eaponce1/Proyecto3_Arquitectura_de_Computadores_Grupo_1/docs/informe_proyecto3/figuras/etapa5_pinout_util50.pdf

# Terminales del macro ASIC — ROM+RAM, FP_CORE_UTIL=50

Coordenadas extraídas de 25-openroad-ioplacement/asic_top.def; origen físico abajo a la izquierda.

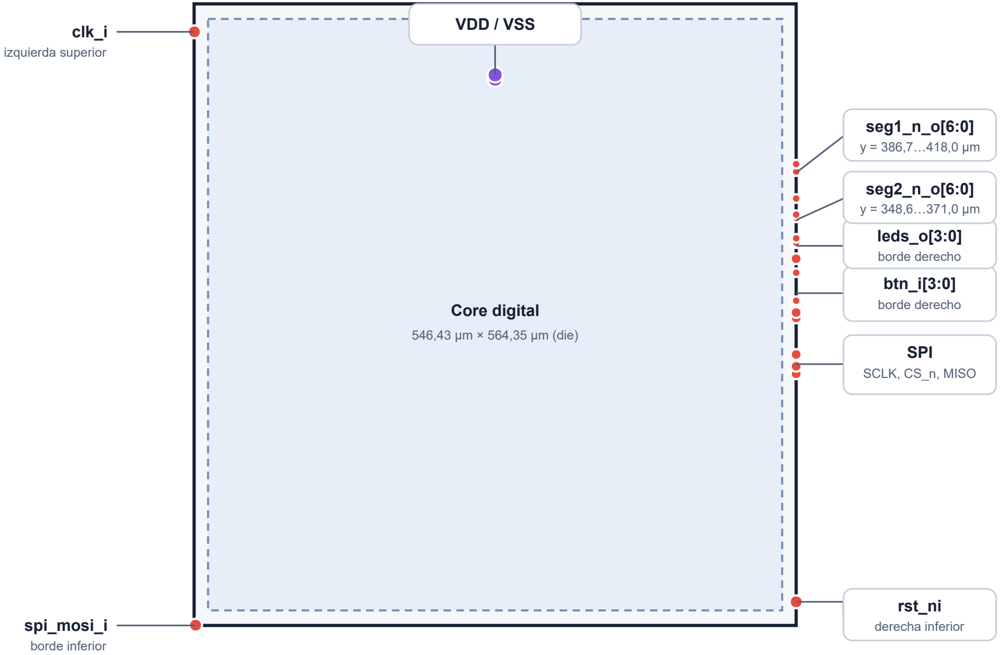
[picture p1: figure]
Core digital; 546,43 µm × 564,35 µm (die); clk_i; izquierda superior; spi_mosi_i; borde inferior; rst_ni; derecha inferior; SPI; SCLK, CS_n, MISO; btn_i[3:0]; borde derecho; leds_o[3:0]; seg2_n_o[6:0]; seg1_n_o[6:0]; VDD / VSS

Los grupos indican rangos reales del DEF; los segmentos individuales están muy próximos y se resumen para legibilidad.
