eaponce1/Proyecto3_Arquitectura_de_Computadores_Grupo_1/docs/informe_proyecto3/figuras/etapa6_layout_trazabilidad.pdf

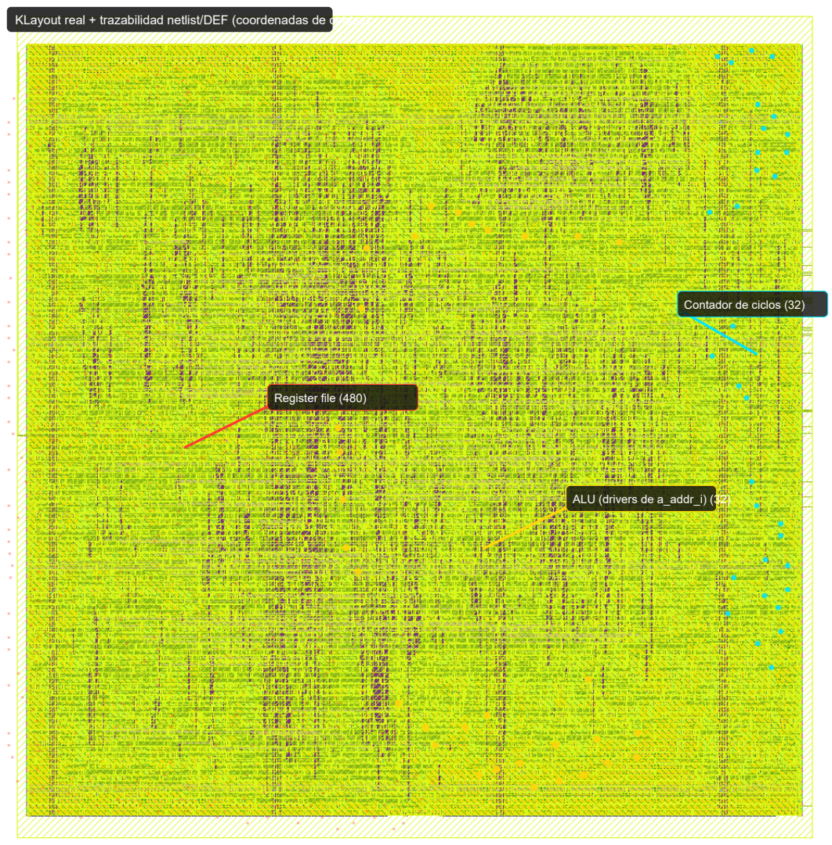
[picture p2: page 1]
Register file (480)

KLayout real + trazabilidad netlist/DEF (coordenadas de celdas)

Contador de ciclos (32)

ALU (drivers de a_addr_i) (32)
