eaponce1/Proyecto3_Arquitectura_de_Computadores_Grupo_1/reports/stage16/slew_by_net.csv

net | violations | corners | worst_slew_ns | limit_ns | worst_slack_ns | pins | cells | drivers | classification
eco_buffer_48_net | 4 | max_ss_125C_4v50,nom_ss_125C_4v50 | 3.435396 | 3.0 | -0.435396 | _7165_/ZN,eco_buffer_48/I | gf180mcu_fd_sc_mcu7t5v0__aoi221_1,gf180mcu_fd_sc_mcu7t5v0__buf_4 | _7165_/ZN (gf180mcu_fd_sc_mcu7t5v0__aoi221_1) | instruction/ROM
