eaponce1/Proyecto3_Arquitectura_de_Computadores_Grupo_1/reports/stage13/etapa13_rom_ram_cts_retry/corners.csv

corner | setup_ws_ns | setup_wns_ns | setup_tns_ns | hold_ws_ns | hold_wns_ns | hold_tns_ns | slew_report_count | slew_metric_count | slew_worst_value | slew_worst_slack | fanout_report_count | fanout_metric_count | fanout_worst_value | fanout_worst_slack | capacitance_report_count | capacitance_metric_count | capacitance_worst_value | capacitance_worst_slack
max_ff_n40C_5v50 | 74.98970190399923 | 0 | 0 | 0.010418333157733054 | 0 | 0 | 0 | 0 |  | 0 | 0 | 0 |  | 0 | 1 | 1 | 0.201071 | -0.001071
max_ss_125C_4v50 | 52.43060534134973 | 0 | 0 | 0.6534697412591861 | 0 | 0 | 468 | 468 | 5.536282 | -2.536282 | 0 | 0 |  | 0 | 1 | 1 | 0.20108 | -0.00108
max_tt_025C_5v00 | 72.35749626493208 | 0 | 0 | 0.20193269850038842 | 0 | 0 | 21 | 21 | 3.263622 | -0.263622 | 0 | 0 |  | 0 | 1 | 1 | 0.200954 | -0.000954
min_ff_n40C_5v50 | 75.16033874681796 | 0 | 0 | 0.029191538901272192 | 0 | 0 | 0 | 0 |  | 0 | 0 | 0 |  | 0 | 0 | 0 |  | 0
min_ss_125C_4v50 | 56.26053027139736 | 0 | 0 | 0.6558016537660598 | 0 | 0 | 165 | 165 | 4.514771 | -1.514771 | 0 | 0 |  | 0 | 0 | 0 |  | 0
min_tt_025C_5v00 | 72.61167872498432 | 0 | 0 | 0.21586222309510425 | 0 | 0 | 0 | 0 |  | 0 | 0 | 0 |  | 0 | 0 | 0 |  | 0
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
