eaponce1/Proyecto3_Arquitectura_de_Computadores_Grupo_1/reports/stage25/unified_ff_frequency_sweep.csv

period_ns | frequency_mhz | setup_wns_ns | setup_tns_ns | hold_wns_ns | hold_tns_ns | status | area_stdcell_um2 | die_area_um2 | utilization_pct | slew_violations | cap_violations | fanout_violations | run_tag | notes
100 | 10.000 | 23.7474047148 | 0 | 0.1717245283 | 0 | pass | 730205 |  | 51.6617 | 9734 | 949 | 350 | etapa4_unified_ff_100ns_100 | historical completed run
80 | 12.500 | 16.789962 | 0 | 0.139166 | 0 | pass | 724673 | 1468100 | 51.3187 | 10758 | 730 | 355 | etapa25_unified_ff_80ns | post-route STA nine corners
70 | 14.285714 | 6.789961 | 0 | 0.139166 | 0 | pass | 724673 | 1468100 | 51.3187 | 10758 | 730 | 355 | etapa25_unified_ff_70ns | post-route STA nine corners
65 | 15.384615 | 1.789957 | 0 | 0.139166 | 0 | pass | 724673 | 1468100 | 51.3187 | 10758 | 730 | 355 | etapa25_unified_ff_65ns | post-route STA nine corners
64 | 15.625 | 0.789960 | 0 | 0.139166 | 0 | pass | 724673 | 1468100 | 51.3187 | 10758 | 730 | 355 | etapa25_unified_ff_64ns | smallest demonstrated passing period in sweep
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
