eaponce1/Proyecto3_Arquitectura_de_Computadores_Grupo_1/reports/stage10/electrical_partitioned.csv

type | net | count | worst_value | limit | worst_slack | drivers | classification | sample_pin | roots
slew | net397 | 12 | 6.058903 | 3.0 | -3.058903 | fanout397/Z:gf180mcu_fd_sc_mcu7t5v0__dlyb_1 | instruction/ROM/fetch | _5614_/A2 | \u_pochoco_soc.genblk1.g_rom_ram_memory.u_ram.a_rdata_o[15];\u_pochoco_soc.genblk1.g_rom_ram_memory.u_ram.a_rdata_o[16];\u_pochoco_soc.genblk1.g_rom_ram_memory.u_ram.a_rdata_o[17];\u_pochoco_soc.genblk1.g_rom_ram_memory.u_ram.a_rdata_o[18]
slew | net426 | 11 | 6.298467 | 3.0 | -3.298467 | fanout426/Z:gf180mcu_fd_sc_mcu7t5v0__dlyb_1 | instruction/ROM/fetch | _5200_/B1 | \u_pochoco_soc.genblk1.g_rom_ram_memory.u_ram.a_rdata_o[20];\u_pochoco_soc.genblk1.g_rom_ram_memory.u_ram.a_rdata_o[21];\u_pochoco_soc.genblk1.g_rom_ram_memory.u_ram.a_rdata_o[22];\u_pochoco_soc.genblk1.g_rom_ram_memory.u_ram.a_rdata_o[23]
slew | net481 | 11 | 6.01881 | 3.0 | -3.01881 | fanout481/Z:gf180mcu_fd_sc_mcu7t5v0__dlyb_1 | instruction/ROM/fetch | _5546_/B1 | \u_pochoco_soc.genblk1.g_rom_ram_memory.u_ram.a_rdata_o[15];\u_pochoco_soc.genblk1.g_rom_ram_memory.u_ram.a_rdata_o[16];\u_pochoco_soc.genblk1.g_rom_ram_memory.u_ram.a_rdata_o[17];\u_pochoco_soc.genblk1.g_rom_ram_memory.u_ram.a_rdata_o[18]
slew | net401 | 11 | 5.959739 | 3.0 | -2.959739 | fanout401/Z:gf180mcu_fd_sc_mcu7t5v0__dlyb_1 | instruction/ROM/fetch | _5302_/A2 | \u_pochoco_soc.genblk1.g_rom_ram_memory.u_ram.a_rdata_o[15];\u_pochoco_soc.genblk1.g_rom_ram_memory.u_ram.a_rdata_o[16];\u_pochoco_soc.genblk1.g_rom_ram_memory.u_ram.a_rdata_o[17];\u_pochoco_soc.genblk1.g_rom_ram_memory.u_ram.a_rdata_o[18]
slew | net376 | 11 | 5.943812 | 3.0 | -2.943812 | fanout376/Z:gf180mcu_fd_sc_mcu7t5v0__dlyb_1 | instruction/ROM/fetch | _5446_/B1 | \u_pochoco_soc.genblk1.g_rom_ram_memory.u_ram.a_rdata_o[15];\u_pochoco_soc.genblk1.g_rom_ram_memory.u_ram.a_rdata_o[16];\u_pochoco_soc.genblk1.g_rom_ram_memory.u_ram.a_rdata_o[17];\u_pochoco_soc.genblk1.g_rom_ram_memory.u_ram.a_rdata_o[18]
slew | net429 | 11 | 5.890739 | 3.0 | -2.890739 | fanout429/Z:gf180mcu_fd_sc_mcu7t5v0__dlyb_1 | instruction/ROM/fetch | _5171_/C1 | \u_pochoco_soc.genblk1.g_rom_ram_memory.u_ram.a_rdata_o[20];\u_pochoco_soc.genblk1.g_rom_ram_memory.u_ram.a_rdata_o[21];\u_pochoco_soc.genblk1.g_rom_ram_memory.u_ram.a_rdata_o[22];\u_pochoco_soc.genblk1.g_rom_ram_memory.u_ram.a_rdata_o[23]
slew | net408 | 11 | 5.781785 | 3.0 | -2.781785 | fanout408/Z:gf180mcu_fd_sc_mcu7t5v0__dlyb_1 | instruction/ROM/fetch | _5168_/A2 | \u_pochoco_soc.genblk1.g_rom_ram_memory.u_ram.a_rdata_o[20];\u_pochoco_soc.genblk1.g_rom_ram_memory.u_ram.a_rdata_o[21];\u_pochoco_soc.genblk1.g_rom_ram_memory.u_ram.a_rdata_o[22];\u_pochoco_soc.genblk1.g_rom_ram_memory.u_ram.a_rdata_o[23]
slew | net493 | 11 | 5.773583 | 3.0 | -2.773583 | fanout493/Z:gf180mcu_fd_sc_mcu7t5v0__dlyb_1 | instruction/ROM/fetch | _5172_/A2 | \u_pochoco_soc.genblk1.g_rom_ram_memory.u_ram.a_rdata_o[20];\u_pochoco_soc.genblk1.g_rom_ram_memory.u_ram.a_rdata_o[21];\u_pochoco_soc.genblk1.g_rom_ram_memory.u_ram.a_rdata_o[22];\u_pochoco_soc.genblk1.g_rom_ram_memory.u_ram.a_rdata_o[23]
slew | net498 | 11 | 5.737949 | 3.0 | -2.737949 | fanout498/Z:gf180mcu_fd_sc_mcu7t5v0__dlyb_1 | instruction/ROM/fetch | _4929_/B1 | \u_pochoco_soc.genblk1.g_rom_ram_memory.u_ram.a_rdata_o[20];\u_pochoco_soc.genblk1.g_rom_ram_memory.u_ram.a_rdata_o[21];\u_pochoco_soc.genblk1.g_rom_ram_memory.u_ram.a_rdata_o[22];\u_pochoco_soc.genblk1.g_rom_ram_memory.u_ram.a_rdata_o[23]
slew | net389 | 11 | 5.654555 | 3.0 | -2.654555 | fanout389/Z:gf180mcu_fd_sc_mcu7t5v0__dlyb_1 | instruction/ROM/fetch | _5623_/A2 | \u_pochoco_soc.genblk1.g_rom_ram_memory.u_ram.a_rdata_o[15];\u_pochoco_soc.genblk1.g_rom_ram_memory.u_ram.a_rdata_o[16];\u_pochoco_soc.genblk1.g_rom_ram_memory.u_ram.a_rdata_o[17];\u_pochoco_soc.genblk1.g_rom_ram_memory.u_ram.a_rdata_o[18]
slew | net392 | 11 | 5.641059 | 3.0 | -2.641059 | fanout392/Z:gf180mcu_fd_sc_mcu7t5v0__dlyb_1 | instruction/ROM/fetch | _5549_/A2 | \u_pochoco_soc.genblk1.g_rom_ram_memory.u_ram.a_rdata_o[15];\u_pochoco_soc.genblk1.g_rom_ram_memory.u_ram.a_rdata_o[16];\u_pochoco_soc.genblk1.g_rom_ram_memory.u_ram.a_rdata_o[17];\u_pochoco_soc.genblk1.g_rom_ram_memory.u_ram.a_rdata_o[18]
slew | net434 | 11 | 5.572034 | 3.0 | -2.572034 | fanout434/Z:gf180mcu_fd_sc_mcu7t5v0__dlyb_1 | instruction/ROM/fetch | _5244_/A2 | \u_pochoco_soc.genblk1.g_rom_ram_memory.u_ram.a_rdata_o[20];\u_pochoco_soc.genblk1.g_rom_ram_memory.u_ram.a_rdata_o[21];\u_pochoco_soc.genblk1.g_rom_ram_memory.u_ram.a_rdata_o[22];\u_pochoco_soc.genblk1.g_rom_ram_memory.u_ram.a_rdata_o[23]
slew | net486 | 11 | 5.494091 | 3.0 | -2.494091 | fanout486/Z:gf180mcu_fd_sc_mcu7t5v0__dlyb_1 | instruction/ROM/fetch | _5625_/A2 | \u_pochoco_soc.genblk1.g_rom_ram_memory.u_ram.a_rdata_o[15];\u_pochoco_soc.genblk1.g_rom_ram_memory.u_ram.a_rdata_o[16];\u_pochoco_soc.genblk1.g_rom_ram_memory.u_ram.a_rdata_o[17];\u_pochoco_soc.genblk1.g_rom_ram_memory.u_ram.a_rdata_o[18]
slew | net360 | 11 | 5.335203 | 3.0 | -2.335203 | fanout360/Z:gf180mcu_fd_sc_mcu7t5v0__dlyb_1 | instruction/ROM/fetch | _5544_/B1 | \u_pochoco_soc.genblk1.g_rom_ram_memory.u_ram.a_rdata_o[15];\u_pochoco_soc.genblk1.g_rom_ram_memory.u_ram.a_rdata_o[16];\u_pochoco_soc.genblk1.g_rom_ram_memory.u_ram.a_rdata_o[17];\u_pochoco_soc.genblk1.g_rom_ram_memory.u_ram.a_rdata_o[18]
slew | net441 | 11 | 5.310075 | 3.0 | -2.310075 | fanout441/Z:gf180mcu_fd_sc_mcu7t5v0__dlyb_1 | instruction/ROM/fetch | _5171_/A2 | \u_pochoco_soc.genblk1.g_rom_ram_memory.u_ram.a_rdata_o[20];\u_pochoco_soc.genblk1.g_rom_ram_memory.u_ram.a_rdata_o[21];\u_pochoco_soc.genblk1.g_rom_ram_memory.u_ram.a_rdata_o[22];\u_pochoco_soc.genblk1.g_rom_ram_memory.u_ram.a_rdata_o[23]
slew | net373 | 11 | 5.30581 | 3.0 | -2.305811 | fanout373/Z:gf180mcu_fd_sc_mcu7t5v0__dlyb_1 | instruction/ROM/fetch | _5303_/B1 | \u_pochoco_soc.genblk1.g_rom_ram_memory.u_ram.a_rdata_o[15];\u_pochoco_soc.genblk1.g_rom_ram_memory.u_ram.a_rdata_o[16];\u_pochoco_soc.genblk1.g_rom_ram_memory.u_ram.a_rdata_o[17];\u_pochoco_soc.genblk1.g_rom_ram_memory.u_ram.a_rdata_o[18]
slew | net384 | 11 | 5.259892 | 3.0 | -2.259892 | fanout384/Z:gf180mcu_fd_sc_mcu7t5v0__dlyb_1 | instruction/ROM/fetch | _5543_/A2 | \u_pochoco_soc.genblk1.g_rom_ram_memory.u_ram.a_rdata_o[15];\u_pochoco_soc.genblk1.g_rom_ram_memory.u_ram.a_rdata_o[16];\u_pochoco_soc.genblk1.g_rom_ram_memory.u_ram.a_rdata_o[17];\u_pochoco_soc.genblk1.g_rom_ram_memory.u_ram.a_rdata_o[18]
slew | net415 | 11 | 5.252581 | 3.0 | -2.252581 | fanout415/Z:gf180mcu_fd_sc_mcu7t5v0__dlyb_1 | instruction/ROM/fetch | _5133_/B1 | \u_pochoco_soc.genblk1.g_rom_ram_memory.u_ram.a_rdata_o[20];\u_pochoco_soc.genblk1.g_rom_ram_memory.u_ram.a_rdata_o[21];\u_pochoco_soc.genblk1.g_rom_ram_memory.u_ram.a_rdata_o[22];\u_pochoco_soc.genblk1.g_rom_ram_memory.u_ram.a_rdata_o[23]
slew | net405 | 11 | 5.194602 | 3.0 | -2.194602 | fanout405/Z:gf180mcu_fd_sc_mcu7t5v0__dlyb_1 | instruction/ROM/fetch | _5309_/A1 | \u_pochoco_soc.genblk1.g_rom_ram_memory.u_ram.a_rdata_o[16];\u_pochoco_soc.genblk1.g_rom_ram_memory.u_ram.a_rdata_o[17];\u_pochoco_soc.genblk1.g_rom_ram_memory.u_ram.a_rdata_o[18]
slew | net450 | 11 | 5.092862 | 3.0 | -2.092862 | fanout450/Z:gf180mcu_fd_sc_mcu7t5v0__dlyb_1 | instruction/ROM/fetch | _4923_/A2 | \u_pochoco_soc.genblk1.g_rom_ram_memory.u_ram.a_rdata_o[20];\u_pochoco_soc.genblk1.g_rom_ram_memory.u_ram.a_rdata_o[21];\u_pochoco_soc.genblk1.g_rom_ram_memory.u_ram.a_rdata_o[22];\u_pochoco_soc.genblk1.g_rom_ram_memory.u_ram.a_rdata_o[23]
slew | net428 | 11 | 5.081461 | 3.0 | -2.081461 | fanout428/Z:gf180mcu_fd_sc_mcu7t5v0__dlyb_1 | instruction/ROM/fetch | _5138_/B1 | \u_pochoco_soc.genblk1.g_rom_ram_memory.u_ram.a_rdata_o[20];\u_pochoco_soc.genblk1.g_rom_ram_memory.u_ram.a_rdata_o[21];\u_pochoco_soc.genblk1.g_rom_ram_memory.u_ram.a_rdata_o[22];\u_pochoco_soc.genblk1.g_rom_ram_memory.u_ram.a_rdata_o[23]
slew | net332 | 11 | 5.07205 | 3.0 | -2.07205 | fanout332/Z:gf180mcu_fd_sc_mcu7t5v0__dlyb_1 | instruction/ROM/fetch | _7645_/A1 | \u_pochoco_soc.genblk1.g_rom_ram_memory.u_ram.a_rdata_o[0];\u_pochoco_soc.genblk1.g_rom_ram_memory.u_ram.a_rdata_o[2];\u_pochoco_soc.genblk1.g_rom_ram_memory.u_ram.a_rdata_o[3];\u_pochoco_soc.genblk1.g_rom_ram_memory.u_ram.a_rdata_o[4];\u_pochoco_soc.genblk1.g_rom_ram_memory.u_ram.a_rdata_o[5];\u_pochoco_soc.genblk1.g_rom_ram_memory.u_ram.a_rdata_o[6]
slew | net388 | 11 | 5.053224 | 3.0 | -2.053224 | fanout388/Z:gf180mcu_fd_sc_mcu7t5v0__dlyb_1 | instruction/ROM/fetch | _5555_/A2 | \u_pochoco_soc.genblk1.g_rom_ram_memory.u_ram.a_rdata_o[15];\u_pochoco_soc.genblk1.g_rom_ram_memory.u_ram.a_rdata_o[16];\u_pochoco_soc.genblk1.g_rom_ram_memory.u_ram.a_rdata_o[17];\u_pochoco_soc.genblk1.g_rom_ram_memory.u_ram.a_rdata_o[18]
slew | net445 | 11 | 5.037819 | 3.0 | -2.037819 | fanout445/Z:gf180mcu_fd_sc_mcu7t5v0__dlyb_1 | instruction/ROM/fetch | _5247_/A2 | \u_pochoco_soc.genblk1.g_rom_ram_memory.u_ram.a_rdata_o[20];\u_pochoco_soc.genblk1.g_rom_ram_memory.u_ram.a_rdata_o[21];\u_pochoco_soc.genblk1.g_rom_ram_memory.u_ram.a_rdata_o[22];\u_pochoco_soc.genblk1.g_rom_ram_memory.u_ram.a_rdata_o[23]
slew | net557 | 11 | 5.034837 | 3.0 | -2.034837 | fanout557/Z:gf180mcu_fd_sc_mcu7t5v0__dlyb_1 | instruction/ROM/fetch | fanout555/I | \u_pochoco_soc.genblk1.g_rom_ram_memory.u_ram.a_rdata_o[31]
slew | net436 | 11 | 5.018599 | 3.0 | -2.018599 | fanout436/Z:gf180mcu_fd_sc_mcu7t5v0__dlyb_1 | instruction/ROM/fetch | _5023_/B1 | \u_pochoco_soc.genblk1.g_rom_ram_memory.u_ram.a_rdata_o[20];\u_pochoco_soc.genblk1.g_rom_ram_memory.u_ram.a_rdata_o[21];\u_pochoco_soc.genblk1.g_rom_ram_memory.u_ram.a_rdata_o[22];\u_pochoco_soc.genblk1.g_rom_ram_memory.u_ram.a_rdata_o[23]
slew | net560 | 11 | 5.008434 | 3.0 | -2.008434 | fanout560/Z:gf180mcu_fd_sc_mcu7t5v0__dlyb_1 | instruction/ROM/fetch | _5198_/A1 | \u_pochoco_soc.genblk1.g_rom_ram_memory.u_ram.a_rdata_o[20]
slew | net251 | 11 | 4.999881 | 3.0 | -1.999881 | _6963_/S:gf180mcu_fd_sc_mcu7t5v0__mux2_2;_6970_/S:gf180mcu_fd_sc_mcu7t5v0__mux2_2;_6973_/S:gf180mcu_fd_sc_mcu7t5v0__mux2_2;_7202_/S:gf180mcu_fd_sc_mcu7t5v0__mux2_2;fanout251/Z:gf180mcu_fd_sc_mcu7t5v0__dlyb_1 | instruction/ROM/fetch+data-memory+peripheral | _6963_/S | \u_pochoco_soc.data_wdata[0];\u_pochoco_soc.data_wdata[1];\u_pochoco_soc.data_wdata[2];\u_pochoco_soc.data_wdata[3];\u_pochoco_soc.data_wdata[4];\u_pochoco_soc.data_wdata[5];\u_pochoco_soc.data_wdata[6];\u_pochoco_soc.data_wdata[7];\u_pochoco_soc.genblk1.g_rom_ram_memory.u_ram.a_addr_i[1];\u_pochoco_soc.genblk1.g_rom_ram_memory.u_ram.a_rdata_o[0];\u_pochoco_soc.genblk1.g_rom_ram_memory.u_ram.a_rdata_o[10];\u_pochoco_soc.genblk1.g_rom_ram_memory.u_ram.a_rdata_o[11];\u_pochoco_soc.genblk1.g_rom_ram_memory.u_ram.a_rdata_o[12];\u_pochoco_soc.genblk1.g_rom_ram_memory.u_ram.a_rdata_o[13];\u_pochoco_soc.genblk1.g_rom_ram_memory.u_ram.a_rdata_o[14];\u_pochoco_soc.genblk1.g_rom_ram_memory.u_ram.a_rdata_o[19];\u_pochoco_soc.genblk1.g_rom_ram_memory.u_ram.a_rdata_o[20];\u_pochoco_soc.genblk1.g_rom_ram_memory.u_ram.a_rdata_o[21];\u_pochoco_soc.genblk1.g_rom_ram_memory.u_ram.a_rdata_o[22];\u_pochoco_soc.genblk1.g_rom_ram_memory.u_ram.a_rdata_o[23];\u_pochoco_soc.genblk1.g_rom_ram_memory.u_ram.a_rdata_o[24];\u_pochoco_soc.genblk1.g_rom_ram_memory.u_ram.a_rdata_o[25];\u_pochoco_soc.genblk1.g_rom_ram_memory.u_ram.a_rdata_o[26];\u_pochoco_soc.genblk1.g_rom_ram_memory.u_ram.a_rdata_o[27];\u_pochoco_soc.genblk1.g_rom_ram_memory.u_ram.a_rdata_o[28];\u_pochoco_soc.genblk1.g_rom_ram_memory.u_ram.a_rdata_o[29];\u_pochoco_soc.genblk1.g_rom_ram_memory.u_ram.a_rdata_o[2];\u_pochoco_soc.genblk1.g_rom_ram_memory.u_ram.a_rdata_o[30];\u_pochoco_soc.genblk1.g_rom_ram_memory.u_ram.a_rdata_o[31];\u_pochoco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
slew | net375 | 11 | 4.994989 | 3.0 | -1.994989 | fanout375/Z:gf180mcu_fd_sc_mcu7t5v0__dlyb_1 | instruction/ROM/fetch | _5513_/A2 | \u_pochoco_soc.genblk1.g_rom_ram_memory.u_ram.a_rdata_o[15];\u_pochoco_soc.genblk1.g_rom_ram_memory.u_ram.a_rdata_o[16];\u_pochoco_soc.genblk1.g_rom_ram_memory.u_ram.a_rdata_o[17];\u_pochoco_soc.genblk1.g_rom_ram_memory.u_ram.a_rdata_o[18]
slew | net425 | 11 | 4.98935 | 3.0 | -1.989351 | fanout425/Z:gf180mcu_fd_sc_mcu7t5v0__dlyb_1 | instruction/ROM/fetch | _4930_/B1 | \u_pochoco_soc.genblk1.g_rom_ram_memory.u_ram.a_rdata_o[20];\u_pochoco_soc.genblk1.g_rom_ram_memory.u_ram.a_rdata_o[21];\u_pochoco_soc.genblk1.g_rom_ram_memory.u_ram.a_rdata_o[22];\u_pochoco_soc.genblk1.g_rom_ram_memory.u_ram.a_rdata_o[23]
slew | net170 | 11 | 4.964843 | 3.0 | -1.964844 | _7029_/S:gf180mcu_fd_sc_mcu7t5v0__mux2_2;_7036_/S:gf180mcu_fd_sc_mcu7t5v0__mux2_2;_7039_/S:gf180mcu_fd_sc_mcu7t5v0__mux2_2;_7247_/S:gf180mcu_fd_sc_mcu7t5v0__mux2_2;fanout170/Z:gf180mcu_fd_sc_mcu7t5v0__dlyb_1 | instruction/ROM/fetch+data-memory+peripheral | _7030_/A2 | \u_pochoco_soc.data_wdata[0];\u_pochoco_soc.data_wdata[1];\u_pochoco_soc.data_wdata[2];\u_pochoco_soc.data_wdata[3];\u_pochoco_soc.data_wdata[4];\u_pochoco_soc.data_wdata[5];\u_pochoco_soc.data_wdata[6];\u_pochoco_soc.data_wdata[7];\u_pochoco_soc.genblk1.g_rom_ram_memory.u_ram.a_addr_i[1];\u_pochoco_soc.genblk1.g_rom_ram_memory.u_ram.a_rdata_o[0];\u_pochoco_soc.genblk1.g_rom_ram_memory.u_ram.a_rdata_o[10];\u_pochoco_soc.genblk1.g_rom_ram_memory.u_ram.a_rdata_o[11];\u_pochoco_soc.genblk1.g_rom_ram_memory.u_ram.a_rdata_o[12];\u_pochoco_soc.genblk1.g_rom_ram_memory.u_ram.a_rdata_o[13];\u_pochoco_soc.genblk1.g_rom_ram_memory.u_ram.a_rdata_o[14];\u_pochoco_soc.genblk1.g_rom_ram_memory.u_ram.a_rdata_o[19];\u_pochoco_soc.genblk1.g_rom_ram_memory.u_ram.a_rdata_o[20];\u_pochoco_soc.genblk1.g_rom_ram_memory.u_ram.a_rdata_o[21];\u_pochoco_soc.genblk1.g_rom_ram_memory.u_ram.a_rdata_o[22];\u_pochoco_soc.genblk1.g_rom_ram_memory.u_ram.a_rdata_o[23];\u_pochoco_soc.genblk1.g_rom_ram_memory.u_ram.a_rdata_o[24];\u_pochoco_soc.genblk1.g_rom_ram_memory.u_ram.a_rdata_o[25];\u_pochoco_soc.genblk1.g_rom_ram_memory.u_ram.a_rdata_o[26];\u_pochoco_soc.genblk1.g_rom_ram_memory.u_ram.a_rdata_o[27];\u_pochoco_soc.genblk1.g_rom_ram_memory.u_ram.a_rdata_o[28];\u_pochoco_soc.genblk1.g_rom_ram_memory.u_ram.a_rdata_o[29];\u_pochoco_soc.genblk1.g_rom_ram_memory.u_ram.a_rdata_o[2];\u_pochoco_soc.genblk1.g_rom_ram_memory.u_ram.a_rdata_o[30];\u_pochoco_soc.genblk1.g_rom_ram_memory.u_ram.a_rdata_o[31];\u_pochoco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
slew | net411 | 11 | 4.953527 | 3.0 | -1.953528 | fanout411/Z:gf180mcu_fd_sc_mcu7t5v0__dlyb_1 | instruction/ROM/fetch | _5139_/A2 | \u_pochoco_soc.genblk1.g_rom_ram_memory.u_ram.a_rdata_o[20];\u_pochoco_soc.genblk1.g_rom_ram_memory.u_ram.a_rdata_o[21];\u_pochoco_soc.genblk1.g_rom_ram_memory.u_ram.a_rdata_o[22];\u_pochoco_soc.genblk1.g_rom_ram_memory.u_ram.a_rdata_o[23]
slew | net381 | 11 | 4.952581 | 3.0 | -1.952581 | fanout381/Z:gf180mcu_fd_sc_mcu7t5v0__dlyb_1 | instruction/ROM/fetch | _5620_/A2 | \u_pochoco_soc.genblk1.g_rom_ram_memory.u_ram.a_rdata_o[15];\u_pochoco_soc.genblk1.g_rom_ram_memory.u_ram.a_rdata_o[16];\u_pochoco_soc.genblk1.g_rom_ram_memory.u_ram.a_rdata_o[17];\u_pochoco_soc.genblk1.g_rom_ram_memory.u_ram.a_rdata_o[18]
slew | net444 | 11 | 4.927774 | 3.0 | -1.927774 | fanout444/Z:gf180mcu_fd_sc_mcu7t5v0__dlyb_1 | instruction/ROM/fetch | _5140_/A2 | \u_pochoco_soc.genblk1.g_rom_ram_memory.u_ram.a_rdata_o[20];\u_pochoco_soc.genblk1.g_rom_ram_memory.u_ram.a_rdata_o[21];\u_pochoco_soc.genblk1.g_rom_ram_memory.u_ram.a_rdata_o[22];\u_pochoco_soc.genblk1.g_rom_ram_memory.u_ram.a_rdata_o[23]
slew | net399 | 11 | 4.885796 | 3.0 | -1.885796 | fanout399/Z:gf180mcu_fd_sc_mcu7t5v0__dlyb_1 | instruction/ROM/fetch | _5438_/A2 | \u_pochoco_soc.genblk1.g_rom_ram_memory.u_ram.a_rdata_o[15];\u_pochoco_soc.genblk1.g_rom_ram_memory.u_ram.a_rdata_o[16];\u_pochoco_soc.genblk1.g_rom_ram_memory.u_ram.a_rdata_o[17];\u_pochoco_soc.genblk1.g_rom_ram_memory.u_ram.a_rdata_o[18]
slew | net440 | 11 | 4.872573 | 3.0 | -1.872573 | fanout440/Z:gf180mcu_fd_sc_mcu7t5v0__dlyb_1 | instruction/ROM/fetch | _5138_/A2 | \u_pochoco_soc.genblk1.g_rom_ram_memory.u_ram.a_rdata_o[20];\u_pochoco_soc.genblk1.g_rom_ram_memory.u_ram.a_rdata_o[21];\u_pochoco_soc.genblk1.g_rom_ram_memory.u_ram.a_rdata_o[22];\u_pochoco_soc.genblk1.g_rom_ram_memory.u_ram.a_rdata_o[23]
slew | net501 | 11 | 4.868766 | 3.0 | -1.868767 | fanout501/Z:gf180mcu_fd_sc_mcu7t5v0__dlyb_1 | instruction/ROM/fetch | _5201_/A2 | \u_pochoco_soc.genblk1.g_rom_ram_memory.u_ram.a_rdata_o[20];\u_pochoco_soc.genblk1.g_rom_ram_memory.u_ram.a_rdata_o[21];\u_pochoco_soc.genblk1.g_rom_ram_memory.u_ram.a_rdata_o[22];\u_pochoco_soc.genblk1.g_rom_ram_memory.u_ram.a_rdata_o[23]
slew | net420 | 11 | 4.85049 | 3.0 | -1.85049 | fanout420/Z:gf180mcu_fd_sc_mcu7t5v0__dlyb_1 | instruction/ROM/fetch | _5059_/A2 | \u_pochoco_soc.genblk1.g_rom_ram_memory.u_ram.a_rdata_o[20];\u_pochoco_soc.genblk1.g_rom_ram_memory.u_ram.a_rdata_o[21];\u_pochoco_soc.genblk1.g_rom_ram_memory.u_ram.a_rdata_o[22];\u_pochoco_soc.genblk1.g_rom_ram_memory.u_ram.a_rdata_o[23]
slew | net363 | 11 | 4.845622 | 3.0 | -1.845621 | fanout363/Z:gf180mcu_fd_sc_mcu7t5v0__dlyb_1 | instruction/ROM/fetch | _5527_/B1 | \u_pochoco_soc.genblk1.g_rom_ram_memory.u_ram.a_rdata_o[15];\u_pochoco_soc.genblk1.g_rom_ram_memory.u_ram.a_rdata_o[16];\u_pochoco_soc.genblk1.g_rom_ram_memory.u_ram.a_rdata_o[17];\u_pochoco_soc.genblk1.g_rom_ram_memory.u_ram.a_rdata_o[18]
slew | net485 | 11 | 4.839981 | 3.0 | -1.839981 | fanout485/Z:gf180mcu_fd_sc_mcu7t5v0__dlyb_1 | instruction/ROM/fetch | _5579_/A2 | \u_pochoco_soc.genblk1.g_rom_ram_memory.u_ram.a_rdata_o[15];\u_pochoco_soc.genblk1.g_rom_ram_memory.u_ram.a_rdata_o[16];\u_pochoco_soc.genblk1.g_rom_ram_memory.u_ram.a_rdata_o[17];\u_pochoco_soc.genblk1.g_rom_ram_memory.u_ram.a_rdata_o[18]
slew | net565 | 11 | 4.839776 | 3.0 | -1.839776 | fanout565/Z:gf180mcu_fd_sc_mcu7t5v0__dlyb_1 | instruction/ROM/fetch | _5541_/A1 | \u_pochoco_soc.genblk1.g_rom_ram_memory.u_ram.a_rdata_o[15]
slew | net422 | 11 | 4.830451 | 3.0 | -1.830451 | fanout422/Z:gf180mcu_fd_sc_mcu7t5v0__dlyb_1 | instruction/ROM/fetch | _4928_/B1 | \u_pochoco_soc.genblk1.g_rom_ram_memory.u_ram.a_rdata_o[20];\u_pochoco_soc.genblk1.g_rom_ram_memory.u_ram.a_rdata_o[21];\u_pochoco_soc.genblk1.g_rom_ram_memory.u_ram.a_rdata_o[22];\u_pochoco_soc.genblk1.g_rom_ram_memory.u_ram.a_rdata_o[23]
slew | net449 | 11 | 4.823497 | 3.0 | -1.823497 | fanout449/Z:gf180mcu_fd_sc_mcu7t5v0__dlyb_1 | instruction/ROM/fetch | _5250_/A2 | \u_pochoco_soc.genblk1.g_rom_ram_memory.u_ram.a_rdata_o[20];\u_pochoco_soc.genblk1.g_rom_ram_memory.u_ram.a_rdata_o[21];\u_pochoco_soc.genblk1.g_rom_ram_memory.u_ram.a_rdata_o[22];\u_pochoco_soc.genblk1.g_rom_ram_memory.u_ram.a_rdata_o[23]
slew | net391 | 11 | 4.818822 | 3.0 | -1.818823 | fanout391/Z:gf180mcu_fd_sc_mcu7t5v0__dlyb_1 | instruction/ROM/fetch | _5516_/B1 | \u_pochoco_soc.genblk1.g_rom_ram_memory.u_ram.a_rdata_o[15];\u_pochoco_soc.genblk1.g_rom_ram_memory.u_ram.a_rdata_o[16];\u_pochoco_soc.genblk1.g_rom_ram_memory.u_ram.a_rdata_o[17];\u_pochoco_soc.genblk1.g_rom_ram_memory.u_ram.a_rdata_o[18]
slew | net400 | 11 | 4.812764 | 3.0 | -1.812764 | fanout400/Z:gf180mcu_fd_sc_mcu7t5v0__dlyb_1 | instruction/ROM/fetch | _5615_/A2 | \u_pochoco_soc.genblk1.g_rom_ram_memory.u_ram.a_rdata_o[15];\u_pochoco_soc.genblk1.g_rom_ram_memory.u_ram.a_rdata_o[16];\u_pochoco_soc.genblk1.g_rom_ram_memory.u_ram.a_rdata_o[17];\u_pochoco_soc.genblk1.g_rom_ram_memory.u_ram.a_rdata_o[18]
slew | net142 | 11 | 4.799314 | 3.0 | -1.799314 | _7281_/S:gf180mcu_fd_sc_mcu7t5v0__mux2_2;_7282_/S:gf180mcu_fd_sc_mcu7t5v0__mux2_2;_7284_/S:gf180mcu_fd_sc_mcu7t5v0__mux2_2;_7287_/S:gf180mcu_fd_sc_mcu7t5v0__mux2_2;fanout142/Z:gf180mcu_fd_sc_mcu7t5v0__dlyb_1 | instruction/ROM/fetch+data-memory+peripheral | _7559_/A1 | \u_pochoco_soc.data_wdata[0];\u_pochoco_soc.data_wdata[1];\u_pochoco_soc.data_wdata[2];\u_pochoco_soc.data_wdata[3];\u_pochoco_soc.data_wdata[4];\u_pochoco_soc.data_wdata[5];\u_pochoco_soc.data_wdata[6];\u_pochoco_soc.data_wdata[7];\u_pochoco_soc.genblk1.g_rom_ram_memory.u_ram.a_addr_i[1];\u_pochoco_soc.genblk1.g_rom_ram_memory.u_ram.a_rdata_o[0];\u_pochoco_soc.genblk1.g_rom_ram_memory.u_ram.a_rdata_o[10];\u_pochoco_soc.genblk1.g_rom_ram_memory.u_ram.a_rdata_o[11];\u_pochoco_soc.genblk1.g_rom_ram_memory.u_ram.a_rdata_o[12];\u_pochoco_soc.genblk1.g_rom_ram_memory.u_ram.a_rdata_o[13];\u_pochoco_soc.genblk1.g_rom_ram_memory.u_ram.a_rdata_o[14];\u_pochoco_soc.genblk1.g_rom_ram_memory.u_ram.a_rdata_o[19];\u_pochoco_soc.genblk1.g_rom_ram_memory.u_ram.a_rdata_o[20];\u_pochoco_soc.genblk1.g_rom_ram_memory.u_ram.a_rdata_o[21];\u_pochoco_soc.genblk1.g_rom_ram_memory.u_ram.a_rdata_o[22];\u_pochoco_soc.genblk1.g_rom_ram_memory.u_ram.a_rdata_o[23];\u_pochoco_soc.genblk1.g_rom_ram_memory.u_ram.a_rdata_o[24];\u_pochoco_soc.genblk1.g_rom_ram_memory.u_ram.a_rdata_o[25];\u_pochoco_soc.genblk1.g_rom_ram_memory.u_ram.a_rdata_o[26];\u_pochoco_soc.genblk1.g_rom_ram_memory.u_ram.a_rdata_o[27];\u_pochoco_soc.genblk1.g_rom_ram_memory.u_ram.a_rdata_o[28];\u_pochoco_soc.genblk1.g_rom_ram_memory.u_ram.a_rdata_o[29];\u_pochoco_soc.genblk1.g_rom_ram_memory.u_ram.a_rdata_o[2];\u_pochoco_soc.genblk1.g_rom_ram_memory.u_ram.a_rdata_o[30];\u_pochoco_soc.genblk1.g_rom_ram_memory.u_ram.a_rdata_o[31];\u_pochoco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
slew | net421 | 11 | 4.788231 | 3.0 | -1.788231 | fanout421/Z:gf180mcu_fd_sc_mcu7t5v0__dlyb_1 | instruction/ROM/fetch | _5244_/B1 | \u_pochoco_soc.genblk1.g_rom_ram_memory.u_ram.a_rdata_o[20];\u_pochoco_soc.genblk1.g_rom_ram_memory.u_ram.a_rdata_o[21];\u_pochoco_soc.genblk1.g_rom_ram_memory.u_ram.a_rdata_o[22];\u_pochoco_soc.genblk1.g_rom_ram_memory.u_ram.a_rdata_o[23]
slew | net368 | 11 | 4.782693 | 3.0 | -1.782694 | fanout368/Z:gf180mcu_fd_sc_mcu7t5v0__dlyb_1 | instruction/ROM/fetch | _5576_/B1 | \u_pochoco_soc.genblk1.g_rom_ram_memory.u_ram.a_rdata_o[15];\u_pochoco_soc.genblk1.g_rom_ram_memory.u_ram.a_rdata_o[16];\u_pochoco_soc.genblk1.g_rom_ram_memory.u_ram.a_rdata_o[17];\u_pochoco_soc.genblk1.g_rom_ram_memory.u_ram.a_rdata_o[18]
slew | net387 | 11 | 4.778865 | 3.0 | -1.778865 | fanout387/Z:gf180mcu_fd_sc_mcu7t5v0__dlyb_1 | instruction/ROM/fetch | _5527_/A2 | \u_pochoco_soc.genblk1.g_rom_ram_memory.u_ram.a_rdata_o[15];\u_pochoco_soc.genblk1.g_rom_ram_memory.u_ram.a_rdata_o[16];\u_pochoco_soc.genblk1.g_rom_ram_memory.u_ram.a_rdata_o[17];\u_pochoco_soc.genblk1.g_rom_ram_memory.u_ram.a_rdata_o[18]
slew | net213 | 11 | 4.777482 | 3.0 | -1.777482 | _7173_/S:gf180mcu_fd_sc_mcu7t5v0__mux2_2;_7174_/S:gf180mcu_fd_sc_mcu7t5v0__mux2_2;_7176_/S:gf180mcu_fd_sc_mcu7t5v0__mux2_2;_7179_/S:gf180mcu_fd_sc_mcu7t5v0__mux2_2;fanout213/Z:gf180mcu_fd_sc_mcu7t5v0__dlyb_1 | instruction/ROM/fetch+data-memory+peripheral | _7371_/A1 | \u_pochoco_soc.data_wdata[0];\u_pochoco_soc.data_wdata[1];\u_pochoco_soc.data_wdata[2];\u_pochoco_soc.data_wdata[3];\u_pochoco_soc.data_wdata[4];\u_pochoco_soc.data_wdata[5];\u_pochoco_soc.data_wdata[6];\u_pochoco_soc.data_wdata[7];\u_pochoco_soc.genblk1.g_rom_ram_memory.u_ram.a_addr_i[1];\u_pochoco_soc.genblk1.g_rom_ram_memory.u_ram.a_rdata_o[0];\u_pochoco_soc.genblk1.g_rom_ram_memory.u_ram.a_rdata_o[10];\u_pochoco_soc.genblk1.g_rom_ram_memory.u_ram.a_rdata_o[11];\u_pochoco_soc.genblk1.g_rom_ram_memory.u_ram.a_rdata_o[12];\u_pochoco_soc.genblk1.g_rom_ram_memory.u_ram.a_rdata_o[13];\u_pochoco_soc.genblk1.g_rom_ram_memory.u_ram.a_rdata_o[14];\u_pochoco_soc.genblk1.g_rom_ram_memory.u_ram.a_rdata_o[19];\u_pochoco_soc.genblk1.g_rom_ram_memory.u_ram.a_rdata_o[20];\u_pochoco_soc.genblk1.g_rom_ram_memory.u_ram.a_rdata_o[21];\u_pochoco_soc.genblk1.g_rom_ram_memory.u_ram.a_rdata_o[22];\u_pochoco_soc.genblk1.g_rom_ram_memory.u_ram.a_rdata_o[23];\u_pochoco_soc.genblk1.g_rom_ram_memory.u_ram.a_rdata_o[24];\u_pochoco_soc.genblk1.g_rom_ram_memory.u_ram.a_rdata_o[25];\u_pochoco_soc.genblk1.g_rom_ram_memory.u_ram.a_rdata_o[26];\u_pochoco_soc.genblk1.g_rom_ram_memory.u_ram.a_rdata_o[27];\u_pochoco_soc.genblk1.g_rom_ram_memory.u_ram.a_rdata_o[28];\u_pochoco_soc.genblk1.g_rom_ram_memory.u_ram.a_rdata_o[29];\u_pochoco_soc.genblk1.g_rom_ram_memory.u_ram.a_rdata_o[2];\u_pochoco_soc.genblk1.g_rom_ram_memory.u_ram.a_rdata_o[30];\u_pochoco_soc.genblk1.g_rom_ram_memory.u_ram.a_rdata_o[31];\u_pochoco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
slew | net448 | 11 | 4.758442 | 3.0 | -1.758442 | fanout448/Z:gf180mcu_fd_sc_mcu7t5v0__dlyb_1 | instruction/ROM/fetch | _5216_/C2 | \u_pochoco_soc.genblk1.g_rom_ram_memory.u_ram.a_rdata_o[20];\u_pochoco_soc.genblk1.g_rom_ram_memory.u_ram.a_rdata_o[21];\u_pochoco_soc.genblk1.g_rom_ram_memory.u_ram.a_rdata_o[22];\u_pochoco_soc.genblk1.g_rom_ram_memory.u_ram.a_rdata_o[23]
slew | net367 | 11 | 4.758348 | 3.0 | -1.758348 | fanout367/Z:gf180mcu_fd_sc_mcu7t5v0__dlyb_1 | instruction/ROM/fetch | _5438_/C2 | \u_pochoco_soc.genblk1.g_rom_ram_memory.u_ram.a_rdata_o[15];\u_pochoco_soc.genblk1.g_rom_ram_memory.u_ram.a_rdata_o[16];\u_pochoco_soc.genblk1.g_rom_ram_memory.u_ram.a_rdata_o[17];\u_pochoco_soc.genblk1.g_rom_ram_memory.u_ram.a_rdata_o[18]
slew | net437 | 11 | 4.738375 | 3.0 | -1.738375 | fanout437/Z:gf180mcu_fd_sc_mcu7t5v0__dlyb_1 | instruction/ROM/fetch | _5183_/B1 | \u_pochoco_soc.genblk1.g_rom_ram_memory.u_ram.a_rdata_o[20];\u_pochoco_soc.genblk1.g_rom_ram_memory.u_ram.a_rdata_o[21];\u_pochoco_soc.genblk1.g_rom_ram_memory.u_ram.a_rdata_o[22];\u_pochoco_soc.genblk1.g_rom_ram_memory.u_ram.a_rdata_o[23]
slew | net371 | 11 | 4.73465 | 3.0 | -1.73465 | fanout371/Z:gf180mcu_fd_sc_mcu7t5v0__dlyb_1 | instruction/ROM/fetch | _5587_/A2 | \u_pochoco_soc.genblk1.g_rom_ram_memory.u_ram.a_rdata_o[15];\u_pochoco_soc.genblk1.g_rom_ram_memory.u_ram.a_rdata_o[16];\u_pochoco_soc.genblk1.g_rom_ram_memory.u_ram.a_rdata_o[17];\u_pochoco_soc.genblk1.g_rom_ram_memory.u_ram.a_rdata_o[18]
slew | net379 | 11 | 4.729074 | 3.0 | -1.729075 | fanout379/Z:gf180mcu_fd_sc_mcu7t5v0__dlyb_1 | instruction/ROM/fetch | _5435_/B1 | \u_pochoco_soc.genblk1.g_rom_ram_memory.u_ram.a_rdata_o[15];\u_pochoco_soc.genblk1.g_rom_ram_memory.u_ram.a_rdata_o[16];\u_pochoco_soc.genblk1.g_rom_ram_memory.u_ram.a_rdata_o[17];\u_pochoco_soc.genblk1.g_rom_ram_memory.u_ram.a_rdata_o[18]
slew | net177 | 11 | 4.716195 | 3.0 | -1.716195 | _7016_/S:gf180mcu_fd_sc_mcu7t5v0__mux2_2;_7023_/S:gf180mcu_fd_sc_mcu7t5v0__mux2_2;_7026_/S:gf180mcu_fd_sc_mcu7t5v0__mux2_2;_7238_/S:gf180mcu_fd_sc_mcu7t5v0__mux2_2;fanout177/Z:gf180mcu_fd_sc_mcu7t5v0__dlyb_1 | instruction/ROM/fetch+data-memory+peripheral | _7016_/S | \u_pochoco_soc.data_wdata[0];\u_pochoco_soc.data_wdata[1];\u_pochoco_soc.data_wdata[2];\u_pochoco_soc.data_wdata[3];\u_pochoco_soc.data_wdata[4];\u_pochoco_soc.data_wdata[5];\u_pochoco_soc.data_wdata[6];\u_pochoco_soc.data_wdata[7];\u_pochoco_soc.genblk1.g_rom_ram_memory.u_ram.a_addr_i[1];\u_pochoco_soc.genblk1.g_rom_ram_memory.u_ram.a_rdata_o[0];\u_pochoco_soc.genblk1.g_rom_ram_memory.u_ram.a_rdata_o[10];\u_pochoco_soc.genblk1.g_rom_ram_memory.u_ram.a_rdata_o[11];\u_pochoco_soc.genblk1.g_rom_ram_memory.u_ram.a_rdata_o[12];\u_pochoco_soc.genblk1.g_rom_ram_memory.u_ram.a_rdata_o[13];\u_pochoco_soc.genblk1.g_rom_ram_memory.u_ram.a_rdata_o[14];\u_pochoco_soc.genblk1.g_rom_ram_memory.u_ram.a_rdata_o[19];\u_pochoco_soc.genblk1.g_rom_ram_memory.u_ram.a_rdata_o[20];\u_pochoco_soc.genblk1.g_rom_ram_memory.u_ram.a_rdata_o[21];\u_pochoco_soc.genblk1.g_rom_ram_memory.u_ram.a_rdata_o[22];\u_pochoco_soc.genblk1.g_rom_ram_memory.u_ram.a_rdata_o[23];\u_pochoco_soc.genblk1.g_rom_ram_memory.u_ram.a_rdata_o[24];\u_pochoco_soc.genblk1.g_rom_ram_memory.u_ram.a_rdata_o[25];\u_pochoco_soc.genblk1.g_rom_ram_memory.u_ram.a_rdata_o[26];\u_pochoco_soc.genblk1.g_rom_ram_memory.u_ram.a_rdata_o[27];\u_pochoco_soc.genblk1.g_rom_ram_memory.u_ram.a_rdata_o[28];\u_pochoco_soc.genblk1.g_rom_ram_memory.u_ram.a_rdata_o[29];\u_pochoco_soc.genblk1.g_rom_ram_memory.u_ram.a_rdata_o[2];\u_pochoco_soc.genblk1.g_rom_ram_memory.u_ram.a_rdata_o[30];\u_pochoco_soc.genblk1.g_rom_ram_memory.u_ram.a_rdata_o[31];\u_pochoco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
slew | net162 | 11 | 4.71422 | 3.0 | -1.714219 | _7042_/S:gf180mcu_fd_sc_mcu7t5v0__mux2_2;_7049_/S:gf180mcu_fd_sc_mcu7t5v0__mux2_2;_7052_/S:gf180mcu_fd_sc_mcu7t5v0__mux2_2;_7256_/S:gf180mcu_fd_sc_mcu7t5v0__mux2_2;fanout162/Z:gf180mcu_fd_sc_mcu7t5v0__dlyb_1 | instruction/ROM/fetch+data-memory+peripheral | _7507_/A1 | \u_pochoco_soc.data_wdata[0];\u_pochoco_soc.data_wdata[1];\u_pochoco_soc.data_wdata[2];\u_pochoco_soc.data_wdata[3];\u_pochoco_soc.data_wdata[4];\u_pochoco_soc.data_wdata[5];\u_pochoco_soc.data_wdata[6];\u_pochoco_soc.data_wdata[7];\u_pochoco_soc.genblk1.g_rom_ram_memory.u_ram.a_addr_i[1];\u_pochoco_soc.genblk1.g_rom_ram_memory.u_ram.a_rdata_o[0];\u_pochoco_soc.genblk1.g_rom_ram_memory.u_ram.a_rdata_o[10];\u_pochoco_soc.genblk1.g_rom_ram_memory.u_ram.a_rdata_o[11];\u_pochoco_soc.genblk1.g_rom_ram_memory.u_ram.a_rdata_o[12];\u_pochoco_soc.genblk1.g_rom_ram_memory.u_ram.a_rdata_o[13];\u_pochoco_soc.genblk1.g_rom_ram_memory.u_ram.a_rdata_o[14];\u_pochoco_soc.genblk1.g_rom_ram_memory.u_ram.a_rdata_o[19];\u_pochoco_soc.genblk1.g_rom_ram_memory.u_ram.a_rdata_o[20];\u_pochoco_soc.genblk1.g_rom_ram_memory.u_ram.a_rdata_o[21];\u_pochoco_soc.genblk1.g_rom_ram_memory.u_ram.a_rdata_o[22];\u_pochoco_soc.genblk1.g_rom_ram_memory.u_ram.a_rdata_o[23];\u_pochoco_soc.genblk1.g_rom_ram_memory.u_ram.a_rdata_o[24];\u_pochoco_soc.genblk1.g_rom_ram_memory.u_ram.a_rdata_o[25];\u_pochoco_soc.genblk1.g_rom_ram_memory.u_ram.a_rdata_o[26];\u_pochoco_soc.genblk1.g_rom_ram_memory.u_ram.a_rdata_o[27];\u_pochoco_soc.genblk1.g_rom_ram_memory.u_ram.a_rdata_o[28];\u_pochoco_soc.genblk1.g_rom_ram_memory.u_ram.a_rdata_o[29];\u_pochoco_soc.genblk1.g_rom_ram_memory.u_ram.a_rdata_o[2];\u_pochoco_soc.genblk1.g_rom_ram_memory.u_ram.a_rdata_o[30];\u_pochoco_soc.genblk1.g_rom_ram_memory.u_ram.a_rdata_o[31];\u_pochoco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
slew | net484 | 11 | 4.705326 | 3.0 | -1.705326 | fanout484/Z:gf180mcu_fd_sc_mcu7t5v0__dlyb_1 | instruction/ROM/fetch | _5434_/A2 | \u_pochoco_soc.genblk1.g_rom_ram_memory.u_ram.a_rdata_o[15];\u_pochoco_soc.genblk1.g_rom_ram_memory.u_ram.a_rdata_o[16];\u_pochoco_soc.genblk1.g_rom_ram_memory.u_ram.a_rdata_o[17];\u_pochoco_soc.genblk1.g_rom_ram_memory.u_ram.a_rdata_o[18]
slew | net432 | 11 | 4.704362 | 3.0 | -1.704363 | fanout432/Z:gf180mcu_fd_sc_mcu7t5v0__dlyb_1 | instruction/ROM/fetch | _5212_/B1 | \u_pochoco_soc.genblk1.g_rom_ram_memory.u_ram.a_rdata_o[20];\u_pochoco_soc.genblk1.g_rom_ram_memory.u_ram.a_rdata_o[21];\u_pochoco_soc.genblk1.g_rom_ram_memory.u_ram.a_rdata_o[22];\u_pochoco_soc.genblk1.g_rom_ram_memory.u_ram.a_rdata_o[23]
slew | net224 | 11 | 4.699908 | 3.0 | -1.699908 | _6820_/S:gf180mcu_fd_sc_mcu7t5v0__mux2_2;_6871_/S:gf180mcu_fd_sc_mcu7t5v0__mux2_2;_6899_/S:gf180mcu_fd_sc_mcu7t5v0__mux2_2;_7131_/S:gf180mcu_fd_sc_mcu7t5v0__mux2_2;fanout224/Z:gf180mcu_fd_sc_mcu7t5v0__dlyb_1 | instruction/ROM/fetch+data-memory+peripheral | _6831_/A1 | \u_pochoco_soc.data_wdata[0];\u_pochoco_soc.data_wdata[1];\u_pochoco_soc.data_wdata[2];\u_pochoco_soc.data_wdata[3];\u_pochoco_soc.data_wdata[4];\u_pochoco_soc.data_wdata[5];\u_pochoco_soc.data_wdata[6];\u_pochoco_soc.data_wdata[7];\u_pochoco_soc.genblk1.g_rom_ram_memory.u_ram.a_addr_i[1];\u_pochoco_soc.genblk1.g_rom_ram_memory.u_ram.a_rdata_o[0];\u_pochoco_soc.genblk1.g_rom_ram_memory.u_ram.a_rdata_o[10];\u_pochoco_soc.genblk1.g_rom_ram_memory.u_ram.a_rdata_o[11];\u_pochoco_soc.genblk1.g_rom_ram_memory.u_ram.a_rdata_o[12];\u_pochoco_soc.genblk1.g_rom_ram_memory.u_ram.a_rdata_o[13];\u_pochoco_soc.genblk1.g_rom_ram_memory.u_ram.a_rdata_o[14];\u_pochoco_soc.genblk1.g_rom_ram_memory.u_ram.a_rdata_o[19];\u_pochoco_soc.genblk1.g_rom_ram_memory.u_ram.a_rdata_o[20];\u_pochoco_soc.genblk1.g_rom_ram_memory.u_ram.a_rdata_o[21];\u_pochoco_soc.genblk1.g_rom_ram_memory.u_ram.a_rdata_o[22];\u_pochoco_soc.genblk1.g_rom_ram_memory.u_ram.a_rdata_o[23];\u_pochoco_soc.genblk1.g_rom_ram_memory.u_ram.a_rdata_o[24];\u_pochoco_soc.genblk1.g_rom_ram_memory.u_ram.a_rdata_o[25];\u_pochoco_soc.genblk1.g_rom_ram_memory.u_ram.a_rdata_o[26];\u_pochoco_soc.genblk1.g_rom_ram_memory.u_ram.a_rdata_o[27];\u_pochoco_soc.genblk1.g_rom_ram_memory.u_ram.a_rdata_o[28];\u_pochoco_soc.genblk1.g_rom_ram_memory.u_ram.a_rdata_o[29];\u_pochoco_soc.genblk1.g_rom_ram_memory.u_ram.a_rdata_o[2];\u_pochoco_soc.genblk1.g_rom_ram_memory.u_ram.a_rdata_o[30];\u_pochoco_soc.genblk1.g_rom_ram_memory.u_ram.a_rdata_o[31];\u_pochoco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
slew | net480 | 11 | 4.681682 | 3.0 | -1.681682 | fanout480/Z:gf180mcu_fd_sc_mcu7t5v0__dlyb_1 | instruction/ROM/fetch | _5498_/A2 | \u_pochoco_soc.genblk1.g_rom_ram_memory.u_ram.a_rdata_o[15];\u_pochoco_soc.genblk1.g_rom_ram_memory.u_ram.a_rdata_o[16];\u_pochoco_soc.genblk1.g_rom_ram_memory.u_ram.a_rdata_o[17];\u_pochoco_soc.genblk1.g_rom_ram_memory.u_ram.a_rdata_o[18]
slew | net359 | 11 | 4.63806 | 3.0 | -1.63806 | fanout359/Z:gf180mcu_fd_sc_mcu7t5v0__dlyb_1 | instruction/ROM/fetch | _5500_/B1 | \u_pochoco_soc.genblk1.g_rom_ram_memory.u_ram.a_rdata_o[15];\u_pochoco_soc.genblk1.g_rom_ram_memory.u_ram.a_rdata_o[16];\u_pochoco_soc.genblk1.g_rom_ram_memory.u_ram.a_rdata_o[17];\u_pochoco_soc.genblk1.g_rom_ram_memory.u_ram.a_rdata_o[18]
slew | net383 | 11 | 4.635613 | 3.0 | -1.635613 | fanout383/Z:gf180mcu_fd_sc_mcu7t5v0__dlyb_1 | instruction/ROM/fetch | _5468_/B1 | \u_pochoco_soc.genblk1.g_rom_ram_memory.u_ram.a_rdata_o[15];\u_pochoco_soc.genblk1.g_rom_ram_memory.u_ram.a_rdata_o[16];\u_pochoco_soc.genblk1.g_rom_ram_memory.u_ram.a_rdata_o[17];\u_pochoco_soc.genblk1.g_rom_ram_memory.u_ram.a_rdata_o[18]
slew | net205 | 11 | 4.611211 | 3.0 | -1.611211 | _7182_/S:gf180mcu_fd_sc_mcu7t5v0__mux2_2;_7185_/S:gf180mcu_fd_sc_mcu7t5v0__mux2_2;_7188_/S:gf180mcu_fd_sc_mcu7t5v0__mux2_2;fanout205/Z:gf180mcu_fd_sc_mcu7t5v0__dlyb_1 | instruction/ROM/fetch+data-memory+peripheral | _7384_/A2 | \u_pochoco_soc.data_wdata[0];\u_pochoco_soc.data_wdata[1];\u_pochoco_soc.data_wdata[2];\u_pochoco_soc.data_wdata[3];\u_pochoco_soc.data_wdata[4];\u_pochoco_soc.data_wdata[5];\u_pochoco_soc.data_wdata[6];\u_pochoco_soc.data_wdata[7];\u_pochoco_soc.genblk1.g_rom_ram_memory.u_ram.a_addr_i[1];\u_pochoco_soc.genblk1.g_rom_ram_memory.u_ram.a_rdata_o[0];\u_pochoco_soc.genblk1.g_rom_ram_memory.u_ram.a_rdata_o[10];\u_pochoco_soc.genblk1.g_rom_ram_memory.u_ram.a_rdata_o[11];\u_pochoco_soc.genblk1.g_rom_ram_memory.u_ram.a_rdata_o[12];\u_pochoco_soc.genblk1.g_rom_ram_memory.u_ram.a_rdata_o[13];\u_pochoco_soc.genblk1.g_rom_ram_memory.u_ram.a_rdata_o[14];\u_pochoco_soc.genblk1.g_rom_ram_memory.u_ram.a_rdata_o[19];\u_pochoco_soc.genblk1.g_rom_ram_memory.u_ram.a_rdata_o[20];\u_pochoco_soc.genblk1.g_rom_ram_memory.u_ram.a_rdata_o[21];\u_pochoco_soc.genblk1.g_rom_ram_memory.u_ram.a_rdata_o[22];\u_pochoco_soc.genblk1.g_rom_ram_memory.u_ram.a_rdata_o[23];\u_pochoco_soc.genblk1.g_rom_ram_memory.u_ram.a_rdata_o[24];\u_pochoco_soc.genblk1.g_rom_ram_memory.u_ram.a_rdata_o[25];\u_pochoco_soc.genblk1.g_rom_ram_memory.u_ram.a_rdata_o[26];\u_pochoco_soc.genblk1.g_rom_ram_memory.u_ram.a_rdata_o[27];\u_pochoco_soc.genblk1.g_rom_ram_memory.u_ram.a_rdata_o[28];\u_pochoco_soc.genblk1.g_rom_ram_memory.u_ram.a_rdata_o[29];\u_pochoco_soc.genblk1.g_rom_ram_memory.u_ram.a_rdata_o[2];\u_pochoco_soc.genblk1.g_rom_ram_memory.u_ram.a_rdata_o[30];\u_pochoco_soc.genblk1.g_rom_ram_memory.u_ram.a_rdata_o[31];\u_pochoco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
slew | net500 | 11 | 4.597595 | 3.0 | -1.597595 | fanout500/Z:gf180mcu_fd_sc_mcu7t5v0__dlyb_1 | instruction/ROM/fetch | _5058_/A2 | \u_pochoco_soc.genblk1.g_rom_ram_memory.u_ram.a_rdata_o[20];\u_pochoco_soc.genblk1.g_rom_ram_memory.u_ram.a_rdata_o[21];\u_pochoco_soc.genblk1.g_rom_ram_memory.u_ram.a_rdata_o[22];\u_pochoco_soc.genblk1.g_rom_ram_memory.u_ram.a_rdata_o[23]
slew | net357 | 11 | 4.586238 | 3.0 | -1.586238 | fanout357/Z:gf180mcu_fd_sc_mcu7t5v0__dlyb_1 | instruction/ROM/fetch | _5389_/A2 | \u_pochoco_soc.genblk1.g_rom_ram_memory.u_ram.a_rdata_o[15];\u_pochoco_soc.genblk1.g_rom_ram_memory.u_ram.a_rdata_o[16];\u_pochoco_soc.genblk1.g_rom_ram_memory.u_ram.a_rdata_o[17];\u_pochoco_soc.genblk1.g_rom_ram_memory.u_ram.a_rdata_o[18]
slew | net84 | 11 | 4.572381 | 3.0 | -1.572382 | _6094_/S:gf180mcu_fd_sc_mcu7t5v0__mux2_2;fanout84/Z:gf180mcu_fd_sc_mcu7t5v0__dlyb_1 | instruction/ROM/fetch+data-memory+peripheral | fanout83/I | \u_pochoco_soc.data_wdata[0];\u_pochoco_soc.data_wdata[1];\u_pochoco_soc.data_wdata[2];\u_pochoco_soc.data_wdata[3];\u_pochoco_soc.data_wdata[4];\u_pochoco_soc.data_wdata[5];\u_pochoco_soc.data_wdata[6];\u_pochoco_soc.data_wdata[7];\u_pochoco_soc.genblk1.g_rom_ram_memory.u_ram.a_addr_i[10];\u_pochoco_soc.genblk1.g_rom_ram_memory.u_ram.a_addr_i[12];\u_pochoco_soc.genblk1.g_rom_ram_memory.u_ram.a_addr_i[13];\u_pochoco_soc.genblk1.g_rom_ram_memory.u_ram.a_addr_i[14];\u_pochoco_soc.genblk1.g_rom_ram_memory.u_ram.a_addr_i[15];\u_pochoco_soc.genblk1.g_rom_ram_memory.u_ram.a_addr_i[16];\u_pochoco_soc.genblk1.g_rom_ram_memory.u_ram.a_addr_i[17];\u_pochoco_soc.genblk1.g_rom_ram_memory.u_ram.a_addr_i[18];\u_pochoco_soc.genblk1.g_rom_ram_memory.u_ram.a_addr_i[19];\u_pochoco_soc.genblk1.g_rom_ram_memory.u_ram.a_addr_i[1];\u_pochoco_soc.genblk1.g_rom_ram_memory.u_ram.a_addr_i[20];\u_pochoco_soc.genblk1.g_rom_ram_memory.u_ram.a_addr_i[21];\u_pochoco_soc.genblk1.g_rom_ram_memory.u_ram.a_addr_i[22];\u_pochoco_soc.genblk1.g_rom_ram_memory.u_ram.a_addr_i[23];\u_pochoco_soc.genblk1.g_rom_ram_memory.u_ram.a_addr_i[24];\u_pochoco_soc.genblk1.g_rom_ram_memory.u_ram.a_addr_i[25];\u_pochoco_soc.genblk1.g_rom_ram_memory.u_ram.a_addr_i[26];\u_pochoco_soc.genblk1.g_rom_ram_memory.u_ram.a_addr_i[27];\u_pochoco_soc.genblk1.g_rom_ram_memory.u_ram.a_addr_i[28];\u_pochoco_soc.genblk1.g_rom_ram_memory.u_ram.a_addr_i[29];\u_pochoco_soc.genblk1.g_rom_ram_memory.u_ram.a_addr_i[2];\u_pochoco_soc.genblk1.g_rom_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
slew | net510 | 11 | 4.562429 | 3.0 | -1.562429 | fanout510/Z:gf180mcu_fd_sc_mcu7t5v0__dlyb_1 | instruction/ROM/fetch | _4910_/A1 | \u_pochoco_soc.genblk1.g_rom_ram_memory.u_ram.a_rdata_o[21];\u_pochoco_soc.genblk1.g_rom_ram_memory.u_ram.a_rdata_o[22];\u_pochoco_soc.genblk1.g_rom_ram_memory.u_ram.a_rdata_o[23]
slew | net380 | 11 | 4.543764 | 3.0 | -1.543764 | fanout380/Z:gf180mcu_fd_sc_mcu7t5v0__dlyb_1 | instruction/ROM/fetch | _5535_/A2 | \u_pochoco_soc.genblk1.g_rom_ram_memory.u_ram.a_rdata_o[15];\u_pochoco_soc.genblk1.g_rom_ram_memory.u_ram.a_rdata_o[16];\u_pochoco_soc.genblk1.g_rom_ram_memory.u_ram.a_rdata_o[17];\u_pochoco_soc.genblk1.g_rom_ram_memory.u_ram.a_rdata_o[18]
slew | net558 | 11 | 4.539896 | 3.0 | -1.539896 | fanout558/Z:gf180mcu_fd_sc_mcu7t5v0__dlyb_1 | instruction/ROM/fetch | _5132_/A1 | \u_pochoco_soc.genblk1.g_rom_ram_memory.u_ram.a_rdata_o[20]
slew | net355 | 11 | 4.537294 | 3.0 | -1.537294 | fanout355/Z:gf180mcu_fd_sc_mcu7t5v0__dlyb_1 | instruction/ROM/fetch | _5593_/B1 | \u_pochoco_soc.genblk1.g_rom_ram_memory.u_ram.a_rdata_o[15];\u_pochoco_soc.genblk1.g_rom_ram_memory.u_ram.a_rdata_o[16];\u_pochoco_soc.genblk1.g_rom_ram_memory.u_ram.a_rdata_o[17];\u_pochoco_soc.genblk1.g_rom_ram_memory.u_ram.a_rdata_o[18]
slew | net489 | 11 | 4.532946 | 3.0 | -1.532946 | fanout489/Z:gf180mcu_fd_sc_mcu7t5v0__dlyb_1 | instruction/ROM/fetch | _5297_/A1 | \u_pochoco_soc.genblk1.g_rom_ram_memory.u_ram.a_rdata_o[16];\u_pochoco_soc.genblk1.g_rom_ram_memory.u_ram.a_rdata_o[17];\u_pochoco_soc.genblk1.g_rom_ram_memory.u_ram.a_rdata_o[18]
slew | net396 | 11 | 4.510775 | 3.0 | -1.510775 | fanout396/Z:gf180mcu_fd_sc_mcu7t5v0__dlyb_1 | instruction/ROM/fetch | _5576_/A2 | \u_pochoco_soc.genblk1.g_rom_ram_memory.u_ram.a_rdata_o[15];\u_pochoco_soc.genblk1.g_rom_ram_memory.u_ram.a_rdata_o[16];\u_pochoco_soc.genblk1.g_rom_ram_memory.u_ram.a_rdata_o[17];\u_pochoco_soc.genblk1.g_rom_ram_memory.u_ram.a_rdata_o[18]
slew | net424 | 11 | 4.506912 | 3.0 | -1.506912 | fanout424/Z:gf180mcu_fd_sc_mcu7t5v0__dlyb_1 | instruction/ROM/fetch | _5138_/C1 | \u_pochoco_soc.genblk1.g_rom_ram_memory.u_ram.a_rdata_o[20];\u_pochoco_soc.genblk1.g_rom_ram_memory.u_ram.a_rdata_o[21];\u_pochoco_soc.genblk1.g_rom_ram_memory.u_ram.a_rdata_o[22];\u_pochoco_soc.genblk1.g_rom_ram_memory.u_ram.a_rdata_o[23]
slew | net559 | 11 | 4.500537 | 3.0 | -1.500538 | fanout559/Z:gf180mcu_fd_sc_mcu7t5v0__dlyb_1 | instruction/ROM/fetch | _5210_/A1 | \u_pochoco_soc.genblk1.g_rom_ram_memory.u_ram.a_rdata_o[20]
slew | net364 | 11 | 4.497568 | 3.0 | -1.497568 | fanout364/Z:gf180mcu_fd_sc_mcu7t5v0__dlyb_1 | instruction/ROM/fetch | _5578_/B1 | \u_pochoco_soc.genblk1.g_rom_ram_memory.u_ram.a_rdata_o[15];\u_pochoco_soc.genblk1.g_rom_ram_memory.u_ram.a_rdata_o[16];\u_pochoco_soc.genblk1.g_rom_ram_memory.u_ram.a_rdata_o[17];\u_pochoco_soc.genblk1.g_rom_ram_memory.u_ram.a_rdata_o[18]
slew | net496 | 11 | 4.48449 | 3.0 | -1.48449 | fanout496/Z:gf180mcu_fd_sc_mcu7t5v0__dlyb_1 | instruction/ROM/fetch | _5056_/A2 | \u_pochoco_soc.genblk1.g_rom_ram_memory.u_ram.a_rdata_o[20];\u_pochoco_soc.genblk1.g_rom_ram_memory.u_ram.a_rdata_o[21];\u_pochoco_soc.genblk1.g_rom_ram_memory.u_ram.a_rdata_o[22];\u_pochoco_soc.genblk1.g_rom_ram_memory.u_ram.a_rdata_o[23]
slew | net416 | 11 | 4.476487 | 3.0 | -1.476487 | fanout416/Z:gf180mcu_fd_sc_mcu7t5v0__dlyb_1 | instruction/ROM/fetch | _4905_/B1 | \u_pochoco_soc.genblk1.g_rom_ram_memory.u_ram.a_rdata_o[20];\u_pochoco_soc.genblk1.g_rom_ram_memory.u_ram.a_rdata_o[21];\u_pochoco_soc.genblk1.g_rom_ram_memory.u_ram.a_rdata_o[22];\u_pochoco_soc.genblk1.g_rom_ram_memory.u_ram.a_rdata_o[23]
slew | net407 | 11 | 4.463557 | 3.0 | -1.463557 | fanout407/Z:gf180mcu_fd_sc_mcu7t5v0__dlyb_1 | instruction/ROM/fetch | _5057_/B1 | \u_pochoco_soc.genblk1.g_rom_ram_memory.u_ram.a_rdata_o[20];\u_pochoco_soc.genblk1.g_rom_ram_memory.u_ram.a_rdata_o[21];\u_pochoco_soc.genblk1.g_rom_ram_memory.u_ram.a_rdata_o[22];\u_pochoco_soc.genblk1.g_rom_ram_memory.u_ram.a_rdata_o[23]
slew | net372 | 11 | 4.452911 | 3.0 | -1.452912 | fanout372/Z:gf180mcu_fd_sc_mcu7t5v0__dlyb_1 | instruction/ROM/fetch | _5444_/A2 | \u_pochoco_soc.genblk1.g_rom_ram_memory.u_ram.a_rdata_o[15];\u_pochoco_soc.genblk1.g_rom_ram_memory.u_ram.a_rdata_o[16];\u_pochoco_soc.genblk1.g_rom_ram_memory.u_ram.a_rdata_o[17];\u_pochoco_soc.genblk1.g_rom_ram_memory.u_ram.a_rdata_o[18]
slew | net433 | 11 | 4.452219 | 3.0 | -1.452219 | fanout433/Z:gf180mcu_fd_sc_mcu7t5v0__dlyb_1 | instruction/ROM/fetch | _5156_/B1 | \u_pochoco_soc.genblk1.g_rom_ram_memory.u_ram.a_rdata_o[20];\u_pochoco_soc.genblk1.g_rom_ram_memory.u_ram.a_rdata_o[21];\u_pochoco_soc.genblk1.g_rom_ram_memory.u_ram.a_rdata_o[22];\u_pochoco_soc.genblk1.g_rom_ram_memory.u_ram.a_rdata_o[23]
slew | net492 | 11 | 4.449653 | 3.0 | -1.449653 | fanout492/Z:gf180mcu_fd_sc_mcu7t5v0__dlyb_1 | instruction/ROM/fetch | _5140_/B1 | \u_pochoco_soc.genblk1.g_rom_ram_memory.u_ram.a_rdata_o[20];\u_pochoco_soc.genblk1.g_rom_ram_memory.u_ram.a_rdata_o[21];\u_pochoco_soc.genblk1.g_rom_ram_memory.u_ram.a_rdata_o[22];\u_pochoco_soc.genblk1.g_rom_ram_memory.u_ram.a_rdata_o[23]
slew | net155 | 11 | 4.399748 | 3.0 | -1.399748 | _7069_/S:gf180mcu_fd_sc_mcu7t5v0__mux2_2;_7076_/S:gf180mcu_fd_sc_mcu7t5v0__mux2_2;_7079_/S:gf180mcu_fd_sc_mcu7t5v0__mux2_2;_7274_/S:gf180mcu_fd_sc_mcu7t5v0__mux2_2;fanout155/Z:gf180mcu_fd_sc_mcu7t5v0__dlyb_1 | instruction/ROM/fetch+data-memory+peripheral | _7073_/A2 | \u_pochoco_soc.data_wdata[0];\u_pochoco_soc.data_wdata[1];\u_pochoco_soc.data_wdata[2];\u_pochoco_soc.data_wdata[3];\u_pochoco_soc.data_wdata[4];\u_pochoco_soc.data_wdata[5];\u_pochoco_soc.data_wdata[6];\u_pochoco_soc.data_wdata[7];\u_pochoco_soc.genblk1.g_rom_ram_memory.u_ram.a_addr_i[1];\u_pochoco_soc.genblk1.g_rom_ram_memory.u_ram.a_rdata_o[0];\u_pochoco_soc.genblk1.g_rom_ram_memory.u_ram.a_rdata_o[10];\u_pochoco_soc.genblk1.g_rom_ram_memory.u_ram.a_rdata_o[11];\u_pochoco_soc.genblk1.g_rom_ram_memory.u_ram.a_rdata_o[12];\u_pochoco_soc.genblk1.g_rom_ram_memory.u_ram.a_rdata_o[13];\u_pochoco_soc.genblk1.g_rom_ram_memory.u_ram.a_rdata_o[14];\u_pochoco_soc.genblk1.g_rom_ram_memory.u_ram.a_rdata_o[19];\u_pochoco_soc.genblk1.g_rom_ram_memory.u_ram.a_rdata_o[20];\u_pochoco_soc.genblk1.g_rom_ram_memory.u_ram.a_rdata_o[21];\u_pochoco_soc.genblk1.g_rom_ram_memory.u_ram.a_rdata_o[22];\u_pochoco_soc.genblk1.g_rom_ram_memory.u_ram.a_rdata_o[23];\u_pochoco_soc.genblk1.g_rom_ram_memory.u_ram.a_rdata_o[24];\u_pochoco_soc.genblk1.g_rom_ram_memory.u_ram.a_rdata_o[25];\u_pochoco_soc.genblk1.g_rom_ram_memory.u_ram.a_rdata_o[26];\u_pochoco_soc.genblk1.g_rom_ram_memory.u_ram.a_rdata_o[27];\u_pochoco_soc.genblk1.g_rom_ram_memory.u_ram.a_rdata_o[28];\u_pochoco_soc.genblk1.g_rom_ram_memory.u_ram.a_rdata_o[29];\u_pochoco_soc.genblk1.g_rom_ram_memory.u_ram.a_rdata_o[2];\u_pochoco_soc.genblk1.g_rom_ram_memory.u_ram.a_rdata_o[30];\u_pochoco_soc.genblk1.g_rom_ram_memory.u_ram.a_rdata_o[31];\u_pochoco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
slew | net563 | 11 | 4.366057 | 3.0 | -1.366057 | fanout563/Z:gf180mcu_fd_sc_mcu7t5v0__dlyb_1 | instruction/ROM/fetch | _5508_/A1 | \u_pochoco_soc.genblk1.g_rom_ram_memory.u_ram.a_rdata_o[15]
slew | net497 | 11 | 4.347816 | 3.0 | -1.347817 | fanout497/Z:gf180mcu_fd_sc_mcu7t5v0__dlyb_1 | instruction/ROM/fetch | _5239_/B1 | \u_pochoco_soc.genblk1.g_rom_ram_memory.u_ram.a_rdata_o[20];\u_pochoco_soc.genblk1.g_rom_ram_memory.u_ram.a_rdata_o[21];\u_pochoco_soc.genblk1.g_rom_ram_memory.u_ram.a_rdata_o[22];\u_pochoco_soc.genblk1.g_rom_ram_memory.u_ram.a_rdata_o[23]
slew | net395 | 11 | 4.335298 | 3.0 | -1.335298 | fanout395/Z:gf180mcu_fd_sc_mcu7t5v0__dlyb_1 | instruction/ROM/fetch | _5439_/A2 | \u_pochoco_soc.genblk1.g_rom_ram_memory.u_ram.a_rdata_o[15];\u_pochoco_soc.genblk1.g_rom_ram_memory.u_ram.a_rdata_o[16];\u_pochoco_soc.genblk1.g_rom_ram_memory.u_ram.a_rdata_o[17];\u_pochoco_soc.genblk1.g_rom_ram_memory.u_ram.a_rdata_o[18]
slew | net404 | 11 | 4.324516 | 3.0 | -1.324517 | fanout404/Z:gf180mcu_fd_sc_mcu7t5v0__dlyb_1 | instruction/ROM/fetch | _5617_/A1 | \u_pochoco_soc.genblk1.g_rom_ram_memory.u_ram.a_rdata_o[16];\u_pochoco_soc.genblk1.g_rom_ram_memory.u_ram.a_rdata_o[17];\u_pochoco_soc.genblk1.g_rom_ram_memory.u_ram.a_rdata_o[18]
slew | net403 | 11 | 4.30425 | 3.0 | -1.30425 | fanout403/Z:gf180mcu_fd_sc_mcu7t5v0__dlyb_1 | instruction/ROM/fetch | _5529_/A1 | \u_pochoco_soc.genblk1.g_rom_ram_memory.u_ram.a_rdata_o[16];\u_pochoco_soc.genblk1.g_rom_ram_memory.u_ram.a_rdata_o[17];\u_pochoco_soc.genblk1.g_rom_ram_memory.u_ram.a_rdata_o[18]
slew | net564 | 11 | 4.296919 | 3.0 | -1.296919 | fanout564/Z:gf180mcu_fd_sc_mcu7t5v0__dlyb_1 | instruction/ROM/fetch | _5585_/A1 | \u_pochoco_soc.genblk1.g_rom_ram_memory.u_ram.a_rdata_o[15]
slew | net488 | 11 | 4.243894 | 3.0 | -1.243894 | fanout488/Z:gf180mcu_fd_sc_mcu7t5v0__dlyb_1 | instruction/ROM/fetch | _5495_/A1 | \u_pochoco_soc.genblk1.g_rom_ram_memory.u_ram.a_rdata_o[16];\u_pochoco_soc.genblk1.g_rom_ram_memory.u_ram.a_rdata_o[17];\u_pochoco_soc.genblk1.g_rom_ram_memory.u_ram.a_rdata_o[18]
slew | net412 | 11 | 4.209085 | 3.0 | -1.209084 | fanout412/Z:gf180mcu_fd_sc_mcu7t5v0__dlyb_1 | instruction/ROM/fetch | _5251_/B1 | \u_pochoco_soc.genblk1.g_rom_ram_memory.u_ram.a_rdata_o[20];\u_pochoco_soc.genblk1.g_rom_ram_memory.u_ram.a_rdata_o[21];\u_pochoco_soc.genblk1.g_rom_ram_memory.u_ram.a_rdata_o[22];\u_pochoco_soc.genblk1.g_rom_ram_memory.u_ram.a_rdata_o[23]
slew | net458 | 11 | 4.157673 | 3.0 | -1.157673 | fanout458/Z:gf180mcu_fd_sc_mcu7t5v0__dlyb_1 | instruction/ROM/fetch | _7325_/B | \u_pochoco_soc.genblk1.g_rom_ram_memory.u_ram.a_rdata_o[0];\u_pochoco_soc.genblk1.g_rom_ram_memory.u_ram.a_rdata_o[2];\u_pochoco_soc.genblk1.g_rom_ram_memory.u_ram.a_rdata_o[4];\u_pochoco_soc.genblk1.g_rom_ram_memory.u_ram.a_rdata_o[5];\u_pochoco_soc.genblk1.g_rom_ram_memory.u_ram.a_rdata_o[6]
slew | net356 | 11 | 4.138068 | 3.0 | -1.138068 | fanout356/Z:gf180mcu_fd_sc_mcu7t5v0__dlyb_1 | instruction/ROM/fetch | _5620_/B1 | \u_pochoco_soc.genblk1.g_rom_ram_memory.u_ram.a_rdata_o[15];\u_pochoco_soc.genblk1.g_rom_ram_memory.u_ram.a_rdata_o[16];\u_pochoco_soc.genblk1.g_rom_ram_memory.u_ram.a_rdata_o[17];\u_pochoco_soc.genblk1.g_rom_ram_memory.u_ram.a_rdata_o[18]
slew | net188 | 11 | 4.118996 | 3.0 | -1.118996 | _7209_/S:gf180mcu_fd_sc_mcu7t5v0__mux2_2;_7210_/S:gf180mcu_fd_sc_mcu7t5v0__mux2_2;_7212_/S:gf180mcu_fd_sc_mcu7t5v0__mux2_2;fanout188/Z:gf180mcu_fd_sc_mcu7t5v0__dlyb_1 | instruction/ROM/fetch+data-memory+peripheral | _7432_/A2 | \u_pochoco_soc.data_wdata[0];\u_pochoco_soc.data_wdata[1];\u_pochoco_soc.data_wdata[2];\u_pochoco_soc.data_wdata[3];\u_pochoco_soc.data_wdata[4];\u_pochoco_soc.data_wdata[5];\u_pochoco_soc.data_wdata[6];\u_pochoco_soc.data_wdata[7];\u_pochoco_soc.genblk1.g_rom_ram_memory.u_ram.a_addr_i[1];\u_pochoco_soc.genblk1.g_rom_ram_memory.u_ram.a_rdata_o[0];\u_pochoco_soc.genblk1.g_rom_ram_memory.u_ram.a_rdata_o[10];\u_pochoco_soc.genblk1.g_rom_ram_memory.u_ram.a_rdata_o[11];\u_pochoco_soc.genblk1.g_rom_ram_memory.u_ram.a_rdata_o[12];\u_pochoco_soc.genblk1.g_rom_ram_memory.u_ram.a_rdata_o[13];\u_pochoco_soc.genblk1.g_rom_ram_memory.u_ram.a_rdata_o[14];\u_pochoco_soc.genblk1.g_rom_ram_memory.u_ram.a_rdata_o[19];\u_pochoco_soc.genblk1.g_rom_ram_memory.u_ram.a_rdata_o[20];\u_pochoco_soc.genblk1.g_rom_ram_memory.u_ram.a_rdata_o[21];\u_pochoco_soc.genblk1.g_rom_ram_memory.u_ram.a_rdata_o[22];\u_pochoco_soc.genblk1.g_rom_ram_memory.u_ram.a_rdata_o[23];\u_pochoco_soc.genblk1.g_rom_ram_memory.u_ram.a_rdata_o[24];\u_pochoco_soc.genblk1.g_rom_ram_memory.u_ram.a_rdata_o[25];\u_pochoco_soc.genblk1.g_rom_ram_memory.u_ram.a_rdata_o[26];\u_pochoco_soc.genblk1.g_rom_ram_memory.u_ram.a_rdata_o[27];\u_pochoco_soc.genblk1.g_rom_ram_memory.u_ram.a_rdata_o[28];\u_pochoco_soc.genblk1.g_rom_ram_memory.u_ram.a_rdata_o[29];\u_pochoco_soc.genblk1.g_rom_ram_memory.u_ram.a_rdata_o[2];\u_pochoco_soc.genblk1.g_rom_ram_memory.u_ram.a_rdata_o[30];\u_pochoco_soc.genblk1.g_rom_ram_memory.u_ram.a_rdata_o[31];\u_pochoco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
slew | net185 | 11 | 4.116459 | 3.0 | -1.116459 | _6989_/S:gf180mcu_fd_sc_mcu7t5v0__mux2_2;_6996_/S:gf180mcu_fd_sc_mcu7t5v0__mux2_2;_6999_/S:gf180mcu_fd_sc_mcu7t5v0__mux2_2;_7220_/S:gf180mcu_fd_sc_mcu7t5v0__mux2_2;fanout185/Z:gf180mcu_fd_sc_mcu7t5v0__dlyb_1 | instruction/ROM/fetch+data-memory+peripheral | _6992_/A2 | \u_pochoco_soc.data_wdata[0];\u_pochoco_soc.data_wdata[1];\u_pochoco_soc.data_wdata[2];\u_pochoco_soc.data_wdata[3];\u_pochoco_soc.data_wdata[4];\u_pochoco_soc.data_wdata[5];\u_pochoco_soc.data_wdata[6];\u_pochoco_soc.data_wdata[7];\u_pochoco_soc.genblk1.g_rom_ram_memory.u_ram.a_addr_i[1];\u_pochoco_soc.genblk1.g_rom_ram_memory.u_ram.a_rdata_o[0];\u_pochoco_soc.genblk1.g_rom_ram_memory.u_ram.a_rdata_o[10];\u_pochoco_soc.genblk1.g_rom_ram_memory.u_ram.a_rdata_o[11];\u_pochoco_soc.genblk1.g_rom_ram_memory.u_ram.a_rdata_o[12];\u_pochoco_soc.genblk1.g_rom_ram_memory.u_ram.a_rdata_o[13];\u_pochoco_soc.genblk1.g_rom_ram_memory.u_ram.a_rdata_o[14];\u_pochoco_soc.genblk1.g_rom_ram_memory.u_ram.a_rdata_o[19];\u_pochoco_soc.genblk1.g_rom_ram_memory.u_ram.a_rdata_o[20];\u_pochoco_soc.genblk1.g_rom_ram_memory.u_ram.a_rdata_o[21];\u_pochoco_soc.genblk1.g_rom_ram_memory.u_ram.a_rdata_o[22];\u_pochoco_soc.genblk1.g_rom_ram_memory.u_ram.a_rdata_o[23];\u_pochoco_soc.genblk1.g_rom_ram_memory.u_ram.a_rdata_o[24];\u_pochoco_soc.genblk1.g_rom_ram_memory.u_ram.a_rdata_o[25];\u_pochoco_soc.genblk1.g_rom_ram_memory.u_ram.a_rdata_o[26];\u_pochoco_soc.genblk1.g_rom_ram_memory.u_ram.a_rdata_o[27];\u_pochoco_soc.genblk1.g_rom_ram_memory.u_ram.a_rdata_o[28];\u_pochoco_soc.genblk1.g_rom_ram_memory.u_ram.a_rdata_o[29];\u_pochoco_soc.genblk1.g_rom_ram_memory.u_ram.a_rdata_o[2];\u_pochoco_soc.genblk1.g_rom_ram_memory.u_ram.a_rdata_o[30];\u_pochoco_soc.genblk1.g_rom_ram_memory.u_ram.a_rdata_o[31];\u_pochoco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
slew | net208 | 11 | 4.049016 | 3.0 | -1.049016 | fanout208/Z:gf180mcu_fd_sc_mcu7t5v0__dlyb_1 | instruction/ROM/fetch+data-memory+peripheral | _7668_/A2 | \u_pochoco_soc.data_wdata[0];\u_pochoco_soc.data_wdata[1];\u_pochoco_soc.data_wdata[3];\u_pochoco_soc.data_wdata[4];\u_pochoco_soc.data_wdata[5];\u_pochoco_soc.data_wdata[6];\u_pochoco_soc.data_wdata[7];\u_pochoco_soc.genblk1.g_rom_ram_memory.u_ram.a_addr_i[1];\u_pochoco_soc.genblk1.g_rom_ram_memory.u_ram.a_rdata_o[0];\u_pochoco_soc.genblk1.g_rom_ram_memory.u_ram.a_rdata_o[10];\u_pochoco_soc.genblk1.g_rom_ram_memory.u_ram.a_rdata_o[11];\u_pochoco_soc.genblk1.g_rom_ram_memory.u_ram.a_rdata_o[12];\u_pochoco_soc.genblk1.g_rom_ram_memory.u_ram.a_rdata_o[13];\u_pochoco_soc.genblk1.g_rom_ram_memory.u_ram.a_rdata_o[14];\u_pochoco_soc.genblk1.g_rom_ram_memory.u_ram.a_rdata_o[19];\u_pochoco_soc.genblk1.g_rom_ram_memory.u_ram.a_rdata_o[21];\u_pochoco_soc.genblk1.g_rom_ram_memory.u_ram.a_rdata_o[23];\u_pochoco_soc.genblk1.g_rom_ram_memory.u_ram.a_rdata_o[24];\u_pochoco_soc.genblk1.g_rom_ram_memory.u_ram.a_rdata_o[25];\u_pochoco_soc.genblk1.g_rom_ram_memory.u_ram.a_rdata_o[26];\u_pochoco_soc.genblk1.g_rom_ram_memory.u_ram.a_rdata_o[27];\u_pochoco_soc.genblk1.g_rom_ram_memory.u_ram.a_rdata_o[28];\u_pochoco_soc.genblk1.g_rom_ram_memory.u_ram.a_rdata_o[29];\u_pochoco_soc.genblk1.g_rom_ram_memory.u_ram.a_rdata_o[2];\u_pochoco_soc.genblk1.g_rom_ram_memory.u_ram.a_rdata_o[30];\u_pochoco_soc.genblk1.g_rom_ram_memory.u_ram.a_rdata_o[31];\u_pochoco_soc.genblk1.g_rom_ram_memory.u_ram.a_rdata_o[3];\u_pochoco_soc.genblk1.g_rom_ram_memory.u_ram.a_rdata_o[4];\u_pochoco_soc.genblk1.g_rom_ram_memory.u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
slew | net106 | 11 | 4.041013 | 3.0 | -1.041013 | _5793_/S:gf180mcu_fd_sc_mcu7t5v0__mux2_2;_5839_/S:gf180mcu_fd_sc_mcu7t5v0__mux2_2;fanout106/Z:gf180mcu_fd_sc_mcu7t5v0__dlyb_1 | instruction/ROM/fetch+data-memory+peripheral | _5839_/S | \u_pochoco_soc.data_wdata[0];\u_pochoco_soc.data_wdata[1];\u_pochoco_soc.data_wdata[2];\u_pochoco_soc.data_wdata[3];\u_pochoco_soc.data_wdata[4];\u_pochoco_soc.data_wdata[5];\u_pochoco_soc.data_wdata[6];\u_pochoco_soc.data_wdata[7];\u_pochoco_soc.genblk1.g_rom_ram_memory.u_ram.a_addr_i[10];\u_pochoco_soc.genblk1.g_rom_ram_memory.u_ram.a_addr_i[1];\u_pochoco_soc.genblk1.g_rom_ram_memory.u_ram.a_addr_i[2];\u_pochoco_soc.genblk1.g_rom_ram_memory.u_ram.a_addr_i[3];\u_pochoco_soc.genblk1.g_rom_ram_memory.u_ram.a_addr_i[4];\u_pochoco_soc.genblk1.g_rom_ram_memory.u_ram.a_addr_i[5];\u_pochoco_soc.genblk1.g_rom_ram_memory.u_ram.a_addr_i[6];\u_pochoco_soc.genblk1.g_rom_ram_memory.u_ram.a_addr_i[7];\u_pochoco_soc.genblk1.g_rom_ram_memory.u_ram.a_addr_i[8];\u_pochoco_soc.genblk1.g_rom_ram_memory.u_ram.a_addr_i[9];\u_pochoco_soc.genblk1.g_rom_ram_memory.u_ram.a_rdata_o[0];\u_pochoco_soc.genblk1.g_rom_ram_memory.u_ram.a_rdata_o[10];\u_pochoco_soc.genblk1.g_rom_ram_memory.u_ram.a_rdata_o[11];\u_pochoco_soc.genblk1.g_rom_ram_memory.u_ram.a_rdata_o[12];\u_pochoco_soc.genblk1.g_rom_ram_memory.u_ram.a_rdata_o[13];\u_pochoco_soc.genblk1.g_rom_ram_memory.u_ram.a_rdata_o[14];\u_pochoco_soc.genblk1.g_rom_ram_memory.u_ram.a_rdata_o[18];\u_pochoco_soc.genblk1.g_rom_ram_memory.u_ram.a_rdata_o[19];\u_pochoco_soc.genblk1.g_rom_ram_memory.u_ram.a_rdata_o[20];\u_pochoco_soc.genblk1.g_rom_ram_memory.u_ram.a_rdata_o[21];\u_pochoco_soc.genblk1.g_rom_ram_memory.u_ram.a_rdata_o[22];\u_pochoco_soc.genblk1.g_r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
slew | net197 | 11 | 4.030669 | 3.0 | -1.030669 | _7191_/S:gf180mcu_fd_sc_mcu7t5v0__mux2_2;_7192_/S:gf180mcu_fd_sc_mcu7t5v0__mux2_2;_7194_/S:gf180mcu_fd_sc_mcu7t5v0__mux2_2;_7197_/S:gf180mcu_fd_sc_mcu7t5v0__mux2_2;fanout197/Z:gf180mcu_fd_sc_mcu7t5v0__dlyb_1 | instruction/ROM/fetch+data-memory+peripheral | _7197_/S | \u_pochoco_soc.data_wdata[0];\u_pochoco_soc.data_wdata[1];\u_pochoco_soc.data_wdata[2];\u_pochoco_soc.data_wdata[3];\u_pochoco_soc.data_wdata[4];\u_pochoco_soc.data_wdata[5];\u_pochoco_soc.data_wdata[6];\u_pochoco_soc.data_wdata[7];\u_pochoco_soc.genblk1.g_rom_ram_memory.u_ram.a_addr_i[1];\u_pochoco_soc.genblk1.g_rom_ram_memory.u_ram.a_rdata_o[0];\u_pochoco_soc.genblk1.g_rom_ram_memory.u_ram.a_rdata_o[10];\u_pochoco_soc.genblk1.g_rom_ram_memory.u_ram.a_rdata_o[11];\u_pochoco_soc.genblk1.g_rom_ram_memory.u_ram.a_rdata_o[12];\u_pochoco_soc.genblk1.g_rom_ram_memory.u_ram.a_rdata_o[13];\u_pochoco_soc.genblk1.g_rom_ram_memory.u_ram.a_rdata_o[14];\u_pochoco_soc.genblk1.g_rom_ram_memory.u_ram.a_rdata_o[19];\u_pochoco_soc.genblk1.g_rom_ram_memory.u_ram.a_rdata_o[20];\u_pochoco_soc.genblk1.g_rom_ram_memory.u_ram.a_rdata_o[21];\u_pochoco_soc.genblk1.g_rom_ram_memory.u_ram.a_rdata_o[22];\u_pochoco_soc.genblk1.g_rom_ram_memory.u_ram.a_rdata_o[23];\u_pochoco_soc.genblk1.g_rom_ram_memory.u_ram.a_rdata_o[24];\u_pochoco_soc.genblk1.g_rom_ram_memory.u_ram.a_rdata_o[25];\u_pochoco_soc.genblk1.g_rom_ram_memory.u_ram.a_rdata_o[26];\u_pochoco_soc.genblk1.g_rom_ram_memory.u_ram.a_rdata_o[27];\u_pochoco_soc.genblk1.g_rom_ram_memory.u_ram.a_rdata_o[28];\u_pochoco_soc.genblk1.g_rom_ram_memory.u_ram.a_rdata_o[29];\u_pochoco_soc.genblk1.g_rom_ram_memory.u_ram.a_rdata_o[2];\u_pochoco_soc.genblk1.g_rom_ram_memory.u_ram.a_rdata_o[30];\u_pochoco_soc.genblk1.g_rom_ram_memory.u_ram.a_rdata_o[31];\u_pochoco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
slew | net505 | 11 | 3.995802 | 3.0 | -0.995802 | fanout505/Z:gf180mcu_fd_sc_mcu7t5v0__dlyb_1 | instruction/ROM/fetch | _5102_/B | \u_pochoco_soc.genblk1.g_rom_ram_memory.u_ram.a_rdata_o[21];\u_pochoco_soc.genblk1.g_rom_ram_memory.u_ram.a_rdata_o[22];\u_pochoco_soc.genblk1.g_rom_ram_memory.u_ram.a_rdata_o[23]
slew | net83 | 11 | 3.957057 | 3.0 | -0.957057 | _5872_/S:gf180mcu_fd_sc_mcu7t5v0__mux2_2;_5973_/S:gf180mcu_fd_sc_mcu7t5v0__mux2_2;_5999_/S:gf180mcu_fd_sc_mcu7t5v0__mux2_2;_6030_/S:gf180mcu_fd_sc_mcu7t5v0__mux2_2;fanout83/Z:gf180mcu_fd_sc_mcu7t5v0__dlyb_1 | instruction/ROM/fetch+data-memory+peripheral | _5872_/S | \u_pochoco_soc.data_wdata[0];\u_pochoco_soc.data_wdata[1];\u_pochoco_soc.data_wdata[2];\u_pochoco_soc.data_wdata[3];\u_pochoco_soc.data_wdata[4];\u_pochoco_soc.data_wdata[5];\u_pochoco_soc.data_wdata[6];\u_pochoco_soc.data_wdata[7];\u_pochoco_soc.genblk1.g_rom_ram_memory.u_ram.a_addr_i[10];\u_pochoco_soc.genblk1.g_rom_ram_memory.u_ram.a_addr_i[11];\u_pochoco_soc.genblk1.g_rom_ram_memory.u_ram.a_addr_i[12];\u_pochoco_soc.genblk1.g_rom_ram_memory.u_ram.a_addr_i[13];\u_pochoco_soc.genblk1.g_rom_ram_memory.u_ram.a_addr_i[14];\u_pochoco_soc.genblk1.g_rom_ram_memory.u_ram.a_addr_i[15];\u_pochoco_soc.genblk1.g_rom_ram_memory.u_ram.a_addr_i[16];\u_pochoco_soc.genblk1.g_rom_ram_memory.u_ram.a_addr_i[17];\u_pochoco_soc.genblk1.g_rom_ram_memory.u_ram.a_addr_i[18];\u_pochoco_soc.genblk1.g_rom_ram_memory.u_ram.a_addr_i[19];\u_pochoco_soc.genblk1.g_rom_ram_memory.u_ram.a_addr_i[1];\u_pochoco_soc.genblk1.g_rom_ram_memory.u_ram.a_addr_i[20];\u_pochoco_soc.genblk1.g_rom_ram_memory.u_ram.a_addr_i[21];\u_pochoco_soc.genblk1.g_rom_ram_memory.u_ram.a_addr_i[22];\u_pochoco_soc.genblk1.g_rom_ram_memory.u_ram.a_addr_i[23];\u_pochoco_soc.genblk1.g_rom_ram_memory.u_ram.a_addr_i[24];\u_pochoco_soc.genblk1.g_rom_ram_memory.u_ram.a_addr_i[25];\u_pochoco_soc.genblk1.g_rom_ram_memory.u_ram.a_addr_i[26];\u_pochoco_soc.genblk1.g_rom_ram_memory.u_ram.a_addr_i[27];\u_pochoco_soc.genblk1.g_rom_ram_memory.u_ram.a_addr_i[28];\u_pochoco_soc.genblk1.g_rom_ram_memory.u_ram.a_addr_i[29];\u_pochoco_soc.genblk1.g_rom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
slew | net172 | 11 | 3.942961 | 3.0 | -0.942961 | _7236_/S:gf180mcu_fd_sc_mcu7t5v0__mux2_2;_7239_/S:gf180mcu_fd_sc_mcu7t5v0__mux2_2;_7242_/S:gf180mcu_fd_sc_mcu7t5v0__mux2_2;fanout172/Z:gf180mcu_fd_sc_mcu7t5v0__dlyb_1 | instruction/ROM/fetch+data-memory+peripheral | _7477_/A1 | \u_pochoco_soc.data_wdata[0];\u_pochoco_soc.data_wdata[1];\u_pochoco_soc.data_wdata[2];\u_pochoco_soc.data_wdata[3];\u_pochoco_soc.data_wdata[4];\u_pochoco_soc.data_wdata[5];\u_pochoco_soc.data_wdata[6];\u_pochoco_soc.data_wdata[7];\u_pochoco_soc.genblk1.g_rom_ram_memory.u_ram.a_addr_i[1];\u_pochoco_soc.genblk1.g_rom_ram_memory.u_ram.a_rdata_o[0];\u_pochoco_soc.genblk1.g_rom_ram_memory.u_ram.a_rdata_o[10];\u_pochoco_soc.genblk1.g_rom_ram_memory.u_ram.a_rdata_o[11];\u_pochoco_soc.genblk1.g_rom_ram_memory.u_ram.a_rdata_o[12];\u_pochoco_soc.genblk1.g_rom_ram_memory.u_ram.a_rdata_o[13];\u_pochoco_soc.genblk1.g_rom_ram_memory.u_ram.a_rdata_o[14];\u_pochoco_soc.genblk1.g_rom_ram_memory.u_ram.a_rdata_o[19];\u_pochoco_soc.genblk1.g_rom_ram_memory.u_ram.a_rdata_o[20];\u_pochoco_soc.genblk1.g_rom_ram_memory.u_ram.a_rdata_o[21];\u_pochoco_soc.genblk1.g_rom_ram_memory.u_ram.a_rdata_o[22];\u_pochoco_soc.genblk1.g_rom_ram_memory.u_ram.a_rdata_o[23];\u_pochoco_soc.genblk1.g_rom_ram_memory.u_ram.a_rdata_o[24];\u_pochoco_soc.genblk1.g_rom_ram_memory.u_ram.a_rdata_o[25];\u_pochoco_soc.genblk1.g_rom_ram_memory.u_ram.a_rdata_o[26];\u_pochoco_soc.genblk1.g_rom_ram_memory.u_ram.a_rdata_o[27];\u_pochoco_soc.genblk1.g_rom_ram_memory.u_ram.a_rdata_o[28];\u_pochoco_soc.genblk1.g_rom_ram_memory.u_ram.a_rdata_o[29];\u_pochoco_soc.genblk1.g_rom_ram_memory.u_ram.a_rdata_o[2];\u_pochoco_soc.genblk1.g_rom_ram_memory.u_ram.a_rdata_o[30];\u_pochoco_soc.genblk1.g_rom_ram_memory.u_ram.a_rdata_o[31];\u_pochoco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
slew | net200 | 11 | 3.906127 | 3.0 | -0.906127 | fanout200/Z:gf180mcu_fd_sc_mcu7t5v0__dlyb_1 | instruction/ROM/fetch+data-memory+peripheral | _7686_/A2 | \u_pochoco_soc.data_wdata[0];\u_pochoco_soc.data_wdata[1];\u_pochoco_soc.data_wdata[2];\u_pochoco_soc.data_wdata[3];\u_pochoco_soc.data_wdata[4];\u_pochoco_soc.data_wdata[5];\u_pochoco_soc.data_wdata[6];\u_pochoco_soc.data_wdata[7];\u_pochoco_soc.genblk1.g_rom_ram_memory.u_ram.a_addr_i[1];\u_pochoco_soc.genblk1.g_rom_ram_memory.u_ram.a_rdata_o[0];\u_pochoco_soc.genblk1.g_rom_ram_memory.u_ram.a_rdata_o[10];\u_pochoco_soc.genblk1.g_rom_ram_memory.u_ram.a_rdata_o[11];\u_pochoco_soc.genblk1.g_rom_ram_memory.u_ram.a_rdata_o[12];\u_pochoco_soc.genblk1.g_rom_ram_memory.u_ram.a_rdata_o[13];\u_pochoco_soc.genblk1.g_rom_ram_memory.u_ram.a_rdata_o[14];\u_pochoco_soc.genblk1.g_rom_ram_memory.u_ram.a_rdata_o[19];\u_pochoco_soc.genblk1.g_rom_ram_memory.u_ram.a_rdata_o[21];\u_pochoco_soc.genblk1.g_rom_ram_memory.u_ram.a_rdata_o[22];\u_pochoco_soc.genblk1.g_rom_ram_memory.u_ram.a_rdata_o[23];\u_pochoco_soc.genblk1.g_rom_ram_memory.u_ram.a_rdata_o[24];\u_pochoco_soc.genblk1.g_rom_ram_memory.u_ram.a_rdata_o[25];\u_pochoco_soc.genblk1.g_rom_ram_memory.u_ram.a_rdata_o[26];\u_pochoco_soc.genblk1.g_rom_ram_memory.u_ram.a_rdata_o[27];\u_pochoco_soc.genblk1.g_rom_ram_memory.u_ram.a_rdata_o[28];\u_pochoco_soc.genblk1.g_rom_ram_memory.u_ram.a_rdata_o[29];\u_pochoco_soc.genblk1.g_rom_ram_memory.u_ram.a_rdata_o[2];\u_pochoco_soc.genblk1.g_rom_ram_memory.u_ram.a_rdata_o[30];\u_pochoco_soc.genblk1.g_rom_ram_memory.u_ram.a_rdata_o[31];\u_pochoco_soc.genblk1.g_rom_ram_memory.u_ram.a_rdata_o[3];\u_pochoco_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
slew | net613 | 11 | 3.887934 | 3.0 | -0.887934 | fanout613/Z:gf180mcu_fd_sc_mcu7t5v0__dlyb_1 | other-combinational | _6417_/A1 | \u_pochoco_soc.genblk1.g_rom_ram_memory.u_ram.a_addr_i[2]
slew | net325 | 11 | 3.850399 | 3.0 | -0.850399 | fanout325/Z:gf180mcu_fd_sc_mcu7t5v0__dlyb_1 | instruction/ROM/fetch | _4366_/A1 | \u_pochoco_soc.genblk1.g_rom_ram_memory.u_ram.a_rdata_o[0];\u_pochoco_soc.genblk1.g_rom_ram_memory.u_ram.a_rdata_o[12];\u_pochoco_soc.genblk1.g_rom_ram_memory.u_ram.a_rdata_o[13];\u_pochoco_soc.genblk1.g_rom_ram_memory.u_ram.a_rdata_o[14];\u_pochoco_soc.genblk1.g_rom_ram_memory.u_ram.a_rdata_o[2];\u_pochoco_soc.genblk1.g_rom_ram_memory.u_ram.a_rdata_o[30];\u_pochoco_soc.genblk1.g_rom_ram_memory.u_ram.a_rdata_o[3];\u_pochoco_soc.genblk1.g_rom_ram_memory.u_ram.a_rdata_o[4];\u_pochoco_soc.genblk1.g_rom_ram_memory.u_ram.a_rdata_o[5];\u_pochoco_soc.genblk1.g_rom_ram_memory.u_ram.a_rdata_o[6]
slew | net454 | 11 | 3.817549 | 3.0 | -0.817549 | fanout454/Z:gf180mcu_fd_sc_mcu7t5v0__dlyb_1 | instruction/ROM/fetch | _4808_/B1 | \u_pochoco_soc.genblk1.g_rom_ram_memory.u_ram.a_rdata_o[0];\u_pochoco_soc.genblk1.g_rom_ram_memory.u_ram.a_rdata_o[2];\u_pochoco_soc.genblk1.g_rom_ram_memory.u_ram.a_rdata_o[3];\u_pochoco_soc.genblk1.g_rom_ram_memory.u_ram.a_rdata_o[4];\u_pochoco_soc.genblk1.g_rom_ram_memory.u_ram.a_rdata_o[5];\u_pochoco_soc.genblk1.g_rom_ram_memory.u_ram.a_rdata_o[6]
slew | net154 | 11 | 3.800243 | 3.0 | -0.800243 | fanout154/Z:gf180mcu_fd_sc_mcu7t5v0__dlyb_1 | instruction/ROM/fetch+data-memory+peripheral | _7828_/A2 | \u_pochoco_soc.data_wdata[0];\u_pochoco_soc.data_wdata[1];\u_pochoco_soc.data_wdata[3];\u_pochoco_soc.data_wdata[4];\u_pochoco_soc.data_wdata[5];\u_pochoco_soc.data_wdata[6];\u_pochoco_soc.data_wdata[7];\u_pochoco_soc.genblk1.g_rom_ram_memory.u_ram.a_addr_i[1];\u_pochoco_soc.genblk1.g_rom_ram_memory.u_ram.a_rdata_o[0];\u_pochoco_soc.genblk1.g_rom_ram_memory.u_ram.a_rdata_o[10];\u_pochoco_soc.genblk1.g_rom_ram_memory.u_ram.a_rdata_o[11];\u_pochoco_soc.genblk1.g_rom_ram_memory.u_ram.a_rdata_o[12];\u_pochoco_soc.genblk1.g_rom_ram_memory.u_ram.a_rdata_o[13];\u_pochoco_soc.genblk1.g_rom_ram_memory.u_ram.a_rdata_o[14];\u_pochoco_soc.genblk1.g_rom_ram_memory.u_ram.a_rdata_o[19];\u_pochoco_soc.genblk1.g_rom_ram_memory.u_ram.a_rdata_o[21];\u_pochoco_soc.genblk1.g_rom_ram_memory.u_ram.a_rdata_o[23];\u_pochoco_soc.genblk1.g_rom_ram_memory.u_ram.a_rdata_o[24];\u_pochoco_soc.genblk1.g_rom_ram_memory.u_ram.a_rdata_o[25];\u_pochoco_soc.genblk1.g_rom_ram_memory.u_ram.a_rdata_o[26];\u_pochoco_soc.genblk1.g_rom_ram_memory.u_ram.a_rdata_o[27];\u_pochoco_soc.genblk1.g_rom_ram_memory.u_ram.a_rdata_o[28];\u_pochoco_soc.genblk1.g_rom_ram_memory.u_ram.a_rdata_o[29];\u_pochoco_soc.genblk1.g_rom_ram_memory.u_ram.a_rdata_o[2];\u_pochoco_soc.genblk1.g_rom_ram_memory.u_ram.a_rdata_o[30];\u_pochoco_soc.genblk1.g_rom_ram_memory.u_ram.a_rdata_o[31];\u_pochoco_soc.genblk1.g_rom_ram_memory.u_ram.a_rdata_o[3];\u_pochoco_soc.genblk1.g_rom_ram_memory.u_ram.a_rdata_o[4];\u_pochoco_soc.genblk1.g_rom_ram_memory.u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
slew | net235 | 11 | 3.792891 | 3.0 | -0.792891 | fanout235/Z:gf180mcu_fd_sc_mcu7t5v0__dlyb_1 | instruction/ROM/fetch+data-memory+peripheral | _7813_/A1 | \u_pochoco_soc.data_wdata[0];\u_pochoco_soc.data_wdata[1];\u_pochoco_soc.data_wdata[2];\u_pochoco_soc.data_wdata[3];\u_pochoco_soc.data_wdata[4];\u_pochoco_soc.data_wdata[5];\u_pochoco_soc.data_wdata[6];\u_pochoco_soc.data_wdata[7];\u_pochoco_soc.genblk1.g_rom_ram_memory.u_ram.a_addr_i[1];\u_pochoco_soc.genblk1.g_rom_ram_memory.u_ram.a_rdata_o[0];\u_pochoco_soc.genblk1.g_rom_ram_memory.u_ram.a_rdata_o[10];\u_pochoco_soc.genblk1.g_rom_ram_memory.u_ram.a_rdata_o[11];\u_pochoco_soc.genblk1.g_rom_ram_memory.u_ram.a_rdata_o[12];\u_pochoco_soc.genblk1.g_rom_ram_memory.u_ram.a_rdata_o[13];\u_pochoco_soc.genblk1.g_rom_ram_memory.u_ram.a_rdata_o[14];\u_pochoco_soc.genblk1.g_rom_ram_memory.u_ram.a_rdata_o[19];\u_pochoco_soc.genblk1.g_rom_ram_memory.u_ram.a_rdata_o[21];\u_pochoco_soc.genblk1.g_rom_ram_memory.u_ram.a_rdata_o[22];\u_pochoco_soc.genblk1.g_rom_ram_memory.u_ram.a_rdata_o[23];\u_pochoco_soc.genblk1.g_rom_ram_memory.u_ram.a_rdata_o[24];\u_pochoco_soc.genblk1.g_rom_ram_memory.u_ram.a_rdata_o[25];\u_pochoco_soc.genblk1.g_rom_ram_memory.u_ram.a_rdata_o[26];\u_pochoco_soc.genblk1.g_rom_ram_memory.u_ram.a_rdata_o[27];\u_pochoco_soc.genblk1.g_rom_ram_memory.u_ram.a_rdata_o[28];\u_pochoco_soc.genblk1.g_rom_ram_memory.u_ram.a_rdata_o[29];\u_pochoco_soc.genblk1.g_rom_ram_memory.u_ram.a_rdata_o[2];\u_pochoco_soc.genblk1.g_rom_ram_memory.u_ram.a_rdata_o[30];\u_pochoco_soc.genblk1.g_rom_ram_memory.u_ram.a_rdata_o[31];\u_pochoco_soc.genblk1.g_rom_ram_memory.u_ram.a_rdata_o[3];\u_pochoco_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
slew | net533 | 11 | 3.772917 | 3.0 | -0.772917 | fanout533/Z:gf180mcu_fd_sc_mcu7t5v0__dlyb_1 | other-combinational | _6203_/A2 | \u_pochoco_soc.genblk1.g_rom_ram_memory.u_ram.a_addr_i[3];\u_pochoco_soc.genblk1.g_rom_ram_memory.u_ram.a_addr_i[4]
slew | net545 | 11 | 3.708892 | 3.0 | -0.708892 | fanout545/Z:gf180mcu_fd_sc_mcu7t5v0__dlyb_1 | other-combinational | _6629_/A1 | \u_pochoco_soc.genblk1.g_rom_ram_memory.u_ram.a_addr_i[4]
slew | net327 | 11 | 3.708783 | 3.0 | -0.708783 | fanout327/Z:gf180mcu_fd_sc_mcu7t5v0__dlyb_1 | instruction/ROM/fetch | _4479_/A1 | \u_pochoco_soc.genblk1.g_rom_ram_memory.u_ram.a_rdata_o[0];\u_pochoco_soc.genblk1.g_rom_ram_memory.u_ram.a_rdata_o[12];\u_pochoco_soc.genblk1.g_rom_ram_memory.u_ram.a_rdata_o[13];\u_pochoco_soc.genblk1.g_rom_ram_memory.u_ram.a_rdata_o[14];\u_pochoco_soc.genblk1.g_rom_ram_memory.u_ram.a_rdata_o[2];\u_pochoco_soc.genblk1.g_rom_ram_memory.u_ram.a_rdata_o[30];\u_pochoco_soc.genblk1.g_rom_ram_memory.u_ram.a_rdata_o[3];\u_pochoco_soc.genblk1.g_rom_ram_memory.u_ram.a_rdata_o[4];\u_pochoco_soc.genblk1.g_rom_ram_memory.u_ram.a_rdata_o[5];\u_pochoco_soc.genblk1.g_rom_ram_memory.u_ram.a_rdata_o[6]
slew | net508 | 11 | 3.684378 | 3.0 | -0.684378 | fanout508/Z:gf180mcu_fd_sc_mcu7t5v0__dlyb_1 | instruction/ROM/fetch | _5190_/B | \u_pochoco_soc.genblk1.g_rom_ram_memory.u_ram.a_rdata_o[21];\u_pochoco_soc.genblk1.g_rom_ram_memory.u_ram.a_rdata_o[22];\u_pochoco_soc.genblk1.g_rom_ram_memory.u_ram.a_rdata_o[23]
slew | net110 | 11 | 3.679445 | 3.0 | -0.679445 | _8057_/S:gf180mcu_fd_sc_mcu7t5v0__mux2_2;_8058_/S:gf180mcu_fd_sc_mcu7t5v0__mux2_2;_8072_/S:gf180mcu_fd_sc_mcu7t5v0__mux2_2;_8073_/S:gf180mcu_fd_sc_mcu7t5v0__mux2_2;_8074_/S:gf180mcu_fd_sc_mcu7t5v0__mux2_2;_8077_/S:gf180mcu_fd_sc_mcu7t5v0__mux2_2;_8078_/S:gf180mcu_fd_sc_mcu7t5v0__mux2_2;_8079_/S:gf180mcu_fd_sc_mcu7t5v0__mux2_2;fanout110/Z:gf180mcu_fd_sc_mcu7t5v0__dlyb_1 | reset+instruction/ROM/fetch+data-memory+peripheral | _8078_/S | \u_pochoco_soc.data_wdata[0];\u_pochoco_soc.data_wdata[1];\u_pochoco_soc.data_wdata[2];\u_pochoco_soc.data_wdata[3];\u_pochoco_soc.data_wdata[4];\u_pochoco_soc.data_wdata[5];\u_pochoco_soc.data_wdata[6];\u_pochoco_soc.data_wdata[7];\u_pochoco_soc.genblk1.g_rom_ram_memory.u_ram.a_rdata_o[0];\u_pochoco_soc.genblk1.g_rom_ram_memory.u_ram.a_rdata_o[10];\u_pochoco_soc.genblk1.g_rom_ram_memory.u_ram.a_rdata_o[11];\u_pochoco_soc.genblk1.g_rom_ram_memory.u_ram.a_rdata_o[12];\u_pochoco_soc.genblk1.g_rom_ram_memory.u_ram.a_rdata_o[13];\u_pochoco_soc.genblk1.g_rom_ram_memory.u_ram.a_rdata_o[14];\u_pochoco_soc.genblk1.g_rom_ram_memory.u_ram.a_rdata_o[16];\u_pochoco_soc.genblk1.g_rom_ram_memory.u_ram.a_rdata_o[19];\u_pochoco_soc.genblk1.g_rom_ram_memory.u_ram.a_rdata_o[21];\u_pochoco_soc.genblk1.g_rom_ram_memory.u_ram.a_rdata_o[22];\u_pochoco_soc.genblk1.g_rom_ram_memory.u_ram.a_rdata_o[23];\u_pochoco_soc.genblk1.g_rom_ram_memory.u_ram.a_rdata_o[24];\u_pochoco_soc.genblk1.g_rom_ram_memory.u_ram.a_rdata_o[25];\u_pochoco_soc.genblk1.g_rom_ram_memory.u_ram.a_rdata_o[26];\u_pochoco_soc.genblk1.g_rom_ram_memory.u_ram.a_rdata_o[27];\u_pochoco_soc.genblk1.g_rom_ram_memory.u_ram.a_rdata_o[28];\u_pochoco_soc.genblk1.g_rom_ram_memory.u_ram.a_rdata_o[2];\u_pochoco_soc.genblk1.g_rom_ram_memory.u_ram.a_rdata_o[30];\u_pochoco_soc.genblk1.g_rom_ram_memory.u_ram.a_rdata_o[31];\u_pochoco_soc.genblk1.g_rom_ram_memory.u_ram.a_rdata_o[3];\u_pochoco_soc.genblk1.g_rom_ram_memory.u_ram.a_rdata_o[4];\u_pochoco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
slew | net247 | 11 | 3.650686 | 3.0 | -0.650686 | _7200_/S:gf180mcu_fd_sc_mcu7t5v0__mux2_2;_7203_/S:gf180mcu_fd_sc_mcu7t5v0__mux2_2;fanout247/Z:gf180mcu_fd_sc_mcu7t5v0__dlyb_1 | instruction/ROM/fetch+data-memory+peripheral | _7203_/S | \u_pochoco_soc.data_wdata[0];\u_pochoco_soc.data_wdata[1];\u_pochoco_soc.data_wdata[2];\u_pochoco_soc.data_wdata[3];\u_pochoco_soc.data_wdata[4];\u_pochoco_soc.data_wdata[5];\u_pochoco_soc.data_wdata[6];\u_pochoco_soc.data_wdata[7];\u_pochoco_soc.genblk1.g_rom_ram_memory.u_ram.a_addr_i[1];\u_pochoco_soc.genblk1.g_rom_ram_memory.u_ram.a_rdata_o[0];\u_pochoco_soc.genblk1.g_rom_ram_memory.u_ram.a_rdata_o[10];\u_pochoco_soc.genblk1.g_rom_ram_memory.u_ram.a_rdata_o[11];\u_pochoco_soc.genblk1.g_rom_ram_memory.u_ram.a_rdata_o[12];\u_pochoco_soc.genblk1.g_rom_ram_memory.u_ram.a_rdata_o[13];\u_pochoco_soc.genblk1.g_rom_ram_memory.u_ram.a_rdata_o[14];\u_pochoco_soc.genblk1.g_rom_ram_memory.u_ram.a_rdata_o[19];\u_pochoco_soc.genblk1.g_rom_ram_memory.u_ram.a_rdata_o[20];\u_pochoco_soc.genblk1.g_rom_ram_memory.u_ram.a_rdata_o[21];\u_pochoco_soc.genblk1.g_rom_ram_memory.u_ram.a_rdata_o[22];\u_pochoco_soc.genblk1.g_rom_ram_memory.u_ram.a_rdata_o[23];\u_pochoco_soc.genblk1.g_rom_ram_memory.u_ram.a_rdata_o[24];\u_pochoco_soc.genblk1.g_rom_ram_memory.u_ram.a_rdata_o[25];\u_pochoco_soc.genblk1.g_rom_ram_memory.u_ram.a_rdata_o[26];\u_pochoco_soc.genblk1.g_rom_ram_memory.u_ram.a_rdata_o[27];\u_pochoco_soc.genblk1.g_rom_ram_memory.u_ram.a_rdata_o[28];\u_pochoco_soc.genblk1.g_rom_ram_memory.u_ram.a_rdata_o[29];\u_pochoco_soc.genblk1.g_rom_ram_memory.u_ram.a_rdata_o[2];\u_pochoco_soc.genblk1.g_rom_ram_memory.u_ram.a_rdata_o[30];\u_pochoco_soc.genblk1.g_rom_ram_memory.u_ram.a_rdata_o[31];\u_pochoco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
slew | net104 | 11 | 3.59513 | 3.0 | -0.59513 | _5888_/S:gf180mcu_fd_sc_mcu7t5v0__mux2_2;_5959_/S:gf180mcu_fd_sc_mcu7t5v0__mux2_2;_6009_/S:gf180mcu_fd_sc_mcu7t5v0__mux2_2;fanout104/Z:gf180mcu_fd_sc_mcu7t5v0__dlyb_1 | instruction/ROM/fetch+data-memory+peripheral | _6014_/B | \u_pochoco_soc.data_wdata[0];\u_pochoco_soc.data_wdata[1];\u_pochoco_soc.data_wdata[2];\u_pochoco_soc.data_wdata[3];\u_pochoco_soc.data_wdata[4];\u_pochoco_soc.data_wdata[5];\u_pochoco_soc.data_wdata[6];\u_pochoco_soc.data_wdata[7];\u_pochoco_soc.genblk1.g_rom_ram_memory.u_ram.a_addr_i[10];\u_pochoco_soc.genblk1.g_rom_ram_memory.u_ram.a_addr_i[11];\u_pochoco_soc.genblk1.g_rom_ram_memory.u_ram.a_addr_i[12];\u_pochoco_soc.genblk1.g_rom_ram_memory.u_ram.a_addr_i[13];\u_pochoco_soc.genblk1.g_rom_ram_memory.u_ram.a_addr_i[14];\u_pochoco_soc.genblk1.g_rom_ram_memory.u_ram.a_addr_i[15];\u_pochoco_soc.genblk1.g_rom_ram_memory.u_ram.a_addr_i[16];\u_pochoco_soc.genblk1.g_rom_ram_memory.u_ram.a_addr_i[17];\u_pochoco_soc.genblk1.g_rom_ram_memory.u_ram.a_addr_i[18];\u_pochoco_soc.genblk1.g_rom_ram_memory.u_ram.a_addr_i[19];\u_pochoco_soc.genblk1.g_rom_ram_memory.u_ram.a_addr_i[1];\u_pochoco_soc.genblk1.g_rom_ram_memory.u_ram.a_addr_i[20];\u_pochoco_soc.genblk1.g_rom_ram_memory.u_ram.a_addr_i[21];\u_pochoco_soc.genblk1.g_rom_ram_memory.u_ram.a_addr_i[22];\u_pochoco_soc.genblk1.g_rom_ram_memory.u_ram.a_addr_i[2];\u_pochoco_soc.genblk1.g_rom_ram_memory.u_ram.a_addr_i[3];\u_pochoco_soc.genblk1.g_rom_ram_memory.u_ram.a_addr_i[4];\u_pochoco_soc.genblk1.g_rom_ram_memory.u_ram.a_addr_i[5];\u_pochoco_soc.genblk1.g_rom_ram_memory.u_ram.a_addr_i[6];\u_pochoco_soc.genblk1.g_rom_ram_memory.u_ram.a_addr_i[7];\u_pochoco_soc.genblk1.g_rom_ram_memory.u_ram.a_addr_i[8];\u_pochoco_soc.genblk1.g_rom_ram_me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
slew | net165 | 11 | 3.591777 | 3.0 | -0.591777 | _7248_/S:gf180mcu_fd_sc_mcu7t5v0__mux2_2;fanout165/Z:gf180mcu_fd_sc_mcu7t5v0__dlyb_1 | instruction/ROM/fetch+data-memory+peripheral | _7498_/A2 | \u_pochoco_soc.data_wdata[0];\u_pochoco_soc.data_wdata[1];\u_pochoco_soc.data_wdata[2];\u_pochoco_soc.data_wdata[3];\u_pochoco_soc.data_wdata[4];\u_pochoco_soc.data_wdata[5];\u_pochoco_soc.data_wdata[6];\u_pochoco_soc.data_wdata[7];\u_pochoco_soc.genblk1.g_rom_ram_memory.u_ram.a_addr_i[1];\u_pochoco_soc.genblk1.g_rom_ram_memory.u_ram.a_rdata_o[0];\u_pochoco_soc.genblk1.g_rom_ram_memory.u_ram.a_rdata_o[10];\u_pochoco_soc.genblk1.g_rom_ram_memory.u_ram.a_rdata_o[11];\u_pochoco_soc.genblk1.g_rom_ram_memory.u_ram.a_rdata_o[12];\u_pochoco_soc.genblk1.g_rom_ram_memory.u_ram.a_rdata_o[13];\u_pochoco_soc.genblk1.g_rom_ram_memory.u_ram.a_rdata_o[14];\u_pochoco_soc.genblk1.g_rom_ram_memory.u_ram.a_rdata_o[19];\u_pochoco_soc.genblk1.g_rom_ram_memory.u_ram.a_rdata_o[20];\u_pochoco_soc.genblk1.g_rom_ram_memory.u_ram.a_rdata_o[21];\u_pochoco_soc.genblk1.g_rom_ram_memory.u_ram.a_rdata_o[22];\u_pochoco_soc.genblk1.g_rom_ram_memory.u_ram.a_rdata_o[23];\u_pochoco_soc.genblk1.g_rom_ram_memory.u_ram.a_rdata_o[24];\u_pochoco_soc.genblk1.g_rom_ram_memory.u_ram.a_rdata_o[25];\u_pochoco_soc.genblk1.g_rom_ram_memory.u_ram.a_rdata_o[26];\u_pochoco_soc.genblk1.g_rom_ram_memory.u_ram.a_rdata_o[27];\u_pochoco_soc.genblk1.g_rom_ram_memory.u_ram.a_rdata_o[28];\u_pochoco_soc.genblk1.g_rom_ram_memory.u_ram.a_rdata_o[29];\u_pochoco_soc.genblk1.g_rom_ram_memory.u_ram.a_rdata_o[2];\u_pochoco_soc.genblk1.g_rom_ram_memory.u_ram.a_rdata_o[30];\u_pochoco_soc.genblk1.g_rom_ram_memory.u_ram.a_rdata_o[31];\u_pochoco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
slew | net684 | 11 | 3.562671 | 3.0 | -0.562671 | fanout684/Z:gf180mcu_fd_sc_mcu7t5v0__dlyb_1 | reset | _8270_/RN | rst_ni
slew | net249 | 11 | 3.537837 | 3.0 | -0.537837 | fanout249/Z:gf180mcu_fd_sc_mcu7t5v0__dlyb_1 | instruction/ROM/fetch+data-memory+peripheral | _7708_/A2 | \u_pochoco_soc.data_wdata[0];\u_pochoco_soc.data_wdata[1];\u_pochoco_soc.data_wdata[3];\u_pochoco_soc.data_wdata[4];\u_pochoco_soc.data_wdata[5];\u_pochoco_soc.data_wdata[6];\u_pochoco_soc.data_wdata[7];\u_pochoco_soc.genblk1.g_rom_ram_memory.u_ram.a_addr_i[1];\u_pochoco_soc.genblk1.g_rom_ram_memory.u_ram.a_rdata_o[0];\u_pochoco_soc.genblk1.g_rom_ram_memory.u_ram.a_rdata_o[10];\u_pochoco_soc.genblk1.g_rom_ram_memory.u_ram.a_rdata_o[11];\u_pochoco_soc.genblk1.g_rom_ram_memory.u_ram.a_rdata_o[12];\u_pochoco_soc.genblk1.g_rom_ram_memory.u_ram.a_rdata_o[13];\u_pochoco_soc.genblk1.g_rom_ram_memory.u_ram.a_rdata_o[14];\u_pochoco_soc.genblk1.g_rom_ram_memory.u_ram.a_rdata_o[19];\u_pochoco_soc.genblk1.g_rom_ram_memory.u_ram.a_rdata_o[21];\u_pochoco_soc.genblk1.g_rom_ram_memory.u_ram.a_rdata_o[23];\u_pochoco_soc.genblk1.g_rom_ram_memory.u_ram.a_rdata_o[24];\u_pochoco_soc.genblk1.g_rom_ram_memory.u_ram.a_rdata_o[25];\u_pochoco_soc.genblk1.g_rom_ram_memory.u_ram.a_rdata_o[26];\u_pochoco_soc.genblk1.g_rom_ram_memory.u_ram.a_rdata_o[27];\u_pochoco_soc.genblk1.g_rom_ram_memory.u_ram.a_rdata_o[28];\u_pochoco_soc.genblk1.g_rom_ram_memory.u_ram.a_rdata_o[29];\u_pochoco_soc.genblk1.g_rom_ram_memory.u_ram.a_rdata_o[2];\u_pochoco_soc.genblk1.g_rom_ram_memory.u_ram.a_rdata_o[30];\u_pochoco_soc.genblk1.g_rom_ram_memory.u_ram.a_rdata_o[31];\u_pochoco_soc.genblk1.g_rom_ram_memory.u_ram.a_rdata_o[3];\u_pochoco_soc.genblk1.g_rom_ram_memory.u_ram.a_rdata_o[4];\u_pochoco_soc.genblk1.g_rom_ram_memory.u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
slew | net176 | 11 | 3.519797 | 3.0 | -0.519797 | fanout176/Z:gf180mcu_fd_sc_mcu7t5v0__dlyb_1 | instruction/ROM/fetch+data-memory+peripheral | _7484_/A2 | \u_pochoco_soc.data_wdata[0];\u_pochoco_soc.data_wdata[1];\u_pochoco_soc.data_wdata[3];\u_pochoco_soc.data_wdata[4];\u_pochoco_soc.data_wdata[5];\u_pochoco_soc.data_wdata[6];\u_pochoco_soc.data_wdata[7];\u_pochoco_soc.genblk1.g_rom_ram_memory.u_ram.a_addr_i[1];\u_pochoco_soc.genblk1.g_rom_ram_memory.u_ram.a_rdata_o[0];\u_pochoco_soc.genblk1.g_rom_ram_memory.u_ram.a_rdata_o[10];\u_pochoco_soc.genblk1.g_rom_ram_memory.u_ram.a_rdata_o[11];\u_pochoco_soc.genblk1.g_rom_ram_memory.u_ram.a_rdata_o[12];\u_pochoco_soc.genblk1.g_rom_ram_memory.u_ram.a_rdata_o[13];\u_pochoco_soc.genblk1.g_rom_ram_memory.u_ram.a_rdata_o[14];\u_pochoco_soc.genblk1.g_rom_ram_memory.u_ram.a_rdata_o[19];\u_pochoco_soc.genblk1.g_rom_ram_memory.u_ram.a_rdata_o[21];\u_pochoco_soc.genblk1.g_rom_ram_memory.u_ram.a_rdata_o[23];\u_pochoco_soc.genblk1.g_rom_ram_memory.u_ram.a_rdata_o[24];\u_pochoco_soc.genblk1.g_rom_ram_memory.u_ram.a_rdata_o[25];\u_pochoco_soc.genblk1.g_rom_ram_memory.u_ram.a_rdata_o[26];\u_pochoco_soc.genblk1.g_rom_ram_memory.u_ram.a_rdata_o[27];\u_pochoco_soc.genblk1.g_rom_ram_memory.u_ram.a_rdata_o[28];\u_pochoco_soc.genblk1.g_rom_ram_memory.u_ram.a_rdata_o[29];\u_pochoco_soc.genblk1.g_rom_ram_memory.u_ram.a_rdata_o[2];\u_pochoco_soc.genblk1.g_rom_ram_memory.u_ram.a_rdata_o[30];\u_pochoco_soc.genblk1.g_rom_ram_memory.u_ram.a_rdata_o[31];\u_pochoco_soc.genblk1.g_rom_ram_memory.u_ram.a_rdata_o[3];\u_pochoco_soc.genblk1.g_rom_ram_memory.u_ram.a_rdata_o[4];\u_pochoco_soc.genblk1.g_rom_ram_memory.u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
slew | net157 | 11 | 3.51345 | 3.0 | -0.51345 | _7254_/S:gf180mcu_fd_sc_mcu7t5v0__mux2_2;_7257_/S:gf180mcu_fd_sc_mcu7t5v0__mux2_2;fanout157/Z:gf180mcu_fd_sc_mcu7t5v0__dlyb_1 | instruction/ROM/fetch+data-memory+peripheral | _7511_/A1 | \u_pochoco_soc.data_wdata[0];\u_pochoco_soc.data_wdata[1];\u_pochoco_soc.data_wdata[2];\u_pochoco_soc.data_wdata[3];\u_pochoco_soc.data_wdata[4];\u_pochoco_soc.data_wdata[5];\u_pochoco_soc.data_wdata[6];\u_pochoco_soc.data_wdata[7];\u_pochoco_soc.genblk1.g_rom_ram_memory.u_ram.a_addr_i[1];\u_pochoco_soc.genblk1.g_rom_ram_memory.u_ram.a_rdata_o[0];\u_pochoco_soc.genblk1.g_rom_ram_memory.u_ram.a_rdata_o[10];\u_pochoco_soc.genblk1.g_rom_ram_memory.u_ram.a_rdata_o[11];\u_pochoco_soc.genblk1.g_rom_ram_memory.u_ram.a_rdata_o[12];\u_pochoco_soc.genblk1.g_rom_ram_memory.u_ram.a_rdata_o[13];\u_pochoco_soc.genblk1.g_rom_ram_memory.u_ram.a_rdata_o[14];\u_pochoco_soc.genblk1.g_rom_ram_memory.u_ram.a_rdata_o[19];\u_pochoco_soc.genblk1.g_rom_ram_memory.u_ram.a_rdata_o[20];\u_pochoco_soc.genblk1.g_rom_ram_memory.u_ram.a_rdata_o[21];\u_pochoco_soc.genblk1.g_rom_ram_memory.u_ram.a_rdata_o[22];\u_pochoco_soc.genblk1.g_rom_ram_memory.u_ram.a_rdata_o[23];\u_pochoco_soc.genblk1.g_rom_ram_memory.u_ram.a_rdata_o[24];\u_pochoco_soc.genblk1.g_rom_ram_memory.u_ram.a_rdata_o[25];\u_pochoco_soc.genblk1.g_rom_ram_memory.u_ram.a_rdata_o[26];\u_pochoco_soc.genblk1.g_rom_ram_memory.u_ram.a_rdata_o[27];\u_pochoco_soc.genblk1.g_rom_ram_memory.u_ram.a_rdata_o[28];\u_pochoco_soc.genblk1.g_rom_ram_memory.u_ram.a_rdata_o[29];\u_pochoco_soc.genblk1.g_rom_ram_memory.u_ram.a_rdata_o[2];\u_pochoco_soc.genblk1.g_rom_ram_memory.u_ram.a_rdata_o[30];\u_pochoco_soc.genblk1.g_rom_ram_memory.u_ram.a_rdata_o[31];\u_pochoco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
slew | net471 | 11 | 3.507043 | 3.0 | -0.507043 | fanout471/Z:gf180mcu_fd_sc_mcu7t5v0__dlyb_1 | other-combinational | _6475_/A1 | \u_pochoco_soc.genblk1.g_rom_ram_memory.u_ram.a_addr_i[3];\u_pochoco_soc.genblk1.g_rom_ram_memory.u_ram.a_addr_i[5]
slew | net521 | 11 | 3.464813 | 3.0 | -0.464814 | fanout521/Z:gf180mcu_fd_sc_mcu7t5v0__dlyb_1 | instruction/ROM/fetch | _7144_/A1 | \u_pochoco_soc.genblk1.g_rom_ram_memory.u_ram.a_rdata_o[0];\u_pochoco_soc.genblk1.g_rom_ram_memory.u_ram.a_rdata_o[2];\u_pochoco_soc.genblk1.g_rom_ram_memory.u_ram.a_rdata_o[4];\u_pochoco_soc.genblk1.g_rom_ram_memory.u_ram.a_rdata_o[5];\u_pochoco_soc.genblk1.g_rom_ram_memory.u_ram.a_rdata_o[6]
slew | net317 | 11 | 3.441213 | 3.0 | -0.441213 | fanout317/Z:gf180mcu_fd_sc_mcu7t5v0__dlyb_1 | instruction/ROM/fetch | _4770_/A1 | \u_pochoco_soc.genblk1.g_rom_ram_memory.u_ram.a_rdata_o[0];\u_pochoco_soc.genblk1.g_rom_ram_memory.u_ram.a_rdata_o[12];\u_pochoco_soc.genblk1.g_rom_ram_memory.u_ram.a_rdata_o[13];\u_pochoco_soc.genblk1.g_rom_ram_memory.u_ram.a_rdata_o[14];\u_pochoco_soc.genblk1.g_rom_ram_memory.u_ram.a_rdata_o[2];\u_pochoco_soc.genblk1.g_rom_ram_memory.u_ram.a_rdata_o[30];\u_pochoco_soc.genblk1.g_rom_ram_memory.u_ram.a_rdata_o[3];\u_pochoco_soc.genblk1.g_rom_ram_memory.u_ram.a_rdata_o[4];\u_pochoco_soc.genblk1.g_rom_ram_memory.u_ram.a_rdata_o[5];\u_pochoco_soc.genblk1.g_rom_ram_memory.u_ram.a_rdata_o[6]
slew | net236 | 11 | 3.436377 | 3.0 | -0.436377 | _7056_/S:gf180mcu_fd_sc_mcu7t5v0__mux2_2;fanout236/Z:gf180mcu_fd_sc_mcu7t5v0__dlyb_1 | instruction/ROM/fetch+data-memory+peripheral | _7536_/A2 | \u_pochoco_soc.data_wdata[0];\u_pochoco_soc.data_wdata[1];\u_pochoco_soc.data_wdata[2];\u_pochoco_soc.data_wdata[3];\u_pochoco_soc.data_wdata[4];\u_pochoco_soc.data_wdata[5];\u_pochoco_soc.data_wdata[6];\u_pochoco_soc.data_wdata[7];\u_pochoco_soc.genblk1.g_rom_ram_memory.u_ram.a_addr_i[1];\u_pochoco_soc.genblk1.g_rom_ram_memory.u_ram.a_rdata_o[0];\u_pochoco_soc.genblk1.g_rom_ram_memory.u_ram.a_rdata_o[10];\u_pochoco_soc.genblk1.g_rom_ram_memory.u_ram.a_rdata_o[11];\u_pochoco_soc.genblk1.g_rom_ram_memory.u_ram.a_rdata_o[12];\u_pochoco_soc.genblk1.g_rom_ram_memory.u_ram.a_rdata_o[13];\u_pochoco_soc.genblk1.g_rom_ram_memory.u_ram.a_rdata_o[14];\u_pochoco_soc.genblk1.g_rom_ram_memory.u_ram.a_rdata_o[19];\u_pochoco_soc.genblk1.g_rom_ram_memory.u_ram.a_rdata_o[20];\u_pochoco_soc.genblk1.g_rom_ram_memory.u_ram.a_rdata_o[21];\u_pochoco_soc.genblk1.g_rom_ram_memory.u_ram.a_rdata_o[22];\u_pochoco_soc.genblk1.g_rom_ram_memory.u_ram.a_rdata_o[23];\u_pochoco_soc.genblk1.g_rom_ram_memory.u_ram.a_rdata_o[24];\u_pochoco_soc.genblk1.g_rom_ram_memory.u_ram.a_rdata_o[25];\u_pochoco_soc.genblk1.g_rom_ram_memory.u_ram.a_rdata_o[26];\u_pochoco_soc.genblk1.g_rom_ram_memory.u_ram.a_rdata_o[27];\u_pochoco_soc.genblk1.g_rom_ram_memory.u_ram.a_rdata_o[28];\u_pochoco_soc.genblk1.g_rom_ram_memory.u_ram.a_rdata_o[29];\u_pochoco_soc.genblk1.g_rom_ram_memory.u_ram.a_rdata_o[2];\u_pochoco_soc.genblk1.g_rom_ram_memory.u_ram.a_rdata_o[30];\u_pochoco_soc.genblk1.g_rom_ram_memory.u_ram.a_rdata_o[31];\u_pochoco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
slew | net477 | 11 | 3.421614 | 3.0 | -0.421614 | fanout477/Z:gf180mcu_fd_sc_mcu7t5v0__dlyb_1 | other-combinational | _6208_/A1 | \u_pochoco_soc.genblk1.g_rom_ram_memory.u_ram.a_addr_i[2];\u_pochoco_soc.genblk1.g_rom_ram_memory.u_ram.a_addr_i[4]
slew | net687 | 11 | 3.421017 | 3.0 | -0.421017 | fanout687/Z:gf180mcu_fd_sc_mcu7t5v0__dlyb_1 | reset | _8281_/RN | rst_ni
slew | net232 | 11 | 3.40624 | 3.0 | -0.406241 | _7263_/S:gf180mcu_fd_sc_mcu7t5v0__mux2_2;_7264_/S:gf180mcu_fd_sc_mcu7t5v0__mux2_2;fanout232/Z:gf180mcu_fd_sc_mcu7t5v0__dlyb_1 | instruction/ROM/fetch+data-memory+peripheral | _7529_/A1 | \u_pochoco_soc.data_wdata[0];\u_pochoco_soc.data_wdata[1];\u_pochoco_soc.data_wdata[2];\u_pochoco_soc.data_wdata[3];\u_pochoco_soc.data_wdata[4];\u_pochoco_soc.data_wdata[5];\u_pochoco_soc.data_wdata[6];\u_pochoco_soc.data_wdata[7];\u_pochoco_soc.genblk1.g_rom_ram_memory.u_ram.a_addr_i[1];\u_pochoco_soc.genblk1.g_rom_ram_memory.u_ram.a_rdata_o[0];\u_pochoco_soc.genblk1.g_rom_ram_memory.u_ram.a_rdata_o[10];\u_pochoco_soc.genblk1.g_rom_ram_memory.u_ram.a_rdata_o[11];\u_pochoco_soc.genblk1.g_rom_ram_memory.u_ram.a_rdata_o[12];\u_pochoco_soc.genblk1.g_rom_ram_memory.u_ram.a_rdata_o[13];\u_pochoco_soc.genblk1.g_rom_ram_memory.u_ram.a_rdata_o[14];\u_pochoco_soc.genblk1.g_rom_ram_memory.u_ram.a_rdata_o[19];\u_pochoco_soc.genblk1.g_rom_ram_memory.u_ram.a_rdata_o[20];\u_pochoco_soc.genblk1.g_rom_ram_memory.u_ram.a_rdata_o[21];\u_pochoco_soc.genblk1.g_rom_ram_memory.u_ram.a_rdata_o[22];\u_pochoco_soc.genblk1.g_rom_ram_memory.u_ram.a_rdata_o[23];\u_pochoco_soc.genblk1.g_rom_ram_memory.u_ram.a_rdata_o[24];\u_pochoco_soc.genblk1.g_rom_ram_memory.u_ram.a_rdata_o[25];\u_pochoco_soc.genblk1.g_rom_ram_memory.u_ram.a_rdata_o[26];\u_pochoco_soc.genblk1.g_rom_ram_memory.u_ram.a_rdata_o[27];\u_pochoco_soc.genblk1.g_rom_ram_memory.u_ram.a_rdata_o[28];\u_pochoco_soc.genblk1.g_rom_ram_memory.u_ram.a_rdata_o[29];\u_pochoco_soc.genblk1.g_rom_ram_memory.u_ram.a_rdata_o[2];\u_pochoco_soc.genblk1.g_rom_ram_memory.u_ram.a_rdata_o[30];\u_pochoco_soc.genblk1.g_rom_ram_memory.u_ram.a_rdata_o[31];\u_pochoco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
slew | net537 | 11 | 3.394607 | 3.0 | -0.394607 | fanout537/Z:gf180mcu_fd_sc_mcu7t5v0__dlyb_1 | other-combinational | _6295_/A1 | \u_pochoco_soc.genblk1.g_rom_ram_memory.u_ram.a_addr_i[7]
slew | net312 | 11 | 3.390479 | 3.0 | -0.390479 | fanout312/Z:gf180mcu_fd_sc_mcu7t5v0__dlyb_1 | instruction/ROM/fetch | _4625_/A1 | \u_pochoco_soc.genblk1.g_rom_ram_memory.u_ram.a_rdata_o[0];\u_pochoco_soc.genblk1.g_rom_ram_memory.u_ram.a_rdata_o[12];\u_pochoco_soc.genblk1.g_rom_ram_memory.u_ram.a_rdata_o[13];\u_pochoco_soc.genblk1.g_rom_ram_memory.u_ram.a_rdata_o[14];\u_pochoco_soc.genblk1.g_rom_ram_memory.u_ram.a_rdata_o[2];\u_pochoco_soc.genblk1.g_rom_ram_memory.u_ram.a_rdata_o[30];\u_pochoco_soc.genblk1.g_rom_ram_memory.u_ram.a_rdata_o[3];\u_pochoco_soc.genblk1.g_rom_ram_memory.u_ram.a_rdata_o[4];\u_pochoco_soc.genblk1.g_rom_ram_memory.u_ram.a_rdata_o[5];\u_pochoco_soc.genblk1.g_rom_ram_memory.u_ram.a_rdata_o[6]
slew | net694 | 11 | 3.381884 | 3.0 | -0.381884 | fanout694/Z:gf180mcu_fd_sc_mcu7t5v0__dlyb_1 | reset | _8323_/RN | rst_ni
slew | net579 | 11 | 3.379714 | 3.0 | -0.379714 | fanout579/Z:gf180mcu_fd_sc_mcu7t5v0__dlyb_1 | other-combinational | _6666_/A1 | \u_pochoco_soc.genblk1.g_rom_ram_memory.u_ram.a_addr_i[8]
slew | net168 | 11 | 3.363193 | 3.0 | -0.363193 | fanout168/Z:gf180mcu_fd_sc_mcu7t5v0__dlyb_1 | instruction/ROM/fetch | _7777_/A1 | \u_pochoco_soc.genblk1.g_rom_ram_memory.u_ram.a_addr_i[1];\u_pochoco_soc.genblk1.g_rom_ram_memory.u_ram.a_rdata_o[0];\u_pochoco_soc.genblk1.g_rom_ram_memory.u_ram.a_rdata_o[10];\u_pochoco_soc.genblk1.g_rom_ram_memory.u_ram.a_rdata_o[11];\u_pochoco_soc.genblk1.g_rom_ram_memory.u_ram.a_rdata_o[12];\u_pochoco_soc.genblk1.g_rom_ram_memory.u_ram.a_rdata_o[13];\u_pochoco_soc.genblk1.g_rom_ram_memory.u_ram.a_rdata_o[14];\u_pochoco_soc.genblk1.g_rom_ram_memory.u_ram.a_rdata_o[19];\u_pochoco_soc.genblk1.g_rom_ram_memory.u_ram.a_rdata_o[24];\u_pochoco_soc.genblk1.g_rom_ram_memory.u_ram.a_rdata_o[25];\u_pochoco_soc.genblk1.g_rom_ram_memory.u_ram.a_rdata_o[26];\u_pochoco_soc.genblk1.g_rom_ram_memory.u_ram.a_rdata_o[27];\u_pochoco_soc.genblk1.g_rom_ram_memory.u_ram.a_rdata_o[28];\u_pochoco_soc.genblk1.g_rom_ram_memory.u_ram.a_rdata_o[29];\u_pochoco_soc.genblk1.g_rom_ram_memory.u_ram.a_rdata_o[2];\u_pochoco_soc.genblk1.g_rom_ram_memory.u_ram.a_rdata_o[30];\u_pochoco_soc.genblk1.g_rom_ram_memory.u_ram.a_rdata_o[31];\u_pochoco_soc.genblk1.g_rom_ram_memory.u_ram.a_rdata_o[3];\u_pochoco_soc.genblk1.g_rom_ram_memory.u_ram.a_rdata_o[4];\u_pochoco_soc.genblk1.g_rom_ram_memory.u_ram.a_rdata_o[5];\u_pochoco_soc.genblk1.g_rom_ram_memory.u_ram.a_rdata_o[6];\u_pochoco_soc.genblk1.g_rom_ram_memory.u_ram.a_rdata_o[7];\u_pochoco_soc.genblk1.g_rom_ram_memory.u_ram.a_rdata_o[8];\u_pochoco_soc.genblk1.g_rom_ram_memory.u_ram.a_rdata_o[9];\u_pochoco_soc.u_core.instr_valid_id;\u_pochoco_soc.u_core.lsu_busy;\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
slew | net302 | 11 | 3.360396 | 3.0 | -0.360396 | fanout302/Z:gf180mcu_fd_sc_mcu7t5v0__dlyb_1 | instruction/ROM/fetch | _4765_/B | \u_pochoco_soc.genblk1.g_rom_ram_memory.u_ram.a_rdata_o[0];\u_pochoco_soc.genblk1.g_rom_ram_memory.u_ram.a_rdata_o[12];\u_pochoco_soc.genblk1.g_rom_ram_memory.u_ram.a_rdata_o[13];\u_pochoco_soc.genblk1.g_rom_ram_memory.u_ram.a_rdata_o[14];\u_pochoco_soc.genblk1.g_rom_ram_memory.u_ram.a_rdata_o[2];\u_pochoco_soc.genblk1.g_rom_ram_memory.u_ram.a_rdata_o[30];\u_pochoco_soc.genblk1.g_rom_ram_memory.u_ram.a_rdata_o[3];\u_pochoco_soc.genblk1.g_rom_ram_memory.u_ram.a_rdata_o[4];\u_pochoco_soc.genblk1.g_rom_ram_memory.u_ram.a_rdata_o[5];\u_pochoco_soc.genblk1.g_rom_ram_memory.u_ram.a_rdata_o[6]
slew | net160 | 11 | 3.357066 | 3.0 | -0.357067 | fanout160/Z:gf180mcu_fd_sc_mcu7t5v0__dlyb_1 | instruction/ROM/fetch | _7798_/A2 | \u_pochoco_soc.genblk1.g_rom_ram_memory.u_ram.a_addr_i[1];\u_pochoco_soc.genblk1.g_rom_ram_memory.u_ram.a_rdata_o[0];\u_pochoco_soc.genblk1.g_rom_ram_memory.u_ram.a_rdata_o[10];\u_pochoco_soc.genblk1.g_rom_ram_memory.u_ram.a_rdata_o[11];\u_pochoco_soc.genblk1.g_rom_ram_memory.u_ram.a_rdata_o[12];\u_pochoco_soc.genblk1.g_rom_ram_memory.u_ram.a_rdata_o[13];\u_pochoco_soc.genblk1.g_rom_ram_memory.u_ram.a_rdata_o[14];\u_pochoco_soc.genblk1.g_rom_ram_memory.u_ram.a_rdata_o[19];\u_pochoco_soc.genblk1.g_rom_ram_memory.u_ram.a_rdata_o[24];\u_pochoco_soc.genblk1.g_rom_ram_memory.u_ram.a_rdata_o[25];\u_pochoco_soc.genblk1.g_rom_ram_memory.u_ram.a_rdata_o[26];\u_pochoco_soc.genblk1.g_rom_ram_memory.u_ram.a_rdata_o[27];\u_pochoco_soc.genblk1.g_rom_ram_memory.u_ram.a_rdata_o[28];\u_pochoco_soc.genblk1.g_rom_ram_memory.u_ram.a_rdata_o[29];\u_pochoco_soc.genblk1.g_rom_ram_memory.u_ram.a_rdata_o[2];\u_pochoco_soc.genblk1.g_rom_ram_memory.u_ram.a_rdata_o[30];\u_pochoco_soc.genblk1.g_rom_ram_memory.u_ram.a_rdata_o[31];\u_pochoco_soc.genblk1.g_rom_ram_memory.u_ram.a_rdata_o[3];\u_pochoco_soc.genblk1.g_rom_ram_memory.u_ram.a_rdata_o[4];\u_pochoco_soc.genblk1.g_rom_ram_memory.u_ram.a_rdata_o[5];\u_pochoco_soc.genblk1.g_rom_ram_memory.u_ram.a_rdata_o[6];\u_pochoco_soc.genblk1.g_rom_ram_memory.u_ram.a_rdata_o[7];\u_pochoco_soc.genblk1.g_rom_ram_memory.u_ram.a_rdata_o[8];\u_pochoco_soc.genblk1.g_rom_ram_memory.u_ram.a_rdata_o[9];\u_pochoco_soc.u_core.instr_valid_id;\u_pochoco_soc.u_core.lsu_busy;\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
slew | net580 | 11 | 3.348417 | 3.0 | -0.348417 | fanout580/Z:gf180mcu_fd_sc_mcu7t5v0__dlyb_1 | other-combinational | _6255_/C | \u_pochoco_soc.genblk1.g_rom_ram_memory.u_ram.a_addr_i[8]
slew | net111 | 11 | 3.315706 | 3.0 | -0.315706 | _8052_/S:gf180mcu_fd_sc_mcu7t5v0__mux2_2;_8056_/S:gf180mcu_fd_sc_mcu7t5v0__mux2_2;_8060_/S:gf180mcu_fd_sc_mcu7t5v0__mux2_2;_8070_/S:gf180mcu_fd_sc_mcu7t5v0__mux2_2;_8071_/S:gf180mcu_fd_sc_mcu7t5v0__mux2_2;fanout111/Z:gf180mcu_fd_sc_mcu7t5v0__dlyb_1 | reset+instruction/ROM/fetch+data-memory+peripheral | _8071_/S | \u_pochoco_soc.data_wdata[0];\u_pochoco_soc.data_wdata[1];\u_pochoco_soc.data_wdata[2];\u_pochoco_soc.data_wdata[3];\u_pochoco_soc.data_wdata[4];\u_pochoco_soc.data_wdata[5];\u_pochoco_soc.data_wdata[6];\u_pochoco_soc.data_wdata[7];\u_pochoco_soc.genblk1.g_rom_ram_memory.u_ram.a_rdata_o[0];\u_pochoco_soc.genblk1.g_rom_ram_memory.u_ram.a_rdata_o[10];\u_pochoco_soc.genblk1.g_rom_ram_memory.u_ram.a_rdata_o[11];\u_pochoco_soc.genblk1.g_rom_ram_memory.u_ram.a_rdata_o[12];\u_pochoco_soc.genblk1.g_rom_ram_memory.u_ram.a_rdata_o[13];\u_pochoco_soc.genblk1.g_rom_ram_memory.u_ram.a_rdata_o[14];\u_pochoco_soc.genblk1.g_rom_ram_memory.u_ram.a_rdata_o[16];\u_pochoco_soc.genblk1.g_rom_ram_memory.u_ram.a_rdata_o[19];\u_pochoco_soc.genblk1.g_rom_ram_memory.u_ram.a_rdata_o[21];\u_pochoco_soc.genblk1.g_rom_ram_memory.u_ram.a_rdata_o[22];\u_pochoco_soc.genblk1.g_rom_ram_memory.u_ram.a_rdata_o[23];\u_pochoco_soc.genblk1.g_rom_ram_memory.u_ram.a_rdata_o[24];\u_pochoco_soc.genblk1.g_rom_ram_memory.u_ram.a_rdata_o[25];\u_pochoco_soc.genblk1.g_rom_ram_memory.u_ram.a_rdata_o[26];\u_pochoco_soc.genblk1.g_rom_ram_memory.u_ram.a_rdata_o[27];\u_pochoco_soc.genblk1.g_rom_ram_memory.u_ram.a_rdata_o[28];\u_pochoco_soc.genblk1.g_rom_ram_memory.u_ram.a_rdata_o[29];\u_pochoco_soc.genblk1.g_rom_ram_memory.u_ram.a_rdata_o[2];\u_pochoco_soc.genblk1.g_rom_ram_memory.u_ram.a_rdata_o[30];\u_pochoco_soc.genblk1.g_rom_ram_memory.u_ram.a_rdata_o[31];\u_pochoco_soc.genblk1.g_rom_ram_memory.u_ram.a_rdata_o[3];\u_pochoc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
slew | net292 | 11 | 3.30394 | 3.0 | -0.30394 | fanout292/Z:gf180mcu_fd_sc_mcu7t5v0__dlyb_1 | instruction/ROM/fetch | _6090_/A1 | \u_pochoco_soc.genblk1.g_rom_ram_memory.u_ram.a_rdata_o[0];\u_pochoco_soc.genblk1.g_rom_ram_memory.u_ram.a_rdata_o[11];\u_pochoco_soc.genblk1.g_rom_ram_memory.u_ram.a_rdata_o[12];\u_pochoco_soc.genblk1.g_rom_ram_memory.u_ram.a_rdata_o[13];\u_pochoco_soc.genblk1.g_rom_ram_memory.u_ram.a_rdata_o[14];\u_pochoco_soc.genblk1.g_rom_ram_memory.u_ram.a_rdata_o[19];\u_pochoco_soc.genblk1.g_rom_ram_memory.u_ram.a_rdata_o[24];\u_pochoco_soc.genblk1.g_rom_ram_memory.u_ram.a_rdata_o[25];\u_pochoco_soc.genblk1.g_rom_ram_memory.u_ram.a_rdata_o[26];\u_pochoco_soc.genblk1.g_rom_ram_memory.u_ram.a_rdata_o[27];\u_pochoco_soc.genblk1.g_rom_ram_memory.u_ram.a_rdata_o[28];\u_pochoco_soc.genblk1.g_rom_ram_memory.u_ram.a_rdata_o[29];\u_pochoco_soc.genblk1.g_rom_ram_memory.u_ram.a_rdata_o[2];\u_pochoco_soc.genblk1.g_rom_ram_memory.u_ram.a_rdata_o[30];\u_pochoco_soc.genblk1.g_rom_ram_memory.u_ram.a_rdata_o[31];\u_pochoco_soc.genblk1.g_rom_ram_memory.u_ram.a_rdata_o[3];\u_pochoco_soc.genblk1.g_rom_ram_memory.u_ram.a_rdata_o[4];\u_pochoco_soc.genblk1.g_rom_ram_memory.u_ram.a_rdata_o[5];\u_pochoco_soc.genblk1.g_rom_ram_memory.u_ram.a_rdata_o[6]
slew | net656 | 11 | 3.297934 | 3.0 | -0.297934 | fanout656/Z:gf180mcu_fd_sc_mcu7t5v0__dlyb_1 | reset | _8682_/RN | rst_ni
slew | net635 | 11 | 3.294647 | 3.0 | -0.294648 | fanout635/Z:gf180mcu_fd_sc_mcu7t5v0__dlyb_1 | reset | _9067_/RN | rst_ni
slew | net234 | 11 | 3.286878 | 3.0 | -0.286878 | fanout234/Z:gf180mcu_fd_sc_mcu7t5v0__dlyb_1 | instruction/ROM/fetch+data-memory+peripheral | _7810_/A2 | \u_pochoco_soc.data_wdata[0];\u_pochoco_soc.data_wdata[1];\u_pochoco_soc.data_wdata[2];\u_pochoco_soc.data_wdata[3];\u_pochoco_soc.data_wdata[4];\u_pochoco_soc.data_wdata[5];\u_pochoco_soc.data_wdata[6];\u_pochoco_soc.data_wdata[7];\u_pochoco_soc.genblk1.g_rom_ram_memory.u_ram.a_addr_i[1];\u_pochoco_soc.genblk1.g_rom_ram_memory.u_ram.a_rdata_o[0];\u_pochoco_soc.genblk1.g_rom_ram_memory.u_ram.a_rdata_o[10];\u_pochoco_soc.genblk1.g_rom_ram_memory.u_ram.a_rdata_o[11];\u_pochoco_soc.genblk1.g_rom_ram_memory.u_ram.a_rdata_o[12];\u_pochoco_soc.genblk1.g_rom_ram_memory.u_ram.a_rdata_o[13];\u_pochoco_soc.genblk1.g_rom_ram_memory.u_ram.a_rdata_o[14];\u_pochoco_soc.genblk1.g_rom_ram_memory.u_ram.a_rdata_o[19];\u_pochoco_soc.genblk1.g_rom_ram_memory.u_ram.a_rdata_o[21];\u_pochoco_soc.genblk1.g_rom_ram_memory.u_ram.a_rdata_o[22];\u_pochoco_soc.genblk1.g_rom_ram_memory.u_ram.a_rdata_o[23];\u_pochoco_soc.genblk1.g_rom_ram_memory.u_ram.a_rdata_o[24];\u_pochoco_soc.genblk1.g_rom_ram_memory.u_ram.a_rdata_o[25];\u_pochoco_soc.genblk1.g_rom_ram_memory.u_ram.a_rdata_o[26];\u_pochoco_soc.genblk1.g_rom_ram_memory.u_ram.a_rdata_o[27];\u_pochoco_soc.genblk1.g_rom_ram_memory.u_ram.a_rdata_o[28];\u_pochoco_soc.genblk1.g_rom_ram_memory.u_ram.a_rdata_o[29];\u_pochoco_soc.genblk1.g_rom_ram_memory.u_ram.a_rdata_o[2];\u_pochoco_soc.genblk1.g_rom_ram_memory.u_ram.a_rdata_o[30];\u_pochoco_soc.genblk1.g_rom_ram_memory.u_ram.a_rdata_o[31];\u_pochoco_soc.genblk1.g_rom_ram_memory.u_ram.a_rdata_o[3];\u_pochoco_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
slew | net663 | 11 | 3.257186 | 3.0 | -0.257186 | fanout663/Z:gf180mcu_fd_sc_mcu7t5v0__dlyb_1 | reset | _8607_/RN | rst_ni
slew | net239 | 11 | 3.25111 | 3.0 | -0.25111 | _7233_/S:gf180mcu_fd_sc_mcu7t5v0__mux2_2;fanout239/Z:gf180mcu_fd_sc_mcu7t5v0__dlyb_1 | instruction/ROM/fetch+data-memory+peripheral | _7468_/A2 | \u_pochoco_soc.data_wdata[0];\u_pochoco_soc.data_wdata[1];\u_pochoco_soc.data_wdata[2];\u_pochoco_soc.data_wdata[3];\u_pochoco_soc.data_wdata[4];\u_pochoco_soc.data_wdata[5];\u_pochoco_soc.data_wdata[6];\u_pochoco_soc.data_wdata[7];\u_pochoco_soc.genblk1.g_rom_ram_memory.u_ram.a_addr_i[1];\u_pochoco_soc.genblk1.g_rom_ram_memory.u_ram.a_rdata_o[0];\u_pochoco_soc.genblk1.g_rom_ram_memory.u_ram.a_rdata_o[10];\u_pochoco_soc.genblk1.g_rom_ram_memory.u_ram.a_rdata_o[11];\u_pochoco_soc.genblk1.g_rom_ram_memory.u_ram.a_rdata_o[12];\u_pochoco_soc.genblk1.g_rom_ram_memory.u_ram.a_rdata_o[13];\u_pochoco_soc.genblk1.g_rom_ram_memory.u_ram.a_rdata_o[14];\u_pochoco_soc.genblk1.g_rom_ram_memory.u_ram.a_rdata_o[19];\u_pochoco_soc.genblk1.g_rom_ram_memory.u_ram.a_rdata_o[21];\u_pochoco_soc.genblk1.g_rom_ram_memory.u_ram.a_rdata_o[22];\u_pochoco_soc.genblk1.g_rom_ram_memory.u_ram.a_rdata_o[23];\u_pochoco_soc.genblk1.g_rom_ram_memory.u_ram.a_rdata_o[24];\u_pochoco_soc.genblk1.g_rom_ram_memory.u_ram.a_rdata_o[25];\u_pochoco_soc.genblk1.g_rom_ram_memory.u_ram.a_rdata_o[26];\u_pochoco_soc.genblk1.g_rom_ram_memory.u_ram.a_rdata_o[27];\u_pochoco_soc.genblk1.g_rom_ram_memory.u_ram.a_rdata_o[28];\u_pochoco_soc.genblk1.g_rom_ram_memory.u_ram.a_rdata_o[29];\u_pochoco_soc.genblk1.g_rom_ram_memory.u_ram.a_rdata_o[2];\u_pochoco_soc.genblk1.g_rom_ram_memory.u_ram.a_rdata_o[30];\u_pochoco_soc.genblk1.g_rom_ram_memory.u_ram.a_rdata_o[31];\u_pochoco_soc.genblk1.g_rom_ram_memory.u_ram.a_rdata_o[3];\u_pochoco_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
slew | net220 | 11 | 3.247629 | 3.0 | -0.247629 | _7115_/S:gf180mcu_fd_sc_mcu7t5v0__mux2_2;_7123_/S:gf180mcu_fd_sc_mcu7t5v0__mux2_2;fanout220/Z:gf180mcu_fd_sc_mcu7t5v0__dlyb_1 | instruction/ROM/fetch+data-memory+peripheral | _7336_/A2 | \u_pochoco_soc.data_wdata[0];\u_pochoco_soc.data_wdata[1];\u_pochoco_soc.data_wdata[2];\u_pochoco_soc.data_wdata[3];\u_pochoco_soc.data_wdata[4];\u_pochoco_soc.data_wdata[5];\u_pochoco_soc.data_wdata[6];\u_pochoco_soc.data_wdata[7];\u_pochoco_soc.genblk1.g_rom_ram_memory.u_ram.a_addr_i[1];\u_pochoco_soc.genblk1.g_rom_ram_memory.u_ram.a_rdata_o[0];\u_pochoco_soc.genblk1.g_rom_ram_memory.u_ram.a_rdata_o[10];\u_pochoco_soc.genblk1.g_rom_ram_memory.u_ram.a_rdata_o[11];\u_pochoco_soc.genblk1.g_rom_ram_memory.u_ram.a_rdata_o[12];\u_pochoco_soc.genblk1.g_rom_ram_memory.u_ram.a_rdata_o[13];\u_pochoco_soc.genblk1.g_rom_ram_memory.u_ram.a_rdata_o[14];\u_pochoco_soc.genblk1.g_rom_ram_memory.u_ram.a_rdata_o[19];\u_pochoco_soc.genblk1.g_rom_ram_memory.u_ram.a_rdata_o[20];\u_pochoco_soc.genblk1.g_rom_ram_memory.u_ram.a_rdata_o[21];\u_pochoco_soc.genblk1.g_rom_ram_memory.u_ram.a_rdata_o[22];\u_pochoco_soc.genblk1.g_rom_ram_memory.u_ram.a_rdata_o[23];\u_pochoco_soc.genblk1.g_rom_ram_memory.u_ram.a_rdata_o[24];\u_pochoco_soc.genblk1.g_rom_ram_memory.u_ram.a_rdata_o[25];\u_pochoco_soc.genblk1.g_rom_ram_memory.u_ram.a_rdata_o[26];\u_pochoco_soc.genblk1.g_rom_ram_memory.u_ram.a_rdata_o[27];\u_pochoco_soc.genblk1.g_rom_ram_memory.u_ram.a_rdata_o[28];\u_pochoco_soc.genblk1.g_rom_ram_memory.u_ram.a_rdata_o[29];\u_pochoco_soc.genblk1.g_rom_ram_memory.u_ram.a_rdata_o[2];\u_pochoco_soc.genblk1.g_rom_ram_memory.u_ram.a_rdata_o[30];\u_pochoco_soc.genblk1.g_rom_ram_memory.u_ram.a_rdata_o[31];\u_pochoco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
slew | net276 | 11 | 3.244786 | 3.0 | -0.244786 | _7892_/S:gf180mcu_fd_sc_mcu7t5v0__mux2_2;_7893_/S:gf180mcu_fd_sc_mcu7t5v0__mux2_2;_7894_/S:gf180mcu_fd_sc_mcu7t5v0__mux2_2;_7895_/S:gf180mcu_fd_sc_mcu7t5v0__mux2_2;fanout276/Z:gf180mcu_fd_sc_mcu7t5v0__dlyb_1 | instruction/ROM/fetch | _7892_/S | \u_pochoco_soc.genblk1.g_rom_ram_memory.u_ram.a_addr_i[12];\u_pochoco_soc.genblk1.g_rom_ram_memory.u_ram.a_addr_i[13];\u_pochoco_soc.genblk1.g_rom_ram_memory.u_ram.a_addr_i[14];\u_pochoco_soc.genblk1.g_rom_ram_memory.u_ram.a_addr_i[15];\u_pochoco_soc.genblk1.g_rom_ram_memory.u_ram.a_addr_i[17];\u_pochoco_soc.genblk1.g_rom_ram_memory.u_ram.a_addr_i[20];\u_pochoco_soc.u_core.instr_valid_id;\u_pochoco_soc.u_core.lsu_busy;\u_pochoco_soc.u_core.pc_id[12];\u_pochoco_soc.u_core.pc_id[13];\u_pochoco_soc.u_core.pc_id[14];\u_pochoco_soc.u_core.pc_id[15];\u_pochoco_soc.u_core.pc_id[17];\u_pochoco_soc.u_core.pc_id[20];\u_pochoco_soc.u_core.rf_ready
slew | net222 | 11 | 3.206784 | 3.0 | -0.206784 | fanout222/Z:gf180mcu_fd_sc_mcu7t5v0__dlyb_1 | instruction/ROM/fetch+data-memory+peripheral | _7593_/A1 | \u_pochoco_soc.data_wdata[0];\u_pochoco_soc.data_wdata[1];\u_pochoco_soc.data_wdata[2];\u_pochoco_soc.data_wdata[3];\u_pochoco_soc.data_wdata[4];\u_pochoco_soc.data_wdata[5];\u_pochoco_soc.data_wdata[6];\u_pochoco_soc.data_wdata[7];\u_pochoco_soc.genblk1.g_rom_ram_memory.u_ram.a_addr_i[1];\u_pochoco_soc.genblk1.g_rom_ram_memory.u_ram.a_rdata_o[0];\u_pochoco_soc.genblk1.g_rom_ram_memory.u_ram.a_rdata_o[10];\u_pochoco_soc.genblk1.g_rom_ram_memory.u_ram.a_rdata_o[11];\u_pochoco_soc.genblk1.g_rom_ram_memory.u_ram.a_rdata_o[12];\u_pochoco_soc.genblk1.g_rom_ram_memory.u_ram.a_rdata_o[13];\u_pochoco_soc.genblk1.g_rom_ram_memory.u_ram.a_rdata_o[14];\u_pochoco_soc.genblk1.g_rom_ram_memory.u_ram.a_rdata_o[19];\u_pochoco_soc.genblk1.g_rom_ram_memory.u_ram.a_rdata_o[21];\u_pochoco_soc.genblk1.g_rom_ram_memory.u_ram.a_rdata_o[22];\u_pochoco_soc.genblk1.g_rom_ram_memory.u_ram.a_rdata_o[23];\u_pochoco_soc.genblk1.g_rom_ram_memory.u_ram.a_rdata_o[24];\u_pochoco_soc.genblk1.g_rom_ram_memory.u_ram.a_rdata_o[25];\u_pochoco_soc.genblk1.g_rom_ram_memory.u_ram.a_rdata_o[26];\u_pochoco_soc.genblk1.g_rom_ram_memory.u_ram.a_rdata_o[27];\u_pochoco_soc.genblk1.g_rom_ram_memory.u_ram.a_rdata_o[28];\u_pochoco_soc.genblk1.g_rom_ram_memory.u_ram.a_rdata_o[29];\u_pochoco_soc.genblk1.g_rom_ram_memory.u_ram.a_rdata_o[2];\u_pochoco_soc.genblk1.g_rom_ram_memory.u_ram.a_rdata_o[30];\u_pochoco_soc.genblk1.g_rom_ram_memory.u_ram.a_rdata_o[31];\u_pochoco_soc.genblk1.g_rom_ram_memory.u_ram.a_rdata_o[3];\u_pochoco_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
slew | net702 | 11 | 3.203633 | 3.0 | -0.203633 | fanout702/Z:gf180mcu_fd_sc_mcu7t5v0__dlyb_1 | reset | _8407_/RN | rst_ni
slew | net611 | 11 | 3.192972 | 3.0 | -0.192973 | fanout611/Z:gf180mcu_fd_sc_mcu7t5v0__dlyb_1 | other-combinational | _6222_/A1 | \u_pochoco_soc.genblk1.g_rom_ram_memory.u_ram.a_addr_i[3]
slew | net329 | 11 | 3.180869 | 3.0 | -0.18087 | fanout329/Z:gf180mcu_fd_sc_mcu7t5v0__dlyb_1 | instruction/ROM/fetch+data-memory+peripheral | _7302_/A1 | \u_pochoco_soc.data_wdata[0];\u_pochoco_soc.data_wdata[1];\u_pochoco_soc.data_wdata[2];\u_pochoco_soc.data_wdata[3];\u_pochoco_soc.data_wdata[4];\u_pochoco_soc.data_wdata[5];\u_pochoco_soc.data_wdata[6];\u_pochoco_soc.data_wdata[7];\u_pochoco_soc.genblk1.g_rom_ram_memory.u_ram.a_rdata_o[0];\u_pochoco_soc.genblk1.g_rom_ram_memory.u_ram.a_rdata_o[10];\u_pochoco_soc.genblk1.g_rom_ram_memory.u_ram.a_rdata_o[11];\u_pochoco_soc.genblk1.g_rom_ram_memory.u_ram.a_rdata_o[12];\u_pochoco_soc.genblk1.g_rom_ram_memory.u_ram.a_rdata_o[13];\u_pochoco_soc.genblk1.g_rom_ram_memory.u_ram.a_rdata_o[14];\u_pochoco_soc.genblk1.g_rom_ram_memory.u_ram.a_rdata_o[20];\u_pochoco_soc.genblk1.g_rom_ram_memory.u_ram.a_rdata_o[21];\u_pochoco_soc.genblk1.g_rom_ram_memory.u_ram.a_rdata_o[22];\u_pochoco_soc.genblk1.g_rom_ram_memory.u_ram.a_rdata_o[23];\u_pochoco_soc.genblk1.g_rom_ram_memory.u_ram.a_rdata_o[24];\u_pochoco_soc.genblk1.g_rom_ram_memory.u_ram.a_rdata_o[2];\u_pochoco_soc.genblk1.g_rom_ram_memory.u_ram.a_rdata_o[30];\u_pochoco_soc.genblk1.g_rom_ram_memory.u_ram.a_rdata_o[31];\u_pochoco_soc.genblk1.g_rom_ram_memory.u_ram.a_rdata_o[3];\u_pochoco_soc.genblk1.g_rom_ram_memory.u_ram.a_rdata_o[4];\u_pochoco_soc.genblk1.g_rom_ram_memory.u_ram.a_rdata_o[5];\u_pochoco_soc.genblk1.g_rom_ram_memory.u_ram.a_rdata_o[6];\u_pochoco_soc.genblk1.g_rom_ram_memory.u_ram.a_rdata_o[7];\u_pochoco_soc.genblk1.g_rom_ram_memory.u_ram.a_rdata_o[8];\u_pochoco_soc.genblk1.g_rom_ram_memory.u_ram.a_rdata_o[9];\u_pochoco_soc.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
slew | net310 | 11 | 3.174386 | 3.0 | -0.174386 | fanout310/Z:gf180mcu_fd_sc_mcu7t5v0__dlyb_1 | instruction/ROM/fetch | _4665_/A2 | \u_pochoco_soc.genblk1.g_rom_ram_memory.u_ram.a_rdata_o[0];\u_pochoco_soc.genblk1.g_rom_ram_memory.u_ram.a_rdata_o[12];\u_pochoco_soc.genblk1.g_rom_ram_memory.u_ram.a_rdata_o[13];\u_pochoco_soc.genblk1.g_rom_ram_memory.u_ram.a_rdata_o[14];\u_pochoco_soc.genblk1.g_rom_ram_memory.u_ram.a_rdata_o[2];\u_pochoco_soc.genblk1.g_rom_ram_memory.u_ram.a_rdata_o[30];\u_pochoco_soc.genblk1.g_rom_ram_memory.u_ram.a_rdata_o[3];\u_pochoco_soc.genblk1.g_rom_ram_memory.u_ram.a_rdata_o[4];\u_pochoco_soc.genblk1.g_rom_ram_memory.u_ram.a_rdata_o[5];\u_pochoco_soc.genblk1.g_rom_ram_memory.u_ram.a_rdata_o[6]
slew | net518 | 11 | 3.171813 | 3.0 | -0.171813 | fanout518/Z:gf180mcu_fd_sc_mcu7t5v0__dlyb_1 | instruction/ROM/fetch | _4492_/A2 | \u_pochoco_soc.genblk1.g_rom_ram_memory.u_ram.a_rdata_o[0];\u_pochoco_soc.genblk1.g_rom_ram_memory.u_ram.a_rdata_o[2];\u_pochoco_soc.genblk1.g_rom_ram_memory.u_ram.a_rdata_o[3];\u_pochoco_soc.genblk1.g_rom_ram_memory.u_ram.a_rdata_o[4];\u_pochoco_soc.genblk1.g_rom_ram_memory.u_ram.a_rdata_o[6]
slew | net543 | 11 | 3.164358 | 3.0 | -0.164358 | fanout543/Z:gf180mcu_fd_sc_mcu7t5v0__dlyb_1 | other-combinational | _5753_/A1 | \u_pochoco_soc.genblk1.g_rom_ram_memory.u_ram.a_addr_i[3]
slew | net638 | 11 | 3.163461 | 3.0 | -0.163461 | fanout638/Z:gf180mcu_fd_sc_mcu7t5v0__dlyb_1 | reset | _8459_/RN | rst_ni
slew | net536 | 11 | 3.151775 | 3.0 | -0.151775 | fanout536/Z:gf180mcu_fd_sc_mcu7t5v0__dlyb_1 | other-combinational | _6380_/A1 | \u_pochoco_soc.genblk1.g_rom_ram_memory.u_ram.a_addr_i[2];\u_pochoco_soc.genblk1.g_rom_ram_memory.u_ram.a_addr_i[4]
slew | net680 | 11 | 3.150456 | 3.0 | -0.150456 | fanout680/Z:gf180mcu_fd_sc_mcu7t5v0__dlyb_1 | reset | _8798_/RN | rst_ni
slew | net306 | 11 | 3.145905 | 3.0 | -0.145905 | fanout306/Z:gf180mcu_fd_sc_mcu7t5v0__dlyb_1 | instruction/ROM/fetch | _4769_/A1 | \u_pochoco_soc.genblk1.g_rom_ram_memory.u_ram.a_rdata_o[0];\u_pochoco_soc.genblk1.g_rom_ram_memory.u_ram.a_rdata_o[12];\u_pochoco_soc.genblk1.g_rom_ram_memory.u_ram.a_rdata_o[13];\u_pochoco_soc.genblk1.g_rom_ram_memory.u_ram.a_rdata_o[14];\u_pochoco_soc.genblk1.g_rom_ram_memory.u_ram.a_rdata_o[2];\u_pochoco_soc.genblk1.g_rom_ram_memory.u_ram.a_rdata_o[30];\u_pochoco_soc.genblk1.g_rom_ram_memory.u_ram.a_rdata_o[3];\u_pochoco_soc.genblk1.g_rom_ram_memory.u_ram.a_rdata_o[4];\u_pochoco_soc.genblk1.g_rom_ram_memory.u_ram.a_rdata_o[5];\u_pochoco_soc.genblk1.g_rom_ram_memory.u_ram.a_rdata_o[6]
slew | net683 | 11 | 3.14465 | 3.0 | -0.144651 | fanout683/Z:gf180mcu_fd_sc_mcu7t5v0__dlyb_1 | reset | _8262_/RN | rst_ni
slew | net190 | 11 | 3.136289 | 3.0 | -0.136289 | _7215_/S:gf180mcu_fd_sc_mcu7t5v0__mux2_2;fanout190/Z:gf180mcu_fd_sc_mcu7t5v0__dlyb_1 | instruction/ROM/fetch+data-memory+peripheral | _7717_/A1 | \u_pochoco_soc.data_wdata[0];\u_pochoco_soc.data_wdata[1];\u_pochoco_soc.data_wdata[3];\u_pochoco_soc.data_wdata[4];\u_pochoco_soc.data_wdata[5];\u_pochoco_soc.data_wdata[6];\u_pochoco_soc.data_wdata[7];\u_pochoco_soc.genblk1.g_rom_ram_memory.u_ram.a_addr_i[1];\u_pochoco_soc.genblk1.g_rom_ram_memory.u_ram.a_rdata_o[0];\u_pochoco_soc.genblk1.g_rom_ram_memory.u_ram.a_rdata_o[10];\u_pochoco_soc.genblk1.g_rom_ram_memory.u_ram.a_rdata_o[11];\u_pochoco_soc.genblk1.g_rom_ram_memory.u_ram.a_rdata_o[12];\u_pochoco_soc.genblk1.g_rom_ram_memory.u_ram.a_rdata_o[13];\u_pochoco_soc.genblk1.g_rom_ram_memory.u_ram.a_rdata_o[14];\u_pochoco_soc.genblk1.g_rom_ram_memory.u_ram.a_rdata_o[19];\u_pochoco_soc.genblk1.g_rom_ram_memory.u_ram.a_rdata_o[21];\u_pochoco_soc.genblk1.g_rom_ram_memory.u_ram.a_rdata_o[23];\u_pochoco_soc.genblk1.g_rom_ram_memory.u_ram.a_rdata_o[24];\u_pochoco_soc.genblk1.g_rom_ram_memory.u_ram.a_rdata_o[25];\u_pochoco_soc.genblk1.g_rom_ram_memory.u_ram.a_rdata_o[26];\u_pochoco_soc.genblk1.g_rom_ram_memory.u_ram.a_rdata_o[27];\u_pochoco_soc.genblk1.g_rom_ram_memory.u_ram.a_rdata_o[28];\u_pochoco_soc.genblk1.g_rom_ram_memory.u_ram.a_rdata_o[29];\u_pochoco_soc.genblk1.g_rom_ram_memory.u_ram.a_rdata_o[2];\u_pochoco_soc.genblk1.g_rom_ram_memory.u_ram.a_rdata_o[30];\u_pochoco_soc.genblk1.g_rom_ram_memory.u_ram.a_rdata_o[31];\u_pochoco_soc.genblk1.g_rom_ram_memory.u_ram.a_rdata_o[3];\u_pochoco_soc.genblk1.g_rom_ram_memory.u_ram.a_rdata_o[4];\u_pochoco_soc.genblk1.g_rom_ram_memory.u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
slew | _0918_ | 11 | 3.134008 | 3.0 | -0.134008 | _4156_/ZN:gf180mcu_fd_sc_mcu7t5v0__clkinv_1 | other-combinational | _7887_/A1 | \u_pochoco_soc.genblk1.g_rom_ram_memory.u_ram.a_addr_i[8]
slew | net290 | 11 | 3.128762 | 3.0 | -0.128762 | _5761_/S:gf180mcu_fd_sc_mcu7t5v0__mux2_2;_5817_/S:gf180mcu_fd_sc_mcu7t5v0__mux2_2;_5827_/S:gf180mcu_fd_sc_mcu7t5v0__mux2_2;fanout290/Z:gf180mcu_fd_sc_mcu7t5v0__dlyb_1 | instruction/ROM/fetch+data-memory+peripheral | _5827_/S | \u_pochoco_soc.data_wdata[0];\u_pochoco_soc.data_wdata[1];\u_pochoco_soc.data_wdata[2];\u_pochoco_soc.data_wdata[3];\u_pochoco_soc.data_wdata[4];\u_pochoco_soc.data_wdata[5];\u_pochoco_soc.data_wdata[6];\u_pochoco_soc.data_wdata[7];\u_pochoco_soc.genblk1.g_rom_ram_memory.u_ram.a_rdata_o[0];\u_pochoco_soc.genblk1.g_rom_ram_memory.u_ram.a_rdata_o[10];\u_pochoco_soc.genblk1.g_rom_ram_memory.u_ram.a_rdata_o[11];\u_pochoco_soc.genblk1.g_rom_ram_memory.u_ram.a_rdata_o[12];\u_pochoco_soc.genblk1.g_rom_ram_memory.u_ram.a_rdata_o[13];\u_pochoco_soc.genblk1.g_rom_ram_memory.u_ram.a_rdata_o[14];\u_pochoco_soc.genblk1.g_rom_ram_memory.u_ram.a_rdata_o[19];\u_pochoco_soc.genblk1.g_rom_ram_memory.u_ram.a_rdata_o[20];\u_pochoco_soc.genblk1.g_rom_ram_memory.u_ram.a_rdata_o[21];\u_pochoco_soc.genblk1.g_rom_ram_memory.u_ram.a_rdata_o[22];\u_pochoco_soc.genblk1.g_rom_ram_memory.u_ram.a_rdata_o[23];\u_pochoco_soc.genblk1.g_rom_ram_memory.u_ram.a_rdata_o[24];\u_pochoco_soc.genblk1.g_rom_ram_memory.u_ram.a_rdata_o[25];\u_pochoco_soc.genblk1.g_rom_ram_memory.u_ram.a_rdata_o[26];\u_pochoco_soc.genblk1.g_rom_ram_memory.u_ram.a_rdata_o[27];\u_pochoco_soc.genblk1.g_rom_ram_memory.u_ram.a_rdata_o[28];\u_pochoco_soc.genblk1.g_rom_ram_memory.u_ram.a_rdata_o[29];\u_pochoco_soc.genblk1.g_rom_ram_memory.u_ram.a_rdata_o[2];\u_pochoco_soc.genblk1.g_rom_ram_memory.u_ram.a_rdata_o[30];\u_pochoco_soc.genblk1.g_rom_ram_memory.u_ram.a_rdata_o[31];\u_pochoco_soc.genblk1.g_rom_ram_memory.u_ram.a_rdata_o[3];\u_pochoc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
slew | net314 | 11 | 3.122426 | 3.0 | -0.122426 | fanout314/Z:gf180mcu_fd_sc_mcu7t5v0__dlyb_1 | instruction/ROM/fetch | _4669_/A1 | \u_pochoco_soc.genblk1.g_rom_ram_memory.u_ram.a_rdata_o[0];\u_pochoco_soc.genblk1.g_rom_ram_memory.u_ram.a_rdata_o[12];\u_pochoco_soc.genblk1.g_rom_ram_memory.u_ram.a_rdata_o[13];\u_pochoco_soc.genblk1.g_rom_ram_memory.u_ram.a_rdata_o[14];\u_pochoco_soc.genblk1.g_rom_ram_memory.u_ram.a_rdata_o[2];\u_pochoco_soc.genblk1.g_rom_ram_memory.u_ram.a_rdata_o[30];\u_pochoco_soc.genblk1.g_rom_ram_memory.u_ram.a_rdata_o[3];\u_pochoco_soc.genblk1.g_rom_ram_memory.u_ram.a_rdata_o[4];\u_pochoco_soc.genblk1.g_rom_ram_memory.u_ram.a_rdata_o[5];\u_pochoco_soc.genblk1.g_rom_ram_memory.u_ram.a_rdata_o[6]
slew | net472 | 11 | 3.10444 | 3.0 | -0.10444 | fanout472/Z:gf180mcu_fd_sc_mcu7t5v0__dlyb_1 | other-combinational | _6522_/B | \u_pochoco_soc.genblk1.g_rom_ram_memory.u_ram.a_addr_i[7];\u_pochoco_soc.genblk1.g_rom_ram_memory.u_ram.a_addr_i[8]
slew | net304 | 11 | 3.102372 | 3.0 | -0.102372 | fanout304/Z:gf180mcu_fd_sc_mcu7t5v0__dlyb_1 | instruction/ROM/fetch | _4626_/A1 | \u_pochoco_soc.genblk1.g_rom_ram_memory.u_ram.a_rdata_o[0];\u_pochoco_soc.genblk1.g_rom_ram_memory.u_ram.a_rdata_o[12];\u_pochoco_soc.genblk1.g_rom_ram_memory.u_ram.a_rdata_o[13];\u_pochoco_soc.genblk1.g_rom_ram_memory.u_ram.a_rdata_o[14];\u_pochoco_soc.genblk1.g_rom_ram_memory.u_ram.a_rdata_o[2];\u_pochoco_soc.genblk1.g_rom_ram_memory.u_ram.a_rdata_o[30];\u_pochoco_soc.genblk1.g_rom_ram_memory.u_ram.a_rdata_o[3];\u_pochoco_soc.genblk1.g_rom_ram_memory.u_ram.a_rdata_o[4];\u_pochoco_soc.genblk1.g_rom_ram_memory.u_ram.a_rdata_o[5];\u_pochoco_soc.genblk1.g_rom_ram_memory.u_ram.a_rdata_o[6]
slew | \u_pochoco_soc.genblk1.g_rom_ram_memory.u_ram.a_rdata_o[14] | 11 | 3.1013 | 3.0 | -0.1013 | _8253_/Q:gf180mcu_fd_sc_mcu7t5v0__dffrnq_1 | instruction/ROM/fetch | _4306_/A1 | \u_pochoco_soc.genblk1.g_rom_ram_memory.u_ram.a_rdata_o[14]
slew | net632 | 11 | 3.099844 | 3.0 | -0.099844 | fanout632/Z:gf180mcu_fd_sc_mcu7t5v0__dlyb_1 | reset | _8496_/RN | rst_ni
slew | net657 | 11 | 3.081907 | 3.0 | -0.081907 | fanout657/Z:gf180mcu_fd_sc_mcu7t5v0__dlyb_1 | reset | _8749_/RN | rst_ni
slew | net217 | 11 | 3.080224 | 3.0 | -0.080224 | _6922_/S:gf180mcu_fd_sc_mcu7t5v0__mux2_2;fanout217/Z:gf180mcu_fd_sc_mcu7t5v0__dlyb_1 | instruction/ROM/fetch+data-memory+peripheral | _6923_/A2 | \u_pochoco_soc.data_wdata[0];\u_pochoco_soc.data_wdata[1];\u_pochoco_soc.data_wdata[2];\u_pochoco_soc.data_wdata[3];\u_pochoco_soc.data_wdata[4];\u_pochoco_soc.data_wdata[5];\u_pochoco_soc.data_wdata[6];\u_pochoco_soc.data_wdata[7];\u_pochoco_soc.genblk1.g_rom_ram_memory.u_ram.a_addr_i[1];\u_pochoco_soc.genblk1.g_rom_ram_memory.u_ram.a_rdata_o[0];\u_pochoco_soc.genblk1.g_rom_ram_memory.u_ram.a_rdata_o[10];\u_pochoco_soc.genblk1.g_rom_ram_memory.u_ram.a_rdata_o[11];\u_pochoco_soc.genblk1.g_rom_ram_memory.u_ram.a_rdata_o[12];\u_pochoco_soc.genblk1.g_rom_ram_memory.u_ram.a_rdata_o[13];\u_pochoco_soc.genblk1.g_rom_ram_memory.u_ram.a_rdata_o[14];\u_pochoco_soc.genblk1.g_rom_ram_memory.u_ram.a_rdata_o[19];\u_pochoco_soc.genblk1.g_rom_ram_memory.u_ram.a_rdata_o[20];\u_pochoco_soc.genblk1.g_rom_ram_memory.u_ram.a_rdata_o[21];\u_pochoco_soc.genblk1.g_rom_ram_memory.u_ram.a_rdata_o[22];\u_pochoco_soc.genblk1.g_rom_ram_memory.u_ram.a_rdata_o[23];\u_pochoco_soc.genblk1.g_rom_ram_memory.u_ram.a_rdata_o[24];\u_pochoco_soc.genblk1.g_rom_ram_memory.u_ram.a_rdata_o[25];\u_pochoco_soc.genblk1.g_rom_ram_memory.u_ram.a_rdata_o[26];\u_pochoco_soc.genblk1.g_rom_ram_memory.u_ram.a_rdata_o[27];\u_pochoco_soc.genblk1.g_rom_ram_memory.u_ram.a_rdata_o[28];\u_pochoco_soc.genblk1.g_rom_ram_memory.u_ram.a_rdata_o[29];\u_pochoco_soc.genblk1.g_rom_ram_memory.u_ram.a_rdata_o[2];\u_pochoco_soc.genblk1.g_rom_ram_memory.u_ram.a_rdata_o[30];\u_pochoco_soc.genblk1.g_rom_ram_memory.u_ram.a_rdata_o[31];\u_pochoco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
slew | net608 | 11 | 3.078995 | 3.0 | -0.078995 | fanout608/Z:gf180mcu_fd_sc_mcu7t5v0__dlyb_1 | other-combinational | _6540_/A1 | \u_pochoco_soc.genblk1.g_rom_ram_memory.u_ram.a_addr_i[4]
slew | net331 | 11 | 3.07869 | 3.0 | -0.07869 | fanout331/Z:gf180mcu_fd_sc_mcu7t5v0__dlyb_1 | instruction/ROM/fetch | _7638_/A1 | \u_pochoco_soc.genblk1.g_rom_ram_memory.u_ram.a_rdata_o[0];\u_pochoco_soc.genblk1.g_rom_ram_memory.u_ram.a_rdata_o[2];\u_pochoco_soc.genblk1.g_rom_ram_memory.u_ram.a_rdata_o[3];\u_pochoco_soc.genblk1.g_rom_ram_memory.u_ram.a_rdata_o[4];\u_pochoco_soc.genblk1.g_rom_ram_memory.u_ram.a_rdata_o[5];\u_pochoco_soc.genblk1.g_rom_ram_memory.u_ram.a_rdata_o[6]
slew | net229 | 11 | 3.066185 | 3.0 | -0.066185 | fanout229/Z:gf180mcu_fd_sc_mcu7t5v0__dlyb_1 | instruction/ROM/fetch+data-memory | _7927_/A2 | \u_pochoco_soc.data_wdata[0];\u_pochoco_soc.data_wdata[1];\u_pochoco_soc.data_wdata[2];\u_pochoco_soc.data_wdata[3];\u_pochoco_soc.data_wdata[4];\u_pochoco_soc.data_wdata[5];\u_pochoco_soc.data_wdata[6];\u_pochoco_soc.data_wdata[7];\u_pochoco_soc.genblk1.g_rom_ram_memory.u_ram.a_rdata_o[0];\u_pochoco_soc.genblk1.g_rom_ram_memory.u_ram.a_rdata_o[10];\u_pochoco_soc.genblk1.g_rom_ram_memory.u_ram.a_rdata_o[11];\u_pochoco_soc.genblk1.g_rom_ram_memory.u_ram.a_rdata_o[12];\u_pochoco_soc.genblk1.g_rom_ram_memory.u_ram.a_rdata_o[13];\u_pochoco_soc.genblk1.g_rom_ram_memory.u_ram.a_rdata_o[14];\u_pochoco_soc.genblk1.g_rom_ram_memory.u_ram.a_rdata_o[21];\u_pochoco_soc.genblk1.g_rom_ram_memory.u_ram.a_rdata_o[22];\u_pochoco_soc.genblk1.g_rom_ram_memory.u_ram.a_rdata_o[23];\u_pochoco_soc.genblk1.g_rom_ram_memory.u_ram.a_rdata_o[24];\u_pochoco_soc.genblk1.g_rom_ram_memory.u_ram.a_rdata_o[25];\u_pochoco_soc.genblk1.g_rom_ram_memory.u_ram.a_rdata_o[26];\u_pochoco_soc.genblk1.g_rom_ram_memory.u_ram.a_rdata_o[27];\u_pochoco_soc.genblk1.g_rom_ram_memory.u_ram.a_rdata_o[2];\u_pochoco_soc.genblk1.g_rom_ram_memory.u_ram.a_rdata_o[30];\u_pochoco_soc.genblk1.g_rom_ram_memory.u_ram.a_rdata_o[3];\u_pochoco_soc.genblk1.g_rom_ram_memory.u_ram.a_rdata_o[4];\u_pochoco_soc.genblk1.g_rom_ram_memory.u_ram.a_rdata_o[5];\u_pochoco_soc.genblk1.g_rom_ram_memory.u_ram.a_rdata_o[6];\u_pochoco_soc.genblk1.g_rom_ram_memory.u_ram.a_rdata_o[7];\u_pochoco_soc.genblk1.g_rom_ram_memory.u_ram.a_rdata_o[8];\u_pochoco_soc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
slew | net652 | 11 | 3.061667 | 3.0 | -0.061668 | fanout652/Z:gf180mcu_fd_sc_mcu7t5v0__dlyb_1 | reset | _8777_/RN | rst_ni
slew | net538 | 11 | 3.058389 | 3.0 | -0.058389 | fanout538/Z:gf180mcu_fd_sc_mcu7t5v0__dlyb_1 | other-combinational | _6579_/B | \u_pochoco_soc.genblk1.g_rom_ram_memory.u_ram.a_addr_i[6]
slew | net696 | 11 | 3.044839 | 3.0 | -0.044839 | fanout696/Z:gf180mcu_fd_sc_mcu7t5v0__dlyb_1 | reset | _8397_/RN | rst_ni
slew | net666 | 11 | 3.042806 | 3.0 | -0.042806 | fanout666/Z:gf180mcu_fd_sc_mcu7t5v0__dlyb_1 | reset | _8529_/RN | rst_ni
slew | net460 | 11 | 3.038586 | 3.0 | -0.038586 | fanout460/Z:gf180mcu_fd_sc_mcu7t5v0__dlyb_1 | instruction/ROM/fetch | _4381_/A2 | \u_pochoco_soc.genblk1.g_rom_ram_memory.u_ram.a_rdata_o[0];\u_pochoco_soc.genblk1.g_rom_ram_memory.u_ram.a_rdata_o[2];\u_pochoco_soc.genblk1.g_rom_ram_memory.u_ram.a_rdata_o[3];\u_pochoco_soc.genblk1.g_rom_ram_memory.u_ram.a_rdata_o[4];\u_pochoco_soc.genblk1.g_rom_ram_memory.u_ram.a_rdata_o[5];\u_pochoco_soc.genblk1.g_rom_ram_memory.u_ram.a_rdata_o[6]
slew | net183 | 11 | 3.030096 | 3.0 | -0.030096 | fanout183/Z:gf180mcu_fd_sc_mcu7t5v0__dlyb_1 | instruction/ROM/fetch+data-memory+peripheral | _7733_/A1 | \u_pochoco_soc.data_wdata[0];\u_pochoco_soc.data_wdata[1];\u_pochoco_soc.data_wdata[2];\u_pochoco_soc.data_wdata[3];\u_pochoco_soc.data_wdata[4];\u_pochoco_soc.data_wdata[5];\u_pochoco_soc.data_wdata[6];\u_pochoco_soc.data_wdata[7];\u_pochoco_soc.genblk1.g_rom_ram_memory.u_ram.a_addr_i[1];\u_pochoco_soc.genblk1.g_rom_ram_memory.u_ram.a_rdata_o[0];\u_pochoco_soc.genblk1.g_rom_ram_memory.u_ram.a_rdata_o[10];\u_pochoco_soc.genblk1.g_rom_ram_memory.u_ram.a_rdata_o[11];\u_pochoco_soc.genblk1.g_rom_ram_memory.u_ram.a_rdata_o[12];\u_pochoco_soc.genblk1.g_rom_ram_memory.u_ram.a_rdata_o[13];\u_pochoco_soc.genblk1.g_rom_ram_memory.u_ram.a_rdata_o[14];\u_pochoco_soc.genblk1.g_rom_ram_memory.u_ram.a_rdata_o[19];\u_pochoco_soc.genblk1.g_rom_ram_memory.u_ram.a_rdata_o[21];\u_pochoco_soc.genblk1.g_rom_ram_memory.u_ram.a_rdata_o[22];\u_pochoco_soc.genblk1.g_rom_ram_memory.u_ram.a_rdata_o[23];\u_pochoco_soc.genblk1.g_rom_ram_memory.u_ram.a_rdata_o[24];\u_pochoco_soc.genblk1.g_rom_ram_memory.u_ram.a_rdata_o[25];\u_pochoco_soc.genblk1.g_rom_ram_memory.u_ram.a_rdata_o[26];\u_pochoco_soc.genblk1.g_rom_ram_memory.u_ram.a_rdata_o[27];\u_pochoco_soc.genblk1.g_rom_ram_memory.u_ram.a_rdata_o[28];\u_pochoco_soc.genblk1.g_rom_ram_memory.u_ram.a_rdata_o[29];\u_pochoco_soc.genblk1.g_rom_ram_memory.u_ram.a_rdata_o[2];\u_pochoco_soc.genblk1.g_rom_ram_memory.u_ram.a_rdata_o[30];\u_pochoco_soc.genblk1.g_rom_ram_memory.u_ram.a_rdata_o[31];\u_pochoco_soc.genblk1.g_rom_ram_memory.u_ram.a_rdata_o[3];\u_pochoco_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
slew | net664 | 11 | 3.027542 | 3.0 | -0.027542 | fanout664/Z:gf180mcu_fd_sc_mcu7t5v0__dlyb_1 | reset | _8574_/RN | rst_ni
slew | net672 | 11 | 3.02449 | 3.0 | -0.02449 | fanout672/Z:gf180mcu_fd_sc_mcu7t5v0__dlyb_1 | reset | _8718_/RN | rst_ni
slew | net659 | 11 | 3.016614 | 3.0 | -0.016614 | fanout659/Z:gf180mcu_fd_sc_mcu7t5v0__dlyb_1 | reset | _8717_/RN | rst_ni
slew | net636 | 11 | 3.011981 | 3.0 | -0.011982 | fanout636/Z:gf180mcu_fd_sc_mcu7t5v0__dlyb_1 | reset | _8531_/RN | rst_ni
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
