eaponce1/Proyecto3_Arquitectura_de_Computadores_Grupo_1/reports/stage12/timing_nine_corners.csv

tag | corner | setup_ws_ns | setup_wns_ns | setup_tns_ns | hold_ws_ns | hold_wns_ns | hold_tns_ns | slew_report_count | slew_metric_count | slew_worst_value | slew_worst_slack | fanout_report_count | fanout_metric_count | fanout_worst_value | fanout_worst_slack | capacitance_report_count | capacitance_metric_count | capacitance_worst_value | capacitance_worst_slack
etapa9_rom_ram_util40_debounce | max_ff_n40C_5v50 | 72.70610275180996 | 0 | 0 | 0.136608062062357 | 0 | 0 | 0 | 0 |  | 0 | 58 | 58 | 18.0 | -8.0 | 9 | 9 | 0.335557 | -0.135557
etapa9_rom_ram_util40_debounce | max_ss_125C_4v50 | 37.17198742916638 | 0 | 0 | 0.9419192359356111 | 0 | 0 | 2695 | 2695 | 6.518591 | -3.518591 | 58 | 58 | 18.0 | -8.0 | 10 | 10 | 0.337637 | -0.137637
etapa9_rom_ram_util40_debounce | max_tt_025C_5v00 | 65.70496865895824 | 0 | 0 | 0.37795767585461365 | 0 | 0 | 308 | 308 | 3.690319 | -0.690319 | 58 | 58 | 18.0 | -8.0 | 9 | 9 | 0.335477 | -0.135477
etapa9_rom_ram_util40_debounce | min_ff_n40C_5v50 | 73.18858970474616 | 0 | 0 | 0.12603829447978224 | 0 | 0 | 0 | 0 |  | 0 | 58 | 58 | 18.0 | -8.0 | 2 | 2 | 0.306796 | -0.106796
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
