eaponce1/Proyecto3_Arquitectura_de_Computadores_Grupo_1/reports/stage13/timing_nine_corners.csv

experiment | tag | corner | setup_ws_ns | setup_wns_ns | setup_tns_ns | hold_ws_ns | hold_wns_ns | hold_tns_ns | slew_report_count | slew_metric_count | slew_worst_value | slew_worst_slack | fanout_report_count | fanout_metric_count | fanout_worst_value | fanout_worst_slack | capacitance_report_count | capacitance_metric_count | capacitance_worst_value | capacitance_worst_slack
reference | etapa12_rom_ram_no_delay_ss | max_ff_n40C_5v50 | 75.65095430888115 | 0 | 0 | 0.05586531395609223 | 0 | 0 | 0 | 0 |  | 0 | 57 | 57 | 19.0 | -9.0 | 2 | 2 | 0.334622 | -0.134622
reference | etapa12_rom_ram_no_delay_ss | max_ss_125C_4v50 | 53.64685203468914 | 0 | 0 | 0.7263840845528116 | 0 | 0 | 440 | 440 | 5.405243 | -2.405243 | 57 | 57 | 19.0 | -9.0 | 2 | 2 | 0.336702 | -0.136702
reference | etapa12_rom_ram_no_delay_ss | max_tt_025C_5v00 | 73.36142212468049 | 0 | 0 | 0.2564367679674891 | 0 | 0 | 21 | 21 | 3.187369 | -0.187369 | 57 | 57 | 19.0 | -9.0 | 2 | 2 | 0.334542 | -0.134542
reference | etapa12_rom_ram_no_delay_ss | min_ff_n40C_5v50 | 75.81384623566105 | 0 | 0 | 0.054793393595500665 | 0 | 0 | 0 | 0 |  | 0 | 57 | 57 | 19.0 | -9.0 | 2 | 2 | 0.306549 | -0.106549
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
