eaponce1/Proyecto3_Arquitectura_de_Computadores_Grupo_1/reports/stage17/group3_slew_by_net.csv

net | violations | corners | worst_slew_ns | limit_ns | worst_slack_ns | pins | cells | drivers | classification
net286 | 14 | max_ss_125C_4v50,nom_ss_125C_4v50 | 3.598844 | 3.0 | -0.598844 | ANTENNA_1/I,fanout277/I,fanout279/I,fanout281/I,fanout283/I,fanout285/I,fanout286/Z | gf180mcu_fd_sc_mcu7t5v0__antenna,gf180mcu_fd_sc_mcu7t5v0__buf_1 | fanout286/Z (gf180mcu_fd_sc_mcu7t5v0__buf_1) | data/register-file;instruction/ROM
\u_pochoco_soc.data_wdata[6] | 14 | max_ss_125C_4v50,nom_ss_125C_4v50 | 3.566474 | 3.0 | -0.566474 | _4499_/A1,_6795_/A1,_6796_/A1,_6858_/I1,_8273_/I0,_8388_/I0,_9251_/Q | gf180mcu_fd_sc_mcu7t5v0__and2_1,gf180mcu_fd_sc_mcu7t5v0__aoi22_1,gf180mcu_fd_sc_mcu7t5v0__dffrnq_1,gf180mcu_fd_sc_mcu7t5v0__mux2_2,gf180mcu_fd_sc_mcu7t5v0__nand2_1 | _9251_/Q (gf180mcu_fd_sc_mcu7t5v0__dffrnq_1) | data/register-file;instruction/ROM
\u_pochoco_soc.data_wdata[5] | 14 | max_ss_125C_4v50,nom_ss_125C_4v50 | 3.374862 | 3.0 | -0.374862 | _4479_/A1,_6790_/A1,_6791_/A1,_6857_/I1,_8272_/I0,_8387_/I0,_9250_/Q | gf180mcu_fd_sc_mcu7t5v0__and2_1,gf180mcu_fd_sc_mcu7t5v0__aoi22_1,gf180mcu_fd_sc_mcu7t5v0__dffrnq_1,gf180mcu_fd_sc_mcu7t5v0__mux2_2,gf180mcu_fd_sc_mcu7t5v0__nand2_1 | _9250_/Q (gf180mcu_fd_sc_mcu7t5v0__dffrnq_1) | data/register-file;instruction/ROM
_2750_ | 14 | max_ss_125C_4v50,nom_ss_125C_4v50 | 3.253336 | 3.0 | -0.253336 | _6283_/ZN,_6488_/A1,_6496_/B,_6557_/B,_6575_/A2,_6587_/C,_6720_/A1 | gf180mcu_fd_sc_mcu7t5v0__nand3_1,gf180mcu_fd_sc_mcu7t5v0__nor2_1,gf180mcu_fd_sc_mcu7t5v0__oai211_1,gf180mcu_fd_sc_mcu7t5v0__oai21_1 | _6283_/ZN (gf180mcu_fd_sc_mcu7t5v0__nor2_1) | instruction/ROM
_1427_ | 12 | max_ss_125C_4v50,min_ss_125C_4v50,nom_ss_125C_4v50 | 4.161633 | 3.0 | -1.161633 | _4812_/ZN,_4895_/A2,_6039_/A1,_7093_/A2 | gf180mcu_fd_sc_mcu7t5v0__aoi21_1,gf180mcu_fd_sc_mcu7t5v0__nand2_1,gf180mcu_fd_sc_mcu7t5v0__nand3_1,gf180mcu_fd_sc_mcu7t5v0__oai22_1 | _4812_/ZN (gf180mcu_fd_sc_mcu7t5v0__aoi21_1) | instruction/ROM
_1502_ | 12 | max_ss_125C_4v50,min_ss_125C_4v50,nom_ss_125C_4v50 | 3.723507 | 3.0 | -0.723507 | _4887_/ZN,_4894_/A3,_6052_/A1,_7102_/A2 | gf180mcu_fd_sc_mcu7t5v0__aoi211_2,gf180mcu_fd_sc_mcu7t5v0__nor2_1,gf180mcu_fd_sc_mcu7t5v0__nor4_1,gf180mcu_fd_sc_mcu7t5v0__oai211_1 | _4887_/ZN (gf180mcu_fd_sc_mcu7t5v0__oai211_1) | instruction/ROM
net360 | 12 | max_ss_125C_4v50,nom_ss_125C_4v50 | 3.684752 | 3.0 | -0.684752 | fanout345/I,fanout348/I,fanout349/I,fanout351/I,fanout358/I,fanout360/Z | gf180mcu_fd_sc_mcu7t5v0__buf_1 | fanout360/Z (gf180mcu_fd_sc_mcu7t5v0__buf_1) | instruction/ROM
_2796_ | 12 | max_ss_125C_4v50,nom_ss_125C_4v50 | 3.427487 | 3.0 | -0.427487 | _6330_/ZN,_6332_/A2,_6421_/A2,_6510_/A2,_6629_/A2,_6696_/A3 | gf180mcu_fd_sc_mcu7t5v0__aoi211_1,gf180mcu_fd_sc_mcu7t5v0__nand2_1,gf180mcu_fd_sc_mcu7t5v0__nand4_1,gf180mcu_fd_sc_mcu7t5v0__nor2_1,gf180mcu_fd_sc_mcu7t5v0__oai21_1 | _6330_/ZN (gf180mcu_fd_sc_mcu7t5v0__nor2_1) | instruction/ROM
_2878_ | 12 | max_ss_125C_4v50,nom_ss_125C_4v50 | 3.425689 | 3.0 | -0.425689 | _6415_/ZN,_6416_/A2,_6553_/A2,_6610_/A3,_6611_/A2,_6647_/B1 | gf180mcu_fd_sc_mcu7t5v0__aoi21_1,gf180mcu_fd_sc_mcu7t5v0__aoi221_1,gf180mcu_fd_sc_mcu7t5v0__nand3_1,gf180mcu_fd_sc_mcu7t5v0__nor2_1,gf180mcu_fd_sc_mcu7t5v0__xor2_1 | _6415_/ZN (gf180mcu_fd_sc_mcu7t5v0__nor2_1) | instruction/ROM
net936 | 11 | max_ss_125C_4v50 | 3.125754 | 3.0 | -0.125755 | _5885_/A2,_5890_/A1,_6205_/A2,_6212_/A2,_6283_/A2,_6320_/B,_6322_/B2,_6323_/B,_6509_/A1,_8115_/A1,fanout936/Z | gf180mcu_fd_sc_mcu7t5v0__and2_1,gf180mcu_fd_sc_mcu7t5v0__aoi21_1,gf180mcu_fd_sc_mcu7t5v0__aoi22_1,gf180mcu_fd_sc_mcu7t5v0__buf_1,gf180mcu_fd_sc_mcu7t5v0__nand2_1,gf180mcu_fd_sc_mcu7t5v0__nor2_1,gf180mcu_fd_sc_mcu7t5v0__nor2_2,gf180mcu_fd_sc_mcu7t5v0__oai21_1 | fanout936/Z (gf180mcu_fd_sc_mcu7t5v0__buf_1) | instruction/ROM
net983 | 11 | max_ss_125C_4v50 | 3.093858 | 3.0 | -0.093858 | _4602_/A1,_5343_/A1,_5344_/A1,_5346_/A1,_5349_/A1,_5351_/A1,_5360_/A1,_5364_/A1,_5365_/A1,_5996_/A1,fanout983/Z | gf180mcu_fd_sc_mcu7t5v0__buf_1,gf180mcu_fd_sc_mcu7t5v0__nand2_1,gf180mcu_fd_sc_mcu7t5v0__nor2_1,gf180mcu_fd_sc_mcu7t5v0__nor3_2,gf180mcu_fd_sc_mcu7t5v0__nor3_4,gf180mcu_fd_sc_mcu7t5v0__or2_1 | fanout983/Z (gf180mcu_fd_sc_mcu7t5v0__buf_1) | instruction/ROM
net798 | 11 | max_ss_125C_4v50 | 3.043846 | 3.0 | -0.043846 | _4363_/A2,_4371_/A2,_6903_/A1,_7041_/A1,_7049_/C,_7058_/C,_7114_/A1,_7121_/B,_7165_/C,_7180_/B,fanout798/Z | gf180mcu_fd_sc_mcu7t5v0__aoi21_1,gf180mcu_fd_sc_mcu7t5v0__aoi221_1,gf180mcu_fd_sc_mcu7t5v0__aoi221_2,gf180mcu_fd_sc_mcu7t5v0__buf_1,gf180mcu_fd_sc_mcu7t5v0__nand2_1,gf180mcu_fd_sc_mcu7t5v0__nor2_1,gf180mcu_fd_sc_mcu7t5v0__nor3_1,gf180mcu_fd_sc_mcu7t5v0__oai21_1 | fanout798/Z (gf180mcu_fd_sc_mcu7t5v0__buf_1) | instruction/ROM
net824 | 11 | max_ss_125C_4v50 | 3.006139 | 3.0 | -0.006139 | _6206_/A2,_6399_/A1,_6422_/A1,_6465_/A1,_6480_/C,_6515_/C,_6530_/A1,_6563_/B,_6579_/A1,_6589_/C,fanout824/Z | gf180mcu_fd_sc_mcu7t5v0__aoi211_1,gf180mcu_fd_sc_mcu7t5v0__aoi21_1,gf180mcu_fd_sc_mcu7t5v0__aoi221_1,gf180mcu_fd_sc_mcu7t5v0__buf_1,gf180mcu_fd_sc_mcu7t5v0__nor2_1,gf180mcu_fd_sc_mcu7t5v0__nor2_2,gf180mcu_fd_sc_mcu7t5v0__nor3_1,gf180mcu_fd_sc_mcu7t5v0__oai221_1,gf180mcu_fd_sc_mcu7t5v0__oai31_1 | fanout824/Z (gf180mcu_fd_sc_mcu7t5v0__buf_1) | data/register-file;instruction/ROM
\u_pochoco_soc.genblk1.g_rom_ram_memory.u_ram.a_rdata_o[9] | 10 | max_ss_125C_4v50 | 3.077087 | 3.0 | -0.077087 | _4448_/A1,_5804_/I1,_6444_/A1,_6860_/A2,_6864_/A2,_7317_/A2,_7382_/A2,_7513_/A2,_7775_/A2,_8476_/Q | gf180mcu_fd_sc_mcu7t5v0__aoi22_1,gf180mcu_fd_sc_mcu7t5v0__dffrnq_1,gf180mcu_fd_sc_mcu7t5v0__mux2_2,gf180mcu_fd_sc_mcu7t5v0__nand2_1,gf180mcu_fd_sc_mcu7t5v0__nor2_1,gf180mcu_fd_sc_mcu7t5v0__nor3_1,gf180mcu_fd_sc_mcu7t5v0__nor3_2,gf180mcu_fd_sc_mcu7t5v0__oai221_1,gf180mcu_fd_sc_mcu7t5v0__or2_1 | _8476_/Q (gf180mcu_fd_sc_mcu7t5v0__dffrnq_1) | data/register-file;instruction/ROM
_3559_ | 9 | max_ss_125C_4v50,min_ss_125C_4v50,nom_ss_125C_4v50 | 3.740661 | 3.0 | -0.740661 | _7183_/ZN,fanout27/I,fanout29/I | gf180mcu_fd_sc_mcu7t5v0__aoi21_1,gf180mcu_fd_sc_mcu7t5v0__buf_1 | _7183_/ZN (gf180mcu_fd_sc_mcu7t5v0__aoi21_1) | instruction/ROM
_3439_ | 9 | max_ss_125C_4v50,min_ss_125C_4v50,nom_ss_125C_4v50 | 3.657641 | 3.0 | -0.657642 | _7045_/ZN,fanout90/I,fanout92/I | gf180mcu_fd_sc_mcu7t5v0__aoi211_2,gf180mcu_fd_sc_mcu7t5v0__buf_1 | _7045_/ZN (gf180mcu_fd_sc_mcu7t5v0__aoi211_2) | instruction/ROM
_3503_ | 9 | max_ss_125C_4v50,min_ss_125C_4v50,nom_ss_125C_4v50 | 3.533599 | 3.0 | -0.533599 | _7118_/ZN,fanout57/I,fanout59/I | gf180mcu_fd_sc_mcu7t5v0__aoi221_2,gf180mcu_fd_sc_mcu7t5v0__buf_1 | _7118_/ZN (gf180mcu_fd_sc_mcu7t5v0__aoi221_2) | instruction/ROM
\u_pochoco_soc.genblk1.g_rom_ram_memory.u_ram.a_rdata_o[22] | 9 | max_ss_125C_4v50 | 3.241772 | 3.0 | -0.241772 | _4448_/B2,_4620_/A1,_4964_/A2,_4970_/A2,_4975_/A2,_4980_/A2,_5804_/I0,_6662_/A1,_8489_/Q | gf180mcu_fd_sc_mcu7t5v0__aoi22_1,gf180mcu_fd_sc_mcu7t5v0__dffrnq_1,gf180mcu_fd_sc_mcu7t5v0__mux2_2,gf180mcu_fd_sc_mcu7t5v0__nand2_1,gf180mcu_fd_sc_mcu7t5v0__oai22_1,gf180mcu_fd_sc_mcu7t5v0__or2_1 | _8489_/Q (gf180mcu_fd_sc_mcu7t5v0__dffrnq_1) | data/register-file;instruction/ROM
\u_pochoco_soc.u_core.pc_id[17] | 9 | max_ss_125C_4v50 | 3.068303 | 3.0 | -0.068303 | _4608_/A1,_6009_/C,_6010_/A1,_7076_/A1,_7077_/A1,_7083_/A2,_7084_/A1,_8131_/I0,_9028_/Q | gf180mcu_fd_sc_mcu7t5v0__and3_1,gf180mcu_fd_sc_mcu7t5v0__aoi21_1,gf180mcu_fd_sc_mcu7t5v0__dffrnq_1,gf180mcu_fd_sc_mcu7t5v0__mux2_2,gf180mcu_fd_sc_mcu7t5v0__nand2_1,gf180mcu_fd_sc_mcu7t5v0__oai211_1,gf180mcu_fd_sc_mcu7t5v0__oai21_1,gf180mcu_fd_sc_mcu7t5v0__xnor2_1 | _9028_/Q (gf180mcu_fd_sc_mcu7t5v0__dffrnq_1) | instruction/ROM
_1397_ | 8 | max_ss_125C_4v50,nom_ss_125C_4v50 | 3.384149 | 3.0 | -0.384149 | _4782_/ZN,_4789_/A1,_6015_/I0,_7078_/A2 | gf180mcu_fd_sc_mcu7t5v0__aoi211_1,gf180mcu_fd_sc_mcu7t5v0__mux2_2,gf180mcu_fd_sc_mcu7t5v0__nor2_1,gf180mcu_fd_sc_mcu7t5v0__oai21_1 | _4782_/ZN (gf180mcu_fd_sc_mcu7t5v0__oai21_1) | instruction/ROM
_2349_ | 8 | max_ss_125C_4v50 | 3.228266 | 3.0 | -0.228267 | _5849_/ZN,_6251_/A1,_6290_/A2,_6321_/B2,_6407_/A1,_6416_/A1,_6440_/A2,_6640_/A2 | gf180mcu_fd_sc_mcu7t5v0__aoi21_1,gf180mcu_fd_sc_mcu7t5v0__aoi22_1,gf180mcu_fd_sc_mcu7t5v0__nand2_1,gf180mcu_fd_sc_mcu7t5v0__nand3_1,gf180mcu_fd_sc_mcu7t5v0__oai211_1,gf180mcu_fd_sc_mcu7t5v0__oai21_1 | _5849_/ZN (gf180mcu_fd_sc_mcu7t5v0__nand2_1) | instruction/ROM
\u_pochoco_soc.data_wdata[2] | 8 | max_ss_125C_4v50 | 3.200084 | 3.0 | -0.200084 | _4449_/A1,_6776_/A1,_6777_/A1,_6854_/I1,_8263_/I0,_8269_/I0,_8384_/I0,_9247_/Q | gf180mcu_fd_sc_mcu7t5v0__and2_1,gf180mcu_fd_sc_mcu7t5v0__dffrnq_1,gf180mcu_fd_sc_mcu7t5v0__mux2_2,gf180mcu_fd_sc_mcu7t5v0__nand2_1 | _9247_/Q (gf180mcu_fd_sc_mcu7t5v0__dffrnq_1) | data/register-file;instruction/ROM
\u_pochoco_soc.data_wdata[3] | 8 | max_ss_125C_4v50 | 3.169293 | 3.0 | -0.169293 | _4440_/A1,_6781_/A1,_6782_/A1,_6855_/I1,_8264_/I0,_8270_/I0,_8385_/I0,_9248_/Q | gf180mcu_fd_sc_mcu7t5v0__and2_1,gf180mcu_fd_sc_mcu7t5v0__dffrnq_1,gf180mcu_fd_sc_mcu7t5v0__mux2_2,gf180mcu_fd_sc_mcu7t5v0__nand2_1 | _9248_/Q (gf180mcu_fd_sc_mcu7t5v0__dffrnq_1) | data/register-file;instruction/ROM
_2768_ | 8 | max_ss_125C_4v50 | 3.07442 | 3.0 | -0.07442 | _6301_/ZN,_6302_/A3,_6325_/A2,_6387_/A4,_6426_/A3,_6621_/A1,_6637_/A1,_6699_/A1 | gf180mcu_fd_sc_mcu7t5v0__and2_1,gf180mcu_fd_sc_mcu7t5v0__and4_1,gf180mcu_fd_sc_mcu7t5v0__aoi21_1,gf180mcu_fd_sc_mcu7t5v0__nand2_1,gf180mcu_fd_sc_mcu7t5v0__nand3_1,gf180mcu_fd_sc_mcu7t5v0__nor2_1,gf180mcu_fd_sc_mcu7t5v0__nor3_1,gf180mcu_fd_sc_mcu7t5v0__or3_1 | _6301_/ZN (gf180mcu_fd_sc_mcu7t5v0__nand2_1) | instruction/ROM
_3543_ | 6 | max_ss_125C_4v50,min_ss_125C_4v50,nom_ss_125C_4v50 | 4.173693 | 3.0 | -1.173693 | _7165_/ZN,_7169_/B1 | gf180mcu_fd_sc_mcu7t5v0__aoi221_1,gf180mcu_fd_sc_mcu7t5v0__oai22_1 | _7165_/ZN (gf180mcu_fd_sc_mcu7t5v0__aoi221_1) | instruction/ROM
_3110_ | 6 | max_ss_125C_4v50,min_ss_125C_4v50,nom_ss_125C_4v50 | 3.754658 | 3.0 | -0.754658 | _6661_/ZN,_6662_/B2 | gf180mcu_fd_sc_mcu7t5v0__aoi221_1,gf180mcu_fd_sc_mcu7t5v0__oai22_1 | _6661_/ZN (gf180mcu_fd_sc_mcu7t5v0__aoi221_1) | data/register-file;instruction/ROM
_3554_ | 6 | max_ss_125C_4v50,nom_ss_125C_4v50 | 3.608687 | 3.0 | -0.608687 | _7177_/ZN,fanout30/I,fanout32/I | gf180mcu_fd_sc_mcu7t5v0__aoi211_2,gf180mcu_fd_sc_mcu7t5v0__buf_1 | _7177_/ZN (gf180mcu_fd_sc_mcu7t5v0__aoi211_2) | instruction/ROM
_3322_ | 6 | max_ss_125C_4v50,nom_ss_125C_4v50 | 3.472008 | 3.0 | -0.472009 | _6918_/ZN,fanout133/I,fanout135/I | gf180mcu_fd_sc_mcu7t5v0__aoi211_2,gf180mcu_fd_sc_mcu7t5v0__buf_1 | _6918_/ZN (gf180mcu_fd_sc_mcu7t5v0__aoi211_2) | instruction/ROM
_3541_ | 6 | max_ss_125C_4v50,nom_ss_125C_4v50 | 3.409966 | 3.0 | -0.409966 | _7162_/ZN,fanout36/I,fanout38/I | gf180mcu_fd_sc_mcu7t5v0__aoi221_2,gf180mcu_fd_sc_mcu7t5v0__buf_1 | _7162_/ZN (gf180mcu_fd_sc_mcu7t5v0__aoi221_2) | instruction/ROM
_2686_ | 6 | max_ss_125C_4v50 | 3.088899 | 3.0 | -0.088899 | _6217_/ZN,_6219_/B,_6319_/A2,_6380_/A1,_6411_/A1,_6586_/A2 | gf180mcu_fd_sc_mcu7t5v0__aoi21_1,gf180mcu_fd_sc_mcu7t5v0__aoi22_1,gf180mcu_fd_sc_mcu7t5v0__nand2_1,gf180mcu_fd_sc_mcu7t5v0__nor2_1 | _6217_/ZN (gf180mcu_fd_sc_mcu7t5v0__nor2_1) | instruction/ROM
_2330_ | 6 | max_ss_125C_4v50 | 3.056154 | 3.0 | -0.056154 | _5829_/ZN,_6281_/A1,_6329_/A2,_6330_/A1,_6508_/A1,_6676_/A1 | gf180mcu_fd_sc_mcu7t5v0__nand2_1,gf180mcu_fd_sc_mcu7t5v0__nor2_1,gf180mcu_fd_sc_mcu7t5v0__oai21_1 | _5829_/ZN (gf180mcu_fd_sc_mcu7t5v0__nor2_1) | instruction/ROM
_1561_ | 5 | max_ss_125C_4v50 | 3.201579 | 3.0 | -0.201579 | _4979_/ZN,fanout750/I,fanout753/I,fanout755/I,fanout758/I | gf180mcu_fd_sc_mcu7t5v0__buf_1,gf180mcu_fd_sc_mcu7t5v0__nor2_2 | _4979_/ZN (gf180mcu_fd_sc_mcu7t5v0__nor2_2) | instruction/ROM
_1904_ | 5 | max_ss_125C_4v50 | 3.068299 | 3.0 | -0.068299 | _5354_/ZN,fanout642/I,fanout645/I,fanout647/I,fanout650/I | gf180mcu_fd_sc_mcu7t5v0__buf_1,gf180mcu_fd_sc_mcu7t5v0__nor2_2 | _5354_/ZN (gf180mcu_fd_sc_mcu7t5v0__nor2_2) | instruction/ROM
_2886_ | 4 | max_ss_125C_4v50,nom_ss_125C_4v50 | 3.555575 | 3.0 | -0.555575 | _6423_/ZN,_6424_/B1 | gf180mcu_fd_sc_mcu7t5v0__aoi211_1,gf180mcu_fd_sc_mcu7t5v0__oai32_1 | _6423_/ZN (gf180mcu_fd_sc_mcu7t5v0__aoi211_1) | instruction/ROM
_1378_ | 4 | max_ss_125C_4v50 | 3.155403 | 3.0 | -0.155403 | _4763_/ZN,_4764_/A4,_5991_/A1,_7062_/A2 | gf180mcu_fd_sc_mcu7t5v0__aoi211_1,gf180mcu_fd_sc_mcu7t5v0__nor4_1,gf180mcu_fd_sc_mcu7t5v0__oai21_1,gf180mcu_fd_sc_mcu7t5v0__oai221_1 | _4763_/ZN (gf180mcu_fd_sc_mcu7t5v0__oai221_1) | instruction/ROM
_1354_ | 4 | max_ss_125C_4v50 | 3.150199 | 3.0 | -0.1502 | _4739_/ZN,_4764_/A1,_6130_/A1,_7155_/A2 | gf180mcu_fd_sc_mcu7t5v0__aoi211_2,gf180mcu_fd_sc_mcu7t5v0__nor4_1,gf180mcu_fd_sc_mcu7t5v0__oai211_1,gf180mcu_fd_sc_mcu7t5v0__oai21_1 | _4739_/ZN (gf180mcu_fd_sc_mcu7t5v0__oai21_1) | instruction/ROM
_1464_ | 4 | max_ss_125C_4v50 | 3.035 | 3.0 | -0.035 | _4849_/ZN,_4861_/A2,_5891_/A1,_7000_/B2 | gf180mcu_fd_sc_mcu7t5v0__aoi211_1,gf180mcu_fd_sc_mcu7t5v0__nor2_1,gf180mcu_fd_sc_mcu7t5v0__nor4_1,gf180mcu_fd_sc_mcu7t5v0__oai32_1 | _4849_/ZN (gf180mcu_fd_sc_mcu7t5v0__aoi211_1) | instruction/ROM
_3407_ | 3 | max_ss_125C_4v50 | 3.282549 | 3.0 | -0.282549 | _7009_/ZN,fanout104/I,fanout106/I | gf180mcu_fd_sc_mcu7t5v0__buf_1,gf180mcu_fd_sc_mcu7t5v0__nor2_1 | _7009_/ZN (gf180mcu_fd_sc_mcu7t5v0__nor2_1) | instruction/ROM
_3462_ | 3 | max_ss_125C_4v50 | 3.163914 | 3.0 | -0.163914 | _7071_/ZN,fanout79/I,fanout81/I | gf180mcu_fd_sc_mcu7t5v0__aoi221_2,gf180mcu_fd_sc_mcu7t5v0__buf_1 | _7071_/ZN (gf180mcu_fd_sc_mcu7t5v0__aoi221_2) | instruction/ROM
_3400_ | 3 | max_ss_125C_4v50 | 3.143076 | 3.0 | -0.143076 | _7001_/ZN,fanout107/I,fanout109/I | gf180mcu_fd_sc_mcu7t5v0__aoi21_1,gf180mcu_fd_sc_mcu7t5v0__buf_1 | _7001_/ZN (gf180mcu_fd_sc_mcu7t5v0__aoi21_1) | instruction/ROM
_3482_ | 3 | max_ss_125C_4v50 | 3.124404 | 3.0 | -0.124404 | _7094_/ZN,fanout68/I,fanout70/I | gf180mcu_fd_sc_mcu7t5v0__buf_1,gf180mcu_fd_sc_mcu7t5v0__nor2_1 | _7094_/ZN (gf180mcu_fd_sc_mcu7t5v0__nor2_1) | instruction/ROM
_3336_ | 3 | max_ss_125C_4v50 | 3.077713 | 3.0 | -0.077713 | _6933_/ZN,fanout130/I,fanout132/I | gf180mcu_fd_sc_mcu7t5v0__buf_1,gf180mcu_fd_sc_mcu7t5v0__oai22_2 | _6933_/ZN (gf180mcu_fd_sc_mcu7t5v0__oai22_2) | instruction/ROM
_3298_ | 3 | max_ss_125C_4v50 | 3.022191 | 3.0 | -0.022191 | _6892_/ZN,fanout113/I,fanout115/I | gf180mcu_fd_sc_mcu7t5v0__aoi221_2,gf180mcu_fd_sc_mcu7t5v0__buf_1 | _6892_/ZN (gf180mcu_fd_sc_mcu7t5v0__aoi221_2) | instruction/ROM
_0072_ | 2 | max_ss_125C_4v50 | 3.221984 | 3.0 | -0.221984 | _5187_/ZN,_9262_/D | gf180mcu_fd_sc_mcu7t5v0__aoi22_1,gf180mcu_fd_sc_mcu7t5v0__dffrnq_1 | _5187_/ZN (gf180mcu_fd_sc_mcu7t5v0__aoi22_1) | data/register-file;instruction/ROM
_3521_ | 2 | max_ss_125C_4v50 | 3.168553 | 3.0 | -0.168553 | _7139_/ZN,wire49/I | gf180mcu_fd_sc_mcu7t5v0__aoi211_1,gf180mcu_fd_sc_mcu7t5v0__clkbuf_1 | _7139_/ZN (gf180mcu_fd_sc_mcu7t5v0__aoi211_1) | instruction/ROM
_3399_ | 2 | max_ss_125C_4v50 | 3.144306 | 3.0 | -0.144306 | _7000_/ZN,_7001_/B | gf180mcu_fd_sc_mcu7t5v0__aoi21_1,gf180mcu_fd_sc_mcu7t5v0__oai32_1 | _7000_/ZN (gf180mcu_fd_sc_mcu7t5v0__oai32_1) | instruction/ROM
_1071_ | 2 | max_ss_125C_4v50 | 3.140316 | 3.0 | -0.140316 | _4456_/ZN,_4457_/B | gf180mcu_fd_sc_mcu7t5v0__aoi21_1,gf180mcu_fd_sc_mcu7t5v0__aoi221_1 | _4456_/ZN (gf180mcu_fd_sc_mcu7t5v0__aoi221_1) | data/register-file;instruction/ROM
_0069_ | 2 | max_ss_125C_4v50 | 3.12604 | 3.0 | -0.12604 | _5153_/ZN,_9259_/D | gf180mcu_fd_sc_mcu7t5v0__aoi22_1,gf180mcu_fd_sc_mcu7t5v0__dffrnq_1 | _5153_/ZN (gf180mcu_fd_sc_mcu7t5v0__aoi22_1) | data/register-file;instruction/ROM
