eaponce1/Proyecto3_Arquitectura_de_Computadores_Grupo_1/reports/stage17/group3_slew_violations.csv

corner | line | pin | limit_ns | slew_ns | slack_ns | net | instance | cell | classification
max_ss_125C_4v50 | 288 | _7165_/ZN | 3.0 | 4.173693 | -1.173693 | _3543_ | _7165_ | gf180mcu_fd_sc_mcu7t5v0__aoi221_1 | instruction/ROM
max_ss_125C_4v50 | 289 | _7169_/B1 | 3.0 | 4.173693 | -1.173693 | _3543_ | _7169_ | gf180mcu_fd_sc_mcu7t5v0__oai22_1 | instruction/ROM
max_ss_125C_4v50 | 290 | _6039_/A1 | 3.0 | 4.161633 | -1.161633 | _1427_ | _6039_ | gf180mcu_fd_sc_mcu7t5v0__nand2_1 | instruction/ROM
max_ss_125C_4v50 | 291 | _4812_/ZN | 3.0 | 4.161616 | -1.161616 | _1427_ | _4812_ | gf180mcu_fd_sc_mcu7t5v0__aoi21_1 | instruction/ROM
max_ss_125C_4v50 | 292 | _4895_/A2 | 3.0 | 4.161616 | -1.161616 | _1427_ | _4895_ | gf180mcu_fd_sc_mcu7t5v0__nand3_1 | instruction/ROM
max_ss_125C_4v50 | 293 | _7093_/A2 | 3.0 | 4.161616 | -1.161616 | _1427_ | _7093_ | gf180mcu_fd_sc_mcu7t5v0__oai22_1 | instruction/ROM
max_ss_125C_4v50 | 294 | _6661_/ZN | 3.0 | 3.754658 | -0.754658 | _3110_ | _6661_ | gf180mcu_fd_sc_mcu7t5v0__aoi221_1 | data/register-file;instruction/ROM
max_ss_125C_4v50 | 295 | _6662_/B2 | 3.0 | 3.754658 | -0.754658 | _3110_ | _6662_ | gf180mcu_fd_sc_mcu7t5v0__oai22_1 | data/register-file;instruction/ROM
max_ss_125C_4v50 | 296 | fanout27/I | 3.0 | 3.740661 | -0.740661 | _3559_ | fanout27 | gf180mcu_fd_sc_mcu7t5v0__buf_1 | instruction/ROM
max_ss_125C_4v50 | 297 | fanout29/I | 3.0 | 3.740659 | -0.74066 | _3559_ | fanout29 | gf180mcu_fd_sc_mcu7t5v0__buf_1 | instruction/ROM
max_ss_125C_4v50 | 298 | _7183_/ZN | 3.0 | 3.740636 | -0.740636 | _3559_ | _7183_ | gf180mcu_fd_sc_mcu7t5v0__aoi21_1 | instruction/ROM
max_ss_125C_4v50 | 299 | _6052_/A1 | 3.0 | 3.723507 | -0.723507 | _1502_ | _6052_ | gf180mcu_fd_sc_mcu7t5v0__nor2_1 | instruction/ROM
max_ss_125C_4v50 | 300 | _7102_/A2 | 3.0 | 3.723499 | -0.723499 | _1502_ | _7102_ | gf180mcu_fd_sc_mcu7t5v0__aoi211_2 | instruction/ROM
max_ss_125C_4v50 | 301 | _4894_/A3 | 3.0 | 3.723487 | -0.723487 | _1502_ | _4894_ | gf180mcu_fd_sc_mcu7t5v0__nor4_1 | instruction/ROM
max_ss_125C_4v50 | 302 | _4887_/ZN | 3.0 | 3.723472 | -0.723472 | _1502_ | _4887_ | gf180mcu_fd_sc_mcu7t5v0__oai211_1 | instruction/ROM
max_ss_125C_4v50 | 303 | fanout348/I | 3.0 | 3.684752 | -0.684752 | net360 | fanout348 | gf180mcu_fd_sc_mcu7t5v0__buf_1 | instruction/ROM
max_ss_125C_4v50 | 304 | fanout345/I | 3.0 | 3.684739 | -0.684739 | net360 | fanout345 | gf180mcu_fd_sc_mcu7t5v0__buf_1 | instruction/ROM
max_ss_125C_4v50 | 305 | fanout349/I | 3.0 | 3.684724 | -0.684724 | net360 | fanout349 | gf180mcu_fd_sc_mcu7t5v0__buf_1 | instruction/ROM
max_ss_125C_4v50 | 306 | fanout351/I | 3.0 | 3.6847 | -0.6847 | net360 | fanout351 | gf180mcu_fd_sc_mcu7t5v0__buf_1 | instruction/ROM
max_ss_125C_4v50 | 307 | fanout358/I | 3.0 | 3.684583 | -0.684583 | net360 | fanout358 | gf180mcu_fd_sc_mcu7t5v0__buf_1 | instruction/ROM
max_ss_125C_4v50 | 308 | fanout360/Z | 3.0 | 3.684583 | -0.684583 | net360 | fanout360 | gf180mcu_fd_sc_mcu7t5v0__buf_1 | instruction/ROM
max_ss_125C_4v50 | 309 | fanout90/I | 3.0 | 3.657641 | -0.657642 | _3439_ | fanout90 | gf180mcu_fd_sc_mcu7t5v0__buf_1 | instruction/ROM
max_ss_125C_4v50 | 310 | fanout92/I | 3.0 | 3.657641 | -0.657641 | _3439_ | fanout92 | gf180mcu_fd_sc_mcu7t5v0__buf_1 | instruction/ROM
max_ss_125C_4v50 | 311 | _7045_/ZN | 3.0 | 3.65764 | -0.65764 | _3439_ | _7045_ | gf180mcu_fd_sc_mcu7t5v0__aoi211_2 | instruction/ROM
max_ss_125C_4v50 | 312 | fanout30/I | 3.0 | 3.608687 | -0.608687 | _3554_ | fanout30 | gf180mcu_fd_sc_mcu7t5v0__buf_1 | instruction/ROM
max_ss_125C_4v50 | 313 | fanout32/I | 3.0 | 3.608687 | -0.608688 | _3554_ | fanout32 | gf180mcu_fd_sc_mcu7t5v0__buf_1 | instruction/ROM
max_ss_125C_4v50 | 314 | _7177_/ZN | 3.0 | 3.608684 | -0.608684 | _3554_ | _7177_ | gf180mcu_fd_sc_mcu7t5v0__aoi211_2 | instruction/ROM
max_ss_125C_4v50 | 315 | ANTENNA_1/I | 3.0 | 3.598844 | -0.598844 | net286 | ANTENNA_1 | gf180mcu_fd_sc_mcu7t5v0__antenna | data/register-file;instruction/ROM
max_ss_125C_4v50 | 316 | fanout277/I | 3.0 | 3.598843 | -0.598843 | net286 | fanout277 | gf180mcu_fd_sc_mcu7t5v0__buf_1 | data/register-file;instruction/ROM
max_ss_125C_4v50 | 317 | fanout279/I | 3.0 | 3.598836 | -0.598836 | net286 | fanout279 | gf180mcu_fd_sc_mcu7t5v0__buf_1 | data/register-file;instruction/ROM
max_ss_125C_4v50 | 318 | fanout281/I | 3.0 | 3.598818 | -0.598818 | net286 | fanout281 | gf180mcu_fd_sc_mcu7t5v0__buf_1 | data/register-file;instruction/ROM
max_ss_125C_4v50 | 319 | fanout285/I | 3.0 | 3.598791 | -0.598791 | net286 | fanout285 | gf180mcu_fd_sc_mcu7t5v0__buf_1 | data/register-file;instruction/ROM
max_ss_125C_4v50 | 320 | fanout283/I | 3.0 | 3.598761 | -0.598761 | net286 | fanout283 | gf180mcu_fd_sc_mcu7t5v0__buf_1 | data/register-file;instruction/ROM
max_ss_125C_4v50 | 321 | fanout286/Z | 3.0 | 3.598761 | -0.598761 | net286 | fanout286 | gf180mcu_fd_sc_mcu7t5v0__buf_1 | data/register-file;instruction/ROM
max_ss_125C_4v50 | 322 | _4499_/A1 | 3.0 | 3.566474 | -0.566474 | \u_pochoco_soc.data_wdata[6] | _4499_ | gf180mcu_fd_sc_mcu7t5v0__aoi22_1 | data/register-file;instruction/ROM
max_ss_125C_4v50 | 323 | _8388_/I0 | 3.0 | 3.566453 | -0.566454 | \u_pochoco_soc.data_wdata[6] | _8388_ | gf180mcu_fd_sc_mcu7t5v0__mux2_2 | data/register-file;instruction/ROM
max_ss_125C_4v50 | 324 | _8273_/I0 | 3.0 | 3.566436 | -0.566436 | \u_pochoco_soc.data_wdata[6] | _8273_ | gf180mcu_fd_sc_mcu7t5v0__mux2_2 | data/register-file;instruction/ROM
max_ss_125C_4v50 | 325 | _6858_/I1 | 3.0 | 3.566365 | -0.566365 | \u_pochoco_soc.data_wdata[6] | _6858_ | gf180mcu_fd_sc_mcu7t5v0__mux2_2 | data/register-file;instruction/ROM
max_ss_125C_4v50 | 326 | _6796_/A1 | 3.0 | 3.566304 | -0.566305 | \u_pochoco_soc.data_wdata[6] | _6796_ | gf180mcu_fd_sc_mcu7t5v0__nand2_1 | data/register-file;instruction/ROM
max_ss_125C_4v50 | 327 | _6795_/A1 | 3.0 | 3.566255 | -0.566255 | \u_pochoco_soc.data_wdata[6] | _6795_ | gf180mcu_fd_sc_mcu7t5v0__and2_1 | data/register-file;instruction/ROM
max_ss_125C_4v50 | 328 | _9251_/Q | 3.0 | 3.566176 | -0.566176 | \u_pochoco_soc.data_wdata[6] | _9251_ | gf180mcu_fd_sc_mcu7t5v0__dffrnq_1 | data/register-file;instruction/ROM
max_ss_125C_4v50 | 329 | _6423_/ZN | 3.0 | 3.555575 | -0.555575 | _2886_ | _6423_ | gf180mcu_fd_sc_mcu7t5v0__aoi211_1 | instruction/ROM
max_ss_125C_4v50 | 330 | _6424_/B1 | 3.0 | 3.555575 | -0.555575 | _2886_ | _6424_ | gf180mcu_fd_sc_mcu7t5v0__oai32_1 | instruction/ROM
max_ss_125C_4v50 | 331 | fanout57/I | 3.0 | 3.533598 | -0.533598 | _3503_ | fanout57 | gf180mcu_fd_sc_mcu7t5v0__buf_1 | instruction/ROM
max_ss_125C_4v50 | 332 | fanout59/I | 3.0 | 3.533599 | -0.533599 | _3503_ | fanout59 | gf180mcu_fd_sc_mcu7t5v0__buf_1 | instruction/ROM
max_ss_125C_4v50 | 333 | _7118_/ZN | 3.0 | 3.533596 | -0.533596 | _3503_ | _7118_ | gf180mcu_fd_sc_mcu7t5v0__aoi221_2 | instruction/ROM
max_ss_125C_4v50 | 334 | fanout133/I | 3.0 | 3.472008 | -0.472009 | _3322_ | fanout133 | gf180mcu_fd_sc_mcu7t5v0__buf_1 | instruction/ROM
max_ss_125C_4v50 | 335 | fanout135/I | 3.0 | 3.472008 | -0.472009 | _3322_ | fanout135 | gf180mcu_fd_sc_mcu7t5v0__buf_1 | instruction/ROM
max_ss_125C_4v50 | 336 | _6918_/ZN | 3.0 | 3.472005 | -0.472005 | _3322_ | _6918_ | gf180mcu_fd_sc_mcu7t5v0__aoi211_2 | instruction/ROM
max_ss_125C_4v50 | 337 | _6629_/A2 | 3.0 | 3.427487 | -0.427487 | _2796_ | _6629_ | gf180mcu_fd_sc_mcu7t5v0__oai21_1 | instruction/ROM
max_ss_125C_4v50 | 338 | _6332_/A2 | 3.0 | 3.427485 | -0.427485 | _2796_ | _6332_ | gf180mcu_fd_sc_mcu7t5v0__nand2_1 | instruction/ROM
max_ss_125C_4v50 | 339 | _6421_/A2 | 3.0 | 3.427482 | -0.427483 | _2796_ | _6421_ | gf180mcu_fd_sc_mcu7t5v0__aoi211_1 | instruction/ROM
max_ss_125C_4v50 | 340 | _6330_/ZN | 3.0 | 3.427467 | -0.427467 | _2796_ | _6330_ | gf180mcu_fd_sc_mcu7t5v0__nor2_1 | instruction/ROM
max_ss_125C_4v50 | 341 | _6510_/A2 | 3.0 | 3.427467 | -0.427467 | _2796_ | _6510_ | gf180mcu_fd_sc_mcu7t5v0__nor2_1 | instruction/ROM
max_ss_125C_4v50 | 342 | _6696_/A3 | 3.0 | 3.427467 | -0.427467 | _2796_ | _6696_ | gf180mcu_fd_sc_mcu7t5v0__nand4_1 | instruction/ROM
max_ss_125C_4v50 | 343 | _6415_/ZN | 3.0 | 3.425689 | -0.425689 | _2878_ | _6415_ | gf180mcu_fd_sc_mcu7t5v0__nor2_1 | instruction/ROM
max_ss_125C_4v50 | 344 | _6416_/A2 | 3.0 | 3.425689 | -0.425689 | _2878_ | _6416_ | gf180mcu_fd_sc_mcu7t5v0__aoi21_1 | instruction/ROM
max_ss_125C_4v50 | 345 | _6553_/A2 | 3.0 | 3.425689 | -0.425689 | _2878_ | _6553_ | gf180mcu_fd_sc_mcu7t5v0__aoi21_1 | instruction/ROM
max_ss_125C_4v50 | 346 | _6610_/A3 | 3.0 | 3.425689 | -0.425689 | _2878_ | _6610_ | gf180mcu_fd_sc_mcu7t5v0__nand3_1 | instruction/ROM
max_ss_125C_4v50 | 347 | _6611_/A2 | 3.0 | 3.425689 | -0.425689 | _2878_ | _6611_ | gf180mcu_fd_sc_mcu7t5v0__xor2_1 | instruction/ROM
max_ss_125C_4v50 | 348 | _6647_/B1 | 3.0 | 3.425689 | -0.425689 | _2878_ | _6647_ | gf180mcu_fd_sc_mcu7t5v0__aoi221_1 | instruction/ROM
max_ss_125C_4v50 | 349 | fanout38/I | 3.0 | 3.409966 | -0.409966 | _3541_ | fanout38 | gf180mcu_fd_sc_mcu7t5v0__buf_1 | instruction/ROM
max_ss_125C_4v50 | 350 | fanout36/I | 3.0 | 3.409965 | -0.409965 | _3541_ | fanout36 | gf180mcu_fd_sc_mcu7t5v0__buf_1 | instruction/ROM
max_ss_125C_4v50 | 351 | _7162_/ZN | 3.0 | 3.409964 | -0.409964 | _3541_ | _7162_ | gf180mcu_fd_sc_mcu7t5v0__aoi221_2 | instruction/ROM
max_ss_125C_4v50 | 352 | _6015_/I0 | 3.0 | 3.384149 | -0.384149 | _1397_ | _6015_ | gf180mcu_fd_sc_mcu7t5v0__mux2_2 | instruction/ROM
max_ss_125C_4v50 | 353 | _4782_/ZN | 3.0 | 3.384135 | -0.384135 | _1397_ | _4782_ | gf180mcu_fd_sc_mcu7t5v0__oai21_1 | instruction/ROM
max_ss_125C_4v50 | 354 | _4789_/A1 | 3.0 | 3.384135 | -0.384135 | _1397_ | _4789_ | gf180mcu_fd_sc_mcu7t5v0__nor2_1 | instruction/ROM
max_ss_125C_4v50 | 355 | _7078_/A2 | 3.0 | 3.384135 | -0.384135 | _1397_ | _7078_ | gf180mcu_fd_sc_mcu7t5v0__aoi211_1 | instruction/ROM
max_ss_125C_4v50 | 356 | _4479_/A1 | 3.0 | 3.374862 | -0.374862 | \u_pochoco_soc.data_wdata[5] | _4479_ | gf180mcu_fd_sc_mcu7t5v0__aoi22_1 | data/register-file;instruction/ROM
max_ss_125C_4v50 | 357 | _8387_/I0 | 3.0 | 3.374846 | -0.374846 | \u_pochoco_soc.data_wdata[5] | _8387_ | gf180mcu_fd_sc_mcu7t5v0__mux2_2 | data/register-file;instruction/ROM
max_ss_125C_4v50 | 358 | _8272_/I0 | 3.0 | 3.374823 | -0.374823 | \u_pochoco_soc.data_wdata[5] | _8272_ | gf180mcu_fd_sc_mcu7t5v0__mux2_2 | data/register-file;instruction/ROM
max_ss_125C_4v50 | 359 | _6857_/I1 | 3.0 | 3.37477 | -0.37477 | \u_pochoco_soc.data_wdata[5] | _6857_ | gf180mcu_fd_sc_mcu7t5v0__mux2_2 | data/register-file;instruction/ROM
max_ss_125C_4v50 | 360 | _6791_/A1 | 3.0 | 3.374676 | -0.374676 | \u_pochoco_soc.data_wdata[5] | _6791_ | gf180mcu_fd_sc_mcu7t5v0__nand2_1 | data/register-file;instruction/ROM
max_ss_125C_4v50 | 361 | _6790_/A1 | 3.0 | 3.374612 | -0.374612 | \u_pochoco_soc.data_wdata[5] | _6790_ | gf180mcu_fd_sc_mcu7t5v0__and2_1 | data/register-file;instruction/ROM
max_ss_125C_4v50 | 362 | _9250_/Q | 3.0 | 3.374566 | -0.374566 | \u_pochoco_soc.data_wdata[5] | _9250_ | gf180mcu_fd_sc_mcu7t5v0__dffrnq_1 | data/register-file;instruction/ROM
max_ss_125C_4v50 | 363 | fanout106/I | 3.0 | 3.282549 | -0.282549 | _3407_ | fanout106 | gf180mcu_fd_sc_mcu7t5v0__buf_1 | instruction/ROM
max_ss_125C_4v50 | 364 | fanout104/I | 3.0 | 3.282547 | -0.282547 | _3407_ | fanout104 | gf180mcu_fd_sc_mcu7t5v0__buf_1 | instruction/ROM
max_ss_125C_4v50 | 365 | _7009_/ZN | 3.0 | 3.282525 | -0.282525 | _3407_ | _7009_ | gf180mcu_fd_sc_mcu7t5v0__nor2_1 | instruction/ROM
max_ss_125C_4v50 | 366 | _6575_/A2 | 3.0 | 3.253336 | -0.253336 | _2750_ | _6575_ | gf180mcu_fd_sc_mcu7t5v0__nand3_1 | instruction/ROM
max_ss_125C_4v50 | 367 | _6557_/B | 3.0 | 3.253334 | -0.253334 | _2750_ | _6557_ | gf180mcu_fd_sc_mcu7t5v0__oai211_1 | instruction/ROM
max_ss_125C_4v50 | 368 | _6283_/ZN | 3.0 | 3.253322 | -0.253322 | _2750_ | _6283_ | gf180mcu_fd_sc_mcu7t5v0__nor2_1 | instruction/ROM
max_ss_125C_4v50 | 369 | _6488_/A1 | 3.0 | 3.253322 | -0.253322 | _2750_ | _6488_ | gf180mcu_fd_sc_mcu7t5v0__nand3_1 | instruction/ROM
max_ss_125C_4v50 | 370 | _6496_/B | 3.0 | 3.253322 | -0.253322 | _2750_ | _6496_ | gf180mcu_fd_sc_mcu7t5v0__oai21_1 | instruction/ROM
max_ss_125C_4v50 | 371 | _6587_/C | 3.0 | 3.253322 | -0.253322 | _2750_ | _6587_ | gf180mcu_fd_sc_mcu7t5v0__oai211_1 | instruction/ROM
max_ss_125C_4v50 | 372 | _6720_/A1 | 3.0 | 3.253322 | -0.253322 | _2750_ | _6720_ | gf180mcu_fd_sc_mcu7t5v0__nand3_1 | instruction/ROM
max_ss_125C_4v50 | 373 | _4970_/A2 | 3.0 | 3.241772 | -0.241772 | \u_pochoco_soc.genblk1.g_rom_ram_memory.u_ram.a_rdata_o[22] | _4970_ | gf180mcu_fd_sc_mcu7t5v0__nand2_1 | data/register-file;instruction/ROM
max_ss_125C_4v50 | 374 | _4964_/A2 | 3.0 | 3.241772 | -0.241772 | \u_pochoco_soc.genblk1.g_rom_ram_memory.u_ram.a_rdata_o[22] | _4964_ | gf180mcu_fd_sc_mcu7t5v0__or2_1 | data/register-file;instruction/ROM
max_ss_125C_4v50 | 375 | _4975_/A2 | 3.0 | 3.241771 | -0.241771 | \u_pochoco_soc.genblk1.g_rom_ram_memory.u_ram.a_rdata_o[22] | _4975_ | gf180mcu_fd_sc_mcu7t5v0__nand2_1 | data/register-file;instruction/ROM
max_ss_125C_4v50 | 376 | _4980_/A2 | 3.0 | 3.24177 | -0.24177 | \u_pochoco_soc.genblk1.g_rom_ram_memory.u_ram.a_rdata_o[22] | _4980_ | gf180mcu_fd_sc_mcu7t5v0__or2_1 | data/register-file;instruction/ROM
max_ss_125C_4v50 | 377 | _4620_/A1 | 3.0 | 3.241746 | -0.241747 | \u_pochoco_soc.genblk1.g_rom_ram_memory.u_ram.a_rdata_o[22] | _4620_ | gf180mcu_fd_sc_mcu7t5v0__nand2_1 | data/register-file;instruction/ROM
max_ss_125C_4v50 | 378 | _5804_/I0 | 3.0 | 3.241655 | -0.241655 | \u_pochoco_soc.genblk1.g_rom_ram_memory.u_ram.a_rdata_o[22] | _5804_ | gf180mcu_fd_sc_mcu7t5v0__mux2_2 | data/register-file;instruction/ROM
max_ss_125C_4v50 | 379 | _4448_/B2 | 3.0 | 3.241649 | -0.241649 | \u_pochoco_soc.genblk1.g_rom_ram_memory.u_ram.a_rdata_o[22] | _4448_ | gf180mcu_fd_sc_mcu7t5v0__aoi22_1 | data/register-file;instruction/ROM
max_ss_125C_4v50 | 380 | _6662_/A1 | 3.0 | 3.241628 | -0.241628 | \u_pochoco_soc.genblk1.g_rom_ram_memory.u_ram.a_rdata_o[22] | _6662_ | gf180mcu_fd_sc_mcu7t5v0__oai22_1 | data/register-file;instruction/ROM
max_ss_125C_4v50 | 381 | _8489_/Q | 3.0 | 3.241628 | -0.241628 | \u_pochoco_soc.genblk1.g_rom_ram_memory.u_ram.a_rdata_o[22] | _8489_ | gf180mcu_fd_sc_mcu7t5v0__dffrnq_1 | data/register-file;instruction/ROM
max_ss_125C_4v50 | 382 | _6640_/A2 | 3.0 | 3.228266 | -0.228267 | _2349_ | _6640_ | gf180mcu_fd_sc_mcu7t5v0__oai211_1 | instruction/ROM
max_ss_125C_4v50 | 383 | _6251_/A1 | 3.0 | 3.228265 | -0.228265 | _2349_ | _6251_ | gf180mcu_fd_sc_mcu7t5v0__nand2_1 | instruction/ROM
max_ss_125C_4v50 | 384 | _6416_/A1 | 3.0 | 3.228263 | -0.228263 | _2349_ | _6416_ | gf180mcu_fd_sc_mcu7t5v0__aoi21_1 | instruction/ROM
max_ss_125C_4v50 | 385 | _6440_/A2 | 3.0 | 3.228262 | -0.228262 | _2349_ | _6440_ | gf180mcu_fd_sc_mcu7t5v0__oai21_1 | instruction/ROM
max_ss_125C_4v50 | 386 | _6290_/A2 | 3.0 | 3.228256 | -0.228257 | _2349_ | _6290_ | gf180mcu_fd_sc_mcu7t5v0__nand3_1 | instruction/ROM
max_ss_125C_4v50 | 387 | _6321_/B2 | 3.0 | 3.228249 | -0.228249 | _2349_ | _6321_ | gf180mcu_fd_sc_mcu7t5v0__aoi22_1 | instruction/ROM
max_ss_125C_4v50 | 388 | _6407_/A1 | 3.0 | 3.228249 | -0.228249 | _2349_ | _6407_ | gf180mcu_fd_sc_mcu7t5v0__nand2_1 | instruction/ROM
max_ss_125C_4v50 | 389 | _5849_/ZN | 3.0 | 3.228236 | -0.228237 | _2349_ | _5849_ | gf180mcu_fd_sc_mcu7t5v0__nand2_1 | instruction/ROM
max_ss_125C_4v50 | 390 | _9262_/D | 3.0 | 3.221984 | -0.221984 | _0072_ | _9262_ | gf180mcu_fd_sc_mcu7t5v0__dffrnq_1 | data/register-file;instruction/ROM
max_ss_125C_4v50 | 391 | _5187_/ZN | 3.0 | 3.221982 | -0.221982 | _0072_ | _5187_ | gf180mcu_fd_sc_mcu7t5v0__aoi22_1 | data/register-file;instruction/ROM
max_ss_125C_4v50 | 392 | fanout750/I | 3.0 | 3.201579 | -0.201579 | _1561_ | fanout750 | gf180mcu_fd_sc_mcu7t5v0__buf_1 | instruction/ROM
max_ss_125C_4v50 | 393 | fanout753/I | 3.0 | 3.201548 | -0.201548 | _1561_ | fanout753 | gf180mcu_fd_sc_mcu7t5v0__buf_1 | instruction/ROM
max_ss_125C_4v50 | 394 | fanout755/I | 3.0 | 3.201537 | -0.201537 | _1561_ | fanout755 | gf180mcu_fd_sc_mcu7t5v0__buf_1 | instruction/ROM
max_ss_125C_4v50 | 395 | fanout758/I | 3.0 | 3.201524 | -0.201524 | _1561_ | fanout758 | gf180mcu_fd_sc_mcu7t5v0__buf_1 | instruction/ROM
max_ss_125C_4v50 | 396 | _4979_/ZN | 3.0 | 3.201502 | -0.201502 | _1561_ | _4979_ | gf180mcu_fd_sc_mcu7t5v0__nor2_2 | instruction/ROM
max_ss_125C_4v50 | 397 | _8384_/I0 | 3.0 | 3.200084 | -0.200084 | \u_pochoco_soc.data_wdata[2] | _8384_ | gf180mcu_fd_sc_mcu7t5v0__mux2_2 | data/register-file;instruction/ROM
max_ss_125C_4v50 | 398 | _4449_/A1 | 3.0 | 3.200078 | -0.200078 | \u_pochoco_soc.data_wdata[2] | _4449_ | gf180mcu_fd_sc_mcu7t5v0__nand2_1 | data/register-file;instruction/ROM
max_ss_125C_4v50 | 399 | _8269_/I0 | 3.0 | 3.200069 | -0.200069 | \u_pochoco_soc.data_wdata[2] | _8269_ | gf180mcu_fd_sc_mcu7t5v0__mux2_2 | data/register-file;instruction/ROM
max_ss_125C_4v50 | 400 | _8263_/I0 | 3.0 | 3.200068 | -0.200069 | \u_pochoco_soc.data_wdata[2] | _8263_ | gf180mcu_fd_sc_mcu7t5v0__mux2_2 | data/register-file;instruction/ROM
max_ss_125C_4v50 | 401 | _6854_/I1 | 3.0 | 3.200039 | -0.20004 | \u_pochoco_soc.data_wdata[2] | _6854_ | gf180mcu_fd_sc_mcu7t5v0__mux2_2 | data/register-file;instruction/ROM
max_ss_125C_4v50 | 402 | _6776_/A1 | 3.0 | 3.19997 | -0.19997 | \u_pochoco_soc.data_wdata[2] | _6776_ | gf180mcu_fd_sc_mcu7t5v0__and2_1 | data/register-file;instruction/ROM
max_ss_125C_4v50 | 403 | _6777_/A1 | 3.0 | 3.19997 | -0.19997 | \u_pochoco_soc.data_wdata[2] | _6777_ | gf180mcu_fd_sc_mcu7t5v0__nand2_1 | data/register-file;instruction/ROM
max_ss_125C_4v50 | 404 | _9247_/Q | 3.0 | 3.19997 | -0.19997 | \u_pochoco_soc.data_wdata[2] | _9247_ | gf180mcu_fd_sc_mcu7t5v0__dffrnq_1 | data/register-file;instruction/ROM
max_ss_125C_4v50 | 405 | _4440_/A1 | 3.0 | 3.169293 | -0.169293 | \u_pochoco_soc.data_wdata[3] | _4440_ | gf180mcu_fd_sc_mcu7t5v0__nand2_1 | data/register-file;instruction/ROM
max_ss_125C_4v50 | 406 | _8385_/I0 | 3.0 | 3.169281 | -0.169281 | \u_pochoco_soc.data_wdata[3] | _8385_ | gf180mcu_fd_sc_mcu7t5v0__mux2_2 | data/register-file;instruction/ROM
max_ss_125C_4v50 | 407 | _8264_/I0 | 3.0 | 3.169258 | -0.169258 | \u_pochoco_soc.data_wdata[3] | _8264_ | gf180mcu_fd_sc_mcu7t5v0__mux2_2 | data/register-file;instruction/ROM
max_ss_125C_4v50 | 408 | _8270_/I0 | 3.0 | 3.169252 | -0.169252 | \u_pochoco_soc.data_wdata[3] | _8270_ | gf180mcu_fd_sc_mcu7t5v0__mux2_2 | data/register-file;instruction/ROM
max_ss_125C_4v50 | 409 | _6855_/I1 | 3.0 | 3.169203 | -0.169203 | \u_pochoco_soc.data_wdata[3] | _6855_ | gf180mcu_fd_sc_mcu7t5v0__mux2_2 | data/register-file;instruction/ROM
max_ss_125C_4v50 | 410 | _6782_/A1 | 3.0 | 3.169145 | -0.169145 | \u_pochoco_soc.data_wdata[3] | _6782_ | gf180mcu_fd_sc_mcu7t5v0__nand2_1 | data/register-file;instruction/ROM
max_ss_125C_4v50 | 411 | _6781_/A1 | 3.0 | 3.16913 | -0.16913 | \u_pochoco_soc.data_wdata[3] | _6781_ | gf180mcu_fd_sc_mcu7t5v0__and2_1 | data/register-file;instruction/ROM
max_ss_125C_4v50 | 412 | _9248_/Q | 3.0 | 3.16913 | -0.16913 | \u_pochoco_soc.data_wdata[3] | _9248_ | gf180mcu_fd_sc_mcu7t5v0__dffrnq_1 | data/register-file;instruction/ROM
max_ss_125C_4v50 | 413 | _7139_/ZN | 3.0 | 3.168553 | -0.168553 | _3521_ | _7139_ | gf180mcu_fd_sc_mcu7t5v0__aoi211_1 | instruction/ROM
max_ss_125C_4v50 | 414 | wire49/I | 3.0 | 3.168553 | -0.168553 | _3521_ | wire49 | gf180mcu_fd_sc_mcu7t5v0__clkbuf_1 | instruction/ROM
max_ss_125C_4v50 | 415 | fanout79/I | 3.0 | 3.163914 | -0.163914 | _3462_ | fanout79 | gf180mcu_fd_sc_mcu7t5v0__buf_1 | instruction/ROM
max_ss_125C_4v50 | 416 | fanout81/I | 3.0 | 3.163914 | -0.163914 | _3462_ | fanout81 | gf180mcu_fd_sc_mcu7t5v0__buf_1 | instruction/ROM
max_ss_125C_4v50 | 417 | _7071_/ZN | 3.0 | 3.163913 | -0.163913 | _3462_ | _7071_ | gf180mcu_fd_sc_mcu7t5v0__aoi221_2 | instruction/ROM
max_ss_125C_4v50 | 418 | _4763_/ZN | 3.0 | 3.155403 | -0.155403 | _1378_ | _4763_ | gf180mcu_fd_sc_mcu7t5v0__oai221_1 | instruction/ROM
max_ss_125C_4v50 | 419 | _4764_/A4 | 3.0 | 3.155403 | -0.155403 | _1378_ | _4764_ | gf180mcu_fd_sc_mcu7t5v0__nor4_1 | instruction/ROM
max_ss_125C_4v50 | 420 | _5991_/A1 | 3.0 | 3.155403 | -0.155403 | _1378_ | _5991_ | gf180mcu_fd_sc_mcu7t5v0__oai21_1 | instruction/ROM
max_ss_125C_4v50 | 421 | _7062_/A2 | 3.0 | 3.155403 | -0.155403 | _1378_ | _7062_ | gf180mcu_fd_sc_mcu7t5v0__aoi211_1 | instruction/ROM
max_ss_125C_4v50 | 422 | _4739_/ZN | 3.0 | 3.150199 | -0.1502 | _1354_ | _4739_ | gf180mcu_fd_sc_mcu7t5v0__oai21_1 | instruction/ROM
max_ss_125C_4v50 | 423 | _4764_/A1 | 3.0 | 3.150199 | -0.1502 | _1354_ | _4764_ | gf180mcu_fd_sc_mcu7t5v0__nor4_1 | instruction/ROM
max_ss_125C_4v50 | 424 | _6130_/A1 | 3.0 | 3.150199 | -0.1502 | _1354_ | _6130_ | gf180mcu_fd_sc_mcu7t5v0__oai211_1 | instruction/ROM
max_ss_125C_4v50 | 425 | _7155_/A2 | 3.0 | 3.150199 | -0.1502 | _1354_ | _7155_ | gf180mcu_fd_sc_mcu7t5v0__aoi211_2 | instruction/ROM
max_ss_125C_4v50 | 426 | _7000_/ZN | 3.0 | 3.144306 | -0.144306 | _3399_ | _7000_ | gf180mcu_fd_sc_mcu7t5v0__oai32_1 | instruction/ROM
max_ss_125C_4v50 | 427 | _7001_/B | 3.0 | 3.144306 | -0.144306 | _3399_ | _7001_ | gf180mcu_fd_sc_mcu7t5v0__aoi21_1 | instruction/ROM
max_ss_125C_4v50 | 428 | _7001_/ZN | 3.0 | 3.143076 | -0.143076 | _3400_ | _7001_ | gf180mcu_fd_sc_mcu7t5v0__aoi21_1 | instruction/ROM
max_ss_125C_4v50 | 429 | fanout107/I | 3.0 | 3.143076 | -0.143076 | _3400_ | fanout107 | gf180mcu_fd_sc_mcu7t5v0__buf_1 | instruction/ROM
max_ss_125C_4v50 | 430 | fanout109/I | 3.0 | 3.143076 | -0.143076 | _3400_ | fanout109 | gf180mcu_fd_sc_mcu7t5v0__buf_1 | instruction/ROM
max_ss_125C_4v50 | 431 | _4456_/ZN | 3.0 | 3.140316 | -0.140316 | _1071_ | _4456_ | gf180mcu_fd_sc_mcu7t5v0__aoi221_1 | data/register-file;instruction/ROM
max_ss_125C_4v50 | 432 | _4457_/B | 3.0 | 3.140316 | -0.140316 | _1071_ | _4457_ | gf180mcu_fd_sc_mcu7t5v0__aoi21_1 | data/register-file;instruction/ROM
max_ss_125C_4v50 | 433 | _9259_/D | 3.0 | 3.12604 | -0.12604 | _0069_ | _9259_ | gf180mcu_fd_sc_mcu7t5v0__dffrnq_1 | data/register-file;instruction/ROM
max_ss_125C_4v50 | 434 | _5153_/ZN | 3.0 | 3.126038 | -0.126038 | _0069_ | _5153_ | gf180mcu_fd_sc_mcu7t5v0__aoi22_1 | data/register-file;instruction/ROM
max_ss_125C_4v50 | 435 | _6320_/B | 3.0 | 3.125754 | -0.125755 | net936 | _6320_ | gf180mcu_fd_sc_mcu7t5v0__aoi21_1 | instruction/ROM
max_ss_125C_4v50 | 436 | _6322_/B2 | 3.0 | 3.125754 | -0.125754 | net936 | _6322_ | gf180mcu_fd_sc_mcu7t5v0__aoi22_1 | instruction/ROM
max_ss_125C_4v50 | 437 | _6323_/B | 3.0 | 3.125751 | -0.125751 | net936 | _6323_ | gf180mcu_fd_sc_mcu7t5v0__aoi21_1 | instruction/ROM
max_ss_125C_4v50 | 438 | _6212_/A2 | 3.0 | 3.125745 | -0.125745 | net936 | _6212_ | gf180mcu_fd_sc_mcu7t5v0__nor2_2 | instruction/ROM
max_ss_125C_4v50 | 439 | _5885_/A2 | 3.0 | 3.125734 | -0.125734 | net936 | _5885_ | gf180mcu_fd_sc_mcu7t5v0__nor2_2 | instruction/ROM
max_ss_125C_4v50 | 440 | _5890_/A1 | 3.0 | 3.125734 | -0.125734 | net936 | _5890_ | gf180mcu_fd_sc_mcu7t5v0__aoi22_1 | instruction/ROM
max_ss_125C_4v50 | 441 | _6205_/A2 | 3.0 | 3.125734 | -0.125734 | net936 | _6205_ | gf180mcu_fd_sc_mcu7t5v0__nand2_1 | instruction/ROM
max_ss_125C_4v50 | 442 | _6283_/A2 | 3.0 | 3.125734 | -0.125734 | net936 | _6283_ | gf180mcu_fd_sc_mcu7t5v0__nor2_1 | instruction/ROM
max_ss_125C_4v50 | 443 | _6509_/A1 | 3.0 | 3.125734 | -0.125734 | net936 | _6509_ | gf180mcu_fd_sc_mcu7t5v0__and2_1 | instruction/ROM
max_ss_125C_4v50 | 444 | _8115_/A1 | 3.0 | 3.125734 | -0.125734 | net936 | _8115_ | gf180mcu_fd_sc_mcu7t5v0__oai21_1 | instruction/ROM
max_ss_125C_4v50 | 445 | fanout936/Z | 3.0 | 3.125734 | -0.125734 | net936 | fanout936 | gf180mcu_fd_sc_mcu7t5v0__buf_1 | instruction/ROM
max_ss_125C_4v50 | 446 | fanout70/I | 3.0 | 3.124404 | -0.124404 | _3482_ | fanout70 | gf180mcu_fd_sc_mcu7t5v0__buf_1 | instruction/ROM
max_ss_125C_4v50 | 447 | fanout68/I | 3.0 | 3.124403 | -0.124403 | _3482_ | fanout68 | gf180mcu_fd_sc_mcu7t5v0__buf_1 | instruction/ROM
max_ss_125C_4v50 | 448 | _7094_/ZN | 3.0 | 3.12438 | -0.124381 | _3482_ | _7094_ | gf180mcu_fd_sc_mcu7t5v0__nor2_1 | instruction/ROM
max_ss_125C_4v50 | 449 | _5360_/A1 | 3.0 | 3.093858 | -0.093858 | net983 | _5360_ | gf180mcu_fd_sc_mcu7t5v0__nor3_4 | instruction/ROM
max_ss_125C_4v50 | 450 | _5349_/A1 | 3.0 | 3.093857 | -0.093857 | net983 | _5349_ | gf180mcu_fd_sc_mcu7t5v0__nor3_2 | instruction/ROM
max_ss_125C_4v50 | 451 | _5346_/A1 | 3.0 | 3.093856 | -0.093856 | net983 | _5346_ | gf180mcu_fd_sc_mcu7t5v0__or2_1 | instruction/ROM
max_ss_125C_4v50 | 452 | _5364_/A1 | 3.0 | 3.093853 | -0.093854 | net983 | _5364_ | gf180mcu_fd_sc_mcu7t5v0__nor3_2 | instruction/ROM
max_ss_125C_4v50 | 453 | _5351_/A1 | 3.0 | 3.093848 | -0.093848 | net983 | _5351_ | gf180mcu_fd_sc_mcu7t5v0__nand2_1 | instruction/ROM
max_ss_125C_4v50 | 454 | _5365_/A1 | 3.0 | 3.093842 | -0.093842 | net983 | _5365_ | gf180mcu_fd_sc_mcu7t5v0__nand2_1 | instruction/ROM
max_ss_125C_4v50 | 455 | _5343_/A1 | 3.0 | 3.093837 | -0.093837 | net983 | _5343_ | gf180mcu_fd_sc_mcu7t5v0__nor2_1 | instruction/ROM
max_ss_125C_4v50 | 456 | _5344_/A1 | 3.0 | 3.093831 | -0.093831 | net983 | _5344_ | gf180mcu_fd_sc_mcu7t5v0__or2_1 | instruction/ROM
max_ss_125C_4v50 | 457 | _4602_/A1 | 3.0 | 3.093816 | -0.093816 | net983 | _4602_ | gf180mcu_fd_sc_mcu7t5v0__nand2_1 | instruction/ROM
max_ss_125C_4v50 | 458 | _5996_/A1 | 3.0 | 3.093803 | -0.093803 | net983 | _5996_ | gf180mcu_fd_sc_mcu7t5v0__nor2_1 | instruction/ROM
max_ss_125C_4v50 | 459 | fanout983/Z | 3.0 | 3.093803 | -0.093803 | net983 | fanout983 | gf180mcu_fd_sc_mcu7t5v0__buf_1 | instruction/ROM
max_ss_125C_4v50 | 460 | _6217_/ZN | 3.0 | 3.088899 | -0.088899 | _2686_ | _6217_ | gf180mcu_fd_sc_mcu7t5v0__nor2_1 | instruction/ROM
max_ss_125C_4v50 | 461 | _6219_/B | 3.0 | 3.088899 | -0.088899 | _2686_ | _6219_ | gf180mcu_fd_sc_mcu7t5v0__aoi21_1 | instruction/ROM
max_ss_125C_4v50 | 462 | _6319_/A2 | 3.0 | 3.088899 | -0.088899 | _2686_ | _6319_ | gf180mcu_fd_sc_mcu7t5v0__nand2_1 | instruction/ROM
max_ss_125C_4v50 | 463 | _6380_/A1 | 3.0 | 3.088899 | -0.088899 | _2686_ | _6380_ | gf180mcu_fd_sc_mcu7t5v0__aoi21_1 | instruction/ROM
max_ss_125C_4v50 | 464 | _6411_/A1 | 3.0 | 3.088899 | -0.088899 | _2686_ | _6411_ | gf180mcu_fd_sc_mcu7t5v0__aoi22_1 | instruction/ROM
max_ss_125C_4v50 | 465 | _6586_/A2 | 3.0 | 3.088899 | -0.088899 | _2686_ | _6586_ | gf180mcu_fd_sc_mcu7t5v0__nand2_1 | instruction/ROM
max_ss_125C_4v50 | 466 | fanout132/I | 3.0 | 3.077713 | -0.077713 | _3336_ | fanout132 | gf180mcu_fd_sc_mcu7t5v0__buf_1 | instruction/ROM
max_ss_125C_4v50 | 467 | fanout130/I | 3.0 | 3.077713 | -0.077713 | _3336_ | fanout130 | gf180mcu_fd_sc_mcu7t5v0__buf_1 | instruction/ROM
max_ss_125C_4v50 | 468 | _6933_/ZN | 3.0 | 3.077705 | -0.077705 | _3336_ | _6933_ | gf180mcu_fd_sc_mcu7t5v0__oai22_2 | instruction/ROM
max_ss_125C_4v50 | 469 | _7513_/A2 | 3.0 | 3.077087 | -0.077087 | \u_pochoco_soc.genblk1.g_rom_ram_memory.u_ram.a_rdata_o[9] | _7513_ | gf180mcu_fd_sc_mcu7t5v0__nand2_1 | data/register-file;instruction/ROM
max_ss_125C_4v50 | 470 | _7382_/A2 | 3.0 | 3.077087 | -0.077087 | \u_pochoco_soc.genblk1.g_rom_ram_memory.u_ram.a_rdata_o[9] | _7382_ | gf180mcu_fd_sc_mcu7t5v0__nor3_1 | data/register-file;instruction/ROM
max_ss_125C_4v50 | 471 | _6864_/A2 | 3.0 | 3.077086 | -0.077086 | \u_pochoco_soc.genblk1.g_rom_ram_memory.u_ram.a_rdata_o[9] | _6864_ | gf180mcu_fd_sc_mcu7t5v0__nand2_1 | data/register-file;instruction/ROM
max_ss_125C_4v50 | 472 | _7775_/A2 | 3.0 | 3.077085 | -0.077085 | \u_pochoco_soc.genblk1.g_rom_ram_memory.u_ram.a_rdata_o[9] | _7775_ | gf180mcu_fd_sc_mcu7t5v0__or2_1 | data/register-file;instruction/ROM
max_ss_125C_4v50 | 473 | _7317_/A2 | 3.0 | 3.077081 | -0.077081 | \u_pochoco_soc.genblk1.g_rom_ram_memory.u_ram.a_rdata_o[9] | _7317_ | gf180mcu_fd_sc_mcu7t5v0__nor3_2 | data/register-file;instruction/ROM
max_ss_125C_4v50 | 474 | _5804_/I1 | 3.0 | 3.077071 | -0.077071 | \u_pochoco_soc.genblk1.g_rom_ram_memory.u_ram.a_rdata_o[9] | _5804_ | gf180mcu_fd_sc_mcu7t5v0__mux2_2 | data/register-file;instruction/ROM
max_ss_125C_4v50 | 475 | _4448_/A1 | 3.0 | 3.07707 | -0.077071 | \u_pochoco_soc.genblk1.g_rom_ram_memory.u_ram.a_rdata_o[9] | _4448_ | gf180mcu_fd_sc_mcu7t5v0__aoi22_1 | data/register-file;instruction/ROM
max_ss_125C_4v50 | 476 | _6444_/A1 | 3.0 | 3.07706 | -0.07706 | \u_pochoco_soc.genblk1.g_rom_ram_memory.u_ram.a_rdata_o[9] | _6444_ | gf180mcu_fd_sc_mcu7t5v0__oai221_1 | data/register-file;instruction/ROM
max_ss_125C_4v50 | 477 | _6860_/A2 | 3.0 | 3.07706 | -0.07706 | \u_pochoco_soc.genblk1.g_rom_ram_memory.u_ram.a_rdata_o[9] | _6860_ | gf180mcu_fd_sc_mcu7t5v0__nor2_1 | data/register-file;instruction/ROM
max_ss_125C_4v50 | 478 | _8476_/Q | 3.0 | 3.07706 | -0.07706 | \u_pochoco_soc.genblk1.g_rom_ram_memory.u_ram.a_rdata_o[9] | _8476_ | gf180mcu_fd_sc_mcu7t5v0__dffrnq_1 | data/register-file;instruction/ROM
max_ss_125C_4v50 | 479 | _6426_/A3 | 3.0 | 3.07442 | -0.07442 | _2768_ | _6426_ | gf180mcu_fd_sc_mcu7t5v0__nor3_1 | instruction/ROM
max_ss_125C_4v50 | 480 | _6699_/A1 | 3.0 | 3.074417 | -0.074417 | _2768_ | _6699_ | gf180mcu_fd_sc_mcu7t5v0__aoi21_1 | instruction/ROM
max_ss_125C_4v50 | 481 | _6621_/A1 | 3.0 | 3.074414 | -0.074414 | _2768_ | _6621_ | gf180mcu_fd_sc_mcu7t5v0__nand3_1 | instruction/ROM
max_ss_125C_4v50 | 482 | _6301_/ZN | 3.0 | 3.074403 | -0.074403 | _2768_ | _6301_ | gf180mcu_fd_sc_mcu7t5v0__nand2_1 | instruction/ROM
max_ss_125C_4v50 | 483 | _6302_/A3 | 3.0 | 3.074403 | -0.074403 | _2768_ | _6302_ | gf180mcu_fd_sc_mcu7t5v0__or3_1 | instruction/ROM
max_ss_125C_4v50 | 484 | _6325_/A2 | 3.0 | 3.074403 | -0.074403 | _2768_ | _6325_ | gf180mcu_fd_sc_mcu7t5v0__nor2_1 | instruction/ROM
max_ss_125C_4v50 | 485 | _6387_/A4 | 3.0 | 3.074403 | -0.074403 | _2768_ | _6387_ | gf180mcu_fd_sc_mcu7t5v0__and4_1 | instruction/ROM
max_ss_125C_4v50 | 486 | _6637_/A1 | 3.0 | 3.074403 | -0.074403 | _2768_ | _6637_ | gf180mcu_fd_sc_mcu7t5v0__and2_1 | instruction/ROM
max_ss_125C_4v50 | 487 | _4608_/A1 | 3.0 | 3.068303 | -0.068303 | \u_pochoco_soc.u_core.pc_id[17] | _4608_ | gf180mcu_fd_sc_mcu7t5v0__nand2_1 | instruction/ROM
max_ss_125C_4v50 | 488 | fanout642/I | 3.0 | 3.068299 | -0.068299 | _1904_ | fanout642 | gf180mcu_fd_sc_mcu7t5v0__buf_1 | instruction/ROM
max_ss_125C_4v50 | 489 | _7083_/A2 | 3.0 | 3.068296 | -0.068296 | \u_pochoco_soc.u_core.pc_id[17] | _7083_ | gf180mcu_fd_sc_mcu7t5v0__and3_1 | instruction/ROM
max_ss_125C_4v50 | 490 | _7084_/A1 | 3.0 | 3.068294 | -0.068294 | \u_pochoco_soc.u_core.pc_id[17] | _7084_ | gf180mcu_fd_sc_mcu7t5v0__aoi21_1 | instruction/ROM
max_ss_125C_4v50 | 491 | _7076_/A1 | 3.0 | 3.068287 | -0.068287 | \u_pochoco_soc.u_core.pc_id[17] | _7076_ | gf180mcu_fd_sc_mcu7t5v0__oai21_1 | instruction/ROM
max_ss_125C_4v50 | 492 | _7077_/A1 | 3.0 | 3.068285 | -0.068285 | \u_pochoco_soc.u_core.pc_id[17] | _7077_ | gf180mcu_fd_sc_mcu7t5v0__aoi21_1 | instruction/ROM
max_ss_125C_4v50 | 493 | fanout645/I | 3.0 | 3.068271 | -0.068271 | _1904_ | fanout645 | gf180mcu_fd_sc_mcu7t5v0__buf_1 | instruction/ROM
max_ss_125C_4v50 | 494 | fanout650/I | 3.0 | 3.068193 | -0.068193 | _1904_ | fanout650 | gf180mcu_fd_sc_mcu7t5v0__buf_1 | instruction/ROM
max_ss_125C_4v50 | 495 | _5354_/ZN | 3.0 | 3.068165 | -0.068165 | _1904_ | _5354_ | gf180mcu_fd_sc_mcu7t5v0__nor2_2 | instruction/ROM
max_ss_125C_4v50 | 496 | fanout647/I | 3.0 | 3.068165 | -0.068165 | _1904_ | fanout647 | gf180mcu_fd_sc_mcu7t5v0__buf_1 | instruction/ROM
max_ss_125C_4v50 | 497 | _6009_/C | 3.0 | 3.068119 | -0.06812 | \u_pochoco_soc.u_core.pc_id[17] | _6009_ | gf180mcu_fd_sc_mcu7t5v0__oai211_1 | instruction/ROM
max_ss_125C_4v50 | 498 | _6010_/A1 | 3.0 | 3.068116 | -0.068116 | \u_pochoco_soc.u_core.pc_id[17] | _6010_ | gf180mcu_fd_sc_mcu7t5v0__xnor2_1 | instruction/ROM
max_ss_125C_4v50 | 499 | _8131_/I0 | 3.0 | 3.068104 | -0.068104 | \u_pochoco_soc.u_core.pc_id[17] | _8131_ | gf180mcu_fd_sc_mcu7t5v0__mux2_2 | instruction/ROM
max_ss_125C_4v50 | 500 | _9028_/Q | 3.0 | 3.068104 | -0.068104 | \u_pochoco_soc.u_core.pc_id[17] | _9028_ | gf180mcu_fd_sc_mcu7t5v0__dffrnq_1 | instruction/ROM
max_ss_125C_4v50 | 501 | _6676_/A1 | 3.0 | 3.056154 | -0.056154 | _2330_ | _6676_ | gf180mcu_fd_sc_mcu7t5v0__nand2_1 | instruction/ROM
max_ss_125C_4v50 | 502 | _6281_/A1 | 3.0 | 3.056153 | -0.056153 | _2330_ | _6281_ | gf180mcu_fd_sc_mcu7t5v0__nor2_1 | instruction/ROM
max_ss_125C_4v50 | 503 | _5829_/ZN | 3.0 | 3.056144 | -0.056144 | _2330_ | _5829_ | gf180mcu_fd_sc_mcu7t5v0__nor2_1 | instruction/ROM
max_ss_125C_4v50 | 504 | _6329_/A2 | 3.0 | 3.056144 | -0.056144 | _2330_ | _6329_ | gf180mcu_fd_sc_mcu7t5v0__nor2_1 | instruction/ROM
max_ss_125C_4v50 | 505 | _6330_/A1 | 3.0 | 3.056144 | -0.056144 | _2330_ | _6330_ | gf180mcu_fd_sc_mcu7t5v0__nor2_1 | instruction/ROM
max_ss_125C_4v50 | 506 | _6508_/A1 | 3.0 | 3.056144 | -0.056144 | _2330_ | _6508_ | gf180mcu_fd_sc_mcu7t5v0__oai21_1 | instruction/ROM
max_ss_125C_4v50 | 507 | _6903_/A1 | 3.0 | 3.043846 | -0.043846 | net798 | _6903_ | gf180mcu_fd_sc_mcu7t5v0__nor3_1 | instruction/ROM
max_ss_125C_4v50 | 508 | _7049_/C | 3.0 | 3.04384 | -0.04384 | net798 | _7049_ | gf180mcu_fd_sc_mcu7t5v0__aoi221_2 | instruction/ROM
max_ss_125C_4v50 | 509 | _7114_/A1 | 3.0 | 3.043834 | -0.043834 | net798 | _7114_ | gf180mcu_fd_sc_mcu7t5v0__nor2_1 | instruction/ROM
max_ss_125C_4v50 | 510 | _7165_/C | 3.0 | 3.043832 | -0.043832 | net798 | _7165_ | gf180mcu_fd_sc_mcu7t5v0__aoi221_1 | instruction/ROM
max_ss_125C_4v50 | 511 | _4363_/A2 | 3.0 | 3.043831 | -0.043831 | net798 | _4363_ | gf180mcu_fd_sc_mcu7t5v0__nand2_1 | instruction/ROM
max_ss_125C_4v50 | 512 | _7180_/B | 3.0 | 3.043831 | -0.043831 | net798 | _7180_ | gf180mcu_fd_sc_mcu7t5v0__aoi21_1 | instruction/ROM
max_ss_125C_4v50 | 513 | _7041_/A1 | 3.0 | 3.043829 | -0.043829 | net798 | _7041_ | gf180mcu_fd_sc_mcu7t5v0__nor2_1 | instruction/ROM
max_ss_125C_4v50 | 514 | _7121_/B | 3.0 | 3.043829 | -0.043829 | net798 | _7121_ | gf180mcu_fd_sc_mcu7t5v0__aoi21_1 | instruction/ROM
max_ss_125C_4v50 | 515 | _7058_/C | 3.0 | 3.043821 | -0.043821 | net798 | _7058_ | gf180mcu_fd_sc_mcu7t5v0__aoi221_1 | instruction/ROM
max_ss_125C_4v50 | 516 | _4371_/A2 | 3.0 | 3.043795 | -0.043795 | net798 | _4371_ | gf180mcu_fd_sc_mcu7t5v0__oai21_1 | instruction/ROM
max_ss_125C_4v50 | 517 | fanout798/Z | 3.0 | 3.043795 | -0.043795 | net798 | fanout798 | gf180mcu_fd_sc_mcu7t5v0__buf_1 | instruction/ROM
max_ss_125C_4v50 | 518 | _4849_/ZN | 3.0 | 3.035 | -0.035 | _1464_ | _4849_ | gf180mcu_fd_sc_mcu7t5v0__aoi211_1 | instruction/ROM
max_ss_125C_4v50 | 519 | _4861_/A2 | 3.0 | 3.035 | -0.035 | _1464_ | _4861_ | gf180mcu_fd_sc_mcu7t5v0__nor4_1 | instruction/ROM
max_ss_125C_4v50 | 520 | _5891_/A1 | 3.0 | 3.035 | -0.035 | _1464_ | _5891_ | gf180mcu_fd_sc_mcu7t5v0__nor2_1 | instruction/ROM
max_ss_125C_4v50 | 521 | _7000_/B2 | 3.0 | 3.035 | -0.035 | _1464_ | _7000_ | gf180mcu_fd_sc_mcu7t5v0__oai32_1 | instruction/ROM
max_ss_125C_4v50 | 522 | fanout113/I | 3.0 | 3.022191 | -0.022191 | _3298_ | fanout113 | gf180mcu_fd_sc_mcu7t5v0__buf_1 | instruction/ROM
max_ss_125C_4v50 | 523 | fanout115/I | 3.0 | 3.022191 | -0.022191 | _3298_ | fanout115 | gf180mcu_fd_sc_mcu7t5v0__buf_1 | instruction/ROM
max_ss_125C_4v50 | 524 | _6892_/ZN | 3.0 | 3.02219 | -0.02219 | _3298_ | _6892_ | gf180mcu_fd_sc_mcu7t5v0__aoi221_2 | instruction/ROM
max_ss_125C_4v50 | 525 | _6422_/A1 | 3.0 | 3.006139 | -0.006139 | net824 | _6422_ | gf180mcu_fd_sc_mcu7t5v0__nor3_1 | data/register-file;instruction/ROM
max_ss_125C_4v50 | 526 | _6465_/A1 | 3.0 | 3.006122 | -0.006122 | net824 | _6465_ | gf180mcu_fd_sc_mcu7t5v0__nor2_1 | data/register-file;instruction/ROM
max_ss_125C_4v50 | 527 | _6563_/B | 3.0 | 3.006121 | -0.006121 | net824 | _6563_ | gf180mcu_fd_sc_mcu7t5v0__aoi21_1 | data/register-file;instruction/ROM
max_ss_125C_4v50 | 528 | _6579_/A1 | 3.0 | 3.006119 | -0.006119 | net824 | _6579_ | gf180mcu_fd_sc_mcu7t5v0__oai31_1 | data/register-file;instruction/ROM
max_ss_125C_4v50 | 529 | _6399_/A1 | 3.0 | 3.006109 | -0.006109 | net824 | _6399_ | gf180mcu_fd_sc_mcu7t5v0__oai221_1 | data/register-file;instruction/ROM
max_ss_125C_4v50 | 530 | _6515_/C | 3.0 | 3.006092 | -0.006092 | net824 | _6515_ | gf180mcu_fd_sc_mcu7t5v0__aoi221_1 | data/register-file;instruction/ROM
max_ss_125C_4v50 | 531 | _6480_/C | 3.0 | 3.006064 | -0.006064 | net824 | _6480_ | gf180mcu_fd_sc_mcu7t5v0__aoi211_1 | data/register-file;instruction/ROM
max_ss_125C_4v50 | 532 | _6589_/C | 3.0 | 3.006047 | -0.006047 | net824 | _6589_ | gf180mcu_fd_sc_mcu7t5v0__aoi221_1 | data/register-file;instruction/ROM
max_ss_125C_4v50 | 533 | _6206_/A2 | 3.0 | 3.006036 | -0.006037 | net824 | _6206_ | gf180mcu_fd_sc_mcu7t5v0__nor2_2 | data/register-file;instruction/ROM
max_ss_125C_4v50 | 534 | _6530_/A1 | 3.0 | 3.006036 | -0.006037 | net824 | _6530_ | gf180mcu_fd_sc_mcu7t5v0__nor2_1 | data/register-file;instruction/ROM
max_ss_125C_4v50 | 535 | fanout824/Z | 3.0 | 3.006036 | -0.006037 | net824 | fanout824 | gf180mcu_fd_sc_mcu7t5v0__buf_1 | data/register-file;instruction/ROM
min_ss_125C_4v50 | 291 | _7165_/ZN | 3.0 | 3.505506 | -0.505506 | _3543_ | _7165_ | gf180mcu_fd_sc_mcu7t5v0__aoi221_1 | instruction/ROM
min_ss_125C_4v50 | 292 | _7169_/B1 | 3.0 | 3.505506 | -0.505506 | _3543_ | _7169_ | gf180mcu_fd_sc_mcu7t5v0__oai22_1 | instruction/ROM
min_ss_125C_4v50 | 293 | _4812_/ZN | 3.0 | 3.45091 | -0.45091 | _1427_ | _4812_ | gf180mcu_fd_sc_mcu7t5v0__aoi21_1 | instruction/ROM
min_ss_125C_4v50 | 294 | _4895_/A2 | 3.0 | 3.45091 | -0.45091 | _1427_ | _4895_ | gf180mcu_fd_sc_mcu7t5v0__nand3_1 | instruction/ROM
min_ss_125C_4v50 | 295 | _6039_/A1 | 3.0 | 3.45091 | -0.45091 | _1427_ | _6039_ | gf180mcu_fd_sc_mcu7t5v0__nand2_1 | instruction/ROM
min_ss_125C_4v50 | 296 | _7093_/A2 | 3.0 | 3.45091 | -0.45091 | _1427_ | _7093_ | gf180mcu_fd_sc_mcu7t5v0__oai22_1 | instruction/ROM
min_ss_125C_4v50 | 297 | _4887_/ZN | 3.0 | 3.17803 | -0.17803 | _1502_ | _4887_ | gf180mcu_fd_sc_mcu7t5v0__oai211_1 | instruction/ROM
min_ss_125C_4v50 | 298 | _4894_/A3 | 3.0 | 3.17803 | -0.17803 | _1502_ | _4894_ | gf180mcu_fd_sc_mcu7t5v0__nor4_1 | instruction/ROM
min_ss_125C_4v50 | 299 | _6052_/A1 | 3.0 | 3.17803 | -0.17803 | _1502_ | _6052_ | gf180mcu_fd_sc_mcu7t5v0__nor2_1 | instruction/ROM
min_ss_125C_4v50 | 300 | _7102_/A2 | 3.0 | 3.17803 | -0.17803 | _1502_ | _7102_ | gf180mcu_fd_sc_mcu7t5v0__aoi211_2 | instruction/ROM
min_ss_125C_4v50 | 301 | fanout90/I | 3.0 | 3.174673 | -0.174673 | _3439_ | fanout90 | gf180mcu_fd_sc_mcu7t5v0__buf_1 | instruction/ROM
min_ss_125C_4v50 | 302 | _7045_/ZN | 3.0 | 3.174671 | -0.174672 | _3439_ | _7045_ | gf180mcu_fd_sc_mcu7t5v0__aoi211_2 | instruction/ROM
min_ss_125C_4v50 | 303 | fanout92/I | 3.0 | 3.174671 | -0.174672 | _3439_ | fanout92 | gf180mcu_fd_sc_mcu7t5v0__buf_1 | instruction/ROM
min_ss_125C_4v50 | 304 | _6661_/ZN | 3.0 | 3.15852 | -0.158521 | _3110_ | _6661_ | gf180mcu_fd_sc_mcu7t5v0__aoi221_1 | data/register-file;instruction/ROM
min_ss_125C_4v50 | 305 | _6662_/B2 | 3.0 | 3.15852 | -0.158521 | _3110_ | _6662_ | gf180mcu_fd_sc_mcu7t5v0__oai22_1 | data/register-file;instruction/ROM
min_ss_125C_4v50 | 306 | fanout57/I | 3.0 | 3.036955 | -0.036955 | _3503_ | fanout57 | gf180mcu_fd_sc_mcu7t5v0__buf_1 | instruction/ROM
min_ss_125C_4v50 | 307 | fanout59/I | 3.0 | 3.036955 | -0.036955 | _3503_ | fanout59 | gf180mcu_fd_sc_mcu7t5v0__buf_1 | instruction/ROM
min_ss_125C_4v50 | 308 | _7118_/ZN | 3.0 | 3.036953 | -0.036954 | _3503_ | _7118_ | gf180mcu_fd_sc_mcu7t5v0__aoi221_2 | instruction/ROM
min_ss_125C_4v50 | 309 | fanout27/I | 3.0 | 3.033821 | -0.033821 | _3559_ | fanout27 | gf180mcu_fd_sc_mcu7t5v0__buf_1 | instruction/ROM
min_ss_125C_4v50 | 310 | fanout29/I | 3.0 | 3.03382 | -0.033821 | _3559_ | fanout29 | gf180mcu_fd_sc_mcu7t5v0__buf_1 | instruction/ROM
min_ss_125C_4v50 | 311 | _7183_/ZN | 3.0 | 3.033819 | -0.033819 | _3559_ | _7183_ | gf180mcu_fd_sc_mcu7t5v0__aoi21_1 | instruction/ROM
nom_ss_125C_4v50 | 291 | _7165_/ZN | 3.0 | 3.806681 | -0.806681 | _3543_ | _7165_ | gf180mcu_fd_sc_mcu7t5v0__aoi221_1 | instruction/ROM
nom_ss_125C_4v50 | 292 | _7169_/B1 | 3.0 | 3.806681 | -0.806681 | _3543_ | _7169_ | gf180mcu_fd_sc_mcu7t5v0__oai22_1 | instruction/ROM
nom_ss_125C_4v50 | 293 | _6039_/A1 | 3.0 | 3.77436 | -0.774361 | _1427_ | _6039_ | gf180mcu_fd_sc_mcu7t5v0__nand2_1 | instruction/ROM
nom_ss_125C_4v50 | 294 | _4812_/ZN | 3.0 | 3.774347 | -0.774347 | _1427_ | _4812_ | gf180mcu_fd_sc_mcu7t5v0__aoi21_1 | instruction/ROM
nom_ss_125C_4v50 | 295 | _4895_/A2 | 3.0 | 3.774347 | -0.774347 | _1427_ | _4895_ | gf180mcu_fd_sc_mcu7t5v0__nand3_1 | instruction/ROM
nom_ss_125C_4v50 | 296 | _7093_/A2 | 3.0 | 3.774347 | -0.774347 | _1427_ | _7093_ | gf180mcu_fd_sc_mcu7t5v0__oai22_1 | instruction/ROM
nom_ss_125C_4v50 | 297 | _6661_/ZN | 3.0 | 3.428677 | -0.428677 | _3110_ | _6661_ | gf180mcu_fd_sc_mcu7t5v0__aoi221_1 | data/register-file;instruction/ROM
nom_ss_125C_4v50 | 298 | _6662_/B2 | 3.0 | 3.428677 | -0.428677 | _3110_ | _6662_ | gf180mcu_fd_sc_mcu7t5v0__oai22_1 | data/register-file;instruction/ROM
nom_ss_125C_4v50 | 299 | _6052_/A1 | 3.0 | 3.425375 | -0.425375 | _1502_ | _6052_ | gf180mcu_fd_sc_mcu7t5v0__nor2_1 | instruction/ROM
nom_ss_125C_4v50 | 300 | _7102_/A2 | 3.0 | 3.42537 | -0.42537 | _1502_ | _7102_ | gf180mcu_fd_sc_mcu7t5v0__aoi211_2 | instruction/ROM
nom_ss_125C_4v50 | 301 | _4894_/A3 | 3.0 | 3.42536 | -0.425361 | _1502_ | _4894_ | gf180mcu_fd_sc_mcu7t5v0__nor4_1 | instruction/ROM
nom_ss_125C_4v50 | 302 | _4887_/ZN | 3.0 | 3.425347 | -0.425348 | _1502_ | _4887_ | gf180mcu_fd_sc_mcu7t5v0__oai211_1 | instruction/ROM
nom_ss_125C_4v50 | 303 | fanout90/I | 3.0 | 3.396216 | -0.396216 | _3439_ | fanout90 | gf180mcu_fd_sc_mcu7t5v0__buf_1 | instruction/ROM
nom_ss_125C_4v50 | 304 | fanout92/I | 3.0 | 3.396216 | -0.396216 | _3439_ | fanout92 | gf180mcu_fd_sc_mcu7t5v0__buf_1 | instruction/ROM
nom_ss_125C_4v50 | 305 | _7045_/ZN | 3.0 | 3.396214 | -0.396215 | _3439_ | _7045_ | gf180mcu_fd_sc_mcu7t5v0__aoi211_2 | instruction/ROM
nom_ss_125C_4v50 | 306 | fanout27/I | 3.0 | 3.356192 | -0.356192 | _3559_ | fanout27 | gf180mcu_fd_sc_mcu7t5v0__buf_1 | instruction/ROM
nom_ss_125C_4v50 | 307 | fanout29/I | 3.0 | 3.356191 | -0.356192 | _3559_ | fanout29 | gf180mcu_fd_sc_mcu7t5v0__buf_1 | instruction/ROM
nom_ss_125C_4v50 | 308 | _7183_/ZN | 3.0 | 3.35619 | -0.35619 | _3559_ | _7183_ | gf180mcu_fd_sc_mcu7t5v0__aoi21_1 | instruction/ROM
nom_ss_125C_4v50 | 309 | fanout348/I | 3.0 | 3.292011 | -0.292011 | net360 | fanout348 | gf180mcu_fd_sc_mcu7t5v0__buf_1 | instruction/ROM
nom_ss_125C_4v50 | 310 | fanout345/I | 3.0 | 3.292001 | -0.292002 | net360 | fanout345 | gf180mcu_fd_sc_mcu7t5v0__buf_1 | instruction/ROM
nom_ss_125C_4v50 | 311 | fanout349/I | 3.0 | 3.291993 | -0.291993 | net360 | fanout349 | gf180mcu_fd_sc_mcu7t5v0__buf_1 | instruction/ROM
nom_ss_125C_4v50 | 312 | fanout351/I | 3.0 | 3.291973 | -0.291973 | net360 | fanout351 | gf180mcu_fd_sc_mcu7t5v0__buf_1 | instruction/ROM
nom_ss_125C_4v50 | 313 | fanout358/I | 3.0 | 3.291891 | -0.291891 | net360 | fanout358 | gf180mcu_fd_sc_mcu7t5v0__buf_1 | instruction/ROM
nom_ss_125C_4v50 | 314 | fanout360/Z | 3.0 | 3.291891 | -0.291891 | net360 | fanout360 | gf180mcu_fd_sc_mcu7t5v0__buf_1 | instruction/ROM
nom_ss_125C_4v50 | 315 | fanout30/I | 3.0 | 3.274362 | -0.274362 | _3554_ | fanout30 | gf180mcu_fd_sc_mcu7t5v0__buf_1 | instruction/ROM
nom_ss_125C_4v50 | 316 | fanout32/I | 3.0 | 3.274362 | -0.274362 | _3554_ | fanout32 | gf180mcu_fd_sc_mcu7t5v0__buf_1 | instruction/ROM
nom_ss_125C_4v50 | 317 | _7177_/ZN | 3.0 | 3.27436 | -0.27436 | _3554_ | _7177_ | gf180mcu_fd_sc_mcu7t5v0__aoi211_2 | instruction/ROM
nom_ss_125C_4v50 | 318 | fanout57/I | 3.0 | 3.259526 | -0.259526 | _3503_ | fanout57 | gf180mcu_fd_sc_mcu7t5v0__buf_1 | instruction/ROM
nom_ss_125C_4v50 | 319 | fanout59/I | 3.0 | 3.259526 | -0.259526 | _3503_ | fanout59 | gf180mcu_fd_sc_mcu7t5v0__buf_1 | instruction/ROM
nom_ss_125C_4v50 | 320 | _7118_/ZN | 3.0 | 3.259524 | -0.259524 | _3503_ | _7118_ | gf180mcu_fd_sc_mcu7t5v0__aoi221_2 | instruction/ROM
nom_ss_125C_4v50 | 321 | _4499_/A1 | 3.0 | 3.253654 | -0.253654 | \u_pochoco_soc.data_wdata[6] | _4499_ | gf180mcu_fd_sc_mcu7t5v0__aoi22_1 | data/register-file;instruction/ROM
nom_ss_125C_4v50 | 322 | _8388_/I0 | 3.0 | 3.253639 | -0.253639 | \u_pochoco_soc.data_wdata[6] | _8388_ | gf180mcu_fd_sc_mcu7t5v0__mux2_2 | data/register-file;instruction/ROM
nom_ss_125C_4v50 | 323 | _8273_/I0 | 3.0 | 3.253627 | -0.253627 | \u_pochoco_soc.data_wdata[6] | _8273_ | gf180mcu_fd_sc_mcu7t5v0__mux2_2 | data/register-file;instruction/ROM
nom_ss_125C_4v50 | 324 | _6858_/I1 | 3.0 | 3.253574 | -0.253574 | \u_pochoco_soc.data_wdata[6] | _6858_ | gf180mcu_fd_sc_mcu7t5v0__mux2_2 | data/register-file;instruction/ROM
nom_ss_125C_4v50 | 325 | _6796_/A1 | 3.0 | 3.253531 | -0.253531 | \u_pochoco_soc.data_wdata[6] | _6796_ | gf180mcu_fd_sc_mcu7t5v0__nand2_1 | data/register-file;instruction/ROM
nom_ss_125C_4v50 | 326 | _6795_/A1 | 3.0 | 3.253496 | -0.253496 | \u_pochoco_soc.data_wdata[6] | _6795_ | gf180mcu_fd_sc_mcu7t5v0__and2_1 | data/register-file;instruction/ROM
nom_ss_125C_4v50 | 327 | _9251_/Q | 3.0 | 3.253437 | -0.253437 | \u_pochoco_soc.data_wdata[6] | _9251_ | gf180mcu_fd_sc_mcu7t5v0__dffrnq_1 | data/register-file;instruction/ROM
nom_ss_125C_4v50 | 328 | _6423_/ZN | 3.0 | 3.226698 | -0.226698 | _2886_ | _6423_ | gf180mcu_fd_sc_mcu7t5v0__aoi211_1 | instruction/ROM
nom_ss_125C_4v50 | 329 | _6424_/B1 | 3.0 | 3.226698 | -0.226698 | _2886_ | _6424_ | gf180mcu_fd_sc_mcu7t5v0__oai32_1 | instruction/ROM
nom_ss_125C_4v50 | 330 | ANTENNA_1/I | 3.0 | 3.215854 | -0.215854 | net286 | ANTENNA_1 | gf180mcu_fd_sc_mcu7t5v0__antenna | data/register-file;instruction/ROM
nom_ss_125C_4v50 | 331 | fanout277/I | 3.0 | 3.215853 | -0.215854 | net286 | fanout277 | gf180mcu_fd_sc_mcu7t5v0__buf_1 | data/register-file;instruction/ROM
nom_ss_125C_4v50 | 332 | fanout279/I | 3.0 | 3.215847 | -0.215848 | net286 | fanout279 | gf180mcu_fd_sc_mcu7t5v0__buf_1 | data/register-file;instruction/ROM
nom_ss_125C_4v50 | 333 | fanout281/I | 3.0 | 3.215833 | -0.215833 | net286 | fanout281 | gf180mcu_fd_sc_mcu7t5v0__buf_1 | data/register-file;instruction/ROM
nom_ss_125C_4v50 | 334 | fanout285/I | 3.0 | 3.215813 | -0.215813 | net286 | fanout285 | gf180mcu_fd_sc_mcu7t5v0__buf_1 | data/register-file;instruction/ROM
nom_ss_125C_4v50 | 335 | fanout283/I | 3.0 | 3.215789 | -0.215789 | net286 | fanout283 | gf180mcu_fd_sc_mcu7t5v0__buf_1 | data/register-file;instruction/ROM
nom_ss_125C_4v50 | 336 | fanout286/Z | 3.0 | 3.215789 | -0.215789 | net286 | fanout286 | gf180mcu_fd_sc_mcu7t5v0__buf_1 | data/register-file;instruction/ROM
nom_ss_125C_4v50 | 337 | _6415_/ZN | 3.0 | 3.185307 | -0.185307 | _2878_ | _6415_ | gf180mcu_fd_sc_mcu7t5v0__nor2_1 | instruction/ROM
nom_ss_125C_4v50 | 338 | _6416_/A2 | 3.0 | 3.185307 | -0.185307 | _2878_ | _6416_ | gf180mcu_fd_sc_mcu7t5v0__aoi21_1 | instruction/ROM
nom_ss_125C_4v50 | 339 | _6553_/A2 | 3.0 | 3.185307 | -0.185307 | _2878_ | _6553_ | gf180mcu_fd_sc_mcu7t5v0__aoi21_1 | instruction/ROM
nom_ss_125C_4v50 | 340 | _6610_/A3 | 3.0 | 3.185307 | -0.185307 | _2878_ | _6610_ | gf180mcu_fd_sc_mcu7t5v0__nand3_1 | instruction/ROM
nom_ss_125C_4v50 | 341 | _6611_/A2 | 3.0 | 3.185307 | -0.185307 | _2878_ | _6611_ | gf180mcu_fd_sc_mcu7t5v0__xor2_1 | instruction/ROM
nom_ss_125C_4v50 | 342 | _6647_/B1 | 3.0 | 3.185307 | -0.185307 | _2878_ | _6647_ | gf180mcu_fd_sc_mcu7t5v0__aoi221_1 | instruction/ROM
nom_ss_125C_4v50 | 343 | fanout133/I | 3.0 | 3.173455 | -0.173455 | _3322_ | fanout133 | gf180mcu_fd_sc_mcu7t5v0__buf_1 | instruction/ROM
nom_ss_125C_4v50 | 344 | fanout135/I | 3.0 | 3.173455 | -0.173455 | _3322_ | fanout135 | gf180mcu_fd_sc_mcu7t5v0__buf_1 | instruction/ROM
nom_ss_125C_4v50 | 345 | _6918_/ZN | 3.0 | 3.173452 | -0.173453 | _3322_ | _6918_ | gf180mcu_fd_sc_mcu7t5v0__aoi211_2 | instruction/ROM
nom_ss_125C_4v50 | 346 | _6629_/A2 | 3.0 | 3.169557 | -0.169557 | _2796_ | _6629_ | gf180mcu_fd_sc_mcu7t5v0__oai21_1 | instruction/ROM
nom_ss_125C_4v50 | 347 | _6332_/A2 | 3.0 | 3.169556 | -0.169556 | _2796_ | _6332_ | gf180mcu_fd_sc_mcu7t5v0__nand2_1 | instruction/ROM
nom_ss_125C_4v50 | 348 | _6421_/A2 | 3.0 | 3.169553 | -0.169553 | _2796_ | _6421_ | gf180mcu_fd_sc_mcu7t5v0__aoi211_1 | instruction/ROM
nom_ss_125C_4v50 | 349 | _6330_/ZN | 3.0 | 3.16954 | -0.169541 | _2796_ | _6330_ | gf180mcu_fd_sc_mcu7t5v0__nor2_1 | instruction/ROM
nom_ss_125C_4v50 | 350 | _6510_/A2 | 3.0 | 3.16954 | -0.169541 | _2796_ | _6510_ | gf180mcu_fd_sc_mcu7t5v0__nor2_1 | instruction/ROM
nom_ss_125C_4v50 | 351 | _6696_/A3 | 3.0 | 3.16954 | -0.169541 | _2796_ | _6696_ | gf180mcu_fd_sc_mcu7t5v0__nand4_1 | instruction/ROM
nom_ss_125C_4v50 | 352 | fanout38/I | 3.0 | 3.145761 | -0.145761 | _3541_ | fanout38 | gf180mcu_fd_sc_mcu7t5v0__buf_1 | instruction/ROM
nom_ss_125C_4v50 | 353 | _7162_/ZN | 3.0 | 3.14576 | -0.14576 | _3541_ | _7162_ | gf180mcu_fd_sc_mcu7t5v0__aoi221_2 | instruction/ROM
nom_ss_125C_4v50 | 354 | fanout36/I | 3.0 | 3.14576 | -0.14576 | _3541_ | fanout36 | gf180mcu_fd_sc_mcu7t5v0__buf_1 | instruction/ROM
nom_ss_125C_4v50 | 355 | _6015_/I0 | 3.0 | 3.102484 | -0.102484 | _1397_ | _6015_ | gf180mcu_fd_sc_mcu7t5v0__mux2_2 | instruction/ROM
nom_ss_125C_4v50 | 356 | _4782_/ZN | 3.0 | 3.102474 | -0.102474 | _1397_ | _4782_ | gf180mcu_fd_sc_mcu7t5v0__oai21_1 | instruction/ROM
nom_ss_125C_4v50 | 357 | _4789_/A1 | 3.0 | 3.102474 | -0.102474 | _1397_ | _4789_ | gf180mcu_fd_sc_mcu7t5v0__nor2_1 | instruction/ROM
nom_ss_125C_4v50 | 358 | _7078_/A2 | 3.0 | 3.102474 | -0.102474 | _1397_ | _7078_ | gf180mcu_fd_sc_mcu7t5v0__aoi211_1 | instruction/ROM
nom_ss_125C_4v50 | 359 | _4479_/A1 | 3.0 | 3.074561 | -0.074561 | \u_pochoco_soc.data_wdata[5] | _4479_ | gf180mcu_fd_sc_mcu7t5v0__aoi22_1 | data/register-file;instruction/ROM
nom_ss_125C_4v50 | 360 | _8387_/I0 | 3.0 | 3.074548 | -0.074548 | \u_pochoco_soc.data_wdata[5] | _8387_ | gf180mcu_fd_sc_mcu7t5v0__mux2_2 | data/register-file;instruction/ROM
nom_ss_125C_4v50 | 361 | _8272_/I0 | 3.0 | 3.07453 | -0.07453 | \u_pochoco_soc.data_wdata[5] | _8272_ | gf180mcu_fd_sc_mcu7t5v0__mux2_2 | data/register-file;instruction/ROM
nom_ss_125C_4v50 | 362 | _6857_/I1 | 3.0 | 3.074489 | -0.074489 | \u_pochoco_soc.data_wdata[5] | _6857_ | gf180mcu_fd_sc_mcu7t5v0__mux2_2 | data/register-file;instruction/ROM
nom_ss_125C_4v50 | 363 | _6791_/A1 | 3.0 | 3.074416 | -0.074416 | \u_pochoco_soc.data_wdata[5] | _6791_ | gf180mcu_fd_sc_mcu7t5v0__nand2_1 | data/register-file;instruction/ROM
nom_ss_125C_4v50 | 364 | _6790_/A1 | 3.0 | 3.074368 | -0.074368 | \u_pochoco_soc.data_wdata[5] | _6790_ | gf180mcu_fd_sc_mcu7t5v0__and2_1 | data/register-file;instruction/ROM
nom_ss_125C_4v50 | 365 | _9250_/Q | 3.0 | 3.074331 | -0.074331 | \u_pochoco_soc.data_wdata[5] | _9250_ | gf180mcu_fd_sc_mcu7t5v0__dffrnq_1 | data/register-file;instruction/ROM
nom_ss_125C_4v50 | 366 | _6575_/A2 | 3.0 | 3.035445 | -0.035445 | _2750_ | _6575_ | gf180mcu_fd_sc_mcu7t5v0__nand3_1 | instruction/ROM
nom_ss_125C_4v50 | 367 | _6557_/B | 3.0 | 3.035443 | -0.035443 | _2750_ | _6557_ | gf180mcu_fd_sc_mcu7t5v0__oai211_1 | instruction/ROM
nom_ss_125C_4v50 | 368 | _6283_/ZN | 3.0 | 3.035433 | -0.035433 | _2750_ | _6283_ | gf180mcu_fd_sc_mcu7t5v0__nor2_1 | instruction/ROM
nom_ss_125C_4v50 | 369 | _6488_/A1 | 3.0 | 3.035433 | -0.035433 | _2750_ | _6488_ | gf180mcu_fd_sc_mcu7t5v0__nand3_1 | instruction/ROM
nom_ss_125C_4v50 | 370 | _6496_/B | 3.0 | 3.035433 | -0.035433 | _2750_ | _6496_ | gf180mcu_fd_sc_mcu7t5v0__oai21_1 | instruction/ROM
nom_ss_125C_4v50 | 371 | _6587_/C | 3.0 | 3.035433 | -0.035433 | _2750_ | _6587_ | gf180mcu_fd_sc_mcu7t5v0__oai211_1 | instruction/ROM
nom_ss_125C_4v50 | 372 | _6720_/A1 | 3.0 | 3.035433 | -0.035433 | _2750_ | _6720_ | gf180mcu_fd_sc_mcu7t5v0__nand3_1 | instruction/ROM
