eaponce1/Proyecto3_Arquitectura_de_Computadores_Grupo_1/reports/stage9/electrical_util40_debounce.csv

type | net | count | worst_value | limit | worst_slack | drivers | classification | sample_pin | roots
slew | net385 | 11 | 6.292998 | 3.0 | -3.292998 | fanout385/Z:gf180mcu_fd_sc_mcu7t5v0__dlyb_1 | instruction/ROM/fetch | _5591_/A2 | \u_pochoco_soc.genblk1.g_rom_ram_memory.u_ram.a_rdata_o[15];\u_pochoco_soc.genblk1.g_rom_ram_memory.u_ram.a_rdata_o[16];\u_pochoco_soc.genblk1.g_rom_ram_memory.u_ram.a_rdata_o[17];\u_pochoco_soc.genblk1.g_rom_ram_memory.u_ram.a_rdata_o[18]
slew | net494 | 11 | 5.939054 | 3.0 | -2.939054 | fanout494/Z:gf180mcu_fd_sc_mcu7t5v0__dlyb_1 | instruction/ROM/fetch | _5502_/B1 | \u_pochoco_soc.genblk1.g_rom_ram_memory.u_ram.a_rdata_o[15];\u_pochoco_soc.genblk1.g_rom_ram_memory.u_ram.a_rdata_o[16];\u_pochoco_soc.genblk1.g_rom_ram_memory.u_ram.a_rdata_o[17];\u_pochoco_soc.genblk1.g_rom_ram_memory.u_ram.a_rdata_o[18]
slew | net453 | 11 | 5.908012 | 3.0 | -2.908013 | fanout453/Z:gf180mcu_fd_sc_mcu7t5v0__dlyb_1 | instruction/ROM/fetch | _5147_/A2 | \u_pochoco_soc.genblk1.g_rom_ram_memory.u_ram.a_rdata_o[20];\u_pochoco_soc.genblk1.g_rom_ram_memory.u_ram.a_rdata_o[21];\u_pochoco_soc.genblk1.g_rom_ram_memory.u_ram.a_rdata_o[22];\u_pochoco_soc.genblk1.g_rom_ram_memory.u_ram.a_rdata_o[23]
slew | net406 | 11 | 5.825825 | 3.0 | -2.825825 | fanout406/Z:gf180mcu_fd_sc_mcu7t5v0__dlyb_1 | instruction/ROM/fetch | _5593_/B1 | \u_pochoco_soc.genblk1.g_rom_ram_memory.u_ram.a_rdata_o[15];\u_pochoco_soc.genblk1.g_rom_ram_memory.u_ram.a_rdata_o[16];\u_pochoco_soc.genblk1.g_rom_ram_memory.u_ram.a_rdata_o[17];\u_pochoco_soc.genblk1.g_rom_ram_memory.u_ram.a_rdata_o[18]
slew | net389 | 11 | 5.555351 | 3.0 | -2.555351 | fanout389/Z:gf180mcu_fd_sc_mcu7t5v0__dlyb_1 | instruction/ROM/fetch | _5504_/B1 | \u_pochoco_soc.genblk1.g_rom_ram_memory.u_ram.a_rdata_o[15];\u_pochoco_soc.genblk1.g_rom_ram_memory.u_ram.a_rdata_o[16];\u_pochoco_soc.genblk1.g_rom_ram_memory.u_ram.a_rdata_o[17];\u_pochoco_soc.genblk1.g_rom_ram_memory.u_ram.a_rdata_o[18]
slew | net441 | 11 | 5.534668 | 3.0 | -2.534668 | fanout441/Z:gf180mcu_fd_sc_mcu7t5v0__dlyb_1 | instruction/ROM/fetch | _5216_/A2 | \u_pochoco_soc.genblk1.g_rom_ram_memory.u_ram.a_rdata_o[20];\u_pochoco_soc.genblk1.g_rom_ram_memory.u_ram.a_rdata_o[21];\u_pochoco_soc.genblk1.g_rom_ram_memory.u_ram.a_rdata_o[22];\u_pochoco_soc.genblk1.g_rom_ram_memory.u_ram.a_rdata_o[23]
slew | net445 | 11 | 5.481779 | 3.0 | -2.481779 | fanout445/Z:gf180mcu_fd_sc_mcu7t5v0__dlyb_1 | instruction/ROM/fetch | _5310_/B1 | \u_pochoco_soc.genblk1.g_rom_ram_memory.u_ram.a_rdata_o[20];\u_pochoco_soc.genblk1.g_rom_ram_memory.u_ram.a_rdata_o[21];\u_pochoco_soc.genblk1.g_rom_ram_memory.u_ram.a_rdata_o[22];\u_pochoco_soc.genblk1.g_rom_ram_memory.u_ram.a_rdata_o[23]
slew | net461 | 11 | 5.472543 | 3.0 | -2.472543 | fanout461/Z:gf180mcu_fd_sc_mcu7t5v0__dlyb_1 | instruction/ROM/fetch | _5041_/A2 | \u_pochoco_soc.genblk1.g_rom_ram_memory.u_ram.a_rdata_o[20];\u_pochoco_soc.genblk1.g_rom_ram_memory.u_ram.a_rdata_o[21];\u_pochoco_soc.genblk1.g_rom_ram_memory.u_ram.a_rdata_o[22];\u_pochoco_soc.genblk1.g_rom_ram_memory.u_ram.a_rdata_o[23]
slew | net515 | 11 | 5.436253 | 3.0 | -2.436253 | fanout515/Z:gf180mcu_fd_sc_mcu7t5v0__dlyb_1 | instruction/ROM/fetch | _5211_/A2 | \u_pochoco_soc.genblk1.g_rom_ram_memory.u_ram.a_rdata_o[20];\u_pochoco_soc.genblk1.g_rom_ram_memory.u_ram.a_rdata_o[21];\u_pochoco_soc.genblk1.g_rom_ram_memory.u_ram.a_rdata_o[22];\u_pochoco_soc.genblk1.g_rom_ram_memory.u_ram.a_rdata_o[23]
slew | net525 | 11 | 5.423307 | 3.0 | -2.423307 | fanout525/Z:gf180mcu_fd_sc_mcu7t5v0__dlyb_1 | instruction/ROM/fetch | _5218_/B1 | \u_pochoco_soc.genblk1.g_rom_ram_memory.u_ram.a_rdata_o[20];\u_pochoco_soc.genblk1.g_rom_ram_memory.u_ram.a_rdata_o[21];\u_pochoco_soc.genblk1.g_rom_ram_memory.u_ram.a_rdata_o[22];\u_pochoco_soc.genblk1.g_rom_ram_memory.u_ram.a_rdata_o[23]
slew | net457 | 11 | 5.414199 | 3.0 | -2.414199 | fanout457/Z:gf180mcu_fd_sc_mcu7t5v0__dlyb_1 | instruction/ROM/fetch | _5293_/A2 | \u_pochoco_soc.genblk1.g_rom_ram_memory.u_ram.a_rdata_o[20];\u_pochoco_soc.genblk1.g_rom_ram_memory.u_ram.a_rdata_o[21];\u_pochoco_soc.genblk1.g_rom_ram_memory.u_ram.a_rdata_o[22];\u_pochoco_soc.genblk1.g_rom_ram_memory.u_ram.a_rdata_o[23]
slew | net449 | 11 | 5.37408 | 3.0 | -2.37408 | fanout449/Z:gf180mcu_fd_sc_mcu7t5v0__dlyb_1 | instruction/ROM/fetch | _5126_/B1 | \u_pochoco_soc.genblk1.g_rom_ram_memory.u_ram.a_rdata_o[20];\u_pochoco_soc.genblk1.g_rom_ram_memory.u_ram.a_rdata_o[21];\u_pochoco_soc.genblk1.g_rom_ram_memory.u_ram.a_rdata_o[22];\u_pochoco_soc.genblk1.g_rom_ram_memory.u_ram.a_rdata_o[23]
slew | net391 | 11 | 5.347527 | 3.0 | -2.347527 | fanout391/Z:gf180mcu_fd_sc_mcu7t5v0__dlyb_1 | instruction/ROM/fetch | _5481_/C1 | \u_pochoco_soc.genblk1.g_rom_ram_memory.u_ram.a_rdata_o[15];\u_pochoco_soc.genblk1.g_rom_ram_memory.u_ram.a_rdata_o[16];\u_pochoco_soc.genblk1.g_rom_ram_memory.u_ram.a_rdata_o[17];\u_pochoco_soc.genblk1.g_rom_ram_memory.u_ram.a_rdata_o[18]
slew | net383 | 11 | 5.328076 | 3.0 | -2.328076 | fanout383/Z:gf180mcu_fd_sc_mcu7t5v0__dlyb_1 | instruction/ROM/fetch | _5483_/B1 | \u_pochoco_soc.genblk1.g_rom_ram_memory.u_ram.a_rdata_o[15];\u_pochoco_soc.genblk1.g_rom_ram_memory.u_ram.a_rdata_o[16];\u_pochoco_soc.genblk1.g_rom_ram_memory.u_ram.a_rdata_o[17];\u_pochoco_soc.genblk1.g_rom_ram_memory.u_ram.a_rdata_o[18]
slew | net505 | 11 | 5.26292 | 3.0 | -2.26292 | fanout505/Z:gf180mcu_fd_sc_mcu7t5v0__dlyb_1 | instruction/ROM/fetch | _5407_/A1 | \u_pochoco_soc.genblk1.g_rom_ram_memory.u_ram.a_rdata_o[16];\u_pochoco_soc.genblk1.g_rom_ram_memory.u_ram.a_rdata_o[17];\u_pochoco_soc.genblk1.g_rom_ram_memory.u_ram.a_rdata_o[18]
slew | net410 | 11 | 5.25511 | 3.0 | -2.25511 | fanout410/Z:gf180mcu_fd_sc_mcu7t5v0__dlyb_1 | instruction/ROM/fetch | _5498_/A2 | \u_pochoco_soc.genblk1.g_rom_ram_memory.u_ram.a_rdata_o[15];\u_pochoco_soc.genblk1.g_rom_ram_memory.u_ram.a_rdata_o[16];\u_pochoco_soc.genblk1.g_rom_ram_memory.u_ram.a_rdata_o[17];\u_pochoco_soc.genblk1.g_rom_ram_memory.u_ram.a_rdata_o[18]
slew | net404 | 11 | 5.246819 | 3.0 | -2.246819 | fanout404/Z:gf180mcu_fd_sc_mcu7t5v0__dlyb_1 | instruction/ROM/fetch | _5479_/A2 | \u_pochoco_soc.genblk1.g_rom_ram_memory.u_ram.a_rdata_o[15];\u_pochoco_soc.genblk1.g_rom_ram_memory.u_ram.a_rdata_o[16];\u_pochoco_soc.genblk1.g_rom_ram_memory.u_ram.a_rdata_o[17];\u_pochoco_soc.genblk1.g_rom_ram_memory.u_ram.a_rdata_o[18]
slew | net427 | 11 | 5.205278 | 3.0 | -2.205278 | fanout427/Z:gf180mcu_fd_sc_mcu7t5v0__dlyb_1 | instruction/ROM/fetch | _5127_/B1 | \u_pochoco_soc.genblk1.g_rom_ram_memory.u_ram.a_rdata_o[20];\u_pochoco_soc.genblk1.g_rom_ram_memory.u_ram.a_rdata_o[21];\u_pochoco_soc.genblk1.g_rom_ram_memory.u_ram.a_rdata_o[22];\u_pochoco_soc.genblk1.g_rom_ram_memory.u_ram.a_rdata_o[23]
slew | net451 | 11 | 5.198896 | 3.0 | -2.198896 | fanout451/Z:gf180mcu_fd_sc_mcu7t5v0__dlyb_1 | instruction/ROM/fetch | _5106_/A2 | \u_pochoco_soc.genblk1.g_rom_ram_memory.u_ram.a_rdata_o[20];\u_pochoco_soc.genblk1.g_rom_ram_memory.u_ram.a_rdata_o[21];\u_pochoco_soc.genblk1.g_rom_ram_memory.u_ram.a_rdata_o[22];\u_pochoco_soc.genblk1.g_rom_ram_memory.u_ram.a_rdata_o[23]
slew | net572 | 11 | 5.197213 | 3.0 | -2.197213 | fanout572/Z:gf180mcu_fd_sc_mcu7t5v0__dlyb_1 | instruction/ROM/fetch | _5254_/A1 | \u_pochoco_soc.genblk1.g_rom_ram_memory.u_ram.a_rdata_o[20]
slew | net520 | 11 | 5.192734 | 3.0 | -2.192734 | fanout520/Z:gf180mcu_fd_sc_mcu7t5v0__dlyb_1 | instruction/ROM/fetch | _5034_/B1 | \u_pochoco_soc.genblk1.g_rom_ram_memory.u_ram.a_rdata_o[20];\u_pochoco_soc.genblk1.g_rom_ram_memory.u_ram.a_rdata_o[21];\u_pochoco_soc.genblk1.g_rom_ram_memory.u_ram.a_rdata_o[22];\u_pochoco_soc.genblk1.g_rom_ram_memory.u_ram.a_rdata_o[23]
slew | net372 | 11 | 5.164437 | 3.0 | -2.164437 | fanout372/Z:gf180mcu_fd_sc_mcu7t5v0__dlyb_1 | instruction/ROM/fetch | _5499_/B1 | \u_pochoco_soc.genblk1.g_rom_ram_memory.u_ram.a_rdata_o[15];\u_pochoco_soc.genblk1.g_rom_ram_memory.u_ram.a_rdata_o[16];\u_pochoco_soc.genblk1.g_rom_ram_memory.u_ram.a_rdata_o[17];\u_pochoco_soc.genblk1.g_rom_ram_memory.u_ram.a_rdata_o[18]
slew | net578 | 11 | 5.14245 | 3.0 | -2.14245 | fanout578/Z:gf180mcu_fd_sc_mcu7t5v0__dlyb_1 | instruction/ROM/fetch | _5629_/A1 | \u_pochoco_soc.genblk1.g_rom_ram_memory.u_ram.a_rdata_o[15]
slew | net396 | 11 | 5.080528 | 3.0 | -2.080528 | fanout396/Z:gf180mcu_fd_sc_mcu7t5v0__dlyb_1 | instruction/ROM/fetch | _5492_/A2 | \u_pochoco_soc.genblk1.g_rom_ram_memory.u_ram.a_rdata_o[15];\u_pochoco_soc.genblk1.g_rom_ram_memory.u_ram.a_rdata_o[16];\u_pochoco_soc.genblk1.g_rom_ram_memory.u_ram.a_rdata_o[17];\u_pochoco_soc.genblk1.g_rom_ram_memory.u_ram.a_rdata_o[18]
slew | net415 | 11 | 5.059905 | 3.0 | -2.059905 | fanout415/Z:gf180mcu_fd_sc_mcu7t5v0__dlyb_1 | instruction/ROM/fetch | _5689_/A2 | \u_pochoco_soc.genblk1.g_rom_ram_memory.u_ram.a_rdata_o[15];\u_pochoco_soc.genblk1.g_rom_ram_memory.u_ram.a_rdata_o[16];\u_pochoco_soc.genblk1.g_rom_ram_memory.u_ram.a_rdata_o[17];\u_pochoco_soc.genblk1.g_rom_ram_memory.u_ram.a_rdata_o[18]
slew | net376 | 11 | 5.036539 | 3.0 | -2.036539 | fanout376/Z:gf180mcu_fd_sc_mcu7t5v0__dlyb_1 | instruction/ROM/fetch | _5635_/A2 | \u_pochoco_soc.genblk1.g_rom_ram_memory.u_ram.a_rdata_o[15];\u_pochoco_soc.genblk1.g_rom_ram_memory.u_ram.a_rdata_o[16];\u_pochoco_soc.genblk1.g_rom_ram_memory.u_ram.a_rdata_o[17];\u_pochoco_soc.genblk1.g_rom_ram_memory.u_ram.a_rdata_o[18]
slew | net419 | 11 | 4.998137 | 3.0 | -1.998137 | fanout419/Z:gf180mcu_fd_sc_mcu7t5v0__dlyb_1 | instruction/ROM/fetch | _5038_/B1 | \u_pochoco_soc.genblk1.g_rom_ram_memory.u_ram.a_rdata_o[20];\u_pochoco_soc.genblk1.g_rom_ram_memory.u_ram.a_rdata_o[21];\u_pochoco_soc.genblk1.g_rom_ram_memory.u_ram.a_rdata_o[22];\u_pochoco_soc.genblk1.g_rom_ram_memory.u_ram.a_rdata_o[23]
slew | net439 | 11 | 4.992509 | 3.0 | -1.992509 | fanout439/Z:gf180mcu_fd_sc_mcu7t5v0__dlyb_1 | instruction/ROM/fetch | _5115_/C1 | \u_pochoco_soc.genblk1.g_rom_ram_memory.u_ram.a_rdata_o[20];\u_pochoco_soc.genblk1.g_rom_ram_memory.u_ram.a_rdata_o[21];\u_pochoco_soc.genblk1.g_rom_ram_memory.u_ram.a_rdata_o[22];\u_pochoco_soc.genblk1.g_rom_ram_memory.u_ram.a_rdata_o[23]
slew | net402 | 11 | 4.992507 | 3.0 | -1.992507 | fanout402/Z:gf180mcu_fd_sc_mcu7t5v0__dlyb_1 | instruction/ROM/fetch | _5689_/C1 | \u_pochoco_soc.genblk1.g_rom_ram_memory.u_ram.a_rdata_o[15];\u_pochoco_soc.genblk1.g_rom_ram_memory.u_ram.a_rdata_o[16];\u_pochoco_soc.genblk1.g_rom_ram_memory.u_ram.a_rdata_o[17];\u_pochoco_soc.genblk1.g_rom_ram_memory.u_ram.a_rdata_o[18]
slew | net429 | 11 | 4.981109 | 3.0 | -1.981109 | fanout429/Z:gf180mcu_fd_sc_mcu7t5v0__dlyb_1 | instruction/ROM/fetch | _5110_/A2 | \u_pochoco_soc.genblk1.g_rom_ram_memory.u_ram.a_rdata_o[20];\u_pochoco_soc.genblk1.g_rom_ram_memory.u_ram.a_rdata_o[21];\u_pochoco_soc.genblk1.g_rom_ram_memory.u_ram.a_rdata_o[22];\u_pochoco_soc.genblk1.g_rom_ram_memory.u_ram.a_rdata_o[23]
slew | net499 | 11 | 4.942176 | 3.0 | -1.942176 | fanout499/Z:gf180mcu_fd_sc_mcu7t5v0__dlyb_1 | instruction/ROM/fetch | _5630_/A2 | \u_pochoco_soc.genblk1.g_rom_ram_memory.u_ram.a_rdata_o[15];\u_pochoco_soc.genblk1.g_rom_ram_memory.u_ram.a_rdata_o[16];\u_pochoco_soc.genblk1.g_rom_ram_memory.u_ram.a_rdata_o[17];\u_pochoco_soc.genblk1.g_rom_ram_memory.u_ram.a_rdata_o[18]
slew | net398 | 11 | 4.894895 | 3.0 | -1.894894 | fanout398/Z:gf180mcu_fd_sc_mcu7t5v0__dlyb_1 | instruction/ROM/fetch | _5499_/A2 | \u_pochoco_soc.genblk1.g_rom_ram_memory.u_ram.a_rdata_o[15];\u_pochoco_soc.genblk1.g_rom_ram_memory.u_ram.a_rdata_o[16];\u_pochoco_soc.genblk1.g_rom_ram_memory.u_ram.a_rdata_o[17];\u_pochoco_soc.genblk1.g_rom_ram_memory.u_ram.a_rdata_o[18]
slew | net576 | 11 | 4.887074 | 3.0 | -1.887074 | fanout576/Z:gf180mcu_fd_sc_mcu7t5v0__dlyb_1 | instruction/ROM/fetch | _5486_/A1 | \u_pochoco_soc.genblk1.g_rom_ram_memory.u_ram.a_rdata_o[15]
slew | net503 | 11 | 4.854876 | 3.0 | -1.854876 | fanout503/Z:gf180mcu_fd_sc_mcu7t5v0__dlyb_1 | instruction/ROM/fetch | _5504_/A2 | \u_pochoco_soc.genblk1.g_rom_ram_memory.u_ram.a_rdata_o[15];\u_pochoco_soc.genblk1.g_rom_ram_memory.u_ram.a_rdata_o[16];\u_pochoco_soc.genblk1.g_rom_ram_memory.u_ram.a_rdata_o[17];\u_pochoco_soc.genblk1.g_rom_ram_memory.u_ram.a_rdata_o[18]
slew | net408 | 11 | 4.836231 | 3.0 | -1.836231 | fanout408/Z:gf180mcu_fd_sc_mcu7t5v0__dlyb_1 | instruction/ROM/fetch | _5481_/B1 | \u_pochoco_soc.genblk1.g_rom_ram_memory.u_ram.a_rdata_o[15];\u_pochoco_soc.genblk1.g_rom_ram_memory.u_ram.a_rdata_o[16];\u_pochoco_soc.genblk1.g_rom_ram_memory.u_ram.a_rdata_o[17];\u_pochoco_soc.genblk1.g_rom_ram_memory.u_ram.a_rdata_o[18]
slew | net570 | 11 | 4.787389 | 3.0 | -1.787389 | fanout570/Z:gf180mcu_fd_sc_mcu7t5v0__dlyb_1 | instruction/ROM/fetch | _5109_/A1 | \u_pochoco_soc.genblk1.g_rom_ram_memory.u_ram.a_rdata_o[20]
slew | net455 | 11 | 4.749793 | 3.0 | -1.749793 | fanout455/Z:gf180mcu_fd_sc_mcu7t5v0__dlyb_1 | instruction/ROM/fetch | _4972_/B1 | \u_pochoco_soc.genblk1.g_rom_ram_memory.u_ram.a_rdata_o[20];\u_pochoco_soc.genblk1.g_rom_ram_memory.u_ram.a_rdata_o[21];\u_pochoco_soc.genblk1.g_rom_ram_memory.u_ram.a_rdata_o[22];\u_pochoco_soc.genblk1.g_rom_ram_memory.u_ram.a_rdata_o[23]
slew | net431 | 11 | 4.745797 | 3.0 | -1.745797 | fanout431/Z:gf180mcu_fd_sc_mcu7t5v0__dlyb_1 | instruction/ROM/fetch | _5212_/B1 | \u_pochoco_soc.genblk1.g_rom_ram_memory.u_ram.a_rdata_o[20];\u_pochoco_soc.genblk1.g_rom_ram_memory.u_ram.a_rdata_o[21];\u_pochoco_soc.genblk1.g_rom_ram_memory.u_ram.a_rdata_o[22];\u_pochoco_soc.genblk1.g_rom_ram_memory.u_ram.a_rdata_o[23]
slew | net387 | 11 | 4.694713 | 3.0 | -1.694713 | fanout387/Z:gf180mcu_fd_sc_mcu7t5v0__dlyb_1 | instruction/ROM/fetch | _5487_/A2 | \u_pochoco_soc.genblk1.g_rom_ram_memory.u_ram.a_rdata_o[15];\u_pochoco_soc.genblk1.g_rom_ram_memory.u_ram.a_rdata_o[16];\u_pochoco_soc.genblk1.g_rom_ram_memory.u_ram.a_rdata_o[17];\u_pochoco_soc.genblk1.g_rom_ram_memory.u_ram.a_rdata_o[18]
slew | net492 | 11 | 4.684342 | 3.0 | -1.684342 | fanout492/Z:gf180mcu_fd_sc_mcu7t5v0__dlyb_1 | instruction/ROM/fetch | _5367_/B1 | \u_pochoco_soc.genblk1.g_rom_ram_memory.u_ram.a_rdata_o[15];\u_pochoco_soc.genblk1.g_rom_ram_memory.u_ram.a_rdata_o[16];\u_pochoco_soc.genblk1.g_rom_ram_memory.u_ram.a_rdata_o[17];\u_pochoco_soc.genblk1.g_rom_ram_memory.u_ram.a_rdata_o[18]
slew | net443 | 11 | 4.663358 | 3.0 | -1.663358 | fanout443/Z:gf180mcu_fd_sc_mcu7t5v0__dlyb_1 | instruction/ROM/fetch | _4982_/B1 | \u_pochoco_soc.genblk1.g_rom_ram_memory.u_ram.a_rdata_o[20];\u_pochoco_soc.genblk1.g_rom_ram_memory.u_ram.a_rdata_o[21];\u_pochoco_soc.genblk1.g_rom_ram_memory.u_ram.a_rdata_o[22];\u_pochoco_soc.genblk1.g_rom_ram_memory.u_ram.a_rdata_o[23]
slew | net518 | 11 | 4.66324 | 3.0 | -1.663241 | fanout518/Z:gf180mcu_fd_sc_mcu7t5v0__dlyb_1 | instruction/ROM/fetch | _5137_/A2 | \u_pochoco_soc.genblk1.g_rom_ram_memory.u_ram.a_rdata_o[20];\u_pochoco_soc.genblk1.g_rom_ram_memory.u_ram.a_rdata_o[21];\u_pochoco_soc.genblk1.g_rom_ram_memory.u_ram.a_rdata_o[22];\u_pochoco_soc.genblk1.g_rom_ram_memory.u_ram.a_rdata_o[23]
slew | net423 | 11 | 4.661865 | 3.0 | -1.661865 | fanout423/Z:gf180mcu_fd_sc_mcu7t5v0__dlyb_1 | instruction/ROM/fetch | _5037_/B1 | \u_pochoco_soc.genblk1.g_rom_ram_memory.u_ram.a_rdata_o[20];\u_pochoco_soc.genblk1.g_rom_ram_memory.u_ram.a_rdata_o[21];\u_pochoco_soc.genblk1.g_rom_ram_memory.u_ram.a_rdata_o[22];\u_pochoco_soc.genblk1.g_rom_ram_memory.u_ram.a_rdata_o[23]
slew | net497 | 11 | 4.619921 | 3.0 | -1.619921 | fanout497/Z:gf180mcu_fd_sc_mcu7t5v0__dlyb_1 | instruction/ROM/fetch | _5377_/B1 | \u_pochoco_soc.genblk1.g_rom_ram_memory.u_ram.a_rdata_o[15];\u_pochoco_soc.genblk1.g_rom_ram_memory.u_ram.a_rdata_o[16];\u_pochoco_soc.genblk1.g_rom_ram_memory.u_ram.a_rdata_o[17];\u_pochoco_soc.genblk1.g_rom_ram_memory.u_ram.a_rdata_o[18]
slew | net374 | 11 | 4.612693 | 3.0 | -1.612693 | fanout374/Z:gf180mcu_fd_sc_mcu7t5v0__dlyb_1 | instruction/ROM/fetch | _5570_/A2 | \u_pochoco_soc.genblk1.g_rom_ram_memory.u_ram.a_rdata_o[15];\u_pochoco_soc.genblk1.g_rom_ram_memory.u_ram.a_rdata_o[16];\u_pochoco_soc.genblk1.g_rom_ram_memory.u_ram.a_rdata_o[17];\u_pochoco_soc.genblk1.g_rom_ram_memory.u_ram.a_rdata_o[18]
slew | net447 | 11 | 4.610529 | 3.0 | -1.61053 | fanout447/Z:gf180mcu_fd_sc_mcu7t5v0__dlyb_1 | instruction/ROM/fetch | _4982_/A2 | \u_pochoco_soc.genblk1.g_rom_ram_memory.u_ram.a_rdata_o[20];\u_pochoco_soc.genblk1.g_rom_ram_memory.u_ram.a_rdata_o[21];\u_pochoco_soc.genblk1.g_rom_ram_memory.u_ram.a_rdata_o[22];\u_pochoco_soc.genblk1.g_rom_ram_memory.u_ram.a_rdata_o[23]
slew | net417 | 11 | 4.593194 | 3.0 | -1.593194 | fanout417/Z:gf180mcu_fd_sc_mcu7t5v0__dlyb_1 | instruction/ROM/fetch | _5196_/B1 | \u_pochoco_soc.genblk1.g_rom_ram_memory.u_ram.a_rdata_o[20];\u_pochoco_soc.genblk1.g_rom_ram_memory.u_ram.a_rdata_o[21];\u_pochoco_soc.genblk1.g_rom_ram_memory.u_ram.a_rdata_o[22];\u_pochoco_soc.genblk1.g_rom_ram_memory.u_ram.a_rdata_o[23]
slew | net413 | 11 | 4.584728 | 3.0 | -1.584728 | fanout413/Z:gf180mcu_fd_sc_mcu7t5v0__dlyb_1 | instruction/ROM/fetch | _5489_/A2 | \u_pochoco_soc.genblk1.g_rom_ram_memory.u_ram.a_rdata_o[15];\u_pochoco_soc.genblk1.g_rom_ram_memory.u_ram.a_rdata_o[16];\u_pochoco_soc.genblk1.g_rom_ram_memory.u_ram.a_rdata_o[17];\u_pochoco_soc.genblk1.g_rom_ram_memory.u_ram.a_rdata_o[18]
slew | net508 | 11 | 4.562138 | 3.0 | -1.562138 | fanout508/Z:gf180mcu_fd_sc_mcu7t5v0__dlyb_1 | instruction/ROM/fetch | _5361_/B | \u_pochoco_soc.genblk1.g_rom_ram_memory.u_ram.a_rdata_o[16];\u_pochoco_soc.genblk1.g_rom_ram_memory.u_ram.a_rdata_o[17];\u_pochoco_soc.genblk1.g_rom_ram_memory.u_ram.a_rdata_o[18]
slew | net400 | 11 | 4.560236 | 3.0 | -1.560236 | fanout400/Z:gf180mcu_fd_sc_mcu7t5v0__dlyb_1 | instruction/ROM/fetch | _5355_/B1 | \u_pochoco_soc.genblk1.g_rom_ram_memory.u_ram.a_rdata_o[15];\u_pochoco_soc.genblk1.g_rom_ram_memory.u_ram.a_rdata_o[16];\u_pochoco_soc.genblk1.g_rom_ram_memory.u_ram.a_rdata_o[17];\u_pochoco_soc.genblk1.g_rom_ram_memory.u_ram.a_rdata_o[18]
slew | net459 | 11 | 4.547777 | 3.0 | -1.547777 | fanout459/Z:gf180mcu_fd_sc_mcu7t5v0__dlyb_1 | instruction/ROM/fetch | _5102_/A2 | \u_pochoco_soc.genblk1.g_rom_ram_memory.u_ram.a_rdata_o[20];\u_pochoco_soc.genblk1.g_rom_ram_memory.u_ram.a_rdata_o[21];\u_pochoco_soc.genblk1.g_rom_ram_memory.u_ram.a_rdata_o[22];\u_pochoco_soc.genblk1.g_rom_ram_memory.u_ram.a_rdata_o[23]
slew | net378 | 11 | 4.495589 | 3.0 | -1.495589 | fanout378/Z:gf180mcu_fd_sc_mcu7t5v0__dlyb_1 | instruction/ROM/fetch | _5575_/B1 | \u_pochoco_soc.genblk1.g_rom_ram_memory.u_ram.a_rdata_o[15];\u_pochoco_soc.genblk1.g_rom_ram_memory.u_ram.a_rdata_o[16];\u_pochoco_soc.genblk1.g_rom_ram_memory.u_ram.a_rdata_o[17];\u_pochoco_soc.genblk1.g_rom_ram_memory.u_ram.a_rdata_o[18]
slew | net523 | 11 | 4.484746 | 3.0 | -1.484747 | fanout523/Z:gf180mcu_fd_sc_mcu7t5v0__dlyb_1 | instruction/ROM/fetch | _5092_/A2 | \u_pochoco_soc.genblk1.g_rom_ram_memory.u_ram.a_rdata_o[20];\u_pochoco_soc.genblk1.g_rom_ram_memory.u_ram.a_rdata_o[21];\u_pochoco_soc.genblk1.g_rom_ram_memory.u_ram.a_rdata_o[22];\u_pochoco_soc.genblk1.g_rom_ram_memory.u_ram.a_rdata_o[23]
slew | net532 | 11 | 4.444011 | 3.0 | -1.444011 | fanout532/Z:gf180mcu_fd_sc_mcu7t5v0__dlyb_1 | instruction/ROM/fetch | _5036_/B | \u_pochoco_soc.genblk1.g_rom_ram_memory.u_ram.a_rdata_o[21];\u_pochoco_soc.genblk1.g_rom_ram_memory.u_ram.a_rdata_o[22];\u_pochoco_soc.genblk1.g_rom_ram_memory.u_ram.a_rdata_o[23]
slew | net425 | 11 | 4.377245 | 3.0 | -1.377245 | fanout425/Z:gf180mcu_fd_sc_mcu7t5v0__dlyb_1 | instruction/ROM/fetch | _4992_/B1 | \u_pochoco_soc.genblk1.g_rom_ram_memory.u_ram.a_rdata_o[20];\u_pochoco_soc.genblk1.g_rom_ram_memory.u_ram.a_rdata_o[21];\u_pochoco_soc.genblk1.g_rom_ram_memory.u_ram.a_rdata_o[22];\u_pochoco_soc.genblk1.g_rom_ram_memory.u_ram.a_rdata_o[23]
slew | net350 | 11 | 4.373249 | 3.0 | -1.373249 | fanout350/Z:gf180mcu_fd_sc_mcu7t5v0__dlyb_1 | instruction/ROM/fetch | _4480_/A1 | \u_pochoco_soc.genblk1.g_rom_ram_memory.u_ram.a_rdata_o[0];\u_pochoco_soc.genblk1.g_rom_ram_memory.u_ram.a_rdata_o[12];\u_pochoco_soc.genblk1.g_rom_ram_memory.u_ram.a_rdata_o[13];\u_pochoco_soc.genblk1.g_rom_ram_memory.u_ram.a_rdata_o[14];\u_pochoco_soc.genblk1.g_rom_ram_memory.u_ram.a_rdata_o[2];\u_pochoco_soc.genblk1.g_rom_ram_memory.u_ram.a_rdata_o[30];\u_pochoco_soc.genblk1.g_rom_ram_memory.u_ram.a_rdata_o[3];\u_pochoco_soc.genblk1.g_rom_ram_memory.u_ram.a_rdata_o[4];\u_pochoco_soc.genblk1.g_rom_ram_memory.u_ram.a_rdata_o[5];\u_pochoco_soc.genblk1.g_rom_ram_memory.u_ram.a_rdata_o[6]
slew | net501 | 11 | 4.341233 | 3.0 | -1.341233 | fanout501/Z:gf180mcu_fd_sc_mcu7t5v0__dlyb_1 | instruction/ROM/fetch | _5545_/A2 | \u_pochoco_soc.genblk1.g_rom_ram_memory.u_ram.a_rdata_o[15];\u_pochoco_soc.genblk1.g_rom_ram_memory.u_ram.a_rdata_o[16];\u_pochoco_soc.genblk1.g_rom_ram_memory.u_ram.a_rdata_o[17];\u_pochoco_soc.genblk1.g_rom_ram_memory.u_ram.a_rdata_o[18]
slew | net434 | 11 | 4.335784 | 3.0 | -1.335784 | fanout434/Z:gf180mcu_fd_sc_mcu7t5v0__dlyb_1 | instruction/ROM/fetch | _5006_/B1 | \u_pochoco_soc.genblk1.g_rom_ram_memory.u_ram.a_rdata_o[20];\u_pochoco_soc.genblk1.g_rom_ram_memory.u_ram.a_rdata_o[21];\u_pochoco_soc.genblk1.g_rom_ram_memory.u_ram.a_rdata_o[22];\u_pochoco_soc.genblk1.g_rom_ram_memory.u_ram.a_rdata_o[23]
slew | net513 | 11 | 4.277419 | 3.0 | -1.277419 | fanout513/Z:gf180mcu_fd_sc_mcu7t5v0__dlyb_1 | instruction/ROM/fetch | _5117_/B1 | \u_pochoco_soc.genblk1.g_rom_ram_memory.u_ram.a_rdata_o[20];\u_pochoco_soc.genblk1.g_rom_ram_memory.u_ram.a_rdata_o[21];\u_pochoco_soc.genblk1.g_rom_ram_memory.u_ram.a_rdata_o[22];\u_pochoco_soc.genblk1.g_rom_ram_memory.u_ram.a_rdata_o[23]
slew | net393 | 11 | 4.252704 | 3.0 | -1.252704 | fanout393/Z:gf180mcu_fd_sc_mcu7t5v0__dlyb_1 | instruction/ROM/fetch | _5534_/A2 | \u_pochoco_soc.genblk1.g_rom_ram_memory.u_ram.a_rdata_o[15];\u_pochoco_soc.genblk1.g_rom_ram_memory.u_ram.a_rdata_o[16];\u_pochoco_soc.genblk1.g_rom_ram_memory.u_ram.a_rdata_o[17];\u_pochoco_soc.genblk1.g_rom_ram_memory.u_ram.a_rdata_o[18]
slew | net352 | 11 | 4.179132 | 3.0 | -1.179132 | fanout352/Z:gf180mcu_fd_sc_mcu7t5v0__dlyb_1 | instruction/ROM/fetch | _4552_/A1 | \u_pochoco_soc.genblk1.g_rom_ram_memory.u_ram.a_rdata_o[0];\u_pochoco_soc.genblk1.g_rom_ram_memory.u_ram.a_rdata_o[12];\u_pochoco_soc.genblk1.g_rom_ram_memory.u_ram.a_rdata_o[13];\u_pochoco_soc.genblk1.g_rom_ram_memory.u_ram.a_rdata_o[14];\u_pochoco_soc.genblk1.g_rom_ram_memory.u_ram.a_rdata_o[2];\u_pochoco_soc.genblk1.g_rom_ram_memory.u_ram.a_rdata_o[30];\u_pochoco_soc.genblk1.g_rom_ram_memory.u_ram.a_rdata_o[3];\u_pochoco_soc.genblk1.g_rom_ram_memory.u_ram.a_rdata_o[4];\u_pochoco_soc.genblk1.g_rom_ram_memory.u_ram.a_rdata_o[5];\u_pochoco_soc.genblk1.g_rom_ram_memory.u_ram.a_rdata_o[6]
slew | net510 | 11 | 4.174822 | 3.0 | -1.174822 | fanout510/Z:gf180mcu_fd_sc_mcu7t5v0__dlyb_1 | instruction/ROM/fetch | _5412_/B | \u_pochoco_soc.genblk1.g_rom_ram_memory.u_ram.a_rdata_o[16];\u_pochoco_soc.genblk1.g_rom_ram_memory.u_ram.a_rdata_o[17];\u_pochoco_soc.genblk1.g_rom_ram_memory.u_ram.a_rdata_o[18]
slew | net436 | 11 | 4.137627 | 3.0 | -1.137627 | fanout436/Z:gf180mcu_fd_sc_mcu7t5v0__dlyb_1 | instruction/ROM/fetch | _5280_/A2 | \u_pochoco_soc.genblk1.g_rom_ram_memory.u_ram.a_rdata_o[20];\u_pochoco_soc.genblk1.g_rom_ram_memory.u_ram.a_rdata_o[21];\u_pochoco_soc.genblk1.g_rom_ram_memory.u_ram.a_rdata_o[22];\u_pochoco_soc.genblk1.g_rom_ram_memory.u_ram.a_rdata_o[23]
slew | net233 | 11 | 4.094296 | 3.0 | -1.094296 | fanout233/Z:gf180mcu_fd_sc_mcu7t5v0__dlyb_1 | instruction/ROM/fetch | _7485_/A2 | \u_pochoco_soc.genblk1.g_rom_ram_memory.u_ram.a_addr_i[17];\u_pochoco_soc.genblk1.g_rom_ram_memory.u_ram.a_addr_i[18];\u_pochoco_soc.genblk1.g_rom_ram_memory.u_ram.a_addr_i[20];\u_pochoco_soc.genblk1.g_rom_ram_memory.u_ram.a_rdata_o[0];\u_pochoco_soc.genblk1.g_rom_ram_memory.u_ram.a_rdata_o[10];\u_pochoco_soc.genblk1.g_rom_ram_memory.u_ram.a_rdata_o[11];\u_pochoco_soc.genblk1.g_rom_ram_memory.u_ram.a_rdata_o[12];\u_pochoco_soc.genblk1.g_rom_ram_memory.u_ram.a_rdata_o[13];\u_pochoco_soc.genblk1.g_rom_ram_memory.u_ram.a_rdata_o[14];\u_pochoco_soc.genblk1.g_rom_ram_memory.u_ram.a_rdata_o[19];\u_pochoco_soc.genblk1.g_rom_ram_memory.u_ram.a_rdata_o[24];\u_pochoco_soc.genblk1.g_rom_ram_memory.u_ram.a_rdata_o[25];\u_pochoco_soc.genblk1.g_rom_ram_memory.u_ram.a_rdata_o[26];\u_pochoco_soc.genblk1.g_rom_ram_memory.u_ram.a_rdata_o[27];\u_pochoco_soc.genblk1.g_rom_ram_memory.u_ram.a_rdata_o[28];\u_pochoco_soc.genblk1.g_rom_ram_memory.u_ram.a_rdata_o[29];\u_pochoco_soc.genblk1.g_rom_ram_memory.u_ram.a_rdata_o[2];\u_pochoco_soc.genblk1.g_rom_ram_memory.u_ram.a_rdata_o[30];\u_pochoco_soc.genblk1.g_rom_ram_memory.u_ram.a_rdata_o[31];\u_pochoco_soc.genblk1.g_rom_ram_memory.u_ram.a_rdata_o[3];\u_pochoco_soc.genblk1.g_rom_ram_memory.u_ram.a_rdata_o[4];\u_pochoco_soc.genblk1.g_rom_ram_memory.u_ram.a_rdata_o[5];\u_pochoco_soc.genblk1.g_rom_ram_memory.u_ram.a_rdata_o[6];\u_pochoco_soc.genblk1.g_rom_ram_memory.u_ram.a_rdata_o[7];\u_pochoco_soc.genblk1.g_rom_ram_memory.u_ram.a_rdata_o[8];\u_pochoc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
slew | net261 | 11 | 4.081411 | 3.0 | -1.081411 | fanout261/Z:gf180mcu_fd_sc_mcu7t5v0__dlyb_1 | instruction/ROM/fetch | _7253_/A2 | \u_pochoco_soc.genblk1.g_rom_ram_memory.u_ram.a_addr_i[17];\u_pochoco_soc.genblk1.g_rom_ram_memory.u_ram.a_addr_i[18];\u_pochoco_soc.genblk1.g_rom_ram_memory.u_ram.a_addr_i[20];\u_pochoco_soc.genblk1.g_rom_ram_memory.u_ram.a_rdata_o[0];\u_pochoco_soc.genblk1.g_rom_ram_memory.u_ram.a_rdata_o[10];\u_pochoco_soc.genblk1.g_rom_ram_memory.u_ram.a_rdata_o[11];\u_pochoco_soc.genblk1.g_rom_ram_memory.u_ram.a_rdata_o[12];\u_pochoco_soc.genblk1.g_rom_ram_memory.u_ram.a_rdata_o[13];\u_pochoco_soc.genblk1.g_rom_ram_memory.u_ram.a_rdata_o[14];\u_pochoco_soc.genblk1.g_rom_ram_memory.u_ram.a_rdata_o[19];\u_pochoco_soc.genblk1.g_rom_ram_memory.u_ram.a_rdata_o[24];\u_pochoco_soc.genblk1.g_rom_ram_memory.u_ram.a_rdata_o[25];\u_pochoco_soc.genblk1.g_rom_ram_memory.u_ram.a_rdata_o[26];\u_pochoco_soc.genblk1.g_rom_ram_memory.u_ram.a_rdata_o[27];\u_pochoco_soc.genblk1.g_rom_ram_memory.u_ram.a_rdata_o[28];\u_pochoco_soc.genblk1.g_rom_ram_memory.u_ram.a_rdata_o[29];\u_pochoco_soc.genblk1.g_rom_ram_memory.u_ram.a_rdata_o[2];\u_pochoco_soc.genblk1.g_rom_ram_memory.u_ram.a_rdata_o[30];\u_pochoco_soc.genblk1.g_rom_ram_memory.u_ram.a_rdata_o[31];\u_pochoco_soc.genblk1.g_rom_ram_memory.u_ram.a_rdata_o[3];\u_pochoco_soc.genblk1.g_rom_ram_memory.u_ram.a_rdata_o[4];\u_pochoco_soc.genblk1.g_rom_ram_memory.u_ram.a_rdata_o[5];\u_pochoco_soc.genblk1.g_rom_ram_memory.u_ram.a_rdata_o[6];\u_pochoco_soc.genblk1.g_rom_ram_memory.u_ram.a_rdata_o[7];\u_pochoco_soc.genblk1.g_rom_ram_memory.u_ram.a_rdata_o[8];\u_pochoc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
slew | net370 | 11 | 4.074893 | 3.0 | -1.074894 | fanout370/Z:gf180mcu_fd_sc_mcu7t5v0__dlyb_1 | instruction/ROM/fetch | _5373_/B1 | \u_pochoco_soc.genblk1.g_rom_ram_memory.u_ram.a_rdata_o[15];\u_pochoco_soc.genblk1.g_rom_ram_memory.u_ram.a_rdata_o[16];\u_pochoco_soc.genblk1.g_rom_ram_memory.u_ram.a_rdata_o[17];\u_pochoco_soc.genblk1.g_rom_ram_memory.u_ram.a_rdata_o[18]
slew | net421 | 11 | 4.061298 | 3.0 | -1.061298 | fanout421/Z:gf180mcu_fd_sc_mcu7t5v0__dlyb_1 | instruction/ROM/fetch | _4995_/A2 | \u_pochoco_soc.genblk1.g_rom_ram_memory.u_ram.a_rdata_o[20];\u_pochoco_soc.genblk1.g_rom_ram_memory.u_ram.a_rdata_o[21];\u_pochoco_soc.genblk1.g_rom_ram_memory.u_ram.a_rdata_o[22];\u_pochoco_soc.genblk1.g_rom_ram_memory.u_ram.a_rdata_o[23]
slew | net363 | 11 | 3.979528 | 3.0 | -0.979528 | fanout363/Z:gf180mcu_fd_sc_mcu7t5v0__dlyb_1 | instruction/ROM/fetch | _7062_/A1 | \u_pochoco_soc.genblk1.g_rom_ram_memory.u_ram.a_rdata_o[0];\u_pochoco_soc.genblk1.g_rom_ram_memory.u_ram.a_rdata_o[2];\u_pochoco_soc.genblk1.g_rom_ram_memory.u_ram.a_rdata_o[3];\u_pochoco_soc.genblk1.g_rom_ram_memory.u_ram.a_rdata_o[4];\u_pochoco_soc.genblk1.g_rom_ram_memory.u_ram.a_rdata_o[5];\u_pochoco_soc.genblk1.g_rom_ram_memory.u_ram.a_rdata_o[6]
slew | net471 | 11 | 3.969243 | 3.0 | -0.969243 | fanout471/Z:gf180mcu_fd_sc_mcu7t5v0__dlyb_1 | instruction/ROM/fetch | _4363_/A1 | \u_pochoco_soc.genblk1.g_rom_ram_memory.u_ram.a_rdata_o[0];\u_pochoco_soc.genblk1.g_rom_ram_memory.u_ram.a_rdata_o[2];\u_pochoco_soc.genblk1.g_rom_ram_memory.u_ram.a_rdata_o[4];\u_pochoco_soc.genblk1.g_rom_ram_memory.u_ram.a_rdata_o[5];\u_pochoco_soc.genblk1.g_rom_ram_memory.u_ram.a_rdata_o[6]
slew | net579 | 11 | 3.958904 | 3.0 | -0.958904 | fanout579/Z:gf180mcu_fd_sc_mcu7t5v0__dlyb_1 | instruction/ROM/fetch | _4234_/I | \u_pochoco_soc.genblk1.g_rom_ram_memory.u_ram.a_rdata_o[15]
slew | _2333_ | 11 | 3.935752 | 3.0 | -0.935752 | _5832_/ZN:gf180mcu_fd_sc_mcu7t5v0__nand2_1 | instruction/ROM/fetch+register-file | _6560_/A3 | \u_pochoco_soc.genblk1.g_rom_ram_memory.u_ram.a_addr_i[2];\u_pochoco_soc.genblk1.g_rom_ram_memory.u_ram.a_addr_i[4];\u_pochoco_soc.genblk1.g_rom_ram_memory.u_ram.a_rdata_o[0];\u_pochoco_soc.genblk1.g_rom_ram_memory.u_ram.a_rdata_o[11];\u_pochoco_soc.genblk1.g_rom_ram_memory.u_ram.a_rdata_o[12];\u_pochoco_soc.genblk1.g_rom_ram_memory.u_ram.a_rdata_o[13];\u_pochoco_soc.genblk1.g_rom_ram_memory.u_ram.a_rdata_o[14];\u_pochoco_soc.genblk1.g_rom_ram_memory.u_ram.a_rdata_o[15];\u_pochoco_soc.genblk1.g_rom_ram_memory.u_ram.a_rdata_o[19];\u_pochoco_soc.genblk1.g_rom_ram_memory.u_ram.a_rdata_o[23];\u_pochoco_soc.genblk1.g_rom_ram_memory.u_ram.a_rdata_o[24];\u_pochoco_soc.genblk1.g_rom_ram_memory.u_ram.a_rdata_o[25];\u_pochoco_soc.genblk1.g_rom_ram_memory.u_ram.a_rdata_o[26];\u_pochoco_soc.genblk1.g_rom_ram_memory.u_ram.a_rdata_o[27];\u_pochoco_soc.genblk1.g_rom_ram_memory.u_ram.a_rdata_o[28];\u_pochoco_soc.genblk1.g_rom_ram_memory.u_ram.a_rdata_o[29];\u_pochoco_soc.genblk1.g_rom_ram_memory.u_ram.a_rdata_o[2];\u_pochoco_soc.genblk1.g_rom_ram_memory.u_ram.a_rdata_o[30];\u_pochoco_soc.genblk1.g_rom_ram_memory.u_ram.a_rdata_o[31];\u_pochoco_soc.genblk1.g_rom_ram_memory.u_ram.a_rdata_o[3];\u_pochoco_soc.genblk1.g_rom_ram_memory.u_ram.a_rdata_o[4];\u_pochoco_soc.genblk1.g_rom_ram_memory.u_ram.a_rdata_o[5];\u_pochoco_soc.genblk1.g_rom_ram_memory.u_ram.a_rdata_o[6];\u_pochoco_soc.u_core.g_asic_regfile.u_rf.rdata_a_o[10];\u_pochoco_soc.u_core.g_asic_regfile.u_rf.rdata_a_o[11];\u_pochoco_soc.u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
slew | net573 | 11 | 3.927566 | 3.0 | -0.927566 | fanout573/Z:gf180mcu_fd_sc_mcu7t5v0__dlyb_1 | instruction/ROM/fetch | _4232_/I | \u_pochoco_soc.genblk1.g_rom_ram_memory.u_ram.a_rdata_o[20]
slew | net248 | 11 | 3.810899 | 3.0 | -0.810899 | fanout248/Z:gf180mcu_fd_sc_mcu7t5v0__dlyb_1 | instruction/ROM/fetch | fanout247/I | \u_pochoco_soc.genblk1.g_rom_ram_memory.u_ram.a_addr_i[17];\u_pochoco_soc.genblk1.g_rom_ram_memory.u_ram.a_addr_i[18];\u_pochoco_soc.genblk1.g_rom_ram_memory.u_ram.a_addr_i[20];\u_pochoco_soc.genblk1.g_rom_ram_memory.u_ram.a_rdata_o[0];\u_pochoco_soc.genblk1.g_rom_ram_memory.u_ram.a_rdata_o[10];\u_pochoco_soc.genblk1.g_rom_ram_memory.u_ram.a_rdata_o[11];\u_pochoco_soc.genblk1.g_rom_ram_memory.u_ram.a_rdata_o[12];\u_pochoco_soc.genblk1.g_rom_ram_memory.u_ram.a_rdata_o[13];\u_pochoco_soc.genblk1.g_rom_ram_memory.u_ram.a_rdata_o[14];\u_pochoco_soc.genblk1.g_rom_ram_memory.u_ram.a_rdata_o[19];\u_pochoco_soc.genblk1.g_rom_ram_memory.u_ram.a_rdata_o[24];\u_pochoco_soc.genblk1.g_rom_ram_memory.u_ram.a_rdata_o[25];\u_pochoco_soc.genblk1.g_rom_ram_memory.u_ram.a_rdata_o[26];\u_pochoco_soc.genblk1.g_rom_ram_memory.u_ram.a_rdata_o[27];\u_pochoco_soc.genblk1.g_rom_ram_memory.u_ram.a_rdata_o[28];\u_pochoco_soc.genblk1.g_rom_ram_memory.u_ram.a_rdata_o[29];\u_pochoco_soc.genblk1.g_rom_ram_memory.u_ram.a_rdata_o[2];\u_pochoco_soc.genblk1.g_rom_ram_memory.u_ram.a_rdata_o[30];\u_pochoco_soc.genblk1.g_rom_ram_memory.u_ram.a_rdata_o[31];\u_pochoco_soc.genblk1.g_rom_ram_memory.u_ram.a_rdata_o[3];\u_pochoco_soc.genblk1.g_rom_ram_memory.u_ram.a_rdata_o[4];\u_pochoco_soc.genblk1.g_rom_ram_memory.u_ram.a_rdata_o[5];\u_pochoco_soc.genblk1.g_rom_ram_memory.u_ram.a_rdata_o[6];\u_pochoco_soc.genblk1.g_rom_ram_memory.u_ram.a_rdata_o[7];\u_pochoco_soc.genblk1.g_rom_ram_memory.u_ram.a_rdata_o[8];\u_pochoc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
slew | net321 | 11 | 3.721953 | 3.0 | -0.721953 | fanout321/Z:gf180mcu_fd_sc_mcu7t5v0__dlyb_1 | instruction/ROM/fetch | _4816_/B2 | \u_pochoco_soc.genblk1.g_rom_ram_memory.u_ram.a_rdata_o[0];\u_pochoco_soc.genblk1.g_rom_ram_memory.u_ram.a_rdata_o[12];\u_pochoco_soc.genblk1.g_rom_ram_memory.u_ram.a_rdata_o[13];\u_pochoco_soc.genblk1.g_rom_ram_memory.u_ram.a_rdata_o[14];\u_pochoco_soc.genblk1.g_rom_ram_memory.u_ram.a_rdata_o[2];\u_pochoco_soc.genblk1.g_rom_ram_memory.u_ram.a_rdata_o[30];\u_pochoco_soc.genblk1.g_rom_ram_memory.u_ram.a_rdata_o[3];\u_pochoco_soc.genblk1.g_rom_ram_memory.u_ram.a_rdata_o[4];\u_pochoco_soc.genblk1.g_rom_ram_memory.u_ram.a_rdata_o[5];\u_pochoco_soc.genblk1.g_rom_ram_memory.u_ram.a_rdata_o[6]
slew | net586 | 11 | 3.690192 | 3.0 | -0.690192 | _6896_/S:gf180mcu_fd_sc_mcu7t5v0__mux2_2;_6914_/S:gf180mcu_fd_sc_mcu7t5v0__mux2_2;_6921_/S:gf180mcu_fd_sc_mcu7t5v0__mux2_2;_6944_/S:gf180mcu_fd_sc_mcu7t5v0__mux2_2;_6956_/S:gf180mcu_fd_sc_mcu7t5v0__mux2_2;_6958_/S:gf180mcu_fd_sc_mcu7t5v0__mux2_2;_6974_/S:gf180mcu_fd_sc_mcu7t5v0__mux2_2;fanout586/Z:gf180mcu_fd_sc_mcu7t5v0__dlyb_1 | data-memory+peripheral | _6974_/S | \u_pochoco_soc.genblk1.g_rom_ram_memory.u_ram.b_rdata_o[14];\u_pochoco_soc.genblk1.g_rom_ram_memory.u_ram.b_rdata_o[15];\u_pochoco_soc.genblk1.g_rom_ram_memory.u_ram.b_rdata_o[20];\u_pochoco_soc.genblk1.g_rom_ram_memory.u_ram.b_rdata_o[21];\u_pochoco_soc.genblk1.g_rom_ram_memory.u_ram.b_rdata_o[26];\u_pochoco_soc.genblk1.g_rom_ram_memory.u_ram.b_rdata_o[27];\u_pochoco_soc.genblk1.g_rom_ram_memory.u_ram.b_rdata_o[30];\u_pochoco_soc.per_rdata[14];\u_pochoco_soc.per_rdata[15];\u_pochoco_soc.per_rdata[20];\u_pochoco_soc.per_rdata[21];\u_pochoco_soc.per_rdata[26];\u_pochoco_soc.per_rdata[27];\u_pochoco_soc.per_rdata[30];\u_pochoco_soc.rd_is_per
slew | net168 | 11 | 3.68522 | 3.0 | -0.68522 | fanout168/Z:gf180mcu_fd_sc_mcu7t5v0__dlyb_1 | instruction/ROM/fetch | _8036_/A2 | \u_pochoco_soc.genblk1.g_rom_ram_memory.u_ram.a_addr_i[17];\u_pochoco_soc.genblk1.g_rom_ram_memory.u_ram.a_addr_i[18];\u_pochoco_soc.genblk1.g_rom_ram_memory.u_ram.a_addr_i[20];\u_pochoco_soc.genblk1.g_rom_ram_memory.u_ram.a_rdata_o[0];\u_pochoco_soc.genblk1.g_rom_ram_memory.u_ram.a_rdata_o[10];\u_pochoco_soc.genblk1.g_rom_ram_memory.u_ram.a_rdata_o[11];\u_pochoco_soc.genblk1.g_rom_ram_memory.u_ram.a_rdata_o[12];\u_pochoco_soc.genblk1.g_rom_ram_memory.u_ram.a_rdata_o[13];\u_pochoco_soc.genblk1.g_rom_ram_memory.u_ram.a_rdata_o[14];\u_pochoco_soc.genblk1.g_rom_ram_memory.u_ram.a_rdata_o[19];\u_pochoco_soc.genblk1.g_rom_ram_memory.u_ram.a_rdata_o[24];\u_pochoco_soc.genblk1.g_rom_ram_memory.u_ram.a_rdata_o[25];\u_pochoco_soc.genblk1.g_rom_ram_memory.u_ram.a_rdata_o[26];\u_pochoco_soc.genblk1.g_rom_ram_memory.u_ram.a_rdata_o[27];\u_pochoco_soc.genblk1.g_rom_ram_memory.u_ram.a_rdata_o[28];\u_pochoco_soc.genblk1.g_rom_ram_memory.u_ram.a_rdata_o[29];\u_pochoco_soc.genblk1.g_rom_ram_memory.u_ram.a_rdata_o[2];\u_pochoco_soc.genblk1.g_rom_ram_memory.u_ram.a_rdata_o[30];\u_pochoco_soc.genblk1.g_rom_ram_memory.u_ram.a_rdata_o[31];\u_pochoco_soc.genblk1.g_rom_ram_memory.u_ram.a_rdata_o[3];\u_pochoco_soc.genblk1.g_rom_ram_memory.u_ram.a_rdata_o[4];\u_pochoco_soc.genblk1.g_rom_ram_memory.u_ram.a_rdata_o[5];\u_pochoco_soc.genblk1.g_rom_ram_memory.u_ram.a_rdata_o[6];\u_pochoco_soc.genblk1.g_rom_ram_memory.u_ram.a_rdata_o[7];\u_pochoco_soc.genblk1.g_rom_ram_memory.u_ram.a_rdata_o[8];\u_pochoc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
slew | net506 | 11 | 3.675196 | 3.0 | -0.675196 | fanout506/Z:gf180mcu_fd_sc_mcu7t5v0__dlyb_1 | instruction/ROM/fetch | _5551_/A1 | \u_pochoco_soc.genblk1.g_rom_ram_memory.u_ram.a_rdata_o[16];\u_pochoco_soc.genblk1.g_rom_ram_memory.u_ram.a_rdata_o[17];\u_pochoco_soc.genblk1.g_rom_ram_memory.u_ram.a_rdata_o[18]
slew | net265 | 11 | 3.663928 | 3.0 | -0.663928 | fanout265/Z:gf180mcu_fd_sc_mcu7t5v0__dlyb_1 | instruction/ROM/fetch | _7261_/A2 | \u_pochoco_soc.genblk1.g_rom_ram_memory.u_ram.a_addr_i[17];\u_pochoco_soc.genblk1.g_rom_ram_memory.u_ram.a_addr_i[18];\u_pochoco_soc.genblk1.g_rom_ram_memory.u_ram.a_addr_i[20];\u_pochoco_soc.genblk1.g_rom_ram_memory.u_ram.a_rdata_o[0];\u_pochoco_soc.genblk1.g_rom_ram_memory.u_ram.a_rdata_o[10];\u_pochoco_soc.genblk1.g_rom_ram_memory.u_ram.a_rdata_o[11];\u_pochoco_soc.genblk1.g_rom_ram_memory.u_ram.a_rdata_o[12];\u_pochoco_soc.genblk1.g_rom_ram_memory.u_ram.a_rdata_o[13];\u_pochoco_soc.genblk1.g_rom_ram_memory.u_ram.a_rdata_o[14];\u_pochoco_soc.genblk1.g_rom_ram_memory.u_ram.a_rdata_o[19];\u_pochoco_soc.genblk1.g_rom_ram_memory.u_ram.a_rdata_o[24];\u_pochoco_soc.genblk1.g_rom_ram_memory.u_ram.a_rdata_o[25];\u_pochoco_soc.genblk1.g_rom_ram_memory.u_ram.a_rdata_o[26];\u_pochoco_soc.genblk1.g_rom_ram_memory.u_ram.a_rdata_o[27];\u_pochoco_soc.genblk1.g_rom_ram_memory.u_ram.a_rdata_o[28];\u_pochoco_soc.genblk1.g_rom_ram_memory.u_ram.a_rdata_o[29];\u_pochoco_soc.genblk1.g_rom_ram_memory.u_ram.a_rdata_o[2];\u_pochoco_soc.genblk1.g_rom_ram_memory.u_ram.a_rdata_o[30];\u_pochoco_soc.genblk1.g_rom_ram_memory.u_ram.a_rdata_o[31];\u_pochoco_soc.genblk1.g_rom_ram_memory.u_ram.a_rdata_o[3];\u_pochoco_soc.genblk1.g_rom_ram_memory.u_ram.a_rdata_o[4];\u_pochoco_soc.genblk1.g_rom_ram_memory.u_ram.a_rdata_o[5];\u_pochoco_soc.genblk1.g_rom_ram_memory.u_ram.a_rdata_o[6];\u_pochoco_soc.genblk1.g_rom_ram_memory.u_ram.a_rdata_o[7];\u_pochoco_soc.genblk1.g_rom_ram_memory.u_ram.a_rdata_o[8];\u_pochoc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
slew | net349 | 11 | 3.649566 | 3.0 | -0.649566 | fanout349/Z:gf180mcu_fd_sc_mcu7t5v0__dlyb_1 | instruction/ROM/fetch | _4588_/A1 | \u_pochoco_soc.genblk1.g_rom_ram_memory.u_ram.a_rdata_o[0];\u_pochoco_soc.genblk1.g_rom_ram_memory.u_ram.a_rdata_o[12];\u_pochoco_soc.genblk1.g_rom_ram_memory.u_ram.a_rdata_o[13];\u_pochoco_soc.genblk1.g_rom_ram_memory.u_ram.a_rdata_o[14];\u_pochoco_soc.genblk1.g_rom_ram_memory.u_ram.a_rdata_o[2];\u_pochoco_soc.genblk1.g_rom_ram_memory.u_ram.a_rdata_o[30];\u_pochoco_soc.genblk1.g_rom_ram_memory.u_ram.a_rdata_o[3];\u_pochoco_soc.genblk1.g_rom_ram_memory.u_ram.a_rdata_o[4];\u_pochoco_soc.genblk1.g_rom_ram_memory.u_ram.a_rdata_o[5];\u_pochoco_soc.genblk1.g_rom_ram_memory.u_ram.a_rdata_o[6]
slew | net473 | 11 | 3.642788 | 3.0 | -0.642788 | fanout473/Z:gf180mcu_fd_sc_mcu7t5v0__dlyb_1 | instruction/ROM/fetch | _7007_/B | \u_pochoco_soc.genblk1.g_rom_ram_memory.u_ram.a_rdata_o[0];\u_pochoco_soc.genblk1.g_rom_ram_memory.u_ram.a_rdata_o[2];\u_pochoco_soc.genblk1.g_rom_ram_memory.u_ram.a_rdata_o[4];\u_pochoco_soc.genblk1.g_rom_ram_memory.u_ram.a_rdata_o[5];\u_pochoco_soc.genblk1.g_rom_ram_memory.u_ram.a_rdata_o[6]
slew | net531 | 11 | 3.626166 | 3.0 | -0.626166 | fanout531/Z:gf180mcu_fd_sc_mcu7t5v0__dlyb_1 | instruction/ROM/fetch | _5213_/B | \u_pochoco_soc.genblk1.g_rom_ram_memory.u_ram.a_rdata_o[21];\u_pochoco_soc.genblk1.g_rom_ram_memory.u_ram.a_rdata_o[22];\u_pochoco_soc.genblk1.g_rom_ram_memory.u_ram.a_rdata_o[23]
slew | net171 | 11 | 3.615232 | 3.0 | -0.615233 | fanout171/Z:gf180mcu_fd_sc_mcu7t5v0__dlyb_1 | instruction/ROM/fetch | _8033_/A2 | \u_pochoco_soc.genblk1.g_rom_ram_memory.u_ram.a_addr_i[17];\u_pochoco_soc.genblk1.g_rom_ram_memory.u_ram.a_addr_i[18];\u_pochoco_soc.genblk1.g_rom_ram_memory.u_ram.a_addr_i[20];\u_pochoco_soc.genblk1.g_rom_ram_memory.u_ram.a_rdata_o[0];\u_pochoco_soc.genblk1.g_rom_ram_memory.u_ram.a_rdata_o[10];\u_pochoco_soc.genblk1.g_rom_ram_memory.u_ram.a_rdata_o[11];\u_pochoco_soc.genblk1.g_rom_ram_memory.u_ram.a_rdata_o[12];\u_pochoco_soc.genblk1.g_rom_ram_memory.u_ram.a_rdata_o[13];\u_pochoco_soc.genblk1.g_rom_ram_memory.u_ram.a_rdata_o[14];\u_pochoco_soc.genblk1.g_rom_ram_memory.u_ram.a_rdata_o[19];\u_pochoco_soc.genblk1.g_rom_ram_memory.u_ram.a_rdata_o[24];\u_pochoco_soc.genblk1.g_rom_ram_memory.u_ram.a_rdata_o[25];\u_pochoco_soc.genblk1.g_rom_ram_memory.u_ram.a_rdata_o[26];\u_pochoco_soc.genblk1.g_rom_ram_memory.u_ram.a_rdata_o[27];\u_pochoco_soc.genblk1.g_rom_ram_memory.u_ram.a_rdata_o[28];\u_pochoco_soc.genblk1.g_rom_ram_memory.u_ram.a_rdata_o[29];\u_pochoco_soc.genblk1.g_rom_ram_memory.u_ram.a_rdata_o[2];\u_pochoco_soc.genblk1.g_rom_ram_memory.u_ram.a_rdata_o[30];\u_pochoco_soc.genblk1.g_rom_ram_memory.u_ram.a_rdata_o[31];\u_pochoco_soc.genblk1.g_rom_ram_memory.u_ram.a_rdata_o[3];\u_pochoco_soc.genblk1.g_rom_ram_memory.u_ram.a_rdata_o[4];\u_pochoco_soc.genblk1.g_rom_ram_memory.u_ram.a_rdata_o[5];\u_pochoco_soc.genblk1.g_rom_ram_memory.u_ram.a_rdata_o[6];\u_pochoco_soc.genblk1.g_rom_ram_memory.u_ram.a_rdata_o[7];\u_pochoco_soc.genblk1.g_rom_ram_memory.u_ram.a_rdata_o[8];\u_pochoc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
slew | net273 | 11 | 3.606817 | 3.0 | -0.606817 | fanout273/Z:gf180mcu_fd_sc_mcu7t5v0__dlyb_1 | instruction/ROM/fetch | fanout271/I | \u_pochoco_soc.genblk1.g_rom_ram_memory.u_ram.a_addr_i[17];\u_pochoco_soc.genblk1.g_rom_ram_memory.u_ram.a_addr_i[18];\u_pochoco_soc.genblk1.g_rom_ram_memory.u_ram.a_addr_i[20];\u_pochoco_soc.genblk1.g_rom_ram_memory.u_ram.a_rdata_o[0];\u_pochoco_soc.genblk1.g_rom_ram_memory.u_ram.a_rdata_o[10];\u_pochoco_soc.genblk1.g_rom_ram_memory.u_ram.a_rdata_o[11];\u_pochoco_soc.genblk1.g_rom_ram_memory.u_ram.a_rdata_o[12];\u_pochoco_soc.genblk1.g_rom_ram_memory.u_ram.a_rdata_o[13];\u_pochoco_soc.genblk1.g_rom_ram_memory.u_ram.a_rdata_o[14];\u_pochoco_soc.genblk1.g_rom_ram_memory.u_ram.a_rdata_o[19];\u_pochoco_soc.genblk1.g_rom_ram_memory.u_ram.a_rdata_o[24];\u_pochoco_soc.genblk1.g_rom_ram_memory.u_ram.a_rdata_o[25];\u_pochoco_soc.genblk1.g_rom_ram_memory.u_ram.a_rdata_o[26];\u_pochoco_soc.genblk1.g_rom_ram_memory.u_ram.a_rdata_o[27];\u_pochoco_soc.genblk1.g_rom_ram_memory.u_ram.a_rdata_o[28];\u_pochoco_soc.genblk1.g_rom_ram_memory.u_ram.a_rdata_o[29];\u_pochoco_soc.genblk1.g_rom_ram_memory.u_ram.a_rdata_o[2];\u_pochoco_soc.genblk1.g_rom_ram_memory.u_ram.a_rdata_o[30];\u_pochoco_soc.genblk1.g_rom_ram_memory.u_ram.a_rdata_o[31];\u_pochoco_soc.genblk1.g_rom_ram_memory.u_ram.a_rdata_o[3];\u_pochoco_soc.genblk1.g_rom_ram_memory.u_ram.a_rdata_o[4];\u_pochoco_soc.genblk1.g_rom_ram_memory.u_ram.a_rdata_o[5];\u_pochoco_soc.genblk1.g_rom_ram_memory.u_ram.a_rdata_o[6];\u_pochoco_soc.genblk1.g_rom_ram_memory.u_ram.a_rdata_o[7];\u_pochoco_soc.genblk1.g_rom_ram_memory.u_ram.a_rdata_o[8];\u_pochoc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
slew | net230 | 11 | 3.594406 | 3.0 | -0.594406 | fanout230/Z:gf180mcu_fd_sc_mcu7t5v0__dlyb_1 | instruction/ROM/fetch | _7546_/A2 | \u_pochoco_soc.genblk1.g_rom_ram_memory.u_ram.a_addr_i[17];\u_pochoco_soc.genblk1.g_rom_ram_memory.u_ram.a_addr_i[18];\u_pochoco_soc.genblk1.g_rom_ram_memory.u_ram.a_addr_i[20];\u_pochoco_soc.genblk1.g_rom_ram_memory.u_ram.a_rdata_o[0];\u_pochoco_soc.genblk1.g_rom_ram_memory.u_ram.a_rdata_o[10];\u_pochoco_soc.genblk1.g_rom_ram_memory.u_ram.a_rdata_o[11];\u_pochoco_soc.genblk1.g_rom_ram_memory.u_ram.a_rdata_o[12];\u_pochoco_soc.genblk1.g_rom_ram_memory.u_ram.a_rdata_o[13];\u_pochoco_soc.genblk1.g_rom_ram_memory.u_ram.a_rdata_o[14];\u_pochoco_soc.genblk1.g_rom_ram_memory.u_ram.a_rdata_o[19];\u_pochoco_soc.genblk1.g_rom_ram_memory.u_ram.a_rdata_o[24];\u_pochoco_soc.genblk1.g_rom_ram_memory.u_ram.a_rdata_o[25];\u_pochoco_soc.genblk1.g_rom_ram_memory.u_ram.a_rdata_o[26];\u_pochoco_soc.genblk1.g_rom_ram_memory.u_ram.a_rdata_o[27];\u_pochoco_soc.genblk1.g_rom_ram_memory.u_ram.a_rdata_o[28];\u_pochoco_soc.genblk1.g_rom_ram_memory.u_ram.a_rdata_o[29];\u_pochoco_soc.genblk1.g_rom_ram_memory.u_ram.a_rdata_o[2];\u_pochoco_soc.genblk1.g_rom_ram_memory.u_ram.a_rdata_o[30];\u_pochoco_soc.genblk1.g_rom_ram_memory.u_ram.a_rdata_o[31];\u_pochoco_soc.genblk1.g_rom_ram_memory.u_ram.a_rdata_o[3];\u_pochoco_soc.genblk1.g_rom_ram_memory.u_ram.a_rdata_o[4];\u_pochoco_soc.genblk1.g_rom_ram_memory.u_ram.a_rdata_o[5];\u_pochoco_soc.genblk1.g_rom_ram_memory.u_ram.a_rdata_o[6];\u_pochoco_soc.genblk1.g_rom_ram_memory.u_ram.a_rdata_o[7];\u_pochoco_soc.genblk1.g_rom_ram_memory.u_ram.a_rdata_o[8];\u_pochoc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
slew | net222 | 11 | 3.571125 | 3.0 | -0.571125 | fanout222/Z:gf180mcu_fd_sc_mcu7t5v0__dlyb_1 | instruction/ROM/fetch | _7593_/A2 | \u_pochoco_soc.genblk1.g_rom_ram_memory.u_ram.a_addr_i[17];\u_pochoco_soc.genblk1.g_rom_ram_memory.u_ram.a_addr_i[18];\u_pochoco_soc.genblk1.g_rom_ram_memory.u_ram.a_addr_i[20];\u_pochoco_soc.genblk1.g_rom_ram_memory.u_ram.a_rdata_o[0];\u_pochoco_soc.genblk1.g_rom_ram_memory.u_ram.a_rdata_o[10];\u_pochoco_soc.genblk1.g_rom_ram_memory.u_ram.a_rdata_o[11];\u_pochoco_soc.genblk1.g_rom_ram_memory.u_ram.a_rdata_o[12];\u_pochoco_soc.genblk1.g_rom_ram_memory.u_ram.a_rdata_o[13];\u_pochoco_soc.genblk1.g_rom_ram_memory.u_ram.a_rdata_o[14];\u_pochoco_soc.genblk1.g_rom_ram_memory.u_ram.a_rdata_o[19];\u_pochoco_soc.genblk1.g_rom_ram_memory.u_ram.a_rdata_o[24];\u_pochoco_soc.genblk1.g_rom_ram_memory.u_ram.a_rdata_o[25];\u_pochoco_soc.genblk1.g_rom_ram_memory.u_ram.a_rdata_o[26];\u_pochoco_soc.genblk1.g_rom_ram_memory.u_ram.a_rdata_o[27];\u_pochoco_soc.genblk1.g_rom_ram_memory.u_ram.a_rdata_o[28];\u_pochoco_soc.genblk1.g_rom_ram_memory.u_ram.a_rdata_o[29];\u_pochoco_soc.genblk1.g_rom_ram_memory.u_ram.a_rdata_o[2];\u_pochoco_soc.genblk1.g_rom_ram_memory.u_ram.a_rdata_o[30];\u_pochoco_soc.genblk1.g_rom_ram_memory.u_ram.a_rdata_o[31];\u_pochoco_soc.genblk1.g_rom_ram_memory.u_ram.a_rdata_o[3];\u_pochoco_soc.genblk1.g_rom_ram_memory.u_ram.a_rdata_o[4];\u_pochoco_soc.genblk1.g_rom_ram_memory.u_ram.a_rdata_o[5];\u_pochoco_soc.genblk1.g_rom_ram_memory.u_ram.a_rdata_o[6];\u_pochoco_soc.genblk1.g_rom_ram_memory.u_ram.a_rdata_o[7];\u_pochoco_soc.genblk1.g_rom_ram_memory.u_ram.a_rdata_o[8];\u_pochoc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
slew | net166 | 11 | 3.552602 | 3.0 | -0.552602 | fanout166/Z:gf180mcu_fd_sc_mcu7t5v0__dlyb_1 | instruction/ROM/fetch | _8005_/A2 | \u_pochoco_soc.genblk1.g_rom_ram_memory.u_ram.a_addr_i[17];\u_pochoco_soc.genblk1.g_rom_ram_memory.u_ram.a_addr_i[18];\u_pochoco_soc.genblk1.g_rom_ram_memory.u_ram.a_addr_i[20];\u_pochoco_soc.genblk1.g_rom_ram_memory.u_ram.a_rdata_o[0];\u_pochoco_soc.genblk1.g_rom_ram_memory.u_ram.a_rdata_o[10];\u_pochoco_soc.genblk1.g_rom_ram_memory.u_ram.a_rdata_o[11];\u_pochoco_soc.genblk1.g_rom_ram_memory.u_ram.a_rdata_o[12];\u_pochoco_soc.genblk1.g_rom_ram_memory.u_ram.a_rdata_o[13];\u_pochoco_soc.genblk1.g_rom_ram_memory.u_ram.a_rdata_o[14];\u_pochoco_soc.genblk1.g_rom_ram_memory.u_ram.a_rdata_o[19];\u_pochoco_soc.genblk1.g_rom_ram_memory.u_ram.a_rdata_o[24];\u_pochoco_soc.genblk1.g_rom_ram_memory.u_ram.a_rdata_o[25];\u_pochoco_soc.genblk1.g_rom_ram_memory.u_ram.a_rdata_o[26];\u_pochoco_soc.genblk1.g_rom_ram_memory.u_ram.a_rdata_o[27];\u_pochoco_soc.genblk1.g_rom_ram_memory.u_ram.a_rdata_o[28];\u_pochoco_soc.genblk1.g_rom_ram_memory.u_ram.a_rdata_o[29];\u_pochoco_soc.genblk1.g_rom_ram_memory.u_ram.a_rdata_o[2];\u_pochoco_soc.genblk1.g_rom_ram_memory.u_ram.a_rdata_o[30];\u_pochoco_soc.genblk1.g_rom_ram_memory.u_ram.a_rdata_o[31];\u_pochoco_soc.genblk1.g_rom_ram_memory.u_ram.a_rdata_o[3];\u_pochoco_soc.genblk1.g_rom_ram_memory.u_ram.a_rdata_o[4];\u_pochoco_soc.genblk1.g_rom_ram_memory.u_ram.a_rdata_o[5];\u_pochoco_soc.genblk1.g_rom_ram_memory.u_ram.a_rdata_o[6];\u_pochoco_soc.genblk1.g_rom_ram_memory.u_ram.a_rdata_o[7];\u_pochoco_soc.genblk1.g_rom_ram_memory.u_ram.a_rdata_o[8];\u_pochoc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
slew | net554 | 11 | 3.551649 | 3.0 | -0.551649 | fanout554/Z:gf180mcu_fd_sc_mcu7t5v0__dlyb_1 | other-combinational | _6231_/A2 | \u_pochoco_soc.genblk1.g_rom_ram_memory.u_ram.a_addr_i[3]
slew | net556 | 11 | 3.549052 | 3.0 | -0.549052 | fanout556/Z:gf180mcu_fd_sc_mcu7t5v0__dlyb_1 | other-combinational | _5833_/A1 | \u_pochoco_soc.genblk1.g_rom_ram_memory.u_ram.a_addr_i[4]
slew | net256 | 11 | 3.541726 | 3.0 | -0.541726 | fanout256/Z:gf180mcu_fd_sc_mcu7t5v0__dlyb_1 | instruction/ROM/fetch | _7330_/A2 | \u_pochoco_soc.genblk1.g_rom_ram_memory.u_ram.a_addr_i[17];\u_pochoco_soc.genblk1.g_rom_ram_memory.u_ram.a_addr_i[18];\u_pochoco_soc.genblk1.g_rom_ram_memory.u_ram.a_addr_i[20];\u_pochoco_soc.genblk1.g_rom_ram_memory.u_ram.a_rdata_o[0];\u_pochoco_soc.genblk1.g_rom_ram_memory.u_ram.a_rdata_o[10];\u_pochoco_soc.genblk1.g_rom_ram_memory.u_ram.a_rdata_o[11];\u_pochoco_soc.genblk1.g_rom_ram_memory.u_ram.a_rdata_o[12];\u_pochoco_soc.genblk1.g_rom_ram_memory.u_ram.a_rdata_o[13];\u_pochoco_soc.genblk1.g_rom_ram_memory.u_ram.a_rdata_o[14];\u_pochoco_soc.genblk1.g_rom_ram_memory.u_ram.a_rdata_o[19];\u_pochoco_soc.genblk1.g_rom_ram_memory.u_ram.a_rdata_o[24];\u_pochoco_soc.genblk1.g_rom_ram_memory.u_ram.a_rdata_o[25];\u_pochoco_soc.genblk1.g_rom_ram_memory.u_ram.a_rdata_o[26];\u_pochoco_soc.genblk1.g_rom_ram_memory.u_ram.a_rdata_o[27];\u_pochoco_soc.genblk1.g_rom_ram_memory.u_ram.a_rdata_o[28];\u_pochoco_soc.genblk1.g_rom_ram_memory.u_ram.a_rdata_o[29];\u_pochoco_soc.genblk1.g_rom_ram_memory.u_ram.a_rdata_o[2];\u_pochoco_soc.genblk1.g_rom_ram_memory.u_ram.a_rdata_o[30];\u_pochoco_soc.genblk1.g_rom_ram_memory.u_ram.a_rdata_o[31];\u_pochoco_soc.genblk1.g_rom_ram_memory.u_ram.a_rdata_o[3];\u_pochoco_soc.genblk1.g_rom_ram_memory.u_ram.a_rdata_o[4];\u_pochoco_soc.genblk1.g_rom_ram_memory.u_ram.a_rdata_o[5];\u_pochoco_soc.genblk1.g_rom_ram_memory.u_ram.a_rdata_o[6];\u_pochoco_soc.genblk1.g_rom_ram_memory.u_ram.a_rdata_o[7];\u_pochoco_soc.genblk1.g_rom_ram_memory.u_ram.a_rdata_o[8];\u_pochoc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
slew | net529 | 11 | 3.53952 | 3.0 | -0.53952 | fanout529/Z:gf180mcu_fd_sc_mcu7t5v0__dlyb_1 | instruction/ROM/fetch | _5008_/A1 | \u_pochoco_soc.genblk1.g_rom_ram_memory.u_ram.a_rdata_o[21];\u_pochoco_soc.genblk1.g_rom_ram_memory.u_ram.a_rdata_o[22];\u_pochoco_soc.genblk1.g_rom_ram_memory.u_ram.a_rdata_o[23]
slew | net197 | 11 | 3.528206 | 3.0 | -0.528206 | fanout197/Z:gf180mcu_fd_sc_mcu7t5v0__dlyb_1 | instruction/ROM/fetch | _7809_/A2 | \u_pochoco_soc.genblk1.g_rom_ram_memory.u_ram.a_addr_i[17];\u_pochoco_soc.genblk1.g_rom_ram_memory.u_ram.a_addr_i[18];\u_pochoco_soc.genblk1.g_rom_ram_memory.u_ram.a_addr_i[20];\u_pochoco_soc.genblk1.g_rom_ram_memory.u_ram.a_rdata_o[0];\u_pochoco_soc.genblk1.g_rom_ram_memory.u_ram.a_rdata_o[10];\u_pochoco_soc.genblk1.g_rom_ram_memory.u_ram.a_rdata_o[11];\u_pochoco_soc.genblk1.g_rom_ram_memory.u_ram.a_rdata_o[12];\u_pochoco_soc.genblk1.g_rom_ram_memory.u_ram.a_rdata_o[13];\u_pochoco_soc.genblk1.g_rom_ram_memory.u_ram.a_rdata_o[14];\u_pochoco_soc.genblk1.g_rom_ram_memory.u_ram.a_rdata_o[19];\u_pochoco_soc.genblk1.g_rom_ram_memory.u_ram.a_rdata_o[24];\u_pochoco_soc.genblk1.g_rom_ram_memory.u_ram.a_rdata_o[25];\u_pochoco_soc.genblk1.g_rom_ram_memory.u_ram.a_rdata_o[26];\u_pochoco_soc.genblk1.g_rom_ram_memory.u_ram.a_rdata_o[27];\u_pochoco_soc.genblk1.g_rom_ram_memory.u_ram.a_rdata_o[28];\u_pochoco_soc.genblk1.g_rom_ram_memory.u_ram.a_rdata_o[29];\u_pochoco_soc.genblk1.g_rom_ram_memory.u_ram.a_rdata_o[2];\u_pochoco_soc.genblk1.g_rom_ram_memory.u_ram.a_rdata_o[30];\u_pochoco_soc.genblk1.g_rom_ram_memory.u_ram.a_rdata_o[31];\u_pochoco_soc.genblk1.g_rom_ram_memory.u_ram.a_rdata_o[3];\u_pochoco_soc.genblk1.g_rom_ram_memory.u_ram.a_rdata_o[4];\u_pochoco_soc.genblk1.g_rom_ram_memory.u_ram.a_rdata_o[5];\u_pochoco_soc.genblk1.g_rom_ram_memory.u_ram.a_rdata_o[6];\u_pochoco_soc.genblk1.g_rom_ram_memory.u_ram.a_rdata_o[7];\u_pochoco_soc.genblk1.g_rom_ram_memory.u_ram.a_rdata_o[8];\u_pochoc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
slew | net209 | 11 | 3.526601 | 3.0 | -0.526601 | fanout209/Z:gf180mcu_fd_sc_mcu7t5v0__dlyb_1 | instruction/ROM/fetch | fanout208/I | \u_pochoco_soc.genblk1.g_rom_ram_memory.u_ram.a_addr_i[17];\u_pochoco_soc.genblk1.g_rom_ram_memory.u_ram.a_addr_i[18];\u_pochoco_soc.genblk1.g_rom_ram_memory.u_ram.a_addr_i[20];\u_pochoco_soc.genblk1.g_rom_ram_memory.u_ram.a_rdata_o[0];\u_pochoco_soc.genblk1.g_rom_ram_memory.u_ram.a_rdata_o[10];\u_pochoco_soc.genblk1.g_rom_ram_memory.u_ram.a_rdata_o[11];\u_pochoco_soc.genblk1.g_rom_ram_memory.u_ram.a_rdata_o[12];\u_pochoco_soc.genblk1.g_rom_ram_memory.u_ram.a_rdata_o[13];\u_pochoco_soc.genblk1.g_rom_ram_memory.u_ram.a_rdata_o[14];\u_pochoco_soc.genblk1.g_rom_ram_memory.u_ram.a_rdata_o[19];\u_pochoco_soc.genblk1.g_rom_ram_memory.u_ram.a_rdata_o[24];\u_pochoco_soc.genblk1.g_rom_ram_memory.u_ram.a_rdata_o[25];\u_pochoco_soc.genblk1.g_rom_ram_memory.u_ram.a_rdata_o[26];\u_pochoco_soc.genblk1.g_rom_ram_memory.u_ram.a_rdata_o[27];\u_pochoco_soc.genblk1.g_rom_ram_memory.u_ram.a_rdata_o[28];\u_pochoco_soc.genblk1.g_rom_ram_memory.u_ram.a_rdata_o[29];\u_pochoco_soc.genblk1.g_rom_ram_memory.u_ram.a_rdata_o[2];\u_pochoco_soc.genblk1.g_rom_ram_memory.u_ram.a_rdata_o[30];\u_pochoco_soc.genblk1.g_rom_ram_memory.u_ram.a_rdata_o[31];\u_pochoco_soc.genblk1.g_rom_ram_memory.u_ram.a_rdata_o[3];\u_pochoco_soc.genblk1.g_rom_ram_memory.u_ram.a_rdata_o[4];\u_pochoco_soc.genblk1.g_rom_ram_memory.u_ram.a_rdata_o[5];\u_pochoco_soc.genblk1.g_rom_ram_memory.u_ram.a_rdata_o[6];\u_pochoco_soc.genblk1.g_rom_ram_memory.u_ram.a_rdata_o[7];\u_pochoco_soc.genblk1.g_rom_ram_memory.u_ram.a_rdata_o[8];\u_pochoc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
slew | net210 | 11 | 3.513507 | 3.0 | -0.513507 | fanout210/Z:gf180mcu_fd_sc_mcu7t5v0__dlyb_1 | instruction/ROM/fetch | _7673_/A2 | \u_pochoco_soc.genblk1.g_rom_ram_memory.u_ram.a_addr_i[17];\u_pochoco_soc.genblk1.g_rom_ram_memory.u_ram.a_addr_i[18];\u_pochoco_soc.genblk1.g_rom_ram_memory.u_ram.a_addr_i[20];\u_pochoco_soc.genblk1.g_rom_ram_memory.u_ram.a_rdata_o[0];\u_pochoco_soc.genblk1.g_rom_ram_memory.u_ram.a_rdata_o[10];\u_pochoco_soc.genblk1.g_rom_ram_memory.u_ram.a_rdata_o[11];\u_pochoco_soc.genblk1.g_rom_ram_memory.u_ram.a_rdata_o[12];\u_pochoco_soc.genblk1.g_rom_ram_memory.u_ram.a_rdata_o[13];\u_pochoco_soc.genblk1.g_rom_ram_memory.u_ram.a_rdata_o[14];\u_pochoco_soc.genblk1.g_rom_ram_memory.u_ram.a_rdata_o[19];\u_pochoco_soc.genblk1.g_rom_ram_memory.u_ram.a_rdata_o[24];\u_pochoco_soc.genblk1.g_rom_ram_memory.u_ram.a_rdata_o[25];\u_pochoco_soc.genblk1.g_rom_ram_memory.u_ram.a_rdata_o[26];\u_pochoco_soc.genblk1.g_rom_ram_memory.u_ram.a_rdata_o[27];\u_pochoco_soc.genblk1.g_rom_ram_memory.u_ram.a_rdata_o[28];\u_pochoco_soc.genblk1.g_rom_ram_memory.u_ram.a_rdata_o[29];\u_pochoco_soc.genblk1.g_rom_ram_memory.u_ram.a_rdata_o[2];\u_pochoco_soc.genblk1.g_rom_ram_memory.u_ram.a_rdata_o[30];\u_pochoco_soc.genblk1.g_rom_ram_memory.u_ram.a_rdata_o[31];\u_pochoco_soc.genblk1.g_rom_ram_memory.u_ram.a_rdata_o[3];\u_pochoco_soc.genblk1.g_rom_ram_memory.u_ram.a_rdata_o[4];\u_pochoco_soc.genblk1.g_rom_ram_memory.u_ram.a_rdata_o[5];\u_pochoco_soc.genblk1.g_rom_ram_memory.u_ram.a_rdata_o[6];\u_pochoco_soc.genblk1.g_rom_ram_memory.u_ram.a_rdata_o[7];\u_pochoco_soc.genblk1.g_rom_ram_memory.u_ram.a_rdata_o[8];\u_pochoc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
slew | net464 | 11 | 3.484365 | 3.0 | -0.484365 | fanout464/Z:gf180mcu_fd_sc_mcu7t5v0__dlyb_1 | instruction/ROM/fetch | _4591_/B1 | \u_pochoco_soc.genblk1.g_rom_ram_memory.u_ram.a_rdata_o[0];\u_pochoco_soc.genblk1.g_rom_ram_memory.u_ram.a_rdata_o[2];\u_pochoco_soc.genblk1.g_rom_ram_memory.u_ram.a_rdata_o[3];\u_pochoco_soc.genblk1.g_rom_ram_memory.u_ram.a_rdata_o[4];\u_pochoco_soc.genblk1.g_rom_ram_memory.u_ram.a_rdata_o[5];\u_pochoco_soc.genblk1.g_rom_ram_memory.u_ram.a_rdata_o[6]
slew | net163 | 11 | 3.482879 | 3.0 | -0.48288 | fanout163/Z:gf180mcu_fd_sc_mcu7t5v0__dlyb_1 | instruction/ROM/fetch | _8097_/A2 | \u_pochoco_soc.genblk1.g_rom_ram_memory.u_ram.a_addr_i[17];\u_pochoco_soc.genblk1.g_rom_ram_memory.u_ram.a_addr_i[18];\u_pochoco_soc.genblk1.g_rom_ram_memory.u_ram.a_addr_i[20];\u_pochoco_soc.genblk1.g_rom_ram_memory.u_ram.a_rdata_o[0];\u_pochoco_soc.genblk1.g_rom_ram_memory.u_ram.a_rdata_o[10];\u_pochoco_soc.genblk1.g_rom_ram_memory.u_ram.a_rdata_o[11];\u_pochoco_soc.genblk1.g_rom_ram_memory.u_ram.a_rdata_o[12];\u_pochoco_soc.genblk1.g_rom_ram_memory.u_ram.a_rdata_o[13];\u_pochoco_soc.genblk1.g_rom_ram_memory.u_ram.a_rdata_o[14];\u_pochoco_soc.genblk1.g_rom_ram_memory.u_ram.a_rdata_o[19];\u_pochoco_soc.genblk1.g_rom_ram_memory.u_ram.a_rdata_o[24];\u_pochoco_soc.genblk1.g_rom_ram_memory.u_ram.a_rdata_o[25];\u_pochoco_soc.genblk1.g_rom_ram_memory.u_ram.a_rdata_o[26];\u_pochoco_soc.genblk1.g_rom_ram_memory.u_ram.a_rdata_o[27];\u_pochoco_soc.genblk1.g_rom_ram_memory.u_ram.a_rdata_o[28];\u_pochoco_soc.genblk1.g_rom_ram_memory.u_ram.a_rdata_o[29];\u_pochoco_soc.genblk1.g_rom_ram_memory.u_ram.a_rdata_o[2];\u_pochoco_soc.genblk1.g_rom_ram_memory.u_ram.a_rdata_o[30];\u_pochoco_soc.genblk1.g_rom_ram_memory.u_ram.a_rdata_o[31];\u_pochoco_soc.genblk1.g_rom_ram_memory.u_ram.a_rdata_o[3];\u_pochoco_soc.genblk1.g_rom_ram_memory.u_ram.a_rdata_o[4];\u_pochoco_soc.genblk1.g_rom_ram_memory.u_ram.a_rdata_o[5];\u_pochoco_soc.genblk1.g_rom_ram_memory.u_ram.a_rdata_o[6];\u_pochoco_soc.genblk1.g_rom_ram_memory.u_ram.a_rdata_o[7];\u_pochoco_soc.genblk1.g_rom_ram_memory.u_ram.a_rdata_o[8];\u_pochoc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
slew | net552 | 11 | 3.478059 | 3.0 | -0.478059 | _5813_/S:gf180mcu_fd_sc_mcu7t5v0__mux2_2;fanout552/Z:gf180mcu_fd_sc_mcu7t5v0__dlyb_1 | instruction/ROM/fetch+data-memory+register-file | _5813_/S | \u_pochoco_soc.data_wdata[7];\u_pochoco_soc.genblk1.g_rom_ram_memory.u_ram.a_addr_i[2];\u_pochoco_soc.genblk1.g_rom_ram_memory.u_ram.a_rdata_o[0];\u_pochoco_soc.genblk1.g_rom_ram_memory.u_ram.a_rdata_o[11];\u_pochoco_soc.genblk1.g_rom_ram_memory.u_ram.a_rdata_o[12];\u_pochoco_soc.genblk1.g_rom_ram_memory.u_ram.a_rdata_o[13];\u_pochoco_soc.genblk1.g_rom_ram_memory.u_ram.a_rdata_o[14];\u_pochoco_soc.genblk1.g_rom_ram_memory.u_ram.a_rdata_o[15];\u_pochoco_soc.genblk1.g_rom_ram_memory.u_ram.a_rdata_o[18];\u_pochoco_soc.genblk1.g_rom_ram_memory.u_ram.a_rdata_o[19];\u_pochoco_soc.genblk1.g_rom_ram_memory.u_ram.a_rdata_o[22];\u_pochoco_soc.genblk1.g_rom_ram_memory.u_ram.a_rdata_o[23];\u_pochoco_soc.genblk1.g_rom_ram_memory.u_ram.a_rdata_o[24];\u_pochoco_soc.genblk1.g_rom_ram_memory.u_ram.a_rdata_o[25];\u_pochoco_soc.genblk1.g_rom_ram_memory.u_ram.a_rdata_o[26];\u_pochoco_soc.genblk1.g_rom_ram_memory.u_ram.a_rdata_o[27];\u_pochoco_soc.genblk1.g_rom_ram_memory.u_ram.a_rdata_o[28];\u_pochoco_soc.genblk1.g_rom_ram_memory.u_ram.a_rdata_o[29];\u_pochoco_soc.genblk1.g_rom_ram_memory.u_ram.a_rdata_o[2];\u_pochoco_soc.genblk1.g_rom_ram_memory.u_ram.a_rdata_o[30];\u_pochoco_soc.genblk1.g_rom_ram_memory.u_ram.a_rdata_o[31];\u_pochoco_soc.genblk1.g_rom_ram_memory.u_ram.a_rdata_o[3];\u_pochoco_soc.genblk1.g_rom_ram_memory.u_ram.a_rdata_o[4];\u_pochoco_soc.genblk1.g_rom_ram_memory.u_ram.a_rdata_o[5];\u_pochoco_soc.genblk1.g_rom_ram_memory.u_ram.a_rdata_o[6];\u_pochoco_soc.u_core.g_asic_regfile.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
slew | net739 | 11 | 3.475393 | 3.0 | -0.475393 | fanout739/Z:gf180mcu_fd_sc_mcu7t5v0__dlyb_1 | reset | _8479_/RN | rst_ni
slew | net239 | 11 | 3.444392 | 3.0 | -0.444392 | fanout239/Z:gf180mcu_fd_sc_mcu7t5v0__dlyb_1 | instruction/ROM/fetch | _7492_/A2 | \u_pochoco_soc.genblk1.g_rom_ram_memory.u_ram.a_addr_i[17];\u_pochoco_soc.genblk1.g_rom_ram_memory.u_ram.a_addr_i[18];\u_pochoco_soc.genblk1.g_rom_ram_memory.u_ram.a_addr_i[20];\u_pochoco_soc.genblk1.g_rom_ram_memory.u_ram.a_rdata_o[0];\u_pochoco_soc.genblk1.g_rom_ram_memory.u_ram.a_rdata_o[10];\u_pochoco_soc.genblk1.g_rom_ram_memory.u_ram.a_rdata_o[11];\u_pochoco_soc.genblk1.g_rom_ram_memory.u_ram.a_rdata_o[12];\u_pochoco_soc.genblk1.g_rom_ram_memory.u_ram.a_rdata_o[13];\u_pochoco_soc.genblk1.g_rom_ram_memory.u_ram.a_rdata_o[14];\u_pochoco_soc.genblk1.g_rom_ram_memory.u_ram.a_rdata_o[19];\u_pochoco_soc.genblk1.g_rom_ram_memory.u_ram.a_rdata_o[24];\u_pochoco_soc.genblk1.g_rom_ram_memory.u_ram.a_rdata_o[25];\u_pochoco_soc.genblk1.g_rom_ram_memory.u_ram.a_rdata_o[26];\u_pochoco_soc.genblk1.g_rom_ram_memory.u_ram.a_rdata_o[27];\u_pochoco_soc.genblk1.g_rom_ram_memory.u_ram.a_rdata_o[28];\u_pochoco_soc.genblk1.g_rom_ram_memory.u_ram.a_rdata_o[29];\u_pochoco_soc.genblk1.g_rom_ram_memory.u_ram.a_rdata_o[2];\u_pochoco_soc.genblk1.g_rom_ram_memory.u_ram.a_rdata_o[30];\u_pochoco_soc.genblk1.g_rom_ram_memory.u_ram.a_rdata_o[31];\u_pochoco_soc.genblk1.g_rom_ram_memory.u_ram.a_rdata_o[3];\u_pochoco_soc.genblk1.g_rom_ram_memory.u_ram.a_rdata_o[4];\u_pochoco_soc.genblk1.g_rom_ram_memory.u_ram.a_rdata_o[5];\u_pochoco_soc.genblk1.g_rom_ram_memory.u_ram.a_rdata_o[6];\u_pochoco_soc.genblk1.g_rom_ram_memory.u_ram.a_rdata_o[7];\u_pochoco_soc.genblk1.g_rom_ram_memory.u_ram.a_rdata_o[8];\u_pochoc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
slew | net328 | 11 | 3.424216 | 3.0 | -0.424216 | fanout328/Z:gf180mcu_fd_sc_mcu7t5v0__dlyb_1 | instruction/ROM/fetch | _4815_/A1 | \u_pochoco_soc.genblk1.g_rom_ram_memory.u_ram.a_rdata_o[0];\u_pochoco_soc.genblk1.g_rom_ram_memory.u_ram.a_rdata_o[12];\u_pochoco_soc.genblk1.g_rom_ram_memory.u_ram.a_rdata_o[13];\u_pochoco_soc.genblk1.g_rom_ram_memory.u_ram.a_rdata_o[14];\u_pochoco_soc.genblk1.g_rom_ram_memory.u_ram.a_rdata_o[2];\u_pochoco_soc.genblk1.g_rom_ram_memory.u_ram.a_rdata_o[30];\u_pochoco_soc.genblk1.g_rom_ram_memory.u_ram.a_rdata_o[3];\u_pochoco_soc.genblk1.g_rom_ram_memory.u_ram.a_rdata_o[4];\u_pochoco_soc.genblk1.g_rom_ram_memory.u_ram.a_rdata_o[5];\u_pochoco_soc.genblk1.g_rom_ram_memory.u_ram.a_rdata_o[6]
slew | net159 | 11 | 3.415728 | 3.0 | -0.415728 | fanout159/Z:gf180mcu_fd_sc_mcu7t5v0__dlyb_1 | instruction/ROM/fetch | fanout158/I | \u_pochoco_soc.genblk1.g_rom_ram_memory.u_ram.a_addr_i[17];\u_pochoco_soc.genblk1.g_rom_ram_memory.u_ram.a_addr_i[18];\u_pochoco_soc.genblk1.g_rom_ram_memory.u_ram.a_addr_i[20];\u_pochoco_soc.genblk1.g_rom_ram_memory.u_ram.a_rdata_o[0];\u_pochoco_soc.genblk1.g_rom_ram_memory.u_ram.a_rdata_o[10];\u_pochoco_soc.genblk1.g_rom_ram_memory.u_ram.a_rdata_o[11];\u_pochoco_soc.genblk1.g_rom_ram_memory.u_ram.a_rdata_o[12];\u_pochoco_soc.genblk1.g_rom_ram_memory.u_ram.a_rdata_o[13];\u_pochoco_soc.genblk1.g_rom_ram_memory.u_ram.a_rdata_o[14];\u_pochoco_soc.genblk1.g_rom_ram_memory.u_ram.a_rdata_o[19];\u_pochoco_soc.genblk1.g_rom_ram_memory.u_ram.a_rdata_o[24];\u_pochoco_soc.genblk1.g_rom_ram_memory.u_ram.a_rdata_o[25];\u_pochoco_soc.genblk1.g_rom_ram_memory.u_ram.a_rdata_o[26];\u_pochoco_soc.genblk1.g_rom_ram_memory.u_ram.a_rdata_o[27];\u_pochoco_soc.genblk1.g_rom_ram_memory.u_ram.a_rdata_o[28];\u_pochoco_soc.genblk1.g_rom_ram_memory.u_ram.a_rdata_o[29];\u_pochoco_soc.genblk1.g_rom_ram_memory.u_ram.a_rdata_o[2];\u_pochoco_soc.genblk1.g_rom_ram_memory.u_ram.a_rdata_o[30];\u_pochoco_soc.genblk1.g_rom_ram_memory.u_ram.a_rdata_o[31];\u_pochoco_soc.genblk1.g_rom_ram_memory.u_ram.a_rdata_o[3];\u_pochoco_soc.genblk1.g_rom_ram_memory.u_ram.a_rdata_o[4];\u_pochoco_soc.genblk1.g_rom_ram_memory.u_ram.a_rdata_o[5];\u_pochoco_soc.genblk1.g_rom_ram_memory.u_ram.a_rdata_o[6];\u_pochoco_soc.genblk1.g_rom_ram_memory.u_ram.a_rdata_o[7];\u_pochoco_soc.genblk1.g_rom_ram_memory.u_ram.a_rdata_o[8];\u_pochoc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
slew | net527 | 11 | 3.394612 | 3.0 | -0.394612 | fanout527/Z:gf180mcu_fd_sc_mcu7t5v0__dlyb_1 | instruction/ROM/fetch | _5108_/A1 | \u_pochoco_soc.genblk1.g_rom_ram_memory.u_ram.a_rdata_o[21];\u_pochoco_soc.genblk1.g_rom_ram_memory.u_ram.a_rdata_o[22];\u_pochoco_soc.genblk1.g_rom_ram_memory.u_ram.a_rdata_o[23]
slew | net162 | 11 | 3.377087 | 3.0 | -0.377087 | fanout162/Z:gf180mcu_fd_sc_mcu7t5v0__dlyb_1 | instruction/ROM/fetch | _8079_/A2 | \u_pochoco_soc.genblk1.g_rom_ram_memory.u_ram.a_addr_i[17];\u_pochoco_soc.genblk1.g_rom_ram_memory.u_ram.a_addr_i[18];\u_pochoco_soc.genblk1.g_rom_ram_memory.u_ram.a_addr_i[20];\u_pochoco_soc.genblk1.g_rom_ram_memory.u_ram.a_rdata_o[0];\u_pochoco_soc.genblk1.g_rom_ram_memory.u_ram.a_rdata_o[10];\u_pochoco_soc.genblk1.g_rom_ram_memory.u_ram.a_rdata_o[11];\u_pochoco_soc.genblk1.g_rom_ram_memory.u_ram.a_rdata_o[12];\u_pochoco_soc.genblk1.g_rom_ram_memory.u_ram.a_rdata_o[13];\u_pochoco_soc.genblk1.g_rom_ram_memory.u_ram.a_rdata_o[14];\u_pochoco_soc.genblk1.g_rom_ram_memory.u_ram.a_rdata_o[19];\u_pochoco_soc.genblk1.g_rom_ram_memory.u_ram.a_rdata_o[24];\u_pochoco_soc.genblk1.g_rom_ram_memory.u_ram.a_rdata_o[25];\u_pochoco_soc.genblk1.g_rom_ram_memory.u_ram.a_rdata_o[26];\u_pochoco_soc.genblk1.g_rom_ram_memory.u_ram.a_rdata_o[27];\u_pochoco_soc.genblk1.g_rom_ram_memory.u_ram.a_rdata_o[28];\u_pochoco_soc.genblk1.g_rom_ram_memory.u_ram.a_rdata_o[29];\u_pochoco_soc.genblk1.g_rom_ram_memory.u_ram.a_rdata_o[2];\u_pochoco_soc.genblk1.g_rom_ram_memory.u_ram.a_rdata_o[30];\u_pochoco_soc.genblk1.g_rom_ram_memory.u_ram.a_rdata_o[31];\u_pochoco_soc.genblk1.g_rom_ram_memory.u_ram.a_rdata_o[3];\u_pochoco_soc.genblk1.g_rom_ram_memory.u_ram.a_rdata_o[4];\u_pochoco_soc.genblk1.g_rom_ram_memory.u_ram.a_rdata_o[5];\u_pochoco_soc.genblk1.g_rom_ram_memory.u_ram.a_rdata_o[6];\u_pochoco_soc.genblk1.g_rom_ram_memory.u_ram.a_rdata_o[7];\u_pochoco_soc.genblk1.g_rom_ram_memory.u_ram.a_rdata_o[8];\u_pochoc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
slew | net298 | 11 | 3.375689 | 3.0 | -0.375689 | _8138_/S:gf180mcu_fd_sc_mcu7t5v0__mux2_2;_8139_/S:gf180mcu_fd_sc_mcu7t5v0__mux2_2;_8140_/S:gf180mcu_fd_sc_mcu7t5v0__mux2_2;_8143_/S:gf180mcu_fd_sc_mcu7t5v0__mux2_2;_8144_/S:gf180mcu_fd_sc_mcu7t5v0__mux2_2;_8145_/S:gf180mcu_fd_sc_mcu7t5v0__mux2_2;_8149_/S:gf180mcu_fd_sc_mcu7t5v0__mux2_2;fanout298/Z:gf180mcu_fd_sc_mcu7t5v0__dlyb_1 | instruction/ROM/fetch | _8138_/S | \u_pochoco_soc.genblk1.g_rom_ram_memory.u_ram.a_addr_i[11];\u_pochoco_soc.genblk1.g_rom_ram_memory.u_ram.a_addr_i[14];\u_pochoco_soc.genblk1.g_rom_ram_memory.u_ram.a_addr_i[15];\u_pochoco_soc.genblk1.g_rom_ram_memory.u_ram.a_addr_i[18];\u_pochoco_soc.genblk1.g_rom_ram_memory.u_ram.a_addr_i[22];\u_pochoco_soc.genblk1.g_rom_ram_memory.u_ram.a_addr_i[23];\u_pochoco_soc.genblk1.g_rom_ram_memory.u_ram.a_addr_i[24];\u_pochoco_soc.genblk1.g_rom_ram_memory.u_ram.a_addr_i[26];\u_pochoco_soc.genblk1.g_rom_ram_memory.u_ram.a_addr_i[27];\u_pochoco_soc.genblk1.g_rom_ram_memory.u_ram.a_addr_i[28];\u_pochoco_soc.genblk1.g_rom_ram_memory.u_ram.a_addr_i[29];\u_pochoco_soc.genblk1.g_rom_ram_memory.u_ram.a_addr_i[31];\u_pochoco_soc.u_core.instr_valid_id;\u_pochoco_soc.u_core.lsu_busy;\u_pochoco_soc.u_core.pc_id[11];\u_pochoco_soc.u_core.pc_id[14];\u_pochoco_soc.u_core.pc_id[15];\u_pochoco_soc.u_core.pc_id[18];\u_pochoco_soc.u_core.pc_id[22];\u_pochoco_soc.u_core.pc_id[23];\u_pochoco_soc.u_core.pc_id[24];\u_pochoco_soc.u_core.pc_id[26];\u_pochoco_soc.u_core.pc_id[27];\u_pochoco_soc.u_core.pc_id[28];\u_pochoco_soc.u_core.pc_id[29];\u_pochoco_soc.u_core.pc_id[31];\u_pochoco_soc.u_core.rf_ready
slew | net308 | 11 | 3.375463 | 3.0 | -0.375463 | _6870_/S:gf180mcu_fd_sc_mcu7t5v0__mux2_2;_6884_/S:gf180mcu_fd_sc_mcu7t5v0__mux2_2;_6897_/S:gf180mcu_fd_sc_mcu7t5v0__mux2_2;_6915_/S:gf180mcu_fd_sc_mcu7t5v0__mux2_2;_6927_/S:gf180mcu_fd_sc_mcu7t5v0__mux2_2;_6959_/S:gf180mcu_fd_sc_mcu7t5v0__mux2_2;fanout308/Z:gf180mcu_fd_sc_mcu7t5v0__dlyb_1 | instruction/ROM/fetch+data-memory+register-file+peripheral | _6870_/S | \u_pochoco_soc.data_wdata[0];\u_pochoco_soc.data_wdata[1];\u_pochoco_soc.genblk1.g_rom_ram_memory.u_ram.a_rdata_o[0];\u_pochoco_soc.genblk1.g_rom_ram_memory.u_ram.a_rdata_o[12];\u_pochoco_soc.genblk1.g_rom_ram_memory.u_ram.a_rdata_o[13];\u_pochoco_soc.genblk1.g_rom_ram_memory.u_ram.a_rdata_o[14];\u_pochoco_soc.genblk1.g_rom_ram_memory.u_ram.a_rdata_o[20];\u_pochoco_soc.genblk1.g_rom_ram_memory.u_ram.a_rdata_o[21];\u_pochoco_soc.genblk1.g_rom_ram_memory.u_ram.a_rdata_o[2];\u_pochoco_soc.genblk1.g_rom_ram_memory.u_ram.a_rdata_o[30];\u_pochoco_soc.genblk1.g_rom_ram_memory.u_ram.a_rdata_o[3];\u_pochoco_soc.genblk1.g_rom_ram_memory.u_ram.a_rdata_o[4];\u_pochoco_soc.genblk1.g_rom_ram_memory.u_ram.a_rdata_o[5];\u_pochoco_soc.genblk1.g_rom_ram_memory.u_ram.a_rdata_o[6];\u_pochoco_soc.genblk1.g_rom_ram_memory.u_ram.a_rdata_o[7];\u_pochoco_soc.genblk1.g_rom_ram_memory.u_ram.a_rdata_o[8];\u_pochoco_soc.genblk1.g_rom_ram_memory.u_ram.b_rdata_o[10];\u_pochoco_soc.genblk1.g_rom_ram_memory.u_ram.b_rdata_o[11];\u_pochoco_soc.genblk1.g_rom_ram_memory.u_ram.b_rdata_o[12];\u_pochoco_soc.genblk1.g_rom_ram_memory.u_ram.b_rdata_o[14];\u_pochoco_soc.genblk1.g_rom_ram_memory.u_ram.b_rdata_o[24];\u_pochoco_soc.genblk1.g_rom_ram_memory.u_ram.b_rdata_o[25];\u_pochoco_soc.genblk1.g_rom_ram_memory.u_ram.b_rdata_o[26];\u_pochoco_soc.genblk1.g_rom_ram_memory.u_ram.b_rdata_o[27];\u_pochoco_soc.genblk1.g_rom_ram_memory.u_ram.b_rdata_o[28];\u_pochoco_soc.genblk1.g_rom_ram_memory.u_ram.b_rdata_o[30];\u_pocho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
slew | net682 | 11 | 3.36399 | 3.0 | -0.36399 | fanout682/Z:gf180mcu_fd_sc_mcu7t5v0__dlyb_1 | reset | _8586_/RN | rst_ni
slew | net509 | 11 | 3.354494 | 3.0 | -0.354494 | fanout509/Z:gf180mcu_fd_sc_mcu7t5v0__dlyb_1 | instruction/ROM/fetch | _5507_/A1 | \u_pochoco_soc.genblk1.g_rom_ram_memory.u_ram.a_rdata_o[16];\u_pochoco_soc.genblk1.g_rom_ram_memory.u_ram.a_rdata_o[17];\u_pochoco_soc.genblk1.g_rom_ram_memory.u_ram.a_rdata_o[18]
slew | net488 | 11 | 3.344161 | 3.0 | -0.344161 | fanout488/Z:gf180mcu_fd_sc_mcu7t5v0__dlyb_1 | instruction/ROM/fetch+register-file | _6276_/A1 | \u_pochoco_soc.genblk1.g_rom_ram_memory.u_ram.a_addr_i[2];\u_pochoco_soc.genblk1.g_rom_ram_memory.u_ram.a_addr_i[4];\u_pochoco_soc.genblk1.g_rom_ram_memory.u_ram.a_rdata_o[0];\u_pochoco_soc.genblk1.g_rom_ram_memory.u_ram.a_rdata_o[11];\u_pochoco_soc.genblk1.g_rom_ram_memory.u_ram.a_rdata_o[12];\u_pochoco_soc.genblk1.g_rom_ram_memory.u_ram.a_rdata_o[13];\u_pochoco_soc.genblk1.g_rom_ram_memory.u_ram.a_rdata_o[14];\u_pochoco_soc.genblk1.g_rom_ram_memory.u_ram.a_rdata_o[19];\u_pochoco_soc.genblk1.g_rom_ram_memory.u_ram.a_rdata_o[24];\u_pochoco_soc.genblk1.g_rom_ram_memory.u_ram.a_rdata_o[25];\u_pochoco_soc.genblk1.g_rom_ram_memory.u_ram.a_rdata_o[26];\u_pochoco_soc.genblk1.g_rom_ram_memory.u_ram.a_rdata_o[27];\u_pochoco_soc.genblk1.g_rom_ram_memory.u_ram.a_rdata_o[28];\u_pochoco_soc.genblk1.g_rom_ram_memory.u_ram.a_rdata_o[29];\u_pochoco_soc.genblk1.g_rom_ram_memory.u_ram.a_rdata_o[2];\u_pochoco_soc.genblk1.g_rom_ram_memory.u_ram.a_rdata_o[30];\u_pochoco_soc.genblk1.g_rom_ram_memory.u_ram.a_rdata_o[31];\u_pochoco_soc.genblk1.g_rom_ram_memory.u_ram.a_rdata_o[3];\u_pochoco_soc.genblk1.g_rom_ram_memory.u_ram.a_rdata_o[4];\u_pochoco_soc.genblk1.g_rom_ram_memory.u_ram.a_rdata_o[5];\u_pochoco_soc.genblk1.g_rom_ram_memory.u_ram.a_rdata_o[6];\u_pochoco_soc.u_core.g_asic_regfile.u_rf.rdata_a_o[11];\u_pochoco_soc.u_core.g_asic_regfile.u_rf.rdata_a_o[12];\u_pochoco_soc.u_core.g_asic_regfile.u_rf.rdata_a_o[13];\u_pochoco_soc.u_core.g_asic_regfile.u_rf.rdata_a_o[14];\u_pochoco_soc.u_core.g_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
slew | net581 | 11 | 3.341923 | 3.0 | -0.341923 | fanout581/Z:gf180mcu_fd_sc_mcu7t5v0__dlyb_1 | instruction/ROM/fetch | _6994_/A1 | \u_pochoco_soc.genblk1.g_rom_ram_memory.u_ram.a_rdata_o[12]
slew | net200 | 11 | 3.33884 | 3.0 | -0.33884 | fanout200/Z:gf180mcu_fd_sc_mcu7t5v0__dlyb_1 | instruction/ROM/fetch | _7732_/A2 | \u_pochoco_soc.genblk1.g_rom_ram_memory.u_ram.a_addr_i[17];\u_pochoco_soc.genblk1.g_rom_ram_memory.u_ram.a_addr_i[18];\u_pochoco_soc.genblk1.g_rom_ram_memory.u_ram.a_addr_i[20];\u_pochoco_soc.genblk1.g_rom_ram_memory.u_ram.a_rdata_o[0];\u_pochoco_soc.genblk1.g_rom_ram_memory.u_ram.a_rdata_o[10];\u_pochoco_soc.genblk1.g_rom_ram_memory.u_ram.a_rdata_o[11];\u_pochoco_soc.genblk1.g_rom_ram_memory.u_ram.a_rdata_o[12];\u_pochoco_soc.genblk1.g_rom_ram_memory.u_ram.a_rdata_o[13];\u_pochoco_soc.genblk1.g_rom_ram_memory.u_ram.a_rdata_o[14];\u_pochoco_soc.genblk1.g_rom_ram_memory.u_ram.a_rdata_o[19];\u_pochoco_soc.genblk1.g_rom_ram_memory.u_ram.a_rdata_o[24];\u_pochoco_soc.genblk1.g_rom_ram_memory.u_ram.a_rdata_o[25];\u_pochoco_soc.genblk1.g_rom_ram_memory.u_ram.a_rdata_o[26];\u_pochoco_soc.genblk1.g_rom_ram_memory.u_ram.a_rdata_o[27];\u_pochoco_soc.genblk1.g_rom_ram_memory.u_ram.a_rdata_o[28];\u_pochoco_soc.genblk1.g_rom_ram_memory.u_ram.a_rdata_o[29];\u_pochoco_soc.genblk1.g_rom_ram_memory.u_ram.a_rdata_o[2];\u_pochoco_soc.genblk1.g_rom_ram_memory.u_ram.a_rdata_o[30];\u_pochoco_soc.genblk1.g_rom_ram_memory.u_ram.a_rdata_o[31];\u_pochoco_soc.genblk1.g_rom_ram_memory.u_ram.a_rdata_o[3];\u_pochoco_soc.genblk1.g_rom_ram_memory.u_ram.a_rdata_o[4];\u_pochoco_soc.genblk1.g_rom_ram_memory.u_ram.a_rdata_o[5];\u_pochoco_soc.genblk1.g_rom_ram_memory.u_ram.a_rdata_o[6];\u_pochoco_soc.genblk1.g_rom_ram_memory.u_ram.a_rdata_o[7];\u_pochoco_soc.genblk1.g_rom_ram_memory.u_ram.a_rdata_o[8];\u_pochoc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
slew | net269 | 11 | 3.325312 | 3.0 | -0.325312 | fanout269/Z:gf180mcu_fd_sc_mcu7t5v0__dlyb_1 | instruction/ROM/fetch | _7191_/A2 | \u_pochoco_soc.genblk1.g_rom_ram_memory.u_ram.a_addr_i[17];\u_pochoco_soc.genblk1.g_rom_ram_memory.u_ram.a_addr_i[18];\u_pochoco_soc.genblk1.g_rom_ram_memory.u_ram.a_addr_i[20];\u_pochoco_soc.genblk1.g_rom_ram_memory.u_ram.a_rdata_o[0];\u_pochoco_soc.genblk1.g_rom_ram_memory.u_ram.a_rdata_o[10];\u_pochoco_soc.genblk1.g_rom_ram_memory.u_ram.a_rdata_o[11];\u_pochoco_soc.genblk1.g_rom_ram_memory.u_ram.a_rdata_o[12];\u_pochoco_soc.genblk1.g_rom_ram_memory.u_ram.a_rdata_o[13];\u_pochoco_soc.genblk1.g_rom_ram_memory.u_ram.a_rdata_o[14];\u_pochoco_soc.genblk1.g_rom_ram_memory.u_ram.a_rdata_o[19];\u_pochoco_soc.genblk1.g_rom_ram_memory.u_ram.a_rdata_o[24];\u_pochoco_soc.genblk1.g_rom_ram_memory.u_ram.a_rdata_o[25];\u_pochoco_soc.genblk1.g_rom_ram_memory.u_ram.a_rdata_o[26];\u_pochoco_soc.genblk1.g_rom_ram_memory.u_ram.a_rdata_o[27];\u_pochoco_soc.genblk1.g_rom_ram_memory.u_ram.a_rdata_o[28];\u_pochoco_soc.genblk1.g_rom_ram_memory.u_ram.a_rdata_o[29];\u_pochoco_soc.genblk1.g_rom_ram_memory.u_ram.a_rdata_o[2];\u_pochoco_soc.genblk1.g_rom_ram_memory.u_ram.a_rdata_o[30];\u_pochoco_soc.genblk1.g_rom_ram_memory.u_ram.a_rdata_o[31];\u_pochoco_soc.genblk1.g_rom_ram_memory.u_ram.a_rdata_o[3];\u_pochoco_soc.genblk1.g_rom_ram_memory.u_ram.a_rdata_o[4];\u_pochoco_soc.genblk1.g_rom_ram_memory.u_ram.a_rdata_o[5];\u_pochoco_soc.genblk1.g_rom_ram_memory.u_ram.a_rdata_o[6];\u_pochoco_soc.genblk1.g_rom_ram_memory.u_ram.a_rdata_o[7];\u_pochoco_soc.genblk1.g_rom_ram_memory.u_ram.a_rdata_o[8];\u_pochoc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
slew | net260 | 11 | 3.320094 | 3.0 | -0.320094 | fanout260/Z:gf180mcu_fd_sc_mcu7t5v0__dlyb_1 | instruction/ROM/fetch | _7286_/A2 | \u_pochoco_soc.genblk1.g_rom_ram_memory.u_ram.a_addr_i[17];\u_pochoco_soc.genblk1.g_rom_ram_memory.u_ram.a_addr_i[18];\u_pochoco_soc.genblk1.g_rom_ram_memory.u_ram.a_addr_i[20];\u_pochoco_soc.genblk1.g_rom_ram_memory.u_ram.a_rdata_o[0];\u_pochoco_soc.genblk1.g_rom_ram_memory.u_ram.a_rdata_o[10];\u_pochoco_soc.genblk1.g_rom_ram_memory.u_ram.a_rdata_o[11];\u_pochoco_soc.genblk1.g_rom_ram_memory.u_ram.a_rdata_o[12];\u_pochoco_soc.genblk1.g_rom_ram_memory.u_ram.a_rdata_o[13];\u_pochoco_soc.genblk1.g_rom_ram_memory.u_ram.a_rdata_o[14];\u_pochoco_soc.genblk1.g_rom_ram_memory.u_ram.a_rdata_o[19];\u_pochoco_soc.genblk1.g_rom_ram_memory.u_ram.a_rdata_o[24];\u_pochoco_soc.genblk1.g_rom_ram_memory.u_ram.a_rdata_o[25];\u_pochoco_soc.genblk1.g_rom_ram_memory.u_ram.a_rdata_o[26];\u_pochoco_soc.genblk1.g_rom_ram_memory.u_ram.a_rdata_o[27];\u_pochoco_soc.genblk1.g_rom_ram_memory.u_ram.a_rdata_o[28];\u_pochoco_soc.genblk1.g_rom_ram_memory.u_ram.a_rdata_o[29];\u_pochoco_soc.genblk1.g_rom_ram_memory.u_ram.a_rdata_o[2];\u_pochoco_soc.genblk1.g_rom_ram_memory.u_ram.a_rdata_o[30];\u_pochoco_soc.genblk1.g_rom_ram_memory.u_ram.a_rdata_o[31];\u_pochoco_soc.genblk1.g_rom_ram_memory.u_ram.a_rdata_o[3];\u_pochoco_soc.genblk1.g_rom_ram_memory.u_ram.a_rdata_o[4];\u_pochoco_soc.genblk1.g_rom_ram_memory.u_ram.a_rdata_o[5];\u_pochoco_soc.genblk1.g_rom_ram_memory.u_ram.a_rdata_o[6];\u_pochoco_soc.genblk1.g_rom_ram_memory.u_ram.a_rdata_o[7];\u_pochoco_soc.genblk1.g_rom_ram_memory.u_ram.a_rdata_o[8];\u_pochoc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
slew | net188 | 11 | 3.318686 | 3.0 | -0.318686 | fanout188/Z:gf180mcu_fd_sc_mcu7t5v0__dlyb_1 | instruction/ROM/fetch | _7901_/A2 | \u_pochoco_soc.genblk1.g_rom_ram_memory.u_ram.a_addr_i[17];\u_pochoco_soc.genblk1.g_rom_ram_memory.u_ram.a_addr_i[18];\u_pochoco_soc.genblk1.g_rom_ram_memory.u_ram.a_addr_i[20];\u_pochoco_soc.genblk1.g_rom_ram_memory.u_ram.a_rdata_o[0];\u_pochoco_soc.genblk1.g_rom_ram_memory.u_ram.a_rdata_o[10];\u_pochoco_soc.genblk1.g_rom_ram_memory.u_ram.a_rdata_o[11];\u_pochoco_soc.genblk1.g_rom_ram_memory.u_ram.a_rdata_o[12];\u_pochoco_soc.genblk1.g_rom_ram_memory.u_ram.a_rdata_o[13];\u_pochoco_soc.genblk1.g_rom_ram_memory.u_ram.a_rdata_o[14];\u_pochoco_soc.genblk1.g_rom_ram_memory.u_ram.a_rdata_o[19];\u_pochoco_soc.genblk1.g_rom_ram_memory.u_ram.a_rdata_o[24];\u_pochoco_soc.genblk1.g_rom_ram_memory.u_ram.a_rdata_o[25];\u_pochoco_soc.genblk1.g_rom_ram_memory.u_ram.a_rdata_o[26];\u_pochoco_soc.genblk1.g_rom_ram_memory.u_ram.a_rdata_o[27];\u_pochoco_soc.genblk1.g_rom_ram_memory.u_ram.a_rdata_o[28];\u_pochoco_soc.genblk1.g_rom_ram_memory.u_ram.a_rdata_o[29];\u_pochoco_soc.genblk1.g_rom_ram_memory.u_ram.a_rdata_o[2];\u_pochoco_soc.genblk1.g_rom_ram_memory.u_ram.a_rdata_o[30];\u_pochoco_soc.genblk1.g_rom_ram_memory.u_ram.a_rdata_o[31];\u_pochoco_soc.genblk1.g_rom_ram_memory.u_ram.a_rdata_o[3];\u_pochoco_soc.genblk1.g_rom_ram_memory.u_ram.a_rdata_o[4];\u_pochoco_soc.genblk1.g_rom_ram_memory.u_ram.a_rdata_o[5];\u_pochoco_soc.genblk1.g_rom_ram_memory.u_ram.a_rdata_o[6];\u_pochoco_soc.genblk1.g_rom_ram_memory.u_ram.a_rdata_o[7];\u_pochoco_soc.genblk1.g_rom_ram_memory.u_ram.a_rdata_o[8];\u_pochoc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
slew | net176 | 11 | 3.303328 | 3.0 | -0.303328 | fanout176/Z:gf180mcu_fd_sc_mcu7t5v0__dlyb_1 | instruction/ROM/fetch | _7926_/A2 | \u_pochoco_soc.genblk1.g_rom_ram_memory.u_ram.a_addr_i[17];\u_pochoco_soc.genblk1.g_rom_ram_memory.u_ram.a_addr_i[18];\u_pochoco_soc.genblk1.g_rom_ram_memory.u_ram.a_addr_i[20];\u_pochoco_soc.genblk1.g_rom_ram_memory.u_ram.a_rdata_o[0];\u_pochoco_soc.genblk1.g_rom_ram_memory.u_ram.a_rdata_o[10];\u_pochoco_soc.genblk1.g_rom_ram_memory.u_ram.a_rdata_o[11];\u_pochoco_soc.genblk1.g_rom_ram_memory.u_ram.a_rdata_o[12];\u_pochoco_soc.genblk1.g_rom_ram_memory.u_ram.a_rdata_o[13];\u_pochoco_soc.genblk1.g_rom_ram_memory.u_ram.a_rdata_o[14];\u_pochoco_soc.genblk1.g_rom_ram_memory.u_ram.a_rdata_o[19];\u_pochoco_soc.genblk1.g_rom_ram_memory.u_ram.a_rdata_o[24];\u_pochoco_soc.genblk1.g_rom_ram_memory.u_ram.a_rdata_o[25];\u_pochoco_soc.genblk1.g_rom_ram_memory.u_ram.a_rdata_o[26];\u_pochoco_soc.genblk1.g_rom_ram_memory.u_ram.a_rdata_o[27];\u_pochoco_soc.genblk1.g_rom_ram_memory.u_ram.a_rdata_o[28];\u_pochoco_soc.genblk1.g_rom_ram_memory.u_ram.a_rdata_o[29];\u_pochoco_soc.genblk1.g_rom_ram_memory.u_ram.a_rdata_o[2];\u_pochoco_soc.genblk1.g_rom_ram_memory.u_ram.a_rdata_o[30];\u_pochoco_soc.genblk1.g_rom_ram_memory.u_ram.a_rdata_o[31];\u_pochoco_soc.genblk1.g_rom_ram_memory.u_ram.a_rdata_o[3];\u_pochoco_soc.genblk1.g_rom_ram_memory.u_ram.a_rdata_o[4];\u_pochoco_soc.genblk1.g_rom_ram_memory.u_ram.a_rdata_o[5];\u_pochoco_soc.genblk1.g_rom_ram_memory.u_ram.a_rdata_o[6];\u_pochoco_soc.genblk1.g_rom_ram_memory.u_ram.a_rdata_o[7];\u_pochoco_soc.genblk1.g_rom_ram_memory.u_ram.a_rdata_o[8];\u_pochoc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
slew | net648 | 11 | 3.299151 | 3.0 | -0.299151 | fanout648/Z:gf180mcu_fd_sc_mcu7t5v0__dlyb_1 | reset | _8981_/RN | rst_ni
slew | net125 | 11 | 3.286229 | 3.0 | -0.286229 | _8277_/S:gf180mcu_fd_sc_mcu7t5v0__mux2_2;_8284_/S:gf180mcu_fd_sc_mcu7t5v0__mux2_2;_8287_/S:gf180mcu_fd_sc_mcu7t5v0__mux2_2;_8288_/S:gf180mcu_fd_sc_mcu7t5v0__mux2_2;_8289_/S:gf180mcu_fd_sc_mcu7t5v0__mux2_2;_8294_/S:gf180mcu_fd_sc_mcu7t5v0__mux2_2;fanout125/Z:gf180mcu_fd_sc_mcu7t5v0__dlyb_1 | instruction/ROM/fetch+data-memory+register-file+peripheral | _8277_/S | \u_pochoco_soc.data_wdata[0];\u_pochoco_soc.data_wdata[1];\u_pochoco_soc.data_wdata[2];\u_pochoco_soc.data_wdata[3];\u_pochoco_soc.data_wdata[4];\u_pochoco_soc.data_wdata[5];\u_pochoco_soc.data_wdata[6];\u_pochoco_soc.data_wdata[7];\u_pochoco_soc.genblk1.g_rom_ram_memory.u_ram.a_rdata_o[0];\u_pochoco_soc.genblk1.g_rom_ram_memory.u_ram.a_rdata_o[10];\u_pochoco_soc.genblk1.g_rom_ram_memory.u_ram.a_rdata_o[11];\u_pochoco_soc.genblk1.g_rom_ram_memory.u_ram.a_rdata_o[12];\u_pochoco_soc.genblk1.g_rom_ram_memory.u_ram.a_rdata_o[13];\u_pochoco_soc.genblk1.g_rom_ram_memory.u_ram.a_rdata_o[14];\u_pochoco_soc.genblk1.g_rom_ram_memory.u_ram.a_rdata_o[16];\u_pochoco_soc.genblk1.g_rom_ram_memory.u_ram.a_rdata_o[19];\u_pochoco_soc.genblk1.g_rom_ram_memory.u_ram.a_rdata_o[21];\u_pochoco_soc.genblk1.g_rom_ram_memory.u_ram.a_rdata_o[22];\u_pochoco_soc.genblk1.g_rom_ram_memory.u_ram.a_rdata_o[23];\u_pochoco_soc.genblk1.g_rom_ram_memory.u_ram.a_rdata_o[24];\u_pochoco_soc.genblk1.g_rom_ram_memory.u_ram.a_rdata_o[25];\u_pochoco_soc.genblk1.g_rom_ram_memory.u_ram.a_rdata_o[26];\u_pochoco_soc.genblk1.g_rom_ram_memory.u_ram.a_rdata_o[27];\u_pochoco_soc.genblk1.g_rom_ram_memory.u_ram.a_rdata_o[28];\u_pochoco_soc.genblk1.g_rom_ram_memory.u_ram.a_rdata_o[29];\u_pochoco_soc.genblk1.g_rom_ram_memory.u_ram.a_rdata_o[2];\u_pochoco_soc.genblk1.g_rom_ram_memory.u_ram.a_rdata_o[30];\u_pochoco_soc.genblk1.g_rom_ram_memory.u_ram.a_rdata_o[31];\u_pochoco_soc.genblk1.g_rom_ram_memory.u_ram.a_rdata_o[3];\u_pochoc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
slew | net180 | 11 | 3.28198 | 3.0 | -0.28198 | fanout180/Z:gf180mcu_fd_sc_mcu7t5v0__dlyb_1 | instruction/ROM/fetch | _7920_/A2 | \u_pochoco_soc.genblk1.g_rom_ram_memory.u_ram.a_addr_i[17];\u_pochoco_soc.genblk1.g_rom_ram_memory.u_ram.a_addr_i[18];\u_pochoco_soc.genblk1.g_rom_ram_memory.u_ram.a_addr_i[20];\u_pochoco_soc.genblk1.g_rom_ram_memory.u_ram.a_rdata_o[0];\u_pochoco_soc.genblk1.g_rom_ram_memory.u_ram.a_rdata_o[10];\u_pochoco_soc.genblk1.g_rom_ram_memory.u_ram.a_rdata_o[11];\u_pochoco_soc.genblk1.g_rom_ram_memory.u_ram.a_rdata_o[12];\u_pochoco_soc.genblk1.g_rom_ram_memory.u_ram.a_rdata_o[13];\u_pochoco_soc.genblk1.g_rom_ram_memory.u_ram.a_rdata_o[14];\u_pochoco_soc.genblk1.g_rom_ram_memory.u_ram.a_rdata_o[19];\u_pochoco_soc.genblk1.g_rom_ram_memory.u_ram.a_rdata_o[24];\u_pochoco_soc.genblk1.g_rom_ram_memory.u_ram.a_rdata_o[25];\u_pochoco_soc.genblk1.g_rom_ram_memory.u_ram.a_rdata_o[26];\u_pochoco_soc.genblk1.g_rom_ram_memory.u_ram.a_rdata_o[27];\u_pochoco_soc.genblk1.g_rom_ram_memory.u_ram.a_rdata_o[28];\u_pochoco_soc.genblk1.g_rom_ram_memory.u_ram.a_rdata_o[29];\u_pochoco_soc.genblk1.g_rom_ram_memory.u_ram.a_rdata_o[2];\u_pochoco_soc.genblk1.g_rom_ram_memory.u_ram.a_rdata_o[30];\u_pochoco_soc.genblk1.g_rom_ram_memory.u_ram.a_rdata_o[31];\u_pochoco_soc.genblk1.g_rom_ram_memory.u_ram.a_rdata_o[3];\u_pochoco_soc.genblk1.g_rom_ram_memory.u_ram.a_rdata_o[4];\u_pochoco_soc.genblk1.g_rom_ram_memory.u_ram.a_rdata_o[5];\u_pochoco_soc.genblk1.g_rom_ram_memory.u_ram.a_rdata_o[6];\u_pochoco_soc.genblk1.g_rom_ram_memory.u_ram.a_rdata_o[7];\u_pochoco_soc.genblk1.g_rom_ram_memory.u_ram.a_rdata_o[8];\u_pochoc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
slew | net323 | 11 | 3.281544 | 3.0 | -0.281544 | fanout323/Z:gf180mcu_fd_sc_mcu7t5v0__dlyb_1 | instruction/ROM/fetch | _4769_/A2 | \u_pochoco_soc.genblk1.g_rom_ram_memory.u_ram.a_rdata_o[0];\u_pochoco_soc.genblk1.g_rom_ram_memory.u_ram.a_rdata_o[12];\u_pochoco_soc.genblk1.g_rom_ram_memory.u_ram.a_rdata_o[13];\u_pochoco_soc.genblk1.g_rom_ram_memory.u_ram.a_rdata_o[14];\u_pochoco_soc.genblk1.g_rom_ram_memory.u_ram.a_rdata_o[2];\u_pochoco_soc.genblk1.g_rom_ram_memory.u_ram.a_rdata_o[30];\u_pochoco_soc.genblk1.g_rom_ram_memory.u_ram.a_rdata_o[3];\u_pochoco_soc.genblk1.g_rom_ram_memory.u_ram.a_rdata_o[4];\u_pochoco_soc.genblk1.g_rom_ram_memory.u_ram.a_rdata_o[5];\u_pochoco_soc.genblk1.g_rom_ram_memory.u_ram.a_rdata_o[6]
slew | net664 | 11 | 3.280822 | 3.0 | -0.280822 | fanout664/Z:gf180mcu_fd_sc_mcu7t5v0__dlyb_1 | reset | _8940_/RN | rst_ni
slew | net327 | 11 | 3.280061 | 3.0 | -0.280062 | fanout327/Z:gf180mcu_fd_sc_mcu7t5v0__dlyb_1 | instruction/ROM/fetch | _4899_/B | \u_pochoco_soc.genblk1.g_rom_ram_memory.u_ram.a_rdata_o[0];\u_pochoco_soc.genblk1.g_rom_ram_memory.u_ram.a_rdata_o[12];\u_pochoco_soc.genblk1.g_rom_ram_memory.u_ram.a_rdata_o[13];\u_pochoco_soc.genblk1.g_rom_ram_memory.u_ram.a_rdata_o[14];\u_pochoco_soc.genblk1.g_rom_ram_memory.u_ram.a_rdata_o[2];\u_pochoco_soc.genblk1.g_rom_ram_memory.u_ram.a_rdata_o[30];\u_pochoco_soc.genblk1.g_rom_ram_memory.u_ram.a_rdata_o[3];\u_pochoco_soc.genblk1.g_rom_ram_memory.u_ram.a_rdata_o[4];\u_pochoco_soc.genblk1.g_rom_ram_memory.u_ram.a_rdata_o[5];\u_pochoco_soc.genblk1.g_rom_ram_memory.u_ram.a_rdata_o[6]
slew | net557 | 11 | 3.268357 | 3.0 | -0.268357 | fanout557/Z:gf180mcu_fd_sc_mcu7t5v0__dlyb_1 | other-combinational | _6274_/B | \u_pochoco_soc.genblk1.g_rom_ram_memory.u_ram.a_addr_i[5]
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
