eaponce1/Proyecto3_Arquitectura_de_Computadores_Grupo_1/reports/stage13/baseline_residual_pins.csv

kind | net | violating_pin | driver | driver_cell | driver_pin | loads | value | limit | slack | driver_x_um | driver_y_um | pin_x_um | pin_y_um | classification | source | source_line
slew | _1548_ | _5285_/A1 | _4966_ | gf180mcu_fd_sc_mcu7t5v0__or2_1 | Z | 9 | 5.405243 | 3.0 | -2.405243 | 262.64 | 360.64 | 157.36 | 490.0 | instruction/ROM/fetch | asic\runs\etapa12_rom_ram_no_delay_ss\55-openroad-stapostpnr\max_ss_125C_4v50\checks.rpt | 258
slew | _1548_ | _5274_/A1 | _4966_ | gf180mcu_fd_sc_mcu7t5v0__or2_1 | Z | 9 | 5.40524 | 3.0 | -2.40524 | 262.64 | 360.64 | 86.24 | 415.52 | instruction/ROM/fetch | asic\runs\etapa12_rom_ram_no_delay_ss\55-openroad-stapostpnr\max_ss_125C_4v50\checks.rpt | 259
slew | _1548_ | _5329_/A1 | _4966_ | gf180mcu_fd_sc_mcu7t5v0__or2_1 | Z | 9 | 5.405237 | 3.0 | -2.405237 | 262.64 | 360.64 | 150.08 | 439.04 | instruction/ROM/fetch | asic\runs\etapa12_rom_ram_no_delay_ss\55-openroad-stapostpnr\max_ss_125C_4v50\checks.rpt | 260
slew | _1548_ | _5107_/A1 | _4966_ | gf180mcu_fd_sc_mcu7t5v0__or2_1 | Z | 9 | 5.405228 | 3.0 | -2.405228 | 262.64 | 360.64 | 69.44 | 148.96 | instruction/ROM/fetch | asic\runs\etapa12_rom_ram_no_delay_ss\55-openroad-stapostpnr\max_ss_125C_4v50\checks.rpt | 261
slew | _1548_ | _5230_/A1 | _4966_ | gf180mcu_fd_sc_mcu7t5v0__or2_1 | Z | 9 | 5.405225 | 3.0 | -2.405225 | 262.64 | 360.64 | 186.48 | 395.92 | instruction/ROM/fetch | asic\runs\etapa12_rom_ram_no_delay_ss\55-openroad-stapostpnr\max_ss_125C_4v50\checks.rpt | 262
slew | _1548_ | _5307_/A1 | _4966_ | gf180mcu_fd_sc_mcu7t5v0__or2_1 | Z | 9 | 5.405218 | 3.0 | -2.405218 | 262.64 | 360.64 | 238.56 | 517.44 | instruction/ROM/fetch | asic\runs\etapa12_rom_ram_no_delay_ss\55-openroad-stapostpnr\max_ss_125C_4v50\checks.rpt | 263
slew | _1548_ | _5096_/A1 | _4966_ | gf180mcu_fd_sc_mcu7t5v0__or2_1 | Z | 9 | 5.405213 | 3.0 | -2.405213 | 262.64 | 360.64 | 183.12 | 160.72 | instruction/ROM/fetch | asic\runs\etapa12_rom_ram_no_delay_ss\55-openroad-stapostpnr\max_ss_125C_4v50\checks.rpt | 264
slew | _1548_ | _5252_/A1 | _4966_ | gf180mcu_fd_sc_mcu7t5v0__or2_1 | Z | 9 | 5.405201 | 3.0 | -2.405201 | 262.64 | 360.64 | 262.64 | 415.52 | instruction/ROM/fetch | asic\runs\etapa12_rom_ram_no_delay_ss\55-openroad-stapostpnr\max_ss_125C_4v50\checks.rpt | 265
slew | _1548_ | _5052_/A1 | _4966_ | gf180mcu_fd_sc_mcu7t5v0__or2_1 | Z | 9 | 5.405187 | 3.0 | -2.405187 | 262.64 | 360.64 | 234.08 | 266.56 | instruction/ROM/fetch | asic\runs\etapa12_rom_ram_no_delay_ss\55-openroad-stapostpnr\max_ss_125C_4v50\checks.rpt | 266
slew | _1548_ | _4966_/Z | _4966_ | gf180mcu_fd_sc_mcu7t5v0__or2_1 | Z | 9 | 5.405167 | 3.0 | -2.405167 | 262.64 | 360.64 | 262.64 | 360.64 | instruction/ROM/fetch | asic\runs\etapa12_rom_ram_no_delay_ss\55-openroad-stapostpnr\max_ss_125C_4v50\checks.rpt | 267
slew | net860 | _5396_/A1 | fanout860 | gf180mcu_fd_sc_mcu7t5v0__buf_1 | Z | 10 | 5.158673 | 3.0 | -2.158673 | 179.76 | 392.0 | 271.04 | 160.72 | instruction/ROM/fetch | asic\runs\etapa12_rom_ram_no_delay_ss\55-openroad-stapostpnr\max_ss_125C_4v50\checks.rpt | 268
slew | net860 | _5407_/A1 | fanout860 | gf180mcu_fd_sc_mcu7t5v0__buf_1 | Z | 10 | 5.158662 | 3.0 | -2.158662 | 179.76 | 392.0 | 232.96 | 125.44 | instruction/ROM/fetch | asic\runs\etapa12_rom_ram_no_delay_ss\55-openroad-stapostpnr\max_ss_125C_4v50\checks.rpt | 269
slew | net860 | _5451_/A1 | fanout860 | gf180mcu_fd_sc_mcu7t5v0__buf_1 | Z | 10 | 5.158662 | 3.0 | -2.158662 | 179.76 | 392.0 | 265.44 | 223.44 | instruction/ROM/fetch | asic\runs\etapa12_rom_ram_no_delay_ss\55-openroad-stapostpnr\max_ss_125C_4v50\checks.rpt | 270
slew | net860 | _5561_/A1 | fanout860 | gf180mcu_fd_sc_mcu7t5v0__buf_1 | Z | 10 | 5.158654 | 3.0 | -2.158654 | 179.76 | 392.0 | 58.8 | 211.68 | instruction/ROM/fetch | asic\runs\etapa12_rom_ram_no_delay_ss\55-openroad-stapostpnr\max_ss_125C_4v50\checks.rpt | 271
slew | net860 | _5716_/A1 | fanout860 | gf180mcu_fd_sc_mcu7t5v0__buf_1 | Z | 10 | 5.158645 | 3.0 | -2.158645 | 179.76 | 392.0 | 98.56 | 243.04 | instruction/ROM/fetch | asic\runs\etapa12_rom_ram_no_delay_ss\55-openroad-stapostpnr\max_ss_125C_4v50\checks.rpt | 272
slew | net860 | _5429_/A1 | fanout860 | gf180mcu_fd_sc_mcu7t5v0__buf_1 | Z | 10 | 5.158642 | 3.0 | -2.158642 | 179.76 | 392.0 | 262.64 | 274.4 | instruction/ROM/fetch | asic\runs\etapa12_rom_ram_no_delay_ss\55-openroad-stapostpnr\max_ss_125C_4v50\checks.rpt | 273
slew | net860 | _5473_/A1 | fanout860 | gf180mcu_fd_sc_mcu7t5v0__buf_1 | Z | 10 | 5.158643 | 3.0 | -2.158643 | 179.76 | 392.0 | 179.76 | 176.4 | instruction/ROM/fetch | asic\runs\etapa12_rom_ram_no_delay_ss\55-openroad-stapostpnr\max_ss_125C_4v50\checks.rpt | 274
slew | net860 | _5506_/A1 | fanout860 | gf180mcu_fd_sc_mcu7t5v0__buf_1 | Z | 10 | 5.158637 | 3.0 | -2.158637 | 179.76 | 392.0 | 106.96 | 325.36 | instruction/ROM/fetch | asic\runs\etapa12_rom_ram_no_delay_ss\55-openroad-stapostpnr\max_ss_125C_4v50\checks.rpt | 275
slew | net860 | _5539_/A1 | fanout860 | gf180mcu_fd_sc_mcu7t5v0__buf_1 | Z | 10 | 5.158622 | 3.0 | -2.158622 | 179.76 | 392.0 | 152.32 | 278.32 | instruction/ROM/fetch | asic\runs\etapa12_rom_ram_no_delay_ss\55-openroad-stapostpnr\max_ss_125C_4v50\checks.rpt | 276
slew | net860 | _5605_/A1 | fanout860 | gf180mcu_fd_sc_mcu7t5v0__buf_1 | Z | 10 | 5.158544 | 3.0 | -2.158544 | 179.76 | 392.0 | 184.8 | 388.08 | instruction/ROM/fetch | asic\runs\etapa12_rom_ram_no_delay_ss\55-openroad-stapostpnr\max_ss_125C_4v50\checks.rpt | 277
slew | net860 | fanout860/Z | fanout860 | gf180mcu_fd_sc_mcu7t5v0__buf_1 | Z | 10 | 5.158544 | 3.0 | -2.158544 | 179.76 | 392.0 | 179.76 | 392.0 | instruction/ROM/fetch | asic\runs\etapa12_rom_ram_no_delay_ss\55-openroad-stapostpnr\max_ss_125C_4v50\checks.rpt | 278
slew | \u_pochoco_soc.data_wdata[4] | _4485_/A1 | _9249_ | gf180mcu_fd_sc_mcu7t5v0__dffrnq_1 | Q | 7 | 4.678382 | 3.0 | -1.678382 | 286.72 | 490.0 | 502.88 | 305.76 | data-memory | asic\runs\etapa12_rom_ram_no_delay_ss\55-openroad-stapostpnr\max_ss_125C_4v50\checks.rpt | 279
slew | \u_pochoco_soc.data_wdata[4] | _8386_/I0 | _9249_ | gf180mcu_fd_sc_mcu7t5v0__dffrnq_1 | Q | 7 | 4.67834 | 3.0 | -1.67834 | 286.72 | 490.0 | 543.2 | 243.04 | data-memory | asic\runs\etapa12_rom_ram_no_delay_ss\55-openroad-stapostpnr\max_ss_125C_4v50\checks.rpt | 280
slew | \u_pochoco_soc.data_wdata[4] | _8271_/I0 | _9249_ | gf180mcu_fd_sc_mcu7t5v0__dffrnq_1 | Q | 7 | 4.678308 | 3.0 | -1.678309 | 286.72 | 490.0 | 544.32 | 196.0 | data-memory | asic\runs\etapa12_rom_ram_no_delay_ss\55-openroad-stapostpnr\max_ss_125C_4v50\checks.rpt | 281
slew | \u_pochoco_soc.data_wdata[4] | _6856_/I1 | _9249_ | gf180mcu_fd_sc_mcu7t5v0__dffrnq_1 | Q | 7 | 4.678216 | 3.0 | -1.678216 | 286.72 | 490.0 | 473.2 | 180.32 | data-memory | asic\runs\etapa12_rom_ram_no_delay_ss\55-openroad-stapostpnr\max_ss_125C_4v50\checks.rpt | 282
slew | \u_pochoco_soc.data_wdata[4] | _6837_/I1 | _9249_ | gf180mcu_fd_sc_mcu7t5v0__dffrnq_1 | Q | 7 | 4.678136 | 3.0 | -1.678136 | 286.72 | 490.0 | 412.72 | 184.24 | data-memory | asic\runs\etapa12_rom_ram_no_delay_ss\55-openroad-stapostpnr\max_ss_125C_4v50\checks.rpt | 283
slew | \u_pochoco_soc.data_wdata[4] | _6787_/B2 | _9249_ | gf180mcu_fd_sc_mcu7t5v0__dffrnq_1 | Q | 7 | 4.677978 | 3.0 | -1.677978 | 286.72 | 490.0 | 325.36 | 192.08 | data-memory | asic\runs\etapa12_rom_ram_no_delay_ss\55-openroad-stapostpnr\max_ss_125C_4v50\checks.rpt | 284
slew | \u_pochoco_soc.data_wdata[4] | _6786_/A1 | _9249_ | gf180mcu_fd_sc_mcu7t5v0__dffrnq_1 | Q | 7 | 4.67795 | 3.0 | -1.677951 | 286.72 | 490.0 | 305.76 | 192.08 | data-memory | asic\runs\etapa12_rom_ram_no_delay_ss\55-openroad-stapostpnr\max_ss_125C_4v50\checks.rpt | 285
slew | \u_pochoco_soc.data_wdata[4] | _9249_/Q | _9249_ | gf180mcu_fd_sc_mcu7t5v0__dffrnq_1 | Q | 7 | 4.677575 | 3.0 | -1.677575 | 286.72 | 490.0 | 286.72 | 490.0 | data-memory | asic\runs\etapa12_rom_ram_no_delay_ss\55-openroad-stapostpnr\max_ss_125C_4v50\checks.rpt | 286
slew | net1237 | fanout1176/I | fanout1237 | gf180mcu_fd_sc_mcu7t5v0__buf_1 | Z | 6 | 4.58368 | 3.0 | -1.58368 | 296.24 | 47.04 | 165.76 | 301.84 | reset | asic\runs\etapa12_rom_ram_no_delay_ss\55-openroad-stapostpnr\max_ss_125C_4v50\checks.rpt | 287
slew | net1237 | fanout1198/I | fanout1237 | gf180mcu_fd_sc_mcu7t5v0__buf_1 | Z | 6 | 4.583635 | 3.0 | -1.583635 | 296.24 | 47.04 | 161.84 | 431.2 | reset | asic\runs\etapa12_rom_ram_no_delay_ss\55-openroad-stapostpnr\max_ss_125C_4v50\checks.rpt | 288
slew | net1237 | fanout1235/I | fanout1237 | gf180mcu_fd_sc_mcu7t5v0__buf_1 | Z | 6 | 4.583567 | 3.0 | -1.583567 | 296.24 | 47.04 | 269.92 | 439.04 | reset | asic\runs\etapa12_rom_ram_no_delay_ss\55-openroad-stapostpnr\max_ss_125C_4v50\checks.rpt | 289
slew | net1237 | fanout1216/I | fanout1237 | gf180mcu_fd_sc_mcu7t5v0__buf_1 | Z | 6 | 4.58344 | 3.0 | -1.58344 | 296.24 | 47.04 | 275.52 | 294.0 | reset | asic\runs\etapa12_rom_ram_no_delay_ss\55-openroad-stapostpnr\max_ss_125C_4v50\checks.rpt | 290
slew | net1237 | fanout1114/I | fanout1237 | gf180mcu_fd_sc_mcu7t5v0__buf_1 | Z | 6 | 4.583284 | 3.0 | -1.583285 | 296.24 | 47.04 | 154.0 | 43.12 | reset | asic\runs\etapa12_rom_ram_no_delay_ss\55-openroad-stapostpnr\max_ss_125C_4v50\checks.rpt | 291
slew | net1237 | fanout1155/I | fanout1237 | gf180mcu_fd_sc_mcu7t5v0__buf_1 | Z | 6 | 4.583284 | 3.0 | -1.583285 | 296.24 | 47.04 | 294.0 | 43.12 | reset | asic\runs\etapa12_rom_ram_no_delay_ss\55-openroad-stapostpnr\max_ss_125C_4v50\checks.rpt | 292
slew | net1237 | fanout1237/Z | fanout1237 | gf180mcu_fd_sc_mcu7t5v0__buf_1 | Z | 6 | 4.583284 | 3.0 | -1.583285 | 296.24 | 47.04 | 296.24 | 47.04 | reset | asic\runs\etapa12_rom_ram_no_delay_ss\55-openroad-stapostpnr\max_ss_125C_4v50\checks.rpt | 293
slew | net804 | _6932_/A1 | fanout804 | gf180mcu_fd_sc_mcu7t5v0__buf_1 | Z | 10 | 4.190093 | 3.0 | -1.190092 | 458.64 | 376.32 | 470.4 | 286.16 | instruction/ROM/fetch | asic\runs\etapa12_rom_ram_no_delay_ss\55-openroad-stapostpnr\max_ss_125C_4v50\checks.rpt | 294
slew | net804 | _6986_/B | fanout804 | gf180mcu_fd_sc_mcu7t5v0__buf_1 | Z | 10 | 4.190088 | 3.0 | -1.190089 | 458.64 | 376.32 | 488.32 | 258.72 | instruction/ROM/fetch | asic\runs\etapa12_rom_ram_no_delay_ss\55-openroad-stapostpnr\max_ss_125C_4v50\checks.rpt | 295
slew | net804 | _7000_/A1 | fanout804 | gf180mcu_fd_sc_mcu7t5v0__buf_1 | Z | 10 | 4.190088 | 3.0 | -1.190089 | 458.64 | 376.32 | 481.6 | 258.72 | instruction/ROM/fetch | asic\runs\etapa12_rom_ram_no_delay_ss\55-openroad-stapostpnr\max_ss_125C_4v50\checks.rpt | 296
slew | net804 | _6908_/A1 | fanout804 | gf180mcu_fd_sc_mcu7t5v0__buf_1 | Z | 10 | 4.190067 | 3.0 | -1.190067 | 458.64 | 376.32 | 474.88 | 219.52 | instruction/ROM/fetch | asic\runs\etapa12_rom_ram_no_delay_ss\55-openroad-stapostpnr\max_ss_125C_4v50\checks.rpt | 297
slew | net804 | _4363_/A1 | fanout804 | gf180mcu_fd_sc_mcu7t5v0__buf_1 | Z | 10 | 4.189998 | 3.0 | -1.189998 | 458.64 | 376.32 | 354.48 | 227.36 | instruction/ROM/fetch | asic\runs\etapa12_rom_ram_no_delay_ss\55-openroad-stapostpnr\max_ss_125C_4v50\checks.rpt | 298
slew | net804 | _7182_/B2 | fanout804 | gf180mcu_fd_sc_mcu7t5v0__buf_1 | Z | 10 | 4.189998 | 3.0 | -1.189998 | 458.64 | 376.32 | 346.08 | 227.36 | instruction/ROM/fetch | asic\runs\etapa12_rom_ram_no_delay_ss\55-openroad-stapostpnr\max_ss_125C_4v50\checks.rpt | 299
slew | net804 | _7052_/A1 | fanout804 | gf180mcu_fd_sc_mcu7t5v0__buf_1 | Z | 10 | 4.189908 | 3.0 | -1.189908 | 458.64 | 376.32 | 370.72 | 341.04 | instruction/ROM/fetch | asic\runs\etapa12_rom_ram_no_delay_ss\55-openroad-stapostpnr\max_ss_125C_4v50\checks.rpt | 300
slew | net804 | _7034_/A1 | fanout804 | gf180mcu_fd_sc_mcu7t5v0__buf_1 | Z | 10 | 4.18987 | 3.0 | -1.18987 | 458.64 | 376.32 | 399.84 | 317.52 | instruction/ROM/fetch | asic\runs\etapa12_rom_ram_no_delay_ss\55-openroad-stapostpnr\max_ss_125C_4v50\checks.rpt | 301
slew | net804 | _5794_/B | fanout804 | gf180mcu_fd_sc_mcu7t5v0__buf_1 | Z | 10 | 4.189843 | 3.0 | -1.189843 | 458.64 | 376.32 | 426.72 | 301.84 | instruction/ROM/fetch | asic\runs\etapa12_rom_ram_no_delay_ss\55-openroad-stapostpnr\max_ss_125C_4v50\checks.rpt | 302
slew | net804 | _4373_/A2 | fanout804 | gf180mcu_fd_sc_mcu7t5v0__buf_1 | Z | 10 | 4.189762 | 3.0 | -1.189762 | 458.64 | 376.32 | 454.16 | 376.32 | instruction/ROM/fetch | asic\runs\etapa12_rom_ram_no_delay_ss\55-openroad-stapostpnr\max_ss_125C_4v50\checks.rpt | 303
slew | net804 | fanout804/Z | fanout804 | gf180mcu_fd_sc_mcu7t5v0__buf_1 | Z | 10 | 4.189762 | 3.0 | -1.189762 | 458.64 | 376.32 | 458.64 | 376.32 | instruction/ROM/fetch | asic\runs\etapa12_rom_ram_no_delay_ss\55-openroad-stapostpnr\max_ss_125C_4v50\checks.rpt | 304
slew | net300 | fanout287/I | fanout300 | gf180mcu_fd_sc_mcu7t5v0__buf_1 | Z | 7 | 4.151794 | 3.0 | -1.151794 | 266.56 | 439.04 | 267.12 | 39.2 | instruction/ROM/fetch | asic\runs\etapa12_rom_ram_no_delay_ss\55-openroad-stapostpnr\max_ss_125C_4v50\checks.rpt | 305
slew | net300 | fanout289/I | fanout300 | gf180mcu_fd_sc_mcu7t5v0__buf_1 | Z | 7 | 4.151779 | 3.0 | -1.151779 | 266.56 | 439.04 | 258.16 | 141.12 | instruction/ROM/fetch | asic\runs\etapa12_rom_ram_no_delay_ss\55-openroad-stapostpnr\max_ss_125C_4v50\checks.rpt | 306
slew | net300 | fanout290/I | fanout300 | gf180mcu_fd_sc_mcu7t5v0__buf_1 | Z | 7 | 4.151668 | 3.0 | -1.151668 | 266.56 | 439.04 | 126.56 | 297.92 | instruction/ROM/fetch | asic\runs\etapa12_rom_ram_no_delay_ss\55-openroad-stapostpnr\max_ss_125C_4v50\checks.rpt | 307
slew | net300 | fanout292/I | fanout300 | gf180mcu_fd_sc_mcu7t5v0__buf_1 | Z | 7 | 4.151651 | 3.0 | -1.151651 | 266.56 | 439.04 | 231.28 | 301.84 | instruction/ROM/fetch | asic\runs\etapa12_rom_ram_no_delay_ss\55-openroad-stapostpnr\max_ss_125C_4v50\checks.rpt | 308
slew | net300 | fanout298/I | fanout300 | gf180mcu_fd_sc_mcu7t5v0__buf_1 | Z | 7 | 4.151585 | 3.0 | -1.151585 | 266.56 | 439.04 | 217.28 | 352.8 | instruction/ROM/fetch | asic\runs\etapa12_rom_ram_no_delay_ss\55-openroad-stapostpnr\max_ss_125C_4v50\checks.rpt | 309
slew | net300 | fanout294/I | fanout300 | gf180mcu_fd_sc_mcu7t5v0__buf_1 | Z | 7 | 4.15151 | 3.0 | -1.15151 | 266.56 | 439.04 | 128.8 | 435.12 | instruction/ROM/fetch | asic\runs\etapa12_rom_ram_no_delay_ss\55-openroad-stapostpnr\max_ss_125C_4v50\checks.rpt | 310
slew | net300 | fanout296/I | fanout300 | gf180mcu_fd_sc_mcu7t5v0__buf_1 | Z | 7 | 4.15151 | 3.0 | -1.15151 | 266.56 | 439.04 | 273.84 | 431.2 | instruction/ROM/fetch | asic\runs\etapa12_rom_ram_no_delay_ss\55-openroad-stapostpnr\max_ss_125C_4v50\checks.rpt | 311
slew | net300 | fanout300/Z | fanout300 | gf180mcu_fd_sc_mcu7t5v0__buf_1 | Z | 7 | 4.15151 | 3.0 | -1.15151 | 266.56 | 439.04 | 266.56 | 439.04 | instruction/ROM/fetch | asic\runs\etapa12_rom_ram_no_delay_ss\55-openroad-stapostpnr\max_ss_125C_4v50\checks.rpt | 312
slew | _3503_ | fanout57/I | _7118_ | gf180mcu_fd_sc_mcu7t5v0__aoi221_2 | ZN | 2 | 4.007597 | 3.0 | -1.007598 | 342.72 | 384.16 | 196.56 | 462.56 | instruction/ROM/fetch+data-memory+register-file+peripheral | asic\runs\etapa12_rom_ram_no_delay_ss\55-openroad-stapostpnr\max_ss_125C_4v50\checks.rpt | 313
slew | _3503_ | fanout59/I | _7118_ | gf180mcu_fd_sc_mcu7t5v0__aoi221_2 | ZN | 2 | 4.007598 | 3.0 | -1.007599 | 342.72 | 384.16 | 203.84 | 537.04 | instruction/ROM/fetch+data-memory+register-file+peripheral | asic\runs\etapa12_rom_ram_no_delay_ss\55-openroad-stapostpnr\max_ss_125C_4v50\checks.rpt | 314
slew | _3503_ | _7118_/ZN | _7118_ | gf180mcu_fd_sc_mcu7t5v0__aoi221_2 | ZN | 2 | 4.007594 | 3.0 | -1.007594 | 342.72 | 384.16 | 342.72 | 384.16 | instruction/ROM/fetch+data-memory+register-file+peripheral | asic\runs\etapa12_rom_ram_no_delay_ss\55-openroad-stapostpnr\max_ss_125C_4v50\checks.rpt | 315
slew | _3462_ | fanout79/I | _7071_ | gf180mcu_fd_sc_mcu7t5v0__aoi221_2 | ZN | 2 | 3.794204 | 3.0 | -0.794204 | 366.24 | 203.84 | 133.84 | 121.52 | instruction/ROM/fetch+data-memory+register-file+peripheral | asic\runs\etapa12_rom_ram_no_delay_ss\55-openroad-stapostpnr\max_ss_125C_4v50\checks.rpt | 316
slew | _3462_ | fanout81/I | _7071_ | gf180mcu_fd_sc_mcu7t5v0__aoi221_2 | ZN | 2 | 3.794203 | 3.0 | -0.794203 | 366.24 | 203.84 | 153.44 | 141.12 | instruction/ROM/fetch+data-memory+register-file+peripheral | asic\runs\etapa12_rom_ram_no_delay_ss\55-openroad-stapostpnr\max_ss_125C_4v50\checks.rpt | 317
slew | _3462_ | _7071_/ZN | _7071_ | gf180mcu_fd_sc_mcu7t5v0__aoi221_2 | ZN | 2 | 3.7942 | 3.0 | -0.7942 | 366.24 | 203.84 | 366.24 | 203.84 | instruction/ROM/fetch+data-memory+register-file+peripheral | asic\runs\etapa12_rom_ram_no_delay_ss\55-openroad-stapostpnr\max_ss_125C_4v50\checks.rpt | 318
slew | _3439_ | fanout90/I | _7045_ | gf180mcu_fd_sc_mcu7t5v0__aoi211_2 | ZN | 2 | 3.789024 | 3.0 | -0.789024 | 388.08 | 270.48 | 39.2 | 270.48 | instruction/ROM/fetch+data-memory+register-file+peripheral | asic\runs\etapa12_rom_ram_no_delay_ss\55-openroad-stapostpnr\max_ss_125C_4v50\checks.rpt | 319
slew | _3439_ | fanout92/I | _7045_ | gf180mcu_fd_sc_mcu7t5v0__aoi211_2 | ZN | 2 | 3.789024 | 3.0 | -0.789024 | 388.08 | 270.48 | 90.72 | 282.24 | instruction/ROM/fetch+data-memory+register-file+peripheral | asic\runs\etapa12_rom_ram_no_delay_ss\55-openroad-stapostpnr\max_ss_125C_4v50\checks.rpt | 320
slew | _3439_ | _7045_/ZN | _7045_ | gf180mcu_fd_sc_mcu7t5v0__aoi211_2 | ZN | 2 | 3.789022 | 3.0 | -0.789023 | 388.08 | 270.48 | 388.08 | 270.48 | instruction/ROM/fetch+data-memory+register-file+peripheral | asic\runs\etapa12_rom_ram_no_delay_ss\55-openroad-stapostpnr\max_ss_125C_4v50\checks.rpt | 321
slew | net271 | fanout258/I | fanout271 | gf180mcu_fd_sc_mcu7t5v0__buf_1 | Z | 5 | 3.766196 | 3.0 | -0.766196 | 301.84 | 517.44 | 140.56 | 156.8 | instruction/ROM/fetch | asic\runs\etapa12_rom_ram_no_delay_ss\55-openroad-stapostpnr\max_ss_125C_4v50\checks.rpt | 322
slew | net271 | fanout260/I | fanout271 | gf180mcu_fd_sc_mcu7t5v0__buf_1 | Z | 5 | 3.766175 | 3.0 | -0.766175 | 301.84 | 517.44 | 120.96 | 246.96 | instruction/ROM/fetch | asic\runs\etapa12_rom_ram_no_delay_ss\55-openroad-stapostpnr\max_ss_125C_4v50\checks.rpt | 323
slew | net271 | fanout263/I | fanout271 | gf180mcu_fd_sc_mcu7t5v0__buf_1 | Z | 5 | 3.766051 | 3.0 | -0.766051 | 301.84 | 517.44 | 286.72 | 223.44 | instruction/ROM/fetch | asic\runs\etapa12_rom_ram_no_delay_ss\55-openroad-stapostpnr\max_ss_125C_4v50\checks.rpt | 324
slew | net271 | fanout261/I | fanout271 | gf180mcu_fd_sc_mcu7t5v0__buf_1 | Z | 5 | 3.766045 | 3.0 | -0.766045 | 301.84 | 517.44 | 293.44 | 137.2 | instruction/ROM/fetch | asic\runs\etapa12_rom_ram_no_delay_ss\55-openroad-stapostpnr\max_ss_125C_4v50\checks.rpt | 325
slew | net271 | fanout270/I | fanout271 | gf180mcu_fd_sc_mcu7t5v0__buf_1 | Z | 5 | 3.765851 | 3.0 | -0.765851 | 301.84 | 517.44 | 296.24 | 521.36 | instruction/ROM/fetch | asic\runs\etapa12_rom_ram_no_delay_ss\55-openroad-stapostpnr\max_ss_125C_4v50\checks.rpt | 326
slew | net271 | fanout271/Z | fanout271 | gf180mcu_fd_sc_mcu7t5v0__buf_1 | Z | 5 | 3.765851 | 3.0 | -0.765851 | 301.84 | 517.44 | 301.84 | 517.44 | instruction/ROM/fetch | asic\runs\etapa12_rom_ram_no_delay_ss\55-openroad-stapostpnr\max_ss_125C_4v50\checks.rpt | 327
slew | _2333_ | _6249_/A1 | _5832_ | gf180mcu_fd_sc_mcu7t5v0__nand2_1 | ZN | 10 | 3.75972 | 3.0 | -0.75972 | 571.76 | 435.12 | 486.08 | 442.96 | other-combinational | asic\runs\etapa12_rom_ram_no_delay_ss\55-openroad-stapostpnr\max_ss_125C_4v50\checks.rpt | 328
slew | _2333_ | _6560_/A3 | _5832_ | gf180mcu_fd_sc_mcu7t5v0__nand2_1 | ZN | 10 | 3.759701 | 3.0 | -0.759701 | 571.76 | 435.12 | 488.32 | 505.68 | other-combinational | asic\runs\etapa12_rom_ram_no_delay_ss\55-openroad-stapostpnr\max_ss_125C_4v50\checks.rpt | 329
slew | _2333_ | _6610_/A2 | _5832_ | gf180mcu_fd_sc_mcu7t5v0__nand2_1 | ZN | 10 | 3.759666 | 3.0 | -0.759667 | 571.76 | 435.12 | 505.68 | 540.96 | other-combinational | asic\runs\etapa12_rom_ram_no_delay_ss\55-openroad-stapostpnr\max_ss_125C_4v50\checks.rpt | 330
slew | _2333_ | _6339_/A2 | _5832_ | gf180mcu_fd_sc_mcu7t5v0__nand2_1 | ZN | 10 | 3.759657 | 3.0 | -0.759657 | 571.76 | 435.12 | 522.48 | 540.96 | other-combinational | asic\runs\etapa12_rom_ram_no_delay_ss\55-openroad-stapostpnr\max_ss_125C_4v50\checks.rpt | 331
slew | _2333_ | _5834_/A1 | _5832_ | gf180mcu_fd_sc_mcu7t5v0__nand2_1 | ZN | 10 | 3.759631 | 3.0 | -0.759631 | 571.76 | 435.12 | 562.8 | 537.04 | other-combinational | asic\runs\etapa12_rom_ram_no_delay_ss\55-openroad-stapostpnr\max_ss_125C_4v50\checks.rpt | 332
slew | _2333_ | _6301_/A2 | _5832_ | gf180mcu_fd_sc_mcu7t5v0__nand2_1 | ZN | 10 | 3.75962 | 3.0 | -0.75962 | 571.76 | 435.12 | 579.6 | 540.96 | other-combinational | asic\runs\etapa12_rom_ram_no_delay_ss\55-openroad-stapostpnr\max_ss_125C_4v50\checks.rpt | 333
slew | _2333_ | _5835_/A1 | _5832_ | gf180mcu_fd_sc_mcu7t5v0__nand2_1 | ZN | 10 | 3.759612 | 3.0 | -0.759612 | 571.76 | 435.12 | 570.08 | 521.36 | other-combinational | asic\runs\etapa12_rom_ram_no_delay_ss\55-openroad-stapostpnr\max_ss_125C_4v50\checks.rpt | 334
slew | _2333_ | _6668_/A3 | _5832_ | gf180mcu_fd_sc_mcu7t5v0__nand2_1 | ZN | 10 | 3.759592 | 3.0 | -0.759592 | 571.76 | 435.12 | 548.8 | 486.08 | other-combinational | asic\runs\etapa12_rom_ram_no_delay_ss\55-openroad-stapostpnr\max_ss_125C_4v50\checks.rpt | 335
slew | _2333_ | _6290_/A1 | _5832_ | gf180mcu_fd_sc_mcu7t5v0__nand2_1 | ZN | 10 | 3.759577 | 3.0 | -0.759577 | 571.76 | 435.12 | 576.24 | 470.4 | other-combinational | asic\runs\etapa12_rom_ram_no_delay_ss\55-openroad-stapostpnr\max_ss_125C_4v50\checks.rpt | 336
slew | _2333_ | _5832_/ZN | _5832_ | gf180mcu_fd_sc_mcu7t5v0__nand2_1 | ZN | 10 | 3.759562 | 3.0 | -0.759562 | 571.76 | 435.12 | 571.76 | 435.12 | other-combinational | asic\runs\etapa12_rom_ram_no_delay_ss\55-openroad-stapostpnr\max_ss_125C_4v50\checks.rpt | 337
slew | _2333_ | _6696_/A1 | _5832_ | gf180mcu_fd_sc_mcu7t5v0__nand2_1 | ZN | 10 | 3.759562 | 3.0 | -0.759562 | 571.76 | 435.12 | 563.36 | 435.12 | other-combinational | asic\runs\etapa12_rom_ram_no_delay_ss\55-openroad-stapostpnr\max_ss_125C_4v50\checks.rpt | 338
slew | \u_pochoco_soc.data_wdata[0] | _8381_/I0 | _9245_ | gf180mcu_fd_sc_mcu7t5v0__dffrnq_1 | Q | 7 | 3.706598 | 3.0 | -0.706598 | 301.28 | 105.84 | 546.0 | 223.44 | data-memory | asic\runs\etapa12_rom_ram_no_delay_ss\55-openroad-stapostpnr\max_ss_125C_4v50\checks.rpt | 339
slew | \u_pochoco_soc.data_wdata[0] | _8266_/I0 | _9245_ | gf180mcu_fd_sc_mcu7t5v0__dffrnq_1 | Q | 7 | 3.706586 | 3.0 | -0.706587 | 301.28 | 105.84 | 556.64 | 129.36 | data-memory | asic\runs\etapa12_rom_ram_no_delay_ss\55-openroad-stapostpnr\max_ss_125C_4v50\checks.rpt | 340
slew | \u_pochoco_soc.data_wdata[0] | _8261_/I0 | _9245_ | gf180mcu_fd_sc_mcu7t5v0__dffrnq_1 | Q | 7 | 3.706584 | 3.0 | -0.706584 | 301.28 | 105.84 | 562.24 | 117.6 | data-memory | asic\runs\etapa12_rom_ram_no_delay_ss\55-openroad-stapostpnr\max_ss_125C_4v50\checks.rpt | 341
slew | \u_pochoco_soc.data_wdata[0] | _6851_/I1 | _9245_ | gf180mcu_fd_sc_mcu7t5v0__dffrnq_1 | Q | 7 | 3.706552 | 3.0 | -0.706552 | 301.28 | 105.84 | 465.92 | 105.84 | data-memory | asic\runs\etapa12_rom_ram_no_delay_ss\55-openroad-stapostpnr\max_ss_125C_4v50\checks.rpt | 342
slew | \u_pochoco_soc.data_wdata[0] | _4466_/A1 | _9245_ | gf180mcu_fd_sc_mcu7t5v0__dffrnq_1 | Q | 7 | 3.706537 | 3.0 | -0.706537 | 301.28 | 105.84 | 430.64 | 227.36 | data-memory | asic\runs\etapa12_rom_ram_no_delay_ss\55-openroad-stapostpnr\max_ss_125C_4v50\checks.rpt | 343
slew | \u_pochoco_soc.data_wdata[0] | _6768_/A1 | _9245_ | gf180mcu_fd_sc_mcu7t5v0__dffrnq_1 | Q | 7 | 3.706525 | 3.0 | -0.706525 | 301.28 | 105.84 | 358.4 | 148.96 | data-memory | asic\runs\etapa12_rom_ram_no_delay_ss\55-openroad-stapostpnr\max_ss_125C_4v50\checks.rpt | 344
slew | \u_pochoco_soc.data_wdata[0] | _6767_/A1 | _9245_ | gf180mcu_fd_sc_mcu7t5v0__dffrnq_1 | Q | 7 | 3.706521 | 3.0 | -0.706521 | 301.28 | 105.84 | 352.24 | 133.28 | data-memory | asic\runs\etapa12_rom_ram_no_delay_ss\55-openroad-stapostpnr\max_ss_125C_4v50\checks.rpt | 345
slew | \u_pochoco_soc.data_wdata[0] | _9245_/Q | _9245_ | gf180mcu_fd_sc_mcu7t5v0__dffrnq_1 | Q | 7 | 3.706507 | 3.0 | -0.706507 | 301.28 | 105.84 | 301.28 | 105.84 | data-memory | asic\runs\etapa12_rom_ram_no_delay_ss\55-openroad-stapostpnr\max_ss_125C_4v50\checks.rpt | 346
slew | net1342 | fanout1267/I | fanout1342 | gf180mcu_fd_sc_mcu7t5v0__buf_1 | Z | 5 | 3.63073 | 3.0 | -0.630731 | 584.64 | 31.36 | 448.0 | 215.6 | reset | asic\runs\etapa12_rom_ram_no_delay_ss\55-openroad-stapostpnr\max_ss_125C_4v50\checks.rpt | 347
slew | net1342 | fanout1237/I | fanout1342 | gf180mcu_fd_sc_mcu7t5v0__buf_1 | Z | 5 | 3.630711 | 3.0 | -0.630711 | 584.64 | 31.36 | 296.24 | 47.04 | reset | asic\runs\etapa12_rom_ram_no_delay_ss\55-openroad-stapostpnr\max_ss_125C_4v50\checks.rpt | 348
slew | net1342 | fanout1263/I | fanout1342 | gf180mcu_fd_sc_mcu7t5v0__buf_1 | Z | 5 | 3.630691 | 3.0 | -0.630691 | 584.64 | 31.36 | 436.24 | 31.36 | reset | asic\runs\etapa12_rom_ram_no_delay_ss\55-openroad-stapostpnr\max_ss_125C_4v50\checks.rpt | 349
slew | net1342 | fanout1340/I | fanout1342 | gf180mcu_fd_sc_mcu7t5v0__buf_1 | Z | 5 | 3.630677 | 3.0 | -0.630677 | 584.64 | 31.36 | 592.48 | 297.92 | reset | asic\runs\etapa12_rom_ram_no_delay_ss\55-openroad-stapostpnr\max_ss_125C_4v50\checks.rpt | 350
slew | net1342 | fanout1307/I | fanout1342 | gf180mcu_fd_sc_mcu7t5v0__buf_1 | Z | 5 | 3.630662 | 3.0 | -0.630662 | 584.64 | 31.36 | 583.52 | 27.44 | reset | asic\runs\etapa12_rom_ram_no_delay_ss\55-openroad-stapostpnr\max_ss_125C_4v50\checks.rpt | 351
slew | net1342 | fanout1342/Z | fanout1342 | gf180mcu_fd_sc_mcu7t5v0__buf_1 | Z | 5 | 3.630662 | 3.0 | -0.630662 | 584.64 | 31.36 | 584.64 | 31.36 | reset | asic\runs\etapa12_rom_ram_no_delay_ss\55-openroad-stapostpnr\max_ss_125C_4v50\checks.rpt | 352
slew | _1427_ | _6039_/A1 | _4812_ | gf180mcu_fd_sc_mcu7t5v0__aoi21_1 | ZN | 3 | 3.629792 | 3.0 | -0.629792 | 322.56 | 254.8 | 367.36 | 431.2 | instruction/ROM/fetch+data-memory+register-file | asic\runs\etapa12_rom_ram_no_delay_ss\55-openroad-stapostpnr\max_ss_125C_4v50\checks.rpt | 353
slew | _1427_ | _4812_/ZN | _4812_ | gf180mcu_fd_sc_mcu7t5v0__aoi21_1 | ZN | 3 | 3.629776 | 3.0 | -0.629776 | 322.56 | 254.8 | 322.56 | 254.8 | instruction/ROM/fetch+data-memory+register-file | asic\runs\etapa12_rom_ram_no_delay_ss\55-openroad-stapostpnr\max_ss_125C_4v50\checks.rpt | 354
slew | _1427_ | _4895_/A2 | _4812_ | gf180mcu_fd_sc_mcu7t5v0__aoi21_1 | ZN | 3 | 3.629776 | 3.0 | -0.629776 | 322.56 | 254.8 | 345.52 | 344.96 | instruction/ROM/fetch+data-memory+register-file | asic\runs\etapa12_rom_ram_no_delay_ss\55-openroad-stapostpnr\max_ss_125C_4v50\checks.rpt | 355
slew | _1427_ | _7093_/A2 | _4812_ | gf180mcu_fd_sc_mcu7t5v0__aoi21_1 | ZN | 3 | 3.629776 | 3.0 | -0.629776 | 322.56 | 254.8 | 360.64 | 243.04 | instruction/ROM/fetch+data-memory+register-file | asic\runs\etapa12_rom_ram_no_delay_ss\55-openroad-stapostpnr\max_ss_125C_4v50\checks.rpt | 356
slew | _2700_ | _6527_/A2 | _6231_ | gf180mcu_fd_sc_mcu7t5v0__nand2_1 | ZN | 9 | 3.612185 | 3.0 | -0.612185 | 463.68 | 435.12 | 477.68 | 533.12 | other-combinational | asic\runs\etapa12_rom_ram_no_delay_ss\55-openroad-stapostpnr\max_ss_125C_4v50\checks.rpt | 357
slew | _2700_ | _6233_/A2 | _6231_ | gf180mcu_fd_sc_mcu7t5v0__nand2_1 | ZN | 9 | 3.612166 | 3.0 | -0.612166 | 463.68 | 435.12 | 551.6 | 529.2 | other-combinational | asic\runs\etapa12_rom_ram_no_delay_ss\55-openroad-stapostpnr\max_ss_125C_4v50\checks.rpt | 358
slew | _2700_ | _6321_/A2 | _6231_ | gf180mcu_fd_sc_mcu7t5v0__nand2_1 | ZN | 9 | 3.612154 | 3.0 | -0.612154 | 463.68 | 435.12 | 560.0 | 505.68 | other-combinational | asic\runs\etapa12_rom_ram_no_delay_ss\55-openroad-stapostpnr\max_ss_125C_4v50\checks.rpt | 359
slew | _2700_ | _6403_/A1 | _6231_ | gf180mcu_fd_sc_mcu7t5v0__nand2_1 | ZN | 9 | 3.61215 | 3.0 | -0.612151 | 463.68 | 435.12 | 553.28 | 501.76 | other-combinational | asic\runs\etapa12_rom_ram_no_delay_ss\55-openroad-stapostpnr\max_ss_125C_4v50\checks.rpt | 360
slew | _2700_ | _6683_/A1 | _6231_ | gf180mcu_fd_sc_mcu7t5v0__nand2_1 | ZN | 9 | 3.612118 | 3.0 | -0.612118 | 463.68 | 435.12 | 549.36 | 439.04 | other-combinational | asic\runs\etapa12_rom_ram_no_delay_ss\55-openroad-stapostpnr\max_ss_125C_4v50\checks.rpt | 361
slew | _2700_ | _6703_/B1 | _6231_ | gf180mcu_fd_sc_mcu7t5v0__nand2_1 | ZN | 9 | 3.612118 | 3.0 | -0.612118 | 463.68 | 435.12 | 546.0 | 431.2 | other-combinational | asic\runs\etapa12_rom_ram_no_delay_ss\55-openroad-stapostpnr\max_ss_125C_4v50\checks.rpt | 362
slew | _2700_ | _6316_/A2 | _6231_ | gf180mcu_fd_sc_mcu7t5v0__nand2_1 | ZN | 9 | 3.612096 | 3.0 | -0.612096 | 463.68 | 435.12 | 493.36 | 435.12 | other-combinational | asic\runs\etapa12_rom_ram_no_delay_ss\55-openroad-stapostpnr\max_ss_125C_4v50\checks.rpt | 363
slew | _2700_ | _6249_/A2 | _6231_ | gf180mcu_fd_sc_mcu7t5v0__nand2_1 | ZN | 9 | 3.61209 | 3.0 | -0.61209 | 463.68 | 435.12 | 486.08 | 442.96 | other-combinational | asic\runs\etapa12_rom_ram_no_delay_ss\55-openroad-stapostpnr\max_ss_125C_4v50\checks.rpt | 364
slew | _2700_ | _6231_/ZN | _6231_ | gf180mcu_fd_sc_mcu7t5v0__nand2_1 | ZN | 9 | 3.612076 | 3.0 | -0.612076 | 463.68 | 435.12 | 463.68 | 435.12 | other-combinational | asic\runs\etapa12_rom_ram_no_delay_ss\55-openroad-stapostpnr\max_ss_125C_4v50\checks.rpt | 365
slew | _2700_ | _6424_/A3 | _6231_ | gf180mcu_fd_sc_mcu7t5v0__nand2_1 | ZN | 9 | 3.612076 | 3.0 | -0.612076 | 463.68 | 435.12 | 450.8 | 478.24 | other-combinational | asic\runs\etapa12_rom_ram_no_delay_ss\55-openroad-stapostpnr\max_ss_125C_4v50\checks.rpt | 366
slew | _0965_ | _4348_/ZN | _4348_ | gf180mcu_fd_sc_mcu7t5v0__nand4_1 | ZN | 6 | 3.580273 | 3.0 | -0.580273 | 439.04 | 364.56 | 439.04 | 364.56 | instruction/ROM/fetch | asic\runs\etapa12_rom_ram_no_delay_ss\55-openroad-stapostpnr\max_ss_125C_4v50\checks.rpt | 367
slew | _0965_ | _4349_/A2 | _4348_ | gf180mcu_fd_sc_mcu7t5v0__nand4_1 | ZN | 6 | 3.580273 | 3.0 | -0.580273 | 439.04 | 364.56 | 444.08 | 348.88 | instruction/ROM/fetch | asic\runs\etapa12_rom_ram_no_delay_ss\55-openroad-stapostpnr\max_ss_125C_4v50\checks.rpt | 368
slew | _0965_ | _4360_/A2 | _4348_ | gf180mcu_fd_sc_mcu7t5v0__nand4_1 | ZN | 6 | 3.580273 | 3.0 | -0.580273 | 439.04 | 364.56 | 440.72 | 231.28 | instruction/ROM/fetch | asic\runs\etapa12_rom_ram_no_delay_ss\55-openroad-stapostpnr\max_ss_125C_4v50\checks.rpt | 369
slew | _0965_ | _4391_/A2 | _4348_ | gf180mcu_fd_sc_mcu7t5v0__nand4_1 | ZN | 6 | 3.580273 | 3.0 | -0.580273 | 439.04 | 364.56 | 442.4 | 219.52 | instruction/ROM/fetch | asic\runs\etapa12_rom_ram_no_delay_ss\55-openroad-stapostpnr\max_ss_125C_4v50\checks.rpt | 370
slew | _0965_ | _4438_/A2 | _4348_ | gf180mcu_fd_sc_mcu7t5v0__nand4_1 | ZN | 6 | 3.580273 | 3.0 | -0.580273 | 439.04 | 364.56 | 418.88 | 317.52 | instruction/ROM/fetch | asic\runs\etapa12_rom_ram_no_delay_ss\55-openroad-stapostpnr\max_ss_125C_4v50\checks.rpt | 371
slew | _0965_ | _4463_/A2 | _4348_ | gf180mcu_fd_sc_mcu7t5v0__nand4_1 | ZN | 6 | 3.580273 | 3.0 | -0.580273 | 439.04 | 364.56 | 421.12 | 239.12 | instruction/ROM/fetch | asic\runs\etapa12_rom_ram_no_delay_ss\55-openroad-stapostpnr\max_ss_125C_4v50\checks.rpt | 372
slew | _0965_ | _6749_/A2 | _4348_ | gf180mcu_fd_sc_mcu7t5v0__nand4_1 | ZN | 6 | 3.580273 | 3.0 | -0.580273 | 439.04 | 364.56 | 444.08 | 231.28 | instruction/ROM/fetch | asic\runs\etapa12_rom_ram_no_delay_ss\55-openroad-stapostpnr\max_ss_125C_4v50\checks.rpt | 373
slew | _1563_ | fanout745/I | _4981_ | gf180mcu_fd_sc_mcu7t5v0__nor2_1 | ZN | 2 | 3.570826 | 3.0 | -0.570826 | 277.76 | 380.24 | 274.4 | 509.6 | instruction/ROM/fetch | asic\runs\etapa12_rom_ram_no_delay_ss\55-openroad-stapostpnr\max_ss_125C_4v50\checks.rpt | 374
slew | _1563_ | _4981_/ZN | _4981_ | gf180mcu_fd_sc_mcu7t5v0__nor2_1 | ZN | 2 | 3.5708 | 3.0 | -0.570801 | 277.76 | 380.24 | 277.76 | 380.24 | instruction/ROM/fetch | asic\runs\etapa12_rom_ram_no_delay_ss\55-openroad-stapostpnr\max_ss_125C_4v50\checks.rpt | 375
slew | _1563_ | wire749/I | _4981_ | gf180mcu_fd_sc_mcu7t5v0__nor2_1 | ZN | 2 | 3.5708 | 3.0 | -0.570801 | 277.76 | 380.24 | 269.36 | 364.56 | instruction/ROM/fetch | asic\runs\etapa12_rom_ram_no_delay_ss\55-openroad-stapostpnr\max_ss_125C_4v50\checks.rpt | 376
slew | \u_pochoco_soc.genblk1.g_rom_ram_memory.u_ram.a_rdata_o[7] | _4464_/A2 | _8474_ | gf180mcu_fd_sc_mcu7t5v0__dffrnq_1 | Q | 9 | 3.547829 | 3.0 | -0.547829 | 407.12 | 482.16 | 420.56 | 243.04 | instruction/ROM/fetch | asic\runs\etapa12_rom_ram_no_delay_ss\55-openroad-stapostpnr\max_ss_125C_4v50\checks.rpt | 377
slew | \u_pochoco_soc.genblk1.g_rom_ram_memory.u_ram.a_rdata_o[7] | _5931_/A1 | _8474_ | gf180mcu_fd_sc_mcu7t5v0__dffrnq_1 | Q | 9 | 3.547823 | 3.0 | -0.547823 | 407.12 | 482.16 | 379.68 | 348.88 | instruction/ROM/fetch | asic\runs\etapa12_rom_ram_no_delay_ss\55-openroad-stapostpnr\max_ss_125C_4v50\checks.rpt | 378
slew | \u_pochoco_soc.genblk1.g_rom_ram_memory.u_ram.a_rdata_o[7] | _7448_/A2 | _8474_ | gf180mcu_fd_sc_mcu7t5v0__dffrnq_1 | Q | 9 | 3.547808 | 3.0 | -0.547808 | 407.12 | 482.16 | 264.32 | 466.48 | instruction/ROM/fetch | asic\runs\etapa12_rom_ram_no_delay_ss\55-openroad-stapostpnr\max_ss_125C_4v50\checks.rpt | 379
slew | \u_pochoco_soc.genblk1.g_rom_ram_memory.u_ram.a_rdata_o[7] | _7972_/A2 | _8474_ | gf180mcu_fd_sc_mcu7t5v0__dffrnq_1 | Q | 9 | 3.547808 | 3.0 | -0.547808 | 407.12 | 482.16 | 260.4 | 466.48 | instruction/ROM/fetch | asic\runs\etapa12_rom_ram_no_delay_ss\55-openroad-stapostpnr\max_ss_125C_4v50\checks.rpt | 380
slew | \u_pochoco_soc.genblk1.g_rom_ram_memory.u_ram.a_rdata_o[7] | _7710_/A2 | _8474_ | gf180mcu_fd_sc_mcu7t5v0__dffrnq_1 | Q | 9 | 3.547807 | 3.0 | -0.547808 | 407.12 | 482.16 | 265.44 | 470.4 | instruction/ROM/fetch | asic\runs\etapa12_rom_ram_no_delay_ss\55-openroad-stapostpnr\max_ss_125C_4v50\checks.rpt | 381
slew | \u_pochoco_soc.genblk1.g_rom_ram_memory.u_ram.a_rdata_o[7] | _7252_/A2 | _8474_ | gf180mcu_fd_sc_mcu7t5v0__dffrnq_1 | Q | 9 | 3.547807 | 3.0 | -0.547807 | 407.12 | 482.16 | 269.36 | 470.4 | instruction/ROM/fetch | asic\runs\etapa12_rom_ram_no_delay_ss\55-openroad-stapostpnr\max_ss_125C_4v50\checks.rpt | 382
slew | \u_pochoco_soc.genblk1.g_rom_ram_memory.u_ram.a_rdata_o[7] | _7185_/A2 | _8474_ | gf180mcu_fd_sc_mcu7t5v0__dffrnq_1 | Q | 9 | 3.547806 | 3.0 | -0.547806 | 407.12 | 482.16 | 271.04 | 474.32 | instruction/ROM/fetch | asic\runs\etapa12_rom_ram_no_delay_ss\55-openroad-stapostpnr\max_ss_125C_4v50\checks.rpt | 383
slew | \u_pochoco_soc.genblk1.g_rom_ram_memory.u_ram.a_rdata_o[7] | _4242_/I | _8474_ | gf180mcu_fd_sc_mcu7t5v0__dffrnq_1 | Q | 9 | 3.547793 | 3.0 | -0.547794 | 407.12 | 482.16 | 419.44 | 478.24 | instruction/ROM/fetch | asic\runs\etapa12_rom_ram_no_delay_ss\55-openroad-stapostpnr\max_ss_125C_4v50\checks.rpt | 384
slew | \u_pochoco_soc.genblk1.g_rom_ram_memory.u_ram.a_rdata_o[7] | _6861_/A2 | _8474_ | gf180mcu_fd_sc_mcu7t5v0__dffrnq_1 | Q | 9 | 3.547793 | 3.0 | -0.547794 | 407.12 | 482.16 | 406.0 | 466.48 | instruction/ROM/fetch | asic\runs\etapa12_rom_ram_no_delay_ss\55-openroad-stapostpnr\max_ss_125C_4v50\checks.rpt | 385
slew | \u_pochoco_soc.genblk1.g_rom_ram_memory.u_ram.a_rdata_o[7] | _8474_/Q | _8474_ | gf180mcu_fd_sc_mcu7t5v0__dffrnq_1 | Q | 9 | 3.547793 | 3.0 | -0.547794 | 407.12 | 482.16 | 407.12 | 482.16 | instruction/ROM/fetch | asic\runs\etapa12_rom_ram_no_delay_ss\55-openroad-stapostpnr\max_ss_125C_4v50\checks.rpt | 386
slew | _2796_ | _6629_/A2 | _6330_ | gf180mcu_fd_sc_mcu7t5v0__nor2_1 | ZN | 5 | 3.544996 | 3.0 | -0.544996 | 568.4 | 435.12 | 546.0 | 552.72 | other-combinational | asic\runs\etapa12_rom_ram_no_delay_ss\55-openroad-stapostpnr\max_ss_125C_4v50\checks.rpt | 387
slew | _2796_ | _6332_/A2 | _6330_ | gf180mcu_fd_sc_mcu7t5v0__nor2_1 | ZN | 5 | 3.544995 | 3.0 | -0.544995 | 568.4 | 435.12 | 553.84 | 533.12 | other-combinational | asic\runs\etapa12_rom_ram_no_delay_ss\55-openroad-stapostpnr\max_ss_125C_4v50\checks.rpt | 388
slew | _2796_ | _6421_/A2 | _6330_ | gf180mcu_fd_sc_mcu7t5v0__nor2_1 | ZN | 5 | 3.544992 | 3.0 | -0.544992 | 568.4 | 435.12 | 581.84 | 513.52 | other-combinational | asic\runs\etapa12_rom_ram_no_delay_ss\55-openroad-stapostpnr\max_ss_125C_4v50\checks.rpt | 389
slew | _2796_ | _6330_/ZN | _6330_ | gf180mcu_fd_sc_mcu7t5v0__nor2_1 | ZN | 5 | 3.544977 | 3.0 | -0.544977 | 568.4 | 435.12 | 568.4 | 435.12 | other-combinational | asic\runs\etapa12_rom_ram_no_delay_ss\55-openroad-stapostpnr\max_ss_125C_4v50\checks.rpt | 390
slew | _2796_ | _6510_/A2 | _6330_ | gf180mcu_fd_sc_mcu7t5v0__nor2_1 | ZN | 5 | 3.544977 | 3.0 | -0.544977 | 568.4 | 435.12 | 544.88 | 439.04 | other-combinational | asic\runs\etapa12_rom_ram_no_delay_ss\55-openroad-stapostpnr\max_ss_125C_4v50\checks.rpt | 391
slew | _2796_ | _6696_/A3 | _6330_ | gf180mcu_fd_sc_mcu7t5v0__nor2_1 | ZN | 5 | 3.544977 | 3.0 | -0.544977 | 568.4 | 435.12 | 563.36 | 435.12 | other-combinational | asic\runs\etapa12_rom_ram_no_delay_ss\55-openroad-stapostpnr\max_ss_125C_4v50\checks.rpt | 392
slew | _1502_ | _6052_/A1 | _4887_ | gf180mcu_fd_sc_mcu7t5v0__oai211_1 | ZN | 3 | 3.525425 | 3.0 | -0.525425 | 322.56 | 274.4 | 360.64 | 458.64 | instruction/ROM/fetch+data-memory+register-file | asic\runs\etapa12_rom_ram_no_delay_ss\55-openroad-stapostpnr\max_ss_125C_4v50\checks.rpt | 393
slew | _1502_ | _7102_/A2 | _4887_ | gf180mcu_fd_sc_mcu7t5v0__oai211_1 | ZN | 3 | 3.52542 | 3.0 | -0.525421 | 322.56 | 274.4 | 354.48 | 392.0 | instruction/ROM/fetch+data-memory+register-file | asic\runs\etapa12_rom_ram_no_delay_ss\55-openroad-stapostpnr\max_ss_125C_4v50\checks.rpt | 394
slew | _1502_ | _4887_/ZN | _4887_ | gf180mcu_fd_sc_mcu7t5v0__oai211_1 | ZN | 3 | 3.525403 | 3.0 | -0.525403 | 322.56 | 274.4 | 322.56 | 274.4 | instruction/ROM/fetch+data-memory+register-file | asic\runs\etapa12_rom_ram_no_delay_ss\55-openroad-stapostpnr\max_ss_125C_4v50\checks.rpt | 395
slew | _1502_ | _4894_/A3 | _4887_ | gf180mcu_fd_sc_mcu7t5v0__oai211_1 | ZN | 3 | 3.525403 | 3.0 | -0.525403 | 322.56 | 274.4 | 350.56 | 341.04 | instruction/ROM/fetch+data-memory+register-file | asic\runs\etapa12_rom_ram_no_delay_ss\55-openroad-stapostpnr\max_ss_125C_4v50\checks.rpt | 396
slew | _3482_ | fanout70/I | _7094_ | gf180mcu_fd_sc_mcu7t5v0__nor2_1 | ZN | 2 | 3.518404 | 3.0 | -0.518404 | 365.12 | 207.76 | 128.8 | 215.6 | instruction/ROM/fetch+data-memory+register-file+peripheral | asic\runs\etapa12_rom_ram_no_delay_ss\55-openroad-stapostpnr\max_ss_125C_4v50\checks.rpt | 397
slew | _3482_ | fanout68/I | _7094_ | gf180mcu_fd_sc_mcu7t5v0__nor2_1 | ZN | 2 | 3.518403 | 3.0 | -0.518403 | 365.12 | 207.76 | 138.88 | 199.92 | instruction/ROM/fetch+data-memory+register-file+peripheral | asic\runs\etapa12_rom_ram_no_delay_ss\55-openroad-stapostpnr\max_ss_125C_4v50\checks.rpt | 398
slew | _3482_ | _7094_/ZN | _7094_ | gf180mcu_fd_sc_mcu7t5v0__nor2_1 | ZN | 2 | 3.518384 | 3.0 | -0.518384 | 365.12 | 207.76 | 365.12 | 207.76 | instruction/ROM/fetch+data-memory+register-file+peripheral | asic\runs\etapa12_rom_ram_no_delay_ss\55-openroad-stapostpnr\max_ss_125C_4v50\checks.rpt | 399
slew | _3541_ | fanout38/I | _7162_ | gf180mcu_fd_sc_mcu7t5v0__aoi221_2 | ZN | 2 | 3.500185 | 3.0 | -0.500185 | 318.08 | 376.32 | 217.84 | 525.28 | instruction/ROM/fetch+data-memory+register-file+peripheral | asic\runs\etapa12_rom_ram_no_delay_ss\55-openroad-stapostpnr\max_ss_125C_4v50\checks.rpt | 400
slew | _3541_ | fanout36/I | _7162_ | gf180mcu_fd_sc_mcu7t5v0__aoi221_2 | ZN | 2 | 3.500184 | 3.0 | -0.500184 | 318.08 | 376.32 | 238.56 | 466.48 | instruction/ROM/fetch+data-memory+register-file+peripheral | asic\runs\etapa12_rom_ram_no_delay_ss\55-openroad-stapostpnr\max_ss_125C_4v50\checks.rpt | 401
slew | _3541_ | _7162_/ZN | _7162_ | gf180mcu_fd_sc_mcu7t5v0__aoi221_2 | ZN | 2 | 3.500182 | 3.0 | -0.500182 | 318.08 | 376.32 | 318.08 | 376.32 | instruction/ROM/fetch+data-memory+register-file+peripheral | asic\runs\etapa12_rom_ram_no_delay_ss\55-openroad-stapostpnr\max_ss_125C_4v50\checks.rpt | 402
slew | _3322_ | fanout133/I | _6918_ | gf180mcu_fd_sc_mcu7t5v0__aoi211_2 | ZN | 2 | 3.498887 | 3.0 | -0.498887 | 462.0 | 192.08 | 243.04 | 121.52 | instruction/ROM/fetch+data-memory+register-file+peripheral | asic\runs\etapa12_rom_ram_no_delay_ss\55-openroad-stapostpnr\max_ss_125C_4v50\checks.rpt | 403
slew | _3322_ | fanout135/I | _6918_ | gf180mcu_fd_sc_mcu7t5v0__aoi211_2 | ZN | 2 | 3.498887 | 3.0 | -0.498887 | 462.0 | 192.08 | 224.56 | 141.12 | instruction/ROM/fetch+data-memory+register-file+peripheral | asic\runs\etapa12_rom_ram_no_delay_ss\55-openroad-stapostpnr\max_ss_125C_4v50\checks.rpt | 404
slew | _3322_ | _6918_/ZN | _6918_ | gf180mcu_fd_sc_mcu7t5v0__aoi211_2 | ZN | 2 | 3.498884 | 3.0 | -0.498884 | 462.0 | 192.08 | 462.0 | 192.08 | instruction/ROM/fetch+data-memory+register-file+peripheral | asic\runs\etapa12_rom_ram_no_delay_ss\55-openroad-stapostpnr\max_ss_125C_4v50\checks.rpt | 405
slew | _3543_ | _7165_/ZN | _7165_ | gf180mcu_fd_sc_mcu7t5v0__aoi221_1 | ZN | 1 | 3.471737 | 3.0 | -0.471737 | 353.36 | 199.92 | 353.36 | 199.92 | instruction/ROM/fetch+data-memory+register-file+peripheral | asic\runs\etapa12_rom_ram_no_delay_ss\55-openroad-stapostpnr\max_ss_125C_4v50\checks.rpt | 406
slew | _3543_ | _7169_/B1 | _7165_ | gf180mcu_fd_sc_mcu7t5v0__aoi221_1 | ZN | 1 | 3.471737 | 3.0 | -0.471737 | 353.36 | 199.92 | 329.28 | 360.64 | instruction/ROM/fetch+data-memory+register-file+peripheral | asic\runs\etapa12_rom_ram_no_delay_ss\55-openroad-stapostpnr\max_ss_125C_4v50\checks.rpt | 407
slew | _3485_ | _7102_/B | _7098_ | gf180mcu_fd_sc_mcu7t5v0__aoi21_1 | ZN | 1 | 3.452349 | 3.0 | -0.452349 | 384.16 | 192.08 | 354.48 | 392.0 | instruction/ROM/fetch+data-memory+register-file+peripheral | asic\runs\etapa12_rom_ram_no_delay_ss\55-openroad-stapostpnr\max_ss_125C_4v50\checks.rpt | 408
slew | _3485_ | _7098_/ZN | _7098_ | gf180mcu_fd_sc_mcu7t5v0__aoi21_1 | ZN | 1 | 3.452348 | 3.0 | -0.452348 | 384.16 | 192.08 | 384.16 | 192.08 | instruction/ROM/fetch+data-memory+register-file+peripheral | asic\runs\etapa12_rom_ram_no_delay_ss\55-openroad-stapostpnr\max_ss_125C_4v50\checks.rpt | 409
slew | net943 | _5813_/S | fanout943 | gf180mcu_fd_sc_mcu7t5v0__buf_1 | Z | 10 | 3.443901 | 3.0 | -0.443901 | 569.52 | 399.84 | 497.84 | 384.16 | other-combinational | asic\runs\etapa12_rom_ram_no_delay_ss\55-openroad-stapostpnr\max_ss_125C_4v50\checks.rpt | 410
slew | net943 | _6293_/A1 | fanout943 | gf180mcu_fd_sc_mcu7t5v0__buf_1 | Z | 10 | 3.443887 | 3.0 | -0.443887 | 569.52 | 399.84 | 500.64 | 454.72 | other-combinational | asic\runs\etapa12_rom_ram_no_delay_ss\55-openroad-stapostpnr\max_ss_125C_4v50\checks.rpt | 411
slew | net943 | _5817_/A2 | fanout943 | gf180mcu_fd_sc_mcu7t5v0__buf_1 | Z | 10 | 3.443885 | 3.0 | -0.443885 | 569.52 | 399.84 | 502.32 | 493.92 | other-combinational | asic\runs\etapa12_rom_ram_no_delay_ss\55-openroad-stapostpnr\max_ss_125C_4v50\checks.rpt | 412
slew | net943 | _6288_/A2 | fanout943 | gf180mcu_fd_sc_mcu7t5v0__buf_1 | Z | 10 | 3.443863 | 3.0 | -0.443863 | 569.52 | 399.84 | 521.92 | 466.48 | other-combinational | asic\runs\etapa12_rom_ram_no_delay_ss\55-openroad-stapostpnr\max_ss_125C_4v50\checks.rpt | 413
slew | net943 | _6240_/A2 | fanout943 | gf180mcu_fd_sc_mcu7t5v0__buf_1 | Z | 10 | 3.443835 | 3.0 | -0.443835 | 569.52 | 399.84 | 565.6 | 490.0 | other-combinational | asic\runs\etapa12_rom_ram_no_delay_ss\55-openroad-stapostpnr\max_ss_125C_4v50\checks.rpt | 414
slew | net943 | _5832_/A2 | fanout943 | gf180mcu_fd_sc_mcu7t5v0__buf_1 | Z | 10 | 3.443812 | 3.0 | -0.443812 | 569.52 | 399.84 | 571.76 | 435.12 | other-combinational | asic\runs\etapa12_rom_ram_no_delay_ss\55-openroad-stapostpnr\max_ss_125C_4v50\checks.rpt | 415
slew | net943 | _5850_/A2 | fanout943 | gf180mcu_fd_sc_mcu7t5v0__buf_1 | Z | 10 | 3.443812 | 3.0 | -0.443812 | 569.52 | 399.84 | 566.16 | 399.84 | other-combinational | asic\runs\etapa12_rom_ram_no_delay_ss\55-openroad-stapostpnr\max_ss_125C_4v50\checks.rpt | 416
slew | net943 | _6221_/A2 | fanout943 | gf180mcu_fd_sc_mcu7t5v0__buf_1 | Z | 10 | 3.443812 | 3.0 | -0.443812 | 569.52 | 399.84 | 571.76 | 446.88 | other-combinational | asic\runs\etapa12_rom_ram_no_delay_ss\55-openroad-stapostpnr\max_ss_125C_4v50\checks.rpt | 417
slew | net943 | _6243_/A2 | fanout943 | gf180mcu_fd_sc_mcu7t5v0__buf_1 | Z | 10 | 3.443812 | 3.0 | -0.443812 | 569.52 | 399.84 | 571.2 | 439.04 | other-combinational | asic\runs\etapa12_rom_ram_no_delay_ss\55-openroad-stapostpnr\max_ss_125C_4v50\checks.rpt | 418
slew | net943 | _6708_/A1 | fanout943 | gf180mcu_fd_sc_mcu7t5v0__buf_1 | Z | 10 | 3.443812 | 3.0 | -0.443812 | 569.52 | 399.84 | 552.72 | 407.68 | other-combinational | asic\runs\etapa12_rom_ram_no_delay_ss\55-openroad-stapostpnr\max_ss_125C_4v50\checks.rpt | 419
slew | net943 | fanout943/Z | fanout943 | gf180mcu_fd_sc_mcu7t5v0__buf_1 | Z | 10 | 3.443812 | 3.0 | -0.443812 | 569.52 | 399.84 | 569.52 | 399.84 | other-combinational | asic\runs\etapa12_rom_ram_no_delay_ss\55-openroad-stapostpnr\max_ss_125C_4v50\checks.rpt | 420
slew | _3399_ | _7000_/ZN | _7000_ | gf180mcu_fd_sc_mcu7t5v0__oai32_1 | ZN | 1 | 3.431994 | 3.0 | -0.431994 | 481.6 | 258.72 | 481.6 | 258.72 | instruction/ROM/fetch+data-memory+register-file | asic\runs\etapa12_rom_ram_no_delay_ss\55-openroad-stapostpnr\max_ss_125C_4v50\checks.rpt | 421
slew | _3399_ | _7001_/B | _7000_ | gf180mcu_fd_sc_mcu7t5v0__oai32_1 | ZN | 1 | 3.431994 | 3.0 | -0.431994 | 481.6 | 258.72 | 433.44 | 203.84 | instruction/ROM/fetch+data-memory+register-file | asic\runs\etapa12_rom_ram_no_delay_ss\55-openroad-stapostpnr\max_ss_125C_4v50\checks.rpt | 422
slew | _3298_ | fanout113/I | _6892_ | gf180mcu_fd_sc_mcu7t5v0__aoi221_2 | ZN | 2 | 3.429913 | 3.0 | -0.429913 | 444.64 | 188.16 | 293.44 | 105.84 | instruction/ROM/fetch+data-memory+register-file+peripheral | asic\runs\etapa12_rom_ram_no_delay_ss\55-openroad-stapostpnr\max_ss_125C_4v50\checks.rpt | 423
slew | _3298_ | fanout115/I | _6892_ | gf180mcu_fd_sc_mcu7t5v0__aoi221_2 | ZN | 2 | 3.429913 | 3.0 | -0.429913 | 444.64 | 188.16 | 297.36 | 94.08 | instruction/ROM/fetch+data-memory+register-file+peripheral | asic\runs\etapa12_rom_ram_no_delay_ss\55-openroad-stapostpnr\max_ss_125C_4v50\checks.rpt | 424
slew | _3298_ | _6892_/ZN | _6892_ | gf180mcu_fd_sc_mcu7t5v0__aoi221_2 | ZN | 2 | 3.429912 | 3.0 | -0.429912 | 444.64 | 188.16 | 444.64 | 188.16 | instruction/ROM/fetch+data-memory+register-file+peripheral | asic\runs\etapa12_rom_ram_no_delay_ss\55-openroad-stapostpnr\max_ss_125C_4v50\checks.rpt | 425
slew | _1482_ | _4867_/ZN | _4867_ | gf180mcu_fd_sc_mcu7t5v0__aoi21_1 | ZN | 4 | 3.410597 | 3.0 | -0.410597 | 508.48 | 258.72 | 508.48 | 258.72 | instruction/ROM/fetch+data-memory+register-file | asic\runs\etapa12_rom_ram_no_delay_ss\55-openroad-stapostpnr\max_ss_125C_4v50\checks.rpt | 426
slew | _1482_ | _4880_/A1 | _4867_ | gf180mcu_fd_sc_mcu7t5v0__aoi21_1 | ZN | 4 | 3.410597 | 3.0 | -0.410597 | 508.48 | 258.72 | 433.44 | 317.52 | instruction/ROM/fetch+data-memory+register-file | asic\runs\etapa12_rom_ram_no_delay_ss\55-openroad-stapostpnr\max_ss_125C_4v50\checks.rpt | 427
slew | _1482_ | _5883_/A1 | _4867_ | gf180mcu_fd_sc_mcu7t5v0__aoi21_1 | ZN | 4 | 3.410597 | 3.0 | -0.410597 | 508.48 | 258.72 | 537.04 | 321.44 | instruction/ROM/fetch+data-memory+register-file | asic\runs\etapa12_rom_ram_no_delay_ss\55-openroad-stapostpnr\max_ss_125C_4v50\checks.rpt | 428
slew | _1482_ | _6988_/A2 | _4867_ | gf180mcu_fd_sc_mcu7t5v0__aoi21_1 | ZN | 4 | 3.410597 | 3.0 | -0.410597 | 508.48 | 258.72 | 472.64 | 254.8 | instruction/ROM/fetch+data-memory+register-file | asic\runs\etapa12_rom_ram_no_delay_ss\55-openroad-stapostpnr\max_ss_125C_4v50\checks.rpt | 429
slew | _1482_ | _8150_/A2 | _4867_ | gf180mcu_fd_sc_mcu7t5v0__aoi21_1 | ZN | 4 | 3.410597 | 3.0 | -0.410597 | 508.48 | 258.72 | 505.12 | 294.0 | instruction/ROM/fetch+data-memory+register-file | asic\runs\etapa12_rom_ram_no_delay_ss\55-openroad-stapostpnr\max_ss_125C_4v50\checks.rpt | 430
slew | _3559_ | fanout27/I | _7183_ | gf180mcu_fd_sc_mcu7t5v0__aoi21_1 | ZN | 2 | 3.362193 | 3.0 | -0.362193 | 341.6 | 227.36 | 77.84 | 231.28 | instruction/ROM/fetch+data-memory+register-file+peripheral | asic\runs\etapa12_rom_ram_no_delay_ss\55-openroad-stapostpnr\max_ss_125C_4v50\checks.rpt | 431
slew | _3559_ | fanout29/I | _7183_ | gf180mcu_fd_sc_mcu7t5v0__aoi21_1 | ZN | 2 | 3.362192 | 3.0 | -0.362193 | 341.6 | 227.36 | 118.72 | 231.28 | instruction/ROM/fetch+data-memory+register-file+peripheral | asic\runs\etapa12_rom_ram_no_delay_ss\55-openroad-stapostpnr\max_ss_125C_4v50\checks.rpt | 432
slew | _3559_ | _7183_/ZN | _7183_ | gf180mcu_fd_sc_mcu7t5v0__aoi21_1 | ZN | 2 | 3.362191 | 3.0 | -0.362191 | 341.6 | 227.36 | 341.6 | 227.36 | instruction/ROM/fetch+data-memory+register-file+peripheral | asic\runs\etapa12_rom_ram_no_delay_ss\55-openroad-stapostpnr\max_ss_125C_4v50\checks.rpt | 433
slew | \u_pochoco_soc.data_wdata[6] | _4499_/A1 | _9251_ | gf180mcu_fd_sc_mcu7t5v0__dffrnq_1 | Q | 6 | 3.340474 | 3.0 | -0.340474 | 255.92 | 301.84 | 517.44 | 301.84 | data-memory | asic\runs\etapa12_rom_ram_no_delay_ss\55-openroad-stapostpnr\max_ss_125C_4v50\checks.rpt | 434
slew | \u_pochoco_soc.data_wdata[6] | _8388_/I0 | _9251_ | gf180mcu_fd_sc_mcu7t5v0__dffrnq_1 | Q | 6 | 3.340457 | 3.0 | -0.340457 | 255.92 | 301.84 | 527.52 | 250.88 | data-memory | asic\runs\etapa12_rom_ram_no_delay_ss\55-openroad-stapostpnr\max_ss_125C_4v50\checks.rpt | 435
slew | \u_pochoco_soc.data_wdata[6] | _8273_/I0 | _9251_ | gf180mcu_fd_sc_mcu7t5v0__dffrnq_1 | Q | 6 | 3.340438 | 3.0 | -0.340438 | 255.92 | 301.84 | 524.16 | 203.84 | data-memory | asic\runs\etapa12_rom_ram_no_delay_ss\55-openroad-stapostpnr\max_ss_125C_4v50\checks.rpt | 436
slew | \u_pochoco_soc.data_wdata[6] | _6858_/I1 | _9251_ | gf180mcu_fd_sc_mcu7t5v0__dffrnq_1 | Q | 6 | 3.340382 | 3.0 | -0.340382 | 255.92 | 301.84 | 468.72 | 160.72 | data-memory | asic\runs\etapa12_rom_ram_no_delay_ss\55-openroad-stapostpnr\max_ss_125C_4v50\checks.rpt | 437
slew | \u_pochoco_soc.data_wdata[6] | _6796_/A1 | _9251_ | gf180mcu_fd_sc_mcu7t5v0__dffrnq_1 | Q | 6 | 3.340321 | 3.0 | -0.340321 | 255.92 | 301.84 | 380.24 | 172.48 | data-memory | asic\runs\etapa12_rom_ram_no_delay_ss\55-openroad-stapostpnr\max_ss_125C_4v50\checks.rpt | 438
slew | \u_pochoco_soc.data_wdata[6] | _6795_/A1 | _9251_ | gf180mcu_fd_sc_mcu7t5v0__dffrnq_1 | Q | 6 | 3.340276 | 3.0 | -0.340276 | 255.92 | 301.84 | 308.0 | 160.72 | data-memory | asic\runs\etapa12_rom_ram_no_delay_ss\55-openroad-stapostpnr\max_ss_125C_4v50\checks.rpt | 439
slew | \u_pochoco_soc.data_wdata[6] | _9251_/Q | _9251_ | gf180mcu_fd_sc_mcu7t5v0__dffrnq_1 | Q | 6 | 3.3402 | 3.0 | -0.3402 | 255.92 | 301.84 | 255.92 | 301.84 | data-memory | asic\runs\etapa12_rom_ram_no_delay_ss\55-openroad-stapostpnr\max_ss_125C_4v50\checks.rpt | 440
slew | net286 | fanout277/I | fanout286 | gf180mcu_fd_sc_mcu7t5v0__buf_1 | Z | 5 | 3.321674 | 3.0 | -0.321674 | 264.88 | 490.0 | 262.64 | 243.04 | instruction/ROM/fetch | asic\runs\etapa12_rom_ram_no_delay_ss\55-openroad-stapostpnr\max_ss_125C_4v50\checks.rpt | 441
slew | net286 | fanout279/I | fanout286 | gf180mcu_fd_sc_mcu7t5v0__buf_1 | Z | 5 | 3.321666 | 3.0 | -0.321666 | 264.88 | 490.0 | 39.2 | 442.96 | instruction/ROM/fetch | asic\runs\etapa12_rom_ram_no_delay_ss\55-openroad-stapostpnr\max_ss_125C_4v50\checks.rpt | 442
slew | net286 | fanout281/I | fanout286 | gf180mcu_fd_sc_mcu7t5v0__buf_1 | Z | 5 | 3.32165 | 3.0 | -0.32165 | 264.88 | 490.0 | 149.52 | 482.16 | instruction/ROM/fetch | asic\runs\etapa12_rom_ram_no_delay_ss\55-openroad-stapostpnr\max_ss_125C_4v50\checks.rpt | 443
slew | net286 | fanout285/I | fanout286 | gf180mcu_fd_sc_mcu7t5v0__buf_1 | Z | 5 | 3.321631 | 3.0 | -0.321631 | 264.88 | 490.0 | 228.48 | 462.56 | instruction/ROM/fetch | asic\runs\etapa12_rom_ram_no_delay_ss\55-openroad-stapostpnr\max_ss_125C_4v50\checks.rpt | 444
slew | net286 | fanout283/I | fanout286 | gf180mcu_fd_sc_mcu7t5v0__buf_1 | Z | 5 | 3.321613 | 3.0 | -0.321613 | 264.88 | 490.0 | 263.76 | 486.08 | instruction/ROM/fetch | asic\runs\etapa12_rom_ram_no_delay_ss\55-openroad-stapostpnr\max_ss_125C_4v50\checks.rpt | 445
slew | net286 | fanout286/Z | fanout286 | gf180mcu_fd_sc_mcu7t5v0__buf_1 | Z | 5 | 3.321613 | 3.0 | -0.321613 | 264.88 | 490.0 | 264.88 | 490.0 | instruction/ROM/fetch | asic\runs\etapa12_rom_ram_no_delay_ss\55-openroad-stapostpnr\max_ss_125C_4v50\checks.rpt | 446
slew | net360 | fanout348/I | fanout360 | gf180mcu_fd_sc_mcu7t5v0__buf_1 | Z | 5 | 3.302347 | 3.0 | -0.302347 | 262.64 | 454.72 | 119.28 | 211.68 | instruction/ROM/fetch | asic\runs\etapa12_rom_ram_no_delay_ss\55-openroad-stapostpnr\max_ss_125C_4v50\checks.rpt | 447
slew | net360 | fanout345/I | fanout360 | gf180mcu_fd_sc_mcu7t5v0__buf_1 | Z | 5 | 3.302338 | 3.0 | -0.302338 | 262.64 | 454.72 | 139.44 | 266.56 | instruction/ROM/fetch | asic\runs\etapa12_rom_ram_no_delay_ss\55-openroad-stapostpnr\max_ss_125C_4v50\checks.rpt | 448
slew | net360 | fanout349/I | fanout360 | gf180mcu_fd_sc_mcu7t5v0__buf_1 | Z | 5 | 3.302312 | 3.0 | -0.302312 | 262.64 | 454.72 | 266.0 | 129.36 | instruction/ROM/fetch | asic\runs\etapa12_rom_ram_no_delay_ss\55-openroad-stapostpnr\max_ss_125C_4v50\checks.rpt | 449
slew | net360 | fanout351/I | fanout360 | gf180mcu_fd_sc_mcu7t5v0__buf_1 | Z | 5 | 3.302295 | 3.0 | -0.302295 | 262.64 | 454.72 | 224.0 | 250.88 | instruction/ROM/fetch | asic\runs\etapa12_rom_ram_no_delay_ss\55-openroad-stapostpnr\max_ss_125C_4v50\checks.rpt | 450
slew | net360 | fanout358/I | fanout360 | gf180mcu_fd_sc_mcu7t5v0__buf_1 | Z | 5 | 3.302191 | 3.0 | -0.302191 | 262.64 | 454.72 | 237.44 | 454.72 | instruction/ROM/fetch | asic\runs\etapa12_rom_ram_no_delay_ss\55-openroad-stapostpnr\max_ss_125C_4v50\checks.rpt | 451
slew | net360 | fanout360/Z | fanout360 | gf180mcu_fd_sc_mcu7t5v0__buf_1 | Z | 5 | 3.302191 | 3.0 | -0.302191 | 262.64 | 454.72 | 262.64 | 454.72 | instruction/ROM/fetch | asic\runs\etapa12_rom_ram_no_delay_ss\55-openroad-stapostpnr\max_ss_125C_4v50\checks.rpt | 452
slew | _2768_ | _6426_/A3 | _6301_ | gf180mcu_fd_sc_mcu7t5v0__nand2_1 | ZN | 7 | 3.29482 | 3.0 | -0.29482 | 579.6 | 540.96 | 447.44 | 466.48 | other-combinational | asic\runs\etapa12_rom_ram_no_delay_ss\55-openroad-stapostpnr\max_ss_125C_4v50\checks.rpt | 453
slew | _2768_ | _6699_/A1 | _6301_ | gf180mcu_fd_sc_mcu7t5v0__nand2_1 | ZN | 7 | 3.29482 | 3.0 | -0.29482 | 579.6 | 540.96 | 544.32 | 427.28 | other-combinational | asic\runs\etapa12_rom_ram_no_delay_ss\55-openroad-stapostpnr\max_ss_125C_4v50\checks.rpt | 454
slew | _2768_ | _6301_/ZN | _6301_ | gf180mcu_fd_sc_mcu7t5v0__nand2_1 | ZN | 7 | 3.294808 | 3.0 | -0.294808 | 579.6 | 540.96 | 579.6 | 540.96 | other-combinational | asic\runs\etapa12_rom_ram_no_delay_ss\55-openroad-stapostpnr\max_ss_125C_4v50\checks.rpt | 455
slew | _2768_ | _6302_/A3 | _6301_ | gf180mcu_fd_sc_mcu7t5v0__nand2_1 | ZN | 7 | 3.294808 | 3.0 | -0.294808 | 579.6 | 540.96 | 579.04 | 482.16 | other-combinational | asic\runs\etapa12_rom_ram_no_delay_ss\55-openroad-stapostpnr\max_ss_125C_4v50\checks.rpt | 456
slew | _2768_ | _6325_/A2 | _6301_ | gf180mcu_fd_sc_mcu7t5v0__nand2_1 | ZN | 7 | 3.294808 | 3.0 | -0.294808 | 579.6 | 540.96 | 571.76 | 493.92 | other-combinational | asic\runs\etapa12_rom_ram_no_delay_ss\55-openroad-stapostpnr\max_ss_125C_4v50\checks.rpt | 457
slew | _2768_ | _6387_/A4 | _6301_ | gf180mcu_fd_sc_mcu7t5v0__nand2_1 | ZN | 7 | 3.294808 | 3.0 | -0.294808 | 579.6 | 540.96 | 574.56 | 505.68 | other-combinational | asic\runs\etapa12_rom_ram_no_delay_ss\55-openroad-stapostpnr\max_ss_125C_4v50\checks.rpt | 458
slew | _2768_ | _6621_/A1 | _6301_ | gf180mcu_fd_sc_mcu7t5v0__nand2_1 | ZN | 7 | 3.294808 | 3.0 | -0.294808 | 579.6 | 540.96 | 471.52 | 533.12 | other-combinational | asic\runs\etapa12_rom_ram_no_delay_ss\55-openroad-stapostpnr\max_ss_125C_4v50\checks.rpt | 459
slew | _2768_ | _6637_/A1 | _6301_ | gf180mcu_fd_sc_mcu7t5v0__nand2_1 | ZN | 7 | 3.294808 | 3.0 | -0.294808 | 579.6 | 540.96 | 556.08 | 540.96 | other-combinational | asic\runs\etapa12_rom_ram_no_delay_ss\55-openroad-stapostpnr\max_ss_125C_4v50\checks.rpt | 460
slew | _3110_ | _6661_/ZN | _6661_ | gf180mcu_fd_sc_mcu7t5v0__aoi221_1 | ZN | 1 | 3.260094 | 3.0 | -0.260095 | 532.56 | 505.68 | 532.56 | 505.68 | other-combinational | asic\runs\etapa12_rom_ram_no_delay_ss\55-openroad-stapostpnr\max_ss_125C_4v50\checks.rpt | 461
slew | _3110_ | _6662_/B2 | _6661_ | gf180mcu_fd_sc_mcu7t5v0__aoi221_1 | ZN | 1 | 3.260094 | 3.0 | -0.260095 | 532.56 | 505.68 | 458.08 | 435.12 | other-combinational | asic\runs\etapa12_rom_ram_no_delay_ss\55-openroad-stapostpnr\max_ss_125C_4v50\checks.rpt | 462
slew | _0069_ | _9259_/D | _5153_ | gf180mcu_fd_sc_mcu7t5v0__aoi22_1 | ZN | 1 | 3.258775 | 3.0 | -0.258776 | 71.12 | 446.88 | 238.0 | 376.32 | instruction/ROM/fetch+register-file | asic\runs\etapa12_rom_ram_no_delay_ss\55-openroad-stapostpnr\max_ss_125C_4v50\checks.rpt | 463
slew | _0069_ | _5153_/ZN | _5153_ | gf180mcu_fd_sc_mcu7t5v0__aoi22_1 | ZN | 1 | 3.258774 | 3.0 | -0.258774 | 71.12 | 446.88 | 71.12 | 446.88 | instruction/ROM/fetch+register-file | asic\runs\etapa12_rom_ram_no_delay_ss\55-openroad-stapostpnr\max_ss_125C_4v50\checks.rpt | 464
slew | \u_pochoco_soc.genblk1.g_rom_ram_memory.u_ram.a_rdata_o[9] | _6864_/A2 | _8476_ | gf180mcu_fd_sc_mcu7t5v0__dffrnq_1 | Q | 9 | 3.255017 | 3.0 | -0.255017 | 425.04 | 462.56 | 286.72 | 462.56 | instruction/ROM/fetch | asic\runs\etapa12_rom_ram_no_delay_ss\55-openroad-stapostpnr\max_ss_125C_4v50\checks.rpt | 465
slew | \u_pochoco_soc.genblk1.g_rom_ram_memory.u_ram.a_rdata_o[9] | _7382_/A2 | _8476_ | gf180mcu_fd_sc_mcu7t5v0__dffrnq_1 | Q | 9 | 3.255017 | 3.0 | -0.255017 | 425.04 | 462.56 | 283.92 | 466.48 | instruction/ROM/fetch | asic\runs\etapa12_rom_ram_no_delay_ss\55-openroad-stapostpnr\max_ss_125C_4v50\checks.rpt | 466
slew | \u_pochoco_soc.genblk1.g_rom_ram_memory.u_ram.a_rdata_o[9] | _7513_/A2 | _8476_ | gf180mcu_fd_sc_mcu7t5v0__dffrnq_1 | Q | 9 | 3.255017 | 3.0 | -0.255017 | 425.04 | 462.56 | 285.04 | 474.32 | instruction/ROM/fetch | asic\runs\etapa12_rom_ram_no_delay_ss\55-openroad-stapostpnr\max_ss_125C_4v50\checks.rpt | 467
slew | \u_pochoco_soc.genblk1.g_rom_ram_memory.u_ram.a_rdata_o[9] | _7317_/A2 | _8476_ | gf180mcu_fd_sc_mcu7t5v0__dffrnq_1 | Q | 9 | 3.255016 | 3.0 | -0.255016 | 425.04 | 462.56 | 294.0 | 466.48 | instruction/ROM/fetch | asic\runs\etapa12_rom_ram_no_delay_ss\55-openroad-stapostpnr\max_ss_125C_4v50\checks.rpt | 468
slew | \u_pochoco_soc.genblk1.g_rom_ram_memory.u_ram.a_rdata_o[9] | _7775_/A2 | _8476_ | gf180mcu_fd_sc_mcu7t5v0__dffrnq_1 | Q | 9 | 3.255016 | 3.0 | -0.255016 | 425.04 | 462.56 | 288.4 | 466.48 | instruction/ROM/fetch | asic\runs\etapa12_rom_ram_no_delay_ss\55-openroad-stapostpnr\max_ss_125C_4v50\checks.rpt | 469
slew | \u_pochoco_soc.genblk1.g_rom_ram_memory.u_ram.a_rdata_o[9] | _4448_/A1 | _8476_ | gf180mcu_fd_sc_mcu7t5v0__dffrnq_1 | Q | 9 | 3.254993 | 3.0 | -0.254993 | 425.04 | 462.56 | 467.6 | 352.8 | instruction/ROM/fetch | asic\runs\etapa12_rom_ram_no_delay_ss\55-openroad-stapostpnr\max_ss_125C_4v50\checks.rpt | 470
slew | \u_pochoco_soc.genblk1.g_rom_ram_memory.u_ram.a_rdata_o[9] | _5804_/I1 | _8476_ | gf180mcu_fd_sc_mcu7t5v0__dffrnq_1 | Q | 9 | 3.254993 | 3.0 | -0.254993 | 425.04 | 462.56 | 473.2 | 344.96 | instruction/ROM/fetch | asic\runs\etapa12_rom_ram_no_delay_ss\55-openroad-stapostpnr\max_ss_125C_4v50\checks.rpt | 471
slew | \u_pochoco_soc.genblk1.g_rom_ram_memory.u_ram.a_rdata_o[9] | _6444_/A1 | _8476_ | gf180mcu_fd_sc_mcu7t5v0__dffrnq_1 | Q | 9 | 3.254993 | 3.0 | -0.254993 | 425.04 | 462.56 | 444.08 | 462.56 | instruction/ROM/fetch | asic\runs\etapa12_rom_ram_no_delay_ss\55-openroad-stapostpnr\max_ss_125C_4v50\checks.rpt | 472
slew | \u_pochoco_soc.genblk1.g_rom_ram_memory.u_ram.a_rdata_o[9] | _6860_/A2 | _8476_ | gf180mcu_fd_sc_mcu7t5v0__dffrnq_1 | Q | 9 | 3.254993 | 3.0 | -0.254993 | 425.04 | 462.56 | 409.92 | 462.56 | instruction/ROM/fetch | asic\runs\etapa12_rom_ram_no_delay_ss\55-openroad-stapostpnr\max_ss_125C_4v50\checks.rpt | 473
slew | \u_pochoco_soc.genblk1.g_rom_ram_memory.u_ram.a_rdata_o[9] | _8476_/Q | _8476_ | gf180mcu_fd_sc_mcu7t5v0__dffrnq_1 | Q | 9 | 3.254993 | 3.0 | -0.254993 | 425.04 | 462.56 | 425.04 | 462.56 | instruction/ROM/fetch | asic\runs\etapa12_rom_ram_no_delay_ss\55-openroad-stapostpnr\max_ss_125C_4v50\checks.rpt | 474
slew | _2878_ | _6415_/ZN | _6415_ | gf180mcu_fd_sc_mcu7t5v0__nor2_1 | ZN | 5 | 3.24886 | 3.0 | -0.24886 | 529.76 | 466.48 | 529.76 | 466.48 | other-combinational | asic\runs\etapa12_rom_ram_no_delay_ss\55-openroad-stapostpnr\max_ss_125C_4v50\checks.rpt | 475
slew | _2878_ | _6416_/A2 | _6415_ | gf180mcu_fd_sc_mcu7t5v0__nor2_1 | ZN | 5 | 3.24886 | 3.0 | -0.24886 | 529.76 | 466.48 | 497.84 | 470.4 | other-combinational | asic\runs\etapa12_rom_ram_no_delay_ss\55-openroad-stapostpnr\max_ss_125C_4v50\checks.rpt | 476
slew | _2878_ | _6553_/A2 | _6415_ | gf180mcu_fd_sc_mcu7t5v0__nor2_1 | ZN | 5 | 3.24886 | 3.0 | -0.24886 | 529.76 | 466.48 | 529.76 | 470.4 | other-combinational | asic\runs\etapa12_rom_ram_no_delay_ss\55-openroad-stapostpnr\max_ss_125C_4v50\checks.rpt | 477
slew | _2878_ | _6610_/A3 | _6415_ | gf180mcu_fd_sc_mcu7t5v0__nor2_1 | ZN | 5 | 3.24886 | 3.0 | -0.24886 | 529.76 | 466.48 | 505.68 | 540.96 | other-combinational | asic\runs\etapa12_rom_ram_no_delay_ss\55-openroad-stapostpnr\max_ss_125C_4v50\checks.rpt | 478
slew | _2878_ | _6611_/A2 | _6415_ | gf180mcu_fd_sc_mcu7t5v0__nor2_1 | ZN | 5 | 3.24886 | 3.0 | -0.24886 | 529.76 | 466.48 | 470.4 | 544.88 | other-combinational | asic\runs\etapa12_rom_ram_no_delay_ss\55-openroad-stapostpnr\max_ss_125C_4v50\checks.rpt | 479
slew | _2878_ | _6647_/B1 | _6415_ | gf180mcu_fd_sc_mcu7t5v0__nor2_1 | ZN | 5 | 3.24886 | 3.0 | -0.24886 | 529.76 | 466.48 | 529.2 | 478.24 | other-combinational | asic\runs\etapa12_rom_ram_no_delay_ss\55-openroad-stapostpnr\max_ss_125C_4v50\checks.rpt | 480
slew | _2686_ | _6217_/ZN | _6217_ | gf180mcu_fd_sc_mcu7t5v0__nor2_1 | ZN | 5 | 3.242751 | 3.0 | -0.242751 | 571.2 | 529.2 | 571.2 | 529.2 | other-combinational | asic\runs\etapa12_rom_ram_no_delay_ss\55-openroad-stapostpnr\max_ss_125C_4v50\checks.rpt | 481
slew | _2686_ | _6219_/B | _6217_ | gf180mcu_fd_sc_mcu7t5v0__nor2_1 | ZN | 5 | 3.242751 | 3.0 | -0.242751 | 571.2 | 529.2 | 560.56 | 454.72 | other-combinational | asic\runs\etapa12_rom_ram_no_delay_ss\55-openroad-stapostpnr\max_ss_125C_4v50\checks.rpt | 482
slew | _2686_ | _6319_/A2 | _6217_ | gf180mcu_fd_sc_mcu7t5v0__nor2_1 | ZN | 5 | 3.242751 | 3.0 | -0.242751 | 571.2 | 529.2 | 548.24 | 497.84 | other-combinational | asic\runs\etapa12_rom_ram_no_delay_ss\55-openroad-stapostpnr\max_ss_125C_4v50\checks.rpt | 483
slew | _2686_ | _6380_/A1 | _6217_ | gf180mcu_fd_sc_mcu7t5v0__nor2_1 | ZN | 5 | 3.242751 | 3.0 | -0.242751 | 571.2 | 529.2 | 576.8 | 509.6 | other-combinational | asic\runs\etapa12_rom_ram_no_delay_ss\55-openroad-stapostpnr\max_ss_125C_4v50\checks.rpt | 484
slew | _2686_ | _6411_/A1 | _6217_ | gf180mcu_fd_sc_mcu7t5v0__nor2_1 | ZN | 5 | 3.242751 | 3.0 | -0.242751 | 571.2 | 529.2 | 577.36 | 529.2 | other-combinational | asic\runs\etapa12_rom_ram_no_delay_ss\55-openroad-stapostpnr\max_ss_125C_4v50\checks.rpt | 485
slew | _2686_ | _6586_/A2 | _6217_ | gf180mcu_fd_sc_mcu7t5v0__nor2_1 | ZN | 5 | 3.242751 | 3.0 | -0.242751 | 571.2 | 529.2 | 535.36 | 458.64 | other-combinational | asic\runs\etapa12_rom_ram_no_delay_ss\55-openroad-stapostpnr\max_ss_125C_4v50\checks.rpt | 486
slew | _3528_ | fanout43/I | _7147_ | gf180mcu_fd_sc_mcu7t5v0__aoi211_2 | ZN | 2 | 3.233117 | 3.0 | -0.233118 | 310.8 | 392.0 | 162.4 | 478.24 | instruction/ROM/fetch+data-memory+register-file+peripheral | asic\runs\etapa12_rom_ram_no_delay_ss\55-openroad-stapostpnr\max_ss_125C_4v50\checks.rpt | 487
slew | _3528_ | fanout45/I | _7147_ | gf180mcu_fd_sc_mcu7t5v0__aoi211_2 | ZN | 2 | 3.233118 | 3.0 | -0.233118 | 310.8 | 392.0 | 164.64 | 537.04 | instruction/ROM/fetch+data-memory+register-file+peripheral | asic\runs\etapa12_rom_ram_no_delay_ss\55-openroad-stapostpnr\max_ss_125C_4v50\checks.rpt | 488
slew | _3528_ | _7147_/ZN | _7147_ | gf180mcu_fd_sc_mcu7t5v0__aoi211_2 | ZN | 2 | 3.233116 | 3.0 | -0.233116 | 310.8 | 392.0 | 310.8 | 392.0 | instruction/ROM/fetch+data-memory+register-file+peripheral | asic\runs\etapa12_rom_ram_no_delay_ss\55-openroad-stapostpnr\max_ss_125C_4v50\checks.rpt | 489
slew | _1199_ | _4584_/ZN | _4584_ | gf180mcu_fd_sc_mcu7t5v0__aoi21_1 | ZN | 5 | 3.194923 | 3.0 | -0.194923 | 383.6 | 270.48 | 383.6 | 270.48 | instruction/ROM/fetch+data-memory+register-file | asic\runs\etapa12_rom_ram_no_delay_ss\55-openroad-stapostpnr\max_ss_125C_4v50\checks.rpt | 490
slew | _1199_ | _4658_/A1 | _4584_ | gf180mcu_fd_sc_mcu7t5v0__aoi21_1 | ZN | 5 | 3.194923 | 3.0 | -0.194923 | 383.6 | 270.48 | 305.2 | 270.48 | instruction/ROM/fetch+data-memory+register-file | asic\runs\etapa12_rom_ram_no_delay_ss\55-openroad-stapostpnr\max_ss_125C_4v50\checks.rpt | 491
slew | _1199_ | _4740_/A1 | _4584_ | gf180mcu_fd_sc_mcu7t5v0__aoi21_1 | ZN | 5 | 3.194923 | 3.0 | -0.194923 | 383.6 | 270.48 | 310.8 | 266.56 | instruction/ROM/fetch+data-memory+register-file | asic\runs\etapa12_rom_ram_no_delay_ss\55-openroad-stapostpnr\max_ss_125C_4v50\checks.rpt | 492
slew | _1199_ | _4776_/A1 | _4584_ | gf180mcu_fd_sc_mcu7t5v0__aoi21_1 | ZN | 5 | 3.194923 | 3.0 | -0.194923 | 383.6 | 270.48 | 341.04 | 250.88 | instruction/ROM/fetch+data-memory+register-file | asic\runs\etapa12_rom_ram_no_delay_ss\55-openroad-stapostpnr\max_ss_125C_4v50\checks.rpt | 493
slew | _1199_ | _4805_/A1 | _4584_ | gf180mcu_fd_sc_mcu7t5v0__aoi21_1 | ZN | 5 | 3.194923 | 3.0 | -0.194923 | 383.6 | 270.48 | 328.72 | 250.88 | instruction/ROM/fetch+data-memory+register-file | asic\runs\etapa12_rom_ram_no_delay_ss\55-openroad-stapostpnr\max_ss_125C_4v50\checks.rpt | 494
slew | _1199_ | _4868_/A1 | _4584_ | gf180mcu_fd_sc_mcu7t5v0__aoi21_1 | ZN | 5 | 3.194923 | 3.0 | -0.194923 | 383.6 | 270.48 | 360.08 | 258.72 | instruction/ROM/fetch+data-memory+register-file | asic\runs\etapa12_rom_ram_no_delay_ss\55-openroad-stapostpnr\max_ss_125C_4v50\checks.rpt | 495
slew | _1029_ | _4778_/A1 | _4414_ | gf180mcu_fd_sc_mcu7t5v0__and2_1 | Z | 10 | 3.187522 | 3.0 | -0.187522 | 460.32 | 290.08 | 343.84 | 235.2 | instruction/ROM/fetch | asic\runs\etapa12_rom_ram_no_delay_ss\55-openroad-stapostpnr\max_ss_125C_4v50\checks.rpt | 496
slew | _1029_ | _4759_/A1 | _4414_ | gf180mcu_fd_sc_mcu7t5v0__and2_1 | Z | 10 | 3.187521 | 3.0 | -0.187522 | 460.32 | 290.08 | 347.2 | 278.32 | instruction/ROM/fetch | asic\runs\etapa12_rom_ram_no_delay_ss\55-openroad-stapostpnr\max_ss_125C_4v50\checks.rpt | 497
slew | _1029_ | _4723_/A1 | _4414_ | gf180mcu_fd_sc_mcu7t5v0__and2_1 | Z | 10 | 3.187508 | 3.0 | -0.187508 | 460.32 | 290.08 | 419.44 | 266.56 | instruction/ROM/fetch | asic\runs\etapa12_rom_ram_no_delay_ss\55-openroad-stapostpnr\max_ss_125C_4v50\checks.rpt | 498
slew | _1029_ | _6759_/A1 | _4414_ | gf180mcu_fd_sc_mcu7t5v0__and2_1 | Z | 10 | 3.187503 | 3.0 | -0.187503 | 460.32 | 290.08 | 438.48 | 266.56 | instruction/ROM/fetch | asic\runs\etapa12_rom_ram_no_delay_ss\55-openroad-stapostpnr\max_ss_125C_4v50\checks.rpt | 499
slew | _1029_ | _4877_/A1 | _4414_ | gf180mcu_fd_sc_mcu7t5v0__and2_1 | Z | 10 | 3.187494 | 3.0 | -0.187494 | 460.32 | 290.08 | 451.36 | 246.96 | instruction/ROM/fetch | asic\runs\etapa12_rom_ram_no_delay_ss\55-openroad-stapostpnr\max_ss_125C_4v50\checks.rpt | 500
slew | _1029_ | _4838_/A1 | _4414_ | gf180mcu_fd_sc_mcu7t5v0__and2_1 | Z | 10 | 3.187492 | 3.0 | -0.187492 | 460.32 | 290.08 | 505.12 | 235.2 | instruction/ROM/fetch | asic\runs\etapa12_rom_ram_no_delay_ss\55-openroad-stapostpnr\max_ss_125C_4v50\checks.rpt | 501
slew | _1029_ | _4831_/A1 | _4414_ | gf180mcu_fd_sc_mcu7t5v0__and2_1 | Z | 10 | 3.187491 | 3.0 | -0.187492 | 460.32 | 290.08 | 490.0 | 246.96 | instruction/ROM/fetch | asic\runs\etapa12_rom_ram_no_delay_ss\55-openroad-stapostpnr\max_ss_125C_4v50\checks.rpt | 502
slew | _1029_ | _6178_/A1 | _4414_ | gf180mcu_fd_sc_mcu7t5v0__and2_1 | Z | 10 | 3.18749 | 3.0 | -0.18749 | 460.32 | 290.08 | 466.48 | 231.28 | instruction/ROM/fetch | asic\runs\etapa12_rom_ram_no_delay_ss\55-openroad-stapostpnr\max_ss_125C_4v50\checks.rpt | 503
slew | _1029_ | _4414_/Z | _4414_ | gf180mcu_fd_sc_mcu7t5v0__and2_1 | Z | 10 | 3.187479 | 3.0 | -0.187479 | 460.32 | 290.08 | 460.32 | 290.08 | instruction/ROM/fetch | asic\runs\etapa12_rom_ram_no_delay_ss\55-openroad-stapostpnr\max_ss_125C_4v50\checks.rpt | 504
slew | _1029_ | _4424_/A1 | _4414_ | gf180mcu_fd_sc_mcu7t5v0__and2_1 | Z | 10 | 3.187479 | 3.0 | -0.187479 | 460.32 | 290.08 | 454.72 | 286.16 | instruction/ROM/fetch | asic\runs\etapa12_rom_ram_no_delay_ss\55-openroad-stapostpnr\max_ss_125C_4v50\checks.rpt | 505
slew | _1029_ | _4826_/A1 | _4414_ | gf180mcu_fd_sc_mcu7t5v0__and2_1 | Z | 10 | 3.187479 | 3.0 | -0.187479 | 460.32 | 290.08 | 498.96 | 286.16 | instruction/ROM/fetch | asic\runs\etapa12_rom_ram_no_delay_ss\55-openroad-stapostpnr\max_ss_125C_4v50\checks.rpt | 506
slew | _2362_ | _6277_/B2 | _5863_ | gf180mcu_fd_sc_mcu7t5v0__nand2_1 | ZN | 9 | 3.179587 | 3.0 | -0.179587 | 563.92 | 395.92 | 495.6 | 482.16 | other-combinational | asic\runs\etapa12_rom_ram_no_delay_ss\55-openroad-stapostpnr\max_ss_125C_4v50\checks.rpt | 507
slew | _2362_ | _6471_/A1 | _5863_ | gf180mcu_fd_sc_mcu7t5v0__nand2_1 | ZN | 9 | 3.179585 | 3.0 | -0.179586 | 563.92 | 395.92 | 493.92 | 462.56 | other-combinational | asic\runs\etapa12_rom_ram_no_delay_ss\55-openroad-stapostpnr\max_ss_125C_4v50\checks.rpt | 508
slew | _2362_ | _6316_/A1 | _5863_ | gf180mcu_fd_sc_mcu7t5v0__nand2_1 | ZN | 9 | 3.179585 | 3.0 | -0.179585 | 563.92 | 395.92 | 493.36 | 435.12 | other-combinational | asic\runs\etapa12_rom_ram_no_delay_ss\55-openroad-stapostpnr\max_ss_125C_4v50\checks.rpt | 509
slew | _2362_ | _6353_/A2 | _5863_ | gf180mcu_fd_sc_mcu7t5v0__nand2_1 | ZN | 9 | 3.179585 | 3.0 | -0.179585 | 563.92 | 395.92 | 498.96 | 435.12 | other-combinational | asic\runs\etapa12_rom_ram_no_delay_ss\55-openroad-stapostpnr\max_ss_125C_4v50\checks.rpt | 510
slew | _2362_ | _6383_/A1 | _5863_ | gf180mcu_fd_sc_mcu7t5v0__nand2_1 | ZN | 9 | 3.179573 | 3.0 | -0.179573 | 563.92 | 395.92 | 530.88 | 442.96 | other-combinational | asic\runs\etapa12_rom_ram_no_delay_ss\55-openroad-stapostpnr\max_ss_125C_4v50\checks.rpt | 511
slew | _2362_ | _6335_/A2 | _5863_ | gf180mcu_fd_sc_mcu7t5v0__nand2_1 | ZN | 9 | 3.179572 | 3.0 | -0.179572 | 563.92 | 395.92 | 563.36 | 529.2 | other-combinational | asic\runs\etapa12_rom_ram_no_delay_ss\55-openroad-stapostpnr\max_ss_125C_4v50\checks.rpt | 512
slew | _2362_ | _6671_/A2 | _5863_ | gf180mcu_fd_sc_mcu7t5v0__nand2_1 | ZN | 9 | 3.179566 | 3.0 | -0.179566 | 563.92 | 395.92 | 560.0 | 470.4 | other-combinational | asic\runs\etapa12_rom_ram_no_delay_ss\55-openroad-stapostpnr\max_ss_125C_4v50\checks.rpt | 513
slew | _2362_ | _5863_/ZN | _5863_ | gf180mcu_fd_sc_mcu7t5v0__nand2_1 | ZN | 9 | 3.179549 | 3.0 | -0.179549 | 563.92 | 395.92 | 563.92 | 395.92 | other-combinational | asic\runs\etapa12_rom_ram_no_delay_ss\55-openroad-stapostpnr\max_ss_125C_4v50\checks.rpt | 514
slew | _2362_ | _6696_/A2 | _5863_ | gf180mcu_fd_sc_mcu7t5v0__nand2_1 | ZN | 9 | 3.179549 | 3.0 | -0.179549 | 563.92 | 395.92 | 563.36 | 435.12 | other-combinational | asic\runs\etapa12_rom_ram_no_delay_ss\55-openroad-stapostpnr\max_ss_125C_4v50\checks.rpt | 515
slew | _2362_ | _6713_/A2 | _5863_ | gf180mcu_fd_sc_mcu7t5v0__nand2_1 | ZN | 9 | 3.179549 | 3.0 | -0.179549 | 563.92 | 395.92 | 546.56 | 403.76 | other-combinational | asic\runs\etapa12_rom_ram_no_delay_ss\55-openroad-stapostpnr\max_ss_125C_4v50\checks.rpt | 516
slew | net798 | _7114_/A1 | fanout798 | gf180mcu_fd_sc_mcu7t5v0__buf_1 | Z | 10 | 3.168308 | 3.0 | -0.168308 | 449.68 | 235.2 | 347.76 | 168.56 | instruction/ROM/fetch | asic\runs\etapa12_rom_ram_no_delay_ss\55-openroad-stapostpnr\max_ss_125C_4v50\checks.rpt | 517
slew | net798 | _7165_/C | fanout798 | gf180mcu_fd_sc_mcu7t5v0__buf_1 | Z | 10 | 3.168308 | 3.0 | -0.168308 | 449.68 | 235.2 | 353.36 | 199.92 | instruction/ROM/fetch | asic\runs\etapa12_rom_ram_no_delay_ss\55-openroad-stapostpnr\max_ss_125C_4v50\checks.rpt | 518
slew | net798 | _7121_/B | fanout798 | gf180mcu_fd_sc_mcu7t5v0__buf_1 | Z | 10 | 3.168303 | 3.0 | -0.168303 | 449.68 | 235.2 | 348.88 | 219.52 | instruction/ROM/fetch | asic\runs\etapa12_rom_ram_no_delay_ss\55-openroad-stapostpnr\max_ss_125C_4v50\checks.rpt | 519
slew | net798 | _7180_/B | fanout798 | gf180mcu_fd_sc_mcu7t5v0__buf_1 | Z | 10 | 3.168302 | 3.0 | -0.168302 | 449.68 | 235.2 | 350.56 | 223.44 | instruction/ROM/fetch | asic\runs\etapa12_rom_ram_no_delay_ss\55-openroad-stapostpnr\max_ss_125C_4v50\checks.rpt | 520
slew | net798 | _4363_/A2 | fanout798 | gf180mcu_fd_sc_mcu7t5v0__buf_1 | Z | 10 | 3.168296 | 3.0 | -0.168296 | 449.68 | 235.2 | 354.48 | 227.36 | instruction/ROM/fetch | asic\runs\etapa12_rom_ram_no_delay_ss\55-openroad-stapostpnr\max_ss_125C_4v50\checks.rpt | 521
slew | net798 | _7058_/C | fanout798 | gf180mcu_fd_sc_mcu7t5v0__buf_1 | Z | 10 | 3.16828 | 3.0 | -0.16828 | 449.68 | 235.2 | 385.28 | 219.52 | instruction/ROM/fetch | asic\runs\etapa12_rom_ram_no_delay_ss\55-openroad-stapostpnr\max_ss_125C_4v50\checks.rpt | 522
slew | net798 | _7041_/A1 | fanout798 | gf180mcu_fd_sc_mcu7t5v0__buf_1 | Z | 10 | 3.168263 | 3.0 | -0.168263 | 449.68 | 235.2 | 390.88 | 203.84 | instruction/ROM/fetch | asic\runs\etapa12_rom_ram_no_delay_ss\55-openroad-stapostpnr\max_ss_125C_4v50\checks.rpt | 523
slew | net798 | _7049_/C | fanout798 | gf180mcu_fd_sc_mcu7t5v0__buf_1 | Z | 10 | 3.16823 | 3.0 | -0.16823 | 449.68 | 235.2 | 393.68 | 164.64 | instruction/ROM/fetch | asic\runs\etapa12_rom_ram_no_delay_ss\55-openroad-stapostpnr\max_ss_125C_4v50\checks.rpt | 524
slew | net798 | _6903_/A1 | fanout798 | gf180mcu_fd_sc_mcu7t5v0__buf_1 | Z | 10 | 3.168207 | 3.0 | -0.168207 | 449.68 | 235.2 | 446.88 | 164.64 | instruction/ROM/fetch | asic\runs\etapa12_rom_ram_no_delay_ss\55-openroad-stapostpnr\max_ss_125C_4v50\checks.rpt | 525
slew | net798 | _4371_/A2 | fanout798 | gf180mcu_fd_sc_mcu7t5v0__buf_1 | Z | 10 | 3.168181 | 3.0 | -0.168181 | 449.68 | 235.2 | 449.12 | 227.36 | instruction/ROM/fetch | asic\runs\etapa12_rom_ram_no_delay_ss\55-openroad-stapostpnr\max_ss_125C_4v50\checks.rpt | 526
slew | net798 | fanout798/Z | fanout798 | gf180mcu_fd_sc_mcu7t5v0__buf_1 | Z | 10 | 3.168181 | 3.0 | -0.168181 | 449.68 | 235.2 | 449.68 | 235.2 | instruction/ROM/fetch | asic\runs\etapa12_rom_ram_no_delay_ss\55-openroad-stapostpnr\max_ss_125C_4v50\checks.rpt | 527
slew | \u_pochoco_soc.data_wdata[3] | _4440_/A1 | _9248_ | gf180mcu_fd_sc_mcu7t5v0__dffrnq_1 | Q | 7 | 3.166273 | 3.0 | -0.166273 | 285.6 | 113.68 | 504.56 | 243.04 | data-memory | asic\runs\etapa12_rom_ram_no_delay_ss\55-openroad-stapostpnr\max_ss_125C_4v50\checks.rpt | 528
slew | \u_pochoco_soc.data_wdata[3] | _8385_/I0 | _9248_ | gf180mcu_fd_sc_mcu7t5v0__dffrnq_1 | Q | 7 | 3.166258 | 3.0 | -0.166258 | 285.6 | 113.68 | 547.12 | 231.28 | data-memory | asic\runs\etapa12_rom_ram_no_delay_ss\55-openroad-stapostpnr\max_ss_125C_4v50\checks.rpt | 529
slew | \u_pochoco_soc.data_wdata[3] | _8264_/I0 | _9248_ | gf180mcu_fd_sc_mcu7t5v0__dffrnq_1 | Q | 7 | 3.166236 | 3.0 | -0.166236 | 285.6 | 113.68 | 554.96 | 172.48 | data-memory | asic\runs\etapa12_rom_ram_no_delay_ss\55-openroad-stapostpnr\max_ss_125C_4v50\checks.rpt | 530
slew | \u_pochoco_soc.data_wdata[3] | _8270_/I0 | _9248_ | gf180mcu_fd_sc_mcu7t5v0__dffrnq_1 | Q | 7 | 3.166215 | 3.0 | -0.166215 | 285.6 | 113.68 | 556.64 | 152.88 | data-memory | asic\runs\etapa12_rom_ram_no_delay_ss\55-openroad-stapostpnr\max_ss_125C_4v50\checks.rpt | 531
slew | \u_pochoco_soc.data_wdata[3] | _6855_/I1 | _9248_ | gf180mcu_fd_sc_mcu7t5v0__dffrnq_1 | Q | 7 | 3.166158 | 3.0 | -0.166159 | 285.6 | 113.68 | 462.56 | 145.04 | data-memory | asic\runs\etapa12_rom_ram_no_delay_ss\55-openroad-stapostpnr\max_ss_125C_4v50\checks.rpt | 532
slew | \u_pochoco_soc.data_wdata[3] | _6782_/A1 | _9248_ | gf180mcu_fd_sc_mcu7t5v0__dffrnq_1 | Q | 7 | 3.166097 | 3.0 | -0.166097 | 285.6 | 113.68 | 330.4 | 172.48 | data-memory | asic\runs\etapa12_rom_ram_no_delay_ss\55-openroad-stapostpnr\max_ss_125C_4v50\checks.rpt | 533
slew | \u_pochoco_soc.data_wdata[3] | _6781_/A1 | _9248_ | gf180mcu_fd_sc_mcu7t5v0__dffrnq_1 | Q | 7 | 3.166082 | 3.0 | -0.166082 | 285.6 | 113.68 | 305.76 | 137.2 | data-memory | asic\runs\etapa12_rom_ram_no_delay_ss\55-openroad-stapostpnr\max_ss_125C_4v50\checks.rpt | 534
slew | \u_pochoco_soc.data_wdata[3] | _9248_/Q | _9248_ | gf180mcu_fd_sc_mcu7t5v0__dffrnq_1 | Q | 7 | 3.166082 | 3.0 | -0.166082 | 285.6 | 113.68 | 285.6 | 113.68 | data-memory | asic\runs\etapa12_rom_ram_no_delay_ss\55-openroad-stapostpnr\max_ss_125C_4v50\checks.rpt | 535
slew | _2336_ | _6424_/A1 | _5835_ | gf180mcu_fd_sc_mcu7t5v0__nand2_1 | ZN | 9 | 3.160958 | 3.0 | -0.160958 | 570.08 | 521.36 | 450.8 | 478.24 | other-combinational | asic\runs\etapa12_rom_ram_no_delay_ss\55-openroad-stapostpnr\max_ss_125C_4v50\checks.rpt | 536
slew | _2336_ | _6690_/A2 | _5835_ | gf180mcu_fd_sc_mcu7t5v0__nand2_1 | ZN | 9 | 3.160958 | 3.0 | -0.160958 | 570.08 | 521.36 | 442.4 | 482.16 | other-combinational | asic\runs\etapa12_rom_ram_no_delay_ss\55-openroad-stapostpnr\max_ss_125C_4v50\checks.rpt | 537
slew | _2336_ | _6377_/A2 | _5835_ | gf180mcu_fd_sc_mcu7t5v0__nand2_1 | ZN | 9 | 3.160956 | 3.0 | -0.160956 | 570.08 | 521.36 | 446.32 | 490.0 | other-combinational | asic\runs\etapa12_rom_ram_no_delay_ss\55-openroad-stapostpnr\max_ss_125C_4v50\checks.rpt | 538
slew | _2336_ | _5836_/A2 | _5835_ | gf180mcu_fd_sc_mcu7t5v0__nand2_1 | ZN | 9 | 3.160951 | 3.0 | -0.160951 | 570.08 | 521.36 | 450.8 | 529.2 | other-combinational | asic\runs\etapa12_rom_ram_no_delay_ss\55-openroad-stapostpnr\max_ss_125C_4v50\checks.rpt | 539
slew | _2336_ | _6306_/A2 | _5835_ | gf180mcu_fd_sc_mcu7t5v0__nand2_1 | ZN | 9 | 3.160943 | 3.0 | -0.160943 | 570.08 | 521.36 | 505.12 | 521.36 | other-combinational | asic\runs\etapa12_rom_ram_no_delay_ss\55-openroad-stapostpnr\max_ss_125C_4v50\checks.rpt | 540
slew | _2336_ | _5835_/ZN | _5835_ | gf180mcu_fd_sc_mcu7t5v0__nand2_1 | ZN | 9 | 3.160927 | 3.0 | -0.160927 | 570.08 | 521.36 | 570.08 | 521.36 | other-combinational | asic\runs\etapa12_rom_ram_no_delay_ss\55-openroad-stapostpnr\max_ss_125C_4v50\checks.rpt | 541
slew | _2336_ | _6338_/A2 | _5835_ | gf180mcu_fd_sc_mcu7t5v0__nand2_1 | ZN | 9 | 3.160927 | 3.0 | -0.160927 | 570.08 | 521.36 | 558.32 | 521.36 | other-combinational | asic\runs\etapa12_rom_ram_no_delay_ss\55-openroad-stapostpnr\max_ss_125C_4v50\checks.rpt | 542
slew | _2336_ | _6375_/A2 | _5835_ | gf180mcu_fd_sc_mcu7t5v0__nand2_1 | ZN | 9 | 3.160927 | 3.0 | -0.160927 | 570.08 | 521.36 | 553.28 | 509.6 | other-combinational | asic\runs\etapa12_rom_ram_no_delay_ss\55-openroad-stapostpnr\max_ss_125C_4v50\checks.rpt | 543
slew | _2336_ | _6389_/A1 | _5835_ | gf180mcu_fd_sc_mcu7t5v0__nand2_1 | ZN | 9 | 3.160927 | 3.0 | -0.160927 | 570.08 | 521.36 | 567.84 | 517.44 | other-combinational | asic\runs\etapa12_rom_ram_no_delay_ss\55-openroad-stapostpnr\max_ss_125C_4v50\checks.rpt | 544
slew | _2336_ | _6664_/B2 | _5835_ | gf180mcu_fd_sc_mcu7t5v0__nand2_1 | ZN | 9 | 3.160927 | 3.0 | -0.160927 | 570.08 | 521.36 | 546.56 | 478.24 | other-combinational | asic\runs\etapa12_rom_ram_no_delay_ss\55-openroad-stapostpnr\max_ss_125C_4v50\checks.rpt | 545
slew | _0970_ | _4353_/ZN | _4353_ | gf180mcu_fd_sc_mcu7t5v0__nand4_1 | ZN | 8 | 3.147791 | 3.0 | -0.147791 | 444.64 | 360.64 | 444.64 | 360.64 | instruction/ROM/fetch | asic\runs\etapa12_rom_ram_no_delay_ss\55-openroad-stapostpnr\max_ss_125C_4v50\checks.rpt | 546
slew | _0970_ | _4354_/B1 | _4353_ | gf180mcu_fd_sc_mcu7t5v0__nand4_1 | ZN | 8 | 3.147791 | 3.0 | -0.147791 | 444.64 | 360.64 | 442.96 | 329.28 | instruction/ROM/fetch | asic\runs\etapa12_rom_ram_no_delay_ss\55-openroad-stapostpnr\max_ss_125C_4v50\checks.rpt | 547
slew | _0970_ | _4366_/A1 | _4353_ | gf180mcu_fd_sc_mcu7t5v0__nand4_1 | ZN | 8 | 3.147791 | 3.0 | -0.147791 | 444.64 | 360.64 | 458.64 | 360.64 | instruction/ROM/fetch | asic\runs\etapa12_rom_ram_no_delay_ss\55-openroad-stapostpnr\max_ss_125C_4v50\checks.rpt | 548
slew | _0970_ | _4385_/B2 | _4353_ | gf180mcu_fd_sc_mcu7t5v0__nand4_1 | ZN | 8 | 3.147791 | 3.0 | -0.147791 | 444.64 | 360.64 | 450.8 | 344.96 | instruction/ROM/fetch | asic\runs\etapa12_rom_ram_no_delay_ss\55-openroad-stapostpnr\max_ss_125C_4v50\checks.rpt | 549
slew | _0970_ | _4400_/A1 | _4353_ | gf180mcu_fd_sc_mcu7t5v0__nand4_1 | ZN | 8 | 3.147791 | 3.0 | -0.147791 | 444.64 | 360.64 | 456.96 | 309.68 | instruction/ROM/fetch | asic\runs\etapa12_rom_ram_no_delay_ss\55-openroad-stapostpnr\max_ss_125C_4v50\checks.rpt | 550
slew | _0970_ | _4404_/B | _4353_ | gf180mcu_fd_sc_mcu7t5v0__nand4_1 | ZN | 8 | 3.147791 | 3.0 | -0.147791 | 444.64 | 360.64 | 439.04 | 309.68 | instruction/ROM/fetch | asic\runs\etapa12_rom_ram_no_delay_ss\55-openroad-stapostpnr\max_ss_125C_4v50\checks.rpt | 551
slew | _0970_ | _4408_/C | _4353_ | gf180mcu_fd_sc_mcu7t5v0__nand4_1 | ZN | 8 | 3.147791 | 3.0 | -0.147791 | 444.64 | 360.64 | 451.92 | 305.76 | instruction/ROM/fetch | asic\runs\etapa12_rom_ram_no_delay_ss\55-openroad-stapostpnr\max_ss_125C_4v50\checks.rpt | 552
slew | _0970_ | _4416_/A1 | _4353_ | gf180mcu_fd_sc_mcu7t5v0__nand4_1 | ZN | 8 | 3.147791 | 3.0 | -0.147791 | 444.64 | 360.64 | 453.6 | 309.68 | instruction/ROM/fetch | asic\runs\etapa12_rom_ram_no_delay_ss\55-openroad-stapostpnr\max_ss_125C_4v50\checks.rpt | 553
slew | _0970_ | _4419_/B1 | _4353_ | gf180mcu_fd_sc_mcu7t5v0__nand4_1 | ZN | 8 | 3.147791 | 3.0 | -0.147791 | 444.64 | 360.64 | 445.2 | 317.52 | instruction/ROM/fetch | asic\runs\etapa12_rom_ram_no_delay_ss\55-openroad-stapostpnr\max_ss_125C_4v50\checks.rpt | 554
slew | _3407_ | fanout106/I | _7009_ | gf180mcu_fd_sc_mcu7t5v0__nor2_1 | ZN | 2 | 3.147599 | 3.0 | -0.147599 | 432.88 | 184.24 | 189.84 | 192.08 | instruction/ROM/fetch+data-memory+register-file+peripheral | asic\runs\etapa12_rom_ram_no_delay_ss\55-openroad-stapostpnr\max_ss_125C_4v50\checks.rpt | 555
slew | _3407_ | fanout104/I | _7009_ | gf180mcu_fd_sc_mcu7t5v0__nor2_1 | ZN | 2 | 3.147599 | 3.0 | -0.147599 | 432.88 | 184.24 | 218.96 | 172.48 | instruction/ROM/fetch+data-memory+register-file+peripheral | asic\runs\etapa12_rom_ram_no_delay_ss\55-openroad-stapostpnr\max_ss_125C_4v50\checks.rpt | 556
slew | _3407_ | _7009_/ZN | _7009_ | gf180mcu_fd_sc_mcu7t5v0__nor2_1 | ZN | 2 | 3.147584 | 3.0 | -0.147584 | 432.88 | 184.24 | 432.88 | 184.24 | instruction/ROM/fetch+data-memory+register-file+peripheral | asic\runs\etapa12_rom_ram_no_delay_ss\55-openroad-stapostpnr\max_ss_125C_4v50\checks.rpt | 557
slew | _1403_ | _4788_/ZN | _4788_ | gf180mcu_fd_sc_mcu7t5v0__oai21_1 | ZN | 3 | 3.145641 | 3.0 | -0.145641 | 390.32 | 243.04 | 390.32 | 243.04 | instruction/ROM/fetch+data-memory+register-file | asic\runs\etapa12_rom_ram_no_delay_ss\55-openroad-stapostpnr\max_ss_125C_4v50\checks.rpt | 558
slew | _1403_ | _4789_/A2 | _4788_ | gf180mcu_fd_sc_mcu7t5v0__oai21_1 | ZN | 3 | 3.145641 | 3.0 | -0.145641 | 390.32 | 243.04 | 393.68 | 337.12 | instruction/ROM/fetch+data-memory+register-file | asic\runs\etapa12_rom_ram_no_delay_ss\55-openroad-stapostpnr\max_ss_125C_4v50\checks.rpt | 559
slew | _1403_ | _5940_/A1 | _4788_ | gf180mcu_fd_sc_mcu7t5v0__oai21_1 | ZN | 3 | 3.145641 | 3.0 | -0.145641 | 390.32 | 243.04 | 399.84 | 341.04 | instruction/ROM/fetch+data-memory+register-file | asic\runs\etapa12_rom_ram_no_delay_ss\55-openroad-stapostpnr\max_ss_125C_4v50\checks.rpt | 560
slew | _1403_ | _7027_/A2 | _4788_ | gf180mcu_fd_sc_mcu7t5v0__oai21_1 | ZN | 3 | 3.145641 | 3.0 | -0.145641 | 390.32 | 243.04 | 395.92 | 188.16 | instruction/ROM/fetch+data-memory+register-file | asic\runs\etapa12_rom_ram_no_delay_ss\55-openroad-stapostpnr\max_ss_125C_4v50\checks.rpt | 561
slew | _1378_ | _4763_/ZN | _4763_ | gf180mcu_fd_sc_mcu7t5v0__oai221_1 | ZN | 3 | 3.143555 | 3.0 | -0.143555 | 342.72 | 282.24 | 342.72 | 282.24 | instruction/ROM/fetch+data-memory+register-file | asic\runs\etapa12_rom_ram_no_delay_ss\55-openroad-stapostpnr\max_ss_125C_4v50\checks.rpt | 562
slew | _1378_ | _4764_/A4 | _4763_ | gf180mcu_fd_sc_mcu7t5v0__oai221_1 | ZN | 3 | 3.143555 | 3.0 | -0.143555 | 342.72 | 282.24 | 342.72 | 348.88 | instruction/ROM/fetch+data-memory+register-file | asic\runs\etapa12_rom_ram_no_delay_ss\55-openroad-stapostpnr\max_ss_125C_4v50\checks.rpt | 563
slew | _1378_ | _5991_/A1 | _4763_ | gf180mcu_fd_sc_mcu7t5v0__oai221_1 | ZN | 3 | 3.143555 | 3.0 | -0.143555 | 342.72 | 282.24 | 358.96 | 376.32 | instruction/ROM/fetch+data-memory+register-file | asic\runs\etapa12_rom_ram_no_delay_ss\55-openroad-stapostpnr\max_ss_125C_4v50\checks.rpt | 564
slew | _1378_ | _7062_/A2 | _4763_ | gf180mcu_fd_sc_mcu7t5v0__oai221_1 | ZN | 3 | 3.143555 | 3.0 | -0.143555 | 342.72 | 282.24 | 356.16 | 274.4 | instruction/ROM/fetch+data-memory+register-file | asic\runs\etapa12_rom_ram_no_delay_ss\55-openroad-stapostpnr\max_ss_125C_4v50\checks.rpt | 565
slew | _2682_ | _6655_/C | _6213_ | gf180mcu_fd_sc_mcu7t5v0__nand2_1 | ZN | 9 | 3.137614 | 3.0 | -0.137614 | 487.76 | 423.36 | 526.96 | 505.68 | other-combinational | asic\runs\etapa12_rom_ram_no_delay_ss\55-openroad-stapostpnr\max_ss_125C_4v50\checks.rpt | 566
slew | _2682_ | _6561_/B | _6213_ | gf180mcu_fd_sc_mcu7t5v0__nand2_1 | ZN | 9 | 3.137613 | 3.0 | -0.137613 | 487.76 | 423.36 | 468.72 | 505.68 | other-combinational | asic\runs\etapa12_rom_ram_no_delay_ss\55-openroad-stapostpnr\max_ss_125C_4v50\checks.rpt | 567
slew | _2682_ | _6399_/B2 | _6213_ | gf180mcu_fd_sc_mcu7t5v0__nand2_1 | ZN | 9 | 3.137612 | 3.0 | -0.137612 | 487.76 | 423.36 | 481.6 | 505.68 | other-combinational | asic\runs\etapa12_rom_ram_no_delay_ss\55-openroad-stapostpnr\max_ss_125C_4v50\checks.rpt | 568
slew | _2682_ | _6518_/A1 | _6213_ | gf180mcu_fd_sc_mcu7t5v0__nand2_1 | ZN | 9 | 3.137609 | 3.0 | -0.137609 | 487.76 | 423.36 | 479.92 | 493.92 | other-combinational | asic\runs\etapa12_rom_ram_no_delay_ss\55-openroad-stapostpnr\max_ss_125C_4v50\checks.rpt | 569
slew | _2682_ | _6213_/ZN | _6213_ | gf180mcu_fd_sc_mcu7t5v0__nand2_1 | ZN | 9 | 3.137596 | 3.0 | -0.137596 | 487.76 | 423.36 | 487.76 | 423.36 | other-combinational | asic\runs\etapa12_rom_ram_no_delay_ss\55-openroad-stapostpnr\max_ss_125C_4v50\checks.rpt | 570
slew | _2682_ | _6216_/B | _6213_ | gf180mcu_fd_sc_mcu7t5v0__nand2_1 | ZN | 9 | 3.137596 | 3.0 | -0.137596 | 487.76 | 423.36 | 546.0 | 458.64 | other-combinational | asic\runs\etapa12_rom_ram_no_delay_ss\55-openroad-stapostpnr\max_ss_125C_4v50\checks.rpt | 571
slew | _2682_ | _6592_/A1 | _6213_ | gf180mcu_fd_sc_mcu7t5v0__nand2_1 | ZN | 9 | 3.137596 | 3.0 | -0.137596 | 487.76 | 423.36 | 486.08 | 466.48 | other-combinational | asic\runs\etapa12_rom_ram_no_delay_ss\55-openroad-stapostpnr\max_ss_125C_4v50\checks.rpt | 572
slew | _2682_ | _6678_/A1 | _6213_ | gf180mcu_fd_sc_mcu7t5v0__nand2_1 | ZN | 9 | 3.137596 | 3.0 | -0.137596 | 487.76 | 423.36 | 542.08 | 466.48 | other-combinational | asic\runs\etapa12_rom_ram_no_delay_ss\55-openroad-stapostpnr\max_ss_125C_4v50\checks.rpt | 573
slew | _2682_ | _6705_/A1 | _6213_ | gf180mcu_fd_sc_mcu7t5v0__nand2_1 | ZN | 9 | 3.137596 | 3.0 | -0.137596 | 487.76 | 423.36 | 547.12 | 423.36 | other-combinational | asic\runs\etapa12_rom_ram_no_delay_ss\55-openroad-stapostpnr\max_ss_125C_4v50\checks.rpt | 574
slew | _2682_ | _6711_/C | _6213_ | gf180mcu_fd_sc_mcu7t5v0__nand2_1 | ZN | 9 | 3.137596 | 3.0 | -0.137596 | 487.76 | 423.36 | 537.6 | 439.04 | other-combinational | asic\runs\etapa12_rom_ram_no_delay_ss\55-openroad-stapostpnr\max_ss_125C_4v50\checks.rpt | 575
slew | \u_pochoco_soc.genblk1.g_rom_ram_memory.u_ram.a_rdata_o[21] | _4968_/A1 | _8488_ | gf180mcu_fd_sc_mcu7t5v0__dffrnq_1 | Q | 10 | 3.13641 | 3.0 | -0.13641 | 465.36 | 376.32 | 275.52 | 360.64 | instruction/ROM/fetch | asic\runs\etapa12_rom_ram_no_delay_ss\55-openroad-stapostpnr\max_ss_125C_4v50\checks.rpt | 576
slew | \u_pochoco_soc.genblk1.g_rom_ram_memory.u_ram.a_rdata_o[21] | _4965_/A1 | _8488_ | gf180mcu_fd_sc_mcu7t5v0__dffrnq_1 | Q | 10 | 3.13641 | 3.0 | -0.13641 | 465.36 | 376.32 | 267.12 | 360.64 | instruction/ROM/fetch | asic\runs\etapa12_rom_ram_no_delay_ss\55-openroad-stapostpnr\max_ss_125C_4v50\checks.rpt | 577
slew | \u_pochoco_soc.genblk1.g_rom_ram_memory.u_ram.a_rdata_o[21] | _4973_/A1 | _8488_ | gf180mcu_fd_sc_mcu7t5v0__dffrnq_1 | Q | 10 | 3.136409 | 3.0 | -0.136409 | 465.36 | 376.32 | 255.92 | 364.56 | instruction/ROM/fetch | asic\runs\etapa12_rom_ram_no_delay_ss\55-openroad-stapostpnr\max_ss_125C_4v50\checks.rpt | 578
slew | \u_pochoco_soc.genblk1.g_rom_ram_memory.u_ram.a_rdata_o[21] | _4966_/A1 | _8488_ | gf180mcu_fd_sc_mcu7t5v0__dffrnq_1 | Q | 10 | 3.136408 | 3.0 | -0.136408 | 465.36 | 376.32 | 262.64 | 360.64 | instruction/ROM/fetch | asic\runs\etapa12_rom_ram_no_delay_ss\55-openroad-stapostpnr\max_ss_125C_4v50\checks.rpt | 579
slew | \u_pochoco_soc.genblk1.g_rom_ram_memory.u_ram.a_rdata_o[21] | _4990_/A1 | _8488_ | gf180mcu_fd_sc_mcu7t5v0__dffrnq_1 | Q | 10 | 3.136407 | 3.0 | -0.136407 | 465.36 | 376.32 | 262.64 | 372.4 | instruction/ROM/fetch | asic\runs\etapa12_rom_ram_no_delay_ss\55-openroad-stapostpnr\max_ss_125C_4v50\checks.rpt | 580
slew | \u_pochoco_soc.genblk1.g_rom_ram_memory.u_ram.a_rdata_o[21] | _4983_/A1 | _8488_ | gf180mcu_fd_sc_mcu7t5v0__dffrnq_1 | Q | 10 | 3.136403 | 3.0 | -0.136403 | 465.36 | 376.32 | 264.88 | 376.32 | instruction/ROM/fetch | asic\runs\etapa12_rom_ram_no_delay_ss\55-openroad-stapostpnr\max_ss_125C_4v50\checks.rpt | 581
slew | \u_pochoco_soc.genblk1.g_rom_ram_memory.u_ram.a_rdata_o[21] | _4987_/A1 | _8488_ | gf180mcu_fd_sc_mcu7t5v0__dffrnq_1 | Q | 10 | 3.1364 | 3.0 | -0.136401 | 465.36 | 376.32 | 274.96 | 376.32 | instruction/ROM/fetch | asic\runs\etapa12_rom_ram_no_delay_ss\55-openroad-stapostpnr\max_ss_125C_4v50\checks.rpt | 582
slew | \u_pochoco_soc.genblk1.g_rom_ram_memory.u_ram.a_rdata_o[21] | _4231_/I | _8488_ | gf180mcu_fd_sc_mcu7t5v0__dffrnq_1 | Q | 10 | 3.136345 | 3.0 | -0.136345 | 465.36 | 376.32 | 463.12 | 376.32 | instruction/ROM/fetch | asic\runs\etapa12_rom_ram_no_delay_ss\55-openroad-stapostpnr\max_ss_125C_4v50\checks.rpt | 583
slew | \u_pochoco_soc.genblk1.g_rom_ram_memory.u_ram.a_rdata_o[21] | _4456_/B2 | _8488_ | gf180mcu_fd_sc_mcu7t5v0__dffrnq_1 | Q | 10 | 3.136345 | 3.0 | -0.136345 | 465.36 | 376.32 | 470.96 | 356.72 | instruction/ROM/fetch | asic\runs\etapa12_rom_ram_no_delay_ss\55-openroad-stapostpnr\max_ss_125C_4v50\checks.rpt | 584
slew | \u_pochoco_soc.genblk1.g_rom_ram_memory.u_ram.a_rdata_o[21] | _5802_/I0 | _8488_ | gf180mcu_fd_sc_mcu7t5v0__dffrnq_1 | Q | 10 | 3.136345 | 3.0 | -0.136345 | 465.36 | 376.32 | 476.0 | 360.64 | instruction/ROM/fetch | asic\runs\etapa12_rom_ram_no_delay_ss\55-openroad-stapostpnr\max_ss_125C_4v50\checks.rpt | 585
slew | \u_pochoco_soc.genblk1.g_rom_ram_memory.u_ram.a_rdata_o[21] | _8488_/Q | _8488_ | gf180mcu_fd_sc_mcu7t5v0__dffrnq_1 | Q | 10 | 3.136345 | 3.0 | -0.136345 | 465.36 | 376.32 | 465.36 | 376.32 | instruction/ROM/fetch | asic\runs\etapa12_rom_ram_no_delay_ss\55-openroad-stapostpnr\max_ss_125C_4v50\checks.rpt | 586
slew | _1071_ | _4456_/ZN | _4456_ | gf180mcu_fd_sc_mcu7t5v0__aoi221_1 | ZN | 1 | 3.132093 | 3.0 | -0.132093 | 470.96 | 356.72 | 470.96 | 356.72 | instruction/ROM/fetch | asic\runs\etapa12_rom_ram_no_delay_ss\55-openroad-stapostpnr\max_ss_125C_4v50\checks.rpt | 587
slew | _1071_ | _4457_/B | _4456_ | gf180mcu_fd_sc_mcu7t5v0__aoi221_1 | ZN | 1 | 3.132093 | 3.0 | -0.132093 | 470.96 | 356.72 | 472.08 | 231.28 | instruction/ROM/fetch | asic\runs\etapa12_rom_ram_no_delay_ss\55-openroad-stapostpnr\max_ss_125C_4v50\checks.rpt | 588
slew | _3547_ | _7169_/ZN | _7169_ | gf180mcu_fd_sc_mcu7t5v0__oai22_1 | ZN | 2 | 3.131243 | 3.0 | -0.131244 | 329.28 | 360.64 | 329.28 | 360.64 | instruction/ROM/fetch+data-memory+register-file+peripheral | asic\runs\etapa12_rom_ram_no_delay_ss\55-openroad-stapostpnr\max_ss_125C_4v50\checks.rpt | 589
slew | _3547_ | fanout33/I | _7169_ | gf180mcu_fd_sc_mcu7t5v0__oai22_1 | ZN | 2 | 3.131243 | 3.0 | -0.131244 | 329.28 | 360.64 | 188.72 | 344.96 | instruction/ROM/fetch+data-memory+register-file+peripheral | asic\runs\etapa12_rom_ram_no_delay_ss\55-openroad-stapostpnr\max_ss_125C_4v50\checks.rpt | 590
slew | _3547_ | fanout35/I | _7169_ | gf180mcu_fd_sc_mcu7t5v0__oai22_1 | ZN | 2 | 3.131243 | 3.0 | -0.131244 | 329.28 | 360.64 | 186.48 | 360.64 | instruction/ROM/fetch+data-memory+register-file+peripheral | asic\runs\etapa12_rom_ram_no_delay_ss\55-openroad-stapostpnr\max_ss_125C_4v50\checks.rpt | 591
slew | net983 | _5349_/A1 | fanout983 | gf180mcu_fd_sc_mcu7t5v0__buf_1 | Z | 10 | 3.121091 | 3.0 | -0.121092 | 408.8 | 427.28 | 267.12 | 454.72 | instruction/ROM/fetch | asic\runs\etapa12_rom_ram_no_delay_ss\55-openroad-stapostpnr\max_ss_125C_4v50\checks.rpt | 592
slew | net983 | _5346_/A1 | fanout983 | gf180mcu_fd_sc_mcu7t5v0__buf_1 | Z | 10 | 3.12109 | 3.0 | -0.12109 | 408.8 | 427.28 | 284.48 | 454.72 | instruction/ROM/fetch | asic\runs\etapa12_rom_ram_no_delay_ss\55-openroad-stapostpnr\max_ss_125C_4v50\checks.rpt | 593
slew | net983 | _5360_/A1 | fanout983 | gf180mcu_fd_sc_mcu7t5v0__buf_1 | Z | 10 | 3.121088 | 3.0 | -0.121088 | 408.8 | 427.28 | 266.56 | 450.8 | instruction/ROM/fetch | asic\runs\etapa12_rom_ram_no_delay_ss\55-openroad-stapostpnr\max_ss_125C_4v50\checks.rpt | 594
slew | net983 | _5364_/A1 | fanout983 | gf180mcu_fd_sc_mcu7t5v0__buf_1 | Z | 10 | 3.121085 | 3.0 | -0.121085 | 408.8 | 427.28 | 269.36 | 446.88 | instruction/ROM/fetch | asic\runs\etapa12_rom_ram_no_delay_ss\55-openroad-stapostpnr\max_ss_125C_4v50\checks.rpt | 595
slew | net983 | _5351_/A1 | fanout983 | gf180mcu_fd_sc_mcu7t5v0__buf_1 | Z | 10 | 3.121075 | 3.0 | -0.121075 | 408.8 | 427.28 | 273.28 | 439.04 | instruction/ROM/fetch | asic\runs\etapa12_rom_ram_no_delay_ss\55-openroad-stapostpnr\max_ss_125C_4v50\checks.rpt | 596
slew | net983 | _5344_/A1 | fanout983 | gf180mcu_fd_sc_mcu7t5v0__buf_1 | Z | 10 | 3.121075 | 3.0 | -0.121075 | 408.8 | 427.28 | 272.72 | 427.28 | instruction/ROM/fetch | asic\runs\etapa12_rom_ram_no_delay_ss\55-openroad-stapostpnr\max_ss_125C_4v50\checks.rpt | 597
slew | net983 | _5365_/A1 | fanout983 | gf180mcu_fd_sc_mcu7t5v0__buf_1 | Z | 10 | 3.121069 | 3.0 | -0.121069 | 408.8 | 427.28 | 282.8 | 439.04 | instruction/ROM/fetch | asic\runs\etapa12_rom_ram_no_delay_ss\55-openroad-stapostpnr\max_ss_125C_4v50\checks.rpt | 598
slew | net983 | _5343_/A1 | fanout983 | gf180mcu_fd_sc_mcu7t5v0__buf_1 | Z | 10 | 3.121066 | 3.0 | -0.121066 | 408.8 | 427.28 | 281.68 | 431.2 | instruction/ROM/fetch | asic\runs\etapa12_rom_ram_no_delay_ss\55-openroad-stapostpnr\max_ss_125C_4v50\checks.rpt | 599
slew | net983 | _4602_/A1 | fanout983 | gf180mcu_fd_sc_mcu7t5v0__buf_1 | Z | 10 | 3.12104 | 3.0 | -0.12104 | 408.8 | 427.28 | 354.48 | 364.56 | instruction/ROM/fetch | asic\runs\etapa12_rom_ram_no_delay_ss\55-openroad-stapostpnr\max_ss_125C_4v50\checks.rpt | 600
slew | net983 | _5996_/A1 | fanout983 | gf180mcu_fd_sc_mcu7t5v0__buf_1 | Z | 10 | 3.121023 | 3.0 | -0.121023 | 408.8 | 427.28 | 405.44 | 427.28 | instruction/ROM/fetch | asic\runs\etapa12_rom_ram_no_delay_ss\55-openroad-stapostpnr\max_ss_125C_4v50\checks.rpt | 601
slew | net983 | fanout983/Z | fanout983 | gf180mcu_fd_sc_mcu7t5v0__buf_1 | Z | 10 | 3.121023 | 3.0 | -0.121023 | 408.8 | 427.28 | 408.8 | 427.28 | instruction/ROM/fetch | asic\runs\etapa12_rom_ram_no_delay_ss\55-openroad-stapostpnr\max_ss_125C_4v50\checks.rpt | 602
slew | \u_pochoco_soc.genblk1.g_rom_ram_memory.u_ram.a_rdata_o[8] | _7448_/A1 | _8475_ | gf180mcu_fd_sc_mcu7t5v0__dffrnq_1 | Q | 9 | 3.118918 | 3.0 | -0.118918 | 410.48 | 474.32 | 264.32 | 466.48 | instruction/ROM/fetch | asic\runs\etapa12_rom_ram_no_delay_ss\55-openroad-stapostpnr\max_ss_125C_4v50\checks.rpt | 603
slew | \u_pochoco_soc.genblk1.g_rom_ram_memory.u_ram.a_rdata_o[8] | _7972_/A1 | _8475_ | gf180mcu_fd_sc_mcu7t5v0__dffrnq_1 | Q | 9 | 3.118918 | 3.0 | -0.118918 | 410.48 | 474.32 | 260.4 | 466.48 | instruction/ROM/fetch | asic\runs\etapa12_rom_ram_no_delay_ss\55-openroad-stapostpnr\max_ss_125C_4v50\checks.rpt | 604
slew | \u_pochoco_soc.genblk1.g_rom_ram_memory.u_ram.a_rdata_o[8] | _7252_/A1 | _8475_ | gf180mcu_fd_sc_mcu7t5v0__dffrnq_1 | Q | 9 | 3.118917 | 3.0 | -0.118917 | 410.48 | 474.32 | 269.36 | 470.4 | instruction/ROM/fetch | asic\runs\etapa12_rom_ram_no_delay_ss\55-openroad-stapostpnr\max_ss_125C_4v50\checks.rpt | 605
slew | \u_pochoco_soc.genblk1.g_rom_ram_memory.u_ram.a_rdata_o[8] | _7710_/A1 | _8475_ | gf180mcu_fd_sc_mcu7t5v0__dffrnq_1 | Q | 9 | 3.118917 | 3.0 | -0.118917 | 410.48 | 474.32 | 265.44 | 470.4 | instruction/ROM/fetch | asic\runs\etapa12_rom_ram_no_delay_ss\55-openroad-stapostpnr\max_ss_125C_4v50\checks.rpt | 606
slew | \u_pochoco_soc.genblk1.g_rom_ram_memory.u_ram.a_rdata_o[8] | _5802_/I1 | _8475_ | gf180mcu_fd_sc_mcu7t5v0__dffrnq_1 | Q | 9 | 3.118912 | 3.0 | -0.118912 | 410.48 | 474.32 | 476.0 | 360.64 | instruction/ROM/fetch | asic\runs\etapa12_rom_ram_no_delay_ss\55-openroad-stapostpnr\max_ss_125C_4v50\checks.rpt | 607
slew | \u_pochoco_soc.genblk1.g_rom_ram_memory.u_ram.a_rdata_o[8] | _4456_/A1 | _8475_ | gf180mcu_fd_sc_mcu7t5v0__dffrnq_1 | Q | 9 | 3.118912 | 3.0 | -0.118912 | 410.48 | 474.32 | 470.96 | 356.72 | instruction/ROM/fetch | asic\runs\etapa12_rom_ram_no_delay_ss\55-openroad-stapostpnr\max_ss_125C_4v50\checks.rpt | 608
slew | \u_pochoco_soc.genblk1.g_rom_ram_memory.u_ram.a_rdata_o[8] | _4239_/I | _8475_ | gf180mcu_fd_sc_mcu7t5v0__dffrnq_1 | Q | 9 | 3.118897 | 3.0 | -0.118897 | 410.48 | 474.32 | 408.24 | 474.32 | instruction/ROM/fetch | asic\runs\etapa12_rom_ram_no_delay_ss\55-openroad-stapostpnr\max_ss_125C_4v50\checks.rpt | 609
slew | \u_pochoco_soc.genblk1.g_rom_ram_memory.u_ram.a_rdata_o[8] | _6861_/A1 | _8475_ | gf180mcu_fd_sc_mcu7t5v0__dffrnq_1 | Q | 9 | 3.118897 | 3.0 | -0.118897 | 410.48 | 474.32 | 406.0 | 466.48 | instruction/ROM/fetch | asic\runs\etapa12_rom_ram_no_delay_ss\55-openroad-stapostpnr\max_ss_125C_4v50\checks.rpt | 610
slew | \u_pochoco_soc.genblk1.g_rom_ram_memory.u_ram.a_rdata_o[8] | _6865_/A1 | _8475_ | gf180mcu_fd_sc_mcu7t5v0__dffrnq_1 | Q | 9 | 3.118897 | 3.0 | -0.118897 | 410.48 | 474.32 | 411.04 | 470.4 | instruction/ROM/fetch | asic\runs\etapa12_rom_ram_no_delay_ss\55-openroad-stapostpnr\max_ss_125C_4v50\checks.rpt | 611
slew | \u_pochoco_soc.genblk1.g_rom_ram_memory.u_ram.a_rdata_o[8] | _8475_/Q | _8475_ | gf180mcu_fd_sc_mcu7t5v0__dffrnq_1 | Q | 9 | 3.118897 | 3.0 | -0.118897 | 410.48 | 474.32 | 410.48 | 474.32 | instruction/ROM/fetch | asic\runs\etapa12_rom_ram_no_delay_ss\55-openroad-stapostpnr\max_ss_125C_4v50\checks.rpt | 612
slew | \u_pochoco_soc.data_wdata[5] | _4479_/A1 | _9250_ | gf180mcu_fd_sc_mcu7t5v0__dffrnq_1 | Q | 6 | 3.114254 | 3.0 | -0.114254 | 278.32 | 266.56 | 511.28 | 286.16 | data-memory | asic\runs\etapa12_rom_ram_no_delay_ss\55-openroad-stapostpnr\max_ss_125C_4v50\checks.rpt | 613
slew | \u_pochoco_soc.data_wdata[5] | _8387_/I0 | _9250_ | gf180mcu_fd_sc_mcu7t5v0__dffrnq_1 | Q | 6 | 3.11424 | 3.0 | -0.11424 | 278.32 | 266.56 | 547.12 | 246.96 | data-memory | asic\runs\etapa12_rom_ram_no_delay_ss\55-openroad-stapostpnr\max_ss_125C_4v50\checks.rpt | 614
slew | \u_pochoco_soc.data_wdata[5] | _8272_/I0 | _9250_ | gf180mcu_fd_sc_mcu7t5v0__dffrnq_1 | Q | 6 | 3.114225 | 3.0 | -0.114226 | 278.32 | 266.56 | 556.64 | 199.92 | data-memory | asic\runs\etapa12_rom_ram_no_delay_ss\55-openroad-stapostpnr\max_ss_125C_4v50\checks.rpt | 615
slew | \u_pochoco_soc.data_wdata[5] | _6857_/I1 | _9250_ | gf180mcu_fd_sc_mcu7t5v0__dffrnq_1 | Q | 6 | 3.114182 | 3.0 | -0.114183 | 278.32 | 266.56 | 476.56 | 196.0 | data-memory | asic\runs\etapa12_rom_ram_no_delay_ss\55-openroad-stapostpnr\max_ss_125C_4v50\checks.rpt | 616
slew | \u_pochoco_soc.data_wdata[5] | _6791_/A1 | _9250_ | gf180mcu_fd_sc_mcu7t5v0__dffrnq_1 | Q | 6 | 3.114116 | 3.0 | -0.114116 | 278.32 | 266.56 | 366.24 | 192.08 | data-memory | asic\runs\etapa12_rom_ram_no_delay_ss\55-openroad-stapostpnr\max_ss_125C_4v50\checks.rpt | 617
slew | \u_pochoco_soc.data_wdata[5] | _6790_/A1 | _9250_ | gf180mcu_fd_sc_mcu7t5v0__dffrnq_1 | Q | 6 | 3.114057 | 3.0 | -0.114057 | 278.32 | 266.56 | 310.8 | 215.6 | data-memory | asic\runs\etapa12_rom_ram_no_delay_ss\55-openroad-stapostpnr\max_ss_125C_4v50\checks.rpt | 618
slew | \u_pochoco_soc.data_wdata[5] | _9250_/Q | _9250_ | gf180mcu_fd_sc_mcu7t5v0__dffrnq_1 | Q | 6 | 3.114025 | 3.0 | -0.114025 | 278.32 | 266.56 | 278.32 | 266.56 | data-memory | asic\runs\etapa12_rom_ram_no_delay_ss\55-openroad-stapostpnr\max_ss_125C_4v50\checks.rpt | 619
slew | _1397_ | _4782_/ZN | _4782_ | gf180mcu_fd_sc_mcu7t5v0__oai21_1 | ZN | 3 | 3.101119 | 3.0 | -0.101119 | 365.68 | 246.96 | 365.68 | 246.96 | instruction/ROM/fetch+data-memory+register-file | asic\runs\etapa12_rom_ram_no_delay_ss\55-openroad-stapostpnr\max_ss_125C_4v50\checks.rpt | 620
slew | _1397_ | _4789_/A1 | _4782_ | gf180mcu_fd_sc_mcu7t5v0__oai21_1 | ZN | 3 | 3.101119 | 3.0 | -0.101119 | 365.68 | 246.96 | 393.68 | 337.12 | instruction/ROM/fetch+data-memory+register-file | asic\runs\etapa12_rom_ram_no_delay_ss\55-openroad-stapostpnr\max_ss_125C_4v50\checks.rpt | 621
slew | _1397_ | _6015_/I0 | _4782_ | gf180mcu_fd_sc_mcu7t5v0__oai21_1 | ZN | 3 | 3.101119 | 3.0 | -0.101119 | 365.68 | 246.96 | 390.32 | 458.64 | instruction/ROM/fetch+data-memory+register-file | asic\runs\etapa12_rom_ram_no_delay_ss\55-openroad-stapostpnr\max_ss_125C_4v50\checks.rpt | 622
slew | _1397_ | _7078_/A2 | _4782_ | gf180mcu_fd_sc_mcu7t5v0__oai21_1 | ZN | 3 | 3.101119 | 3.0 | -0.101119 | 365.68 | 246.96 | 369.6 | 223.44 | instruction/ROM/fetch+data-memory+register-file | asic\runs\etapa12_rom_ram_no_delay_ss\55-openroad-stapostpnr\max_ss_125C_4v50\checks.rpt | 623
slew | _2352_ | _6542_/A1 | _5852_ | gf180mcu_fd_sc_mcu7t5v0__nand2_1 | ZN | 8 | 3.079942 | 3.0 | -0.079942 | 576.24 | 399.84 | 528.08 | 552.72 | other-combinational | asic\runs\etapa12_rom_ram_no_delay_ss\55-openroad-stapostpnr\max_ss_125C_4v50\checks.rpt | 624
slew | _2352_ | _6246_/A2 | _5852_ | gf180mcu_fd_sc_mcu7t5v0__nand2_1 | ZN | 8 | 3.079942 | 3.0 | -0.079942 | 576.24 | 399.84 | 544.32 | 556.64 | other-combinational | asic\runs\etapa12_rom_ram_no_delay_ss\55-openroad-stapostpnr\max_ss_125C_4v50\checks.rpt | 625
slew | _2352_ | _6654_/A2 | _5852_ | gf180mcu_fd_sc_mcu7t5v0__nand2_1 | ZN | 8 | 3.079931 | 3.0 | -0.079931 | 576.24 | 399.84 | 538.72 | 505.68 | other-combinational | asic\runs\etapa12_rom_ram_no_delay_ss\55-openroad-stapostpnr\max_ss_125C_4v50\checks.rpt | 626
slew | _2352_ | _6298_/A1 | _5852_ | gf180mcu_fd_sc_mcu7t5v0__nand2_1 | ZN | 8 | 3.079906 | 3.0 | -0.079906 | 576.24 | 399.84 | 570.64 | 474.32 | other-combinational | asic\runs\etapa12_rom_ram_no_delay_ss\55-openroad-stapostpnr\max_ss_125C_4v50\checks.rpt | 627
slew | _2352_ | _6472_/A3 | _5852_ | gf180mcu_fd_sc_mcu7t5v0__nand2_1 | ZN | 8 | 3.079894 | 3.0 | -0.079894 | 576.24 | 399.84 | 568.4 | 454.72 | other-combinational | asic\runs\etapa12_rom_ram_no_delay_ss\55-openroad-stapostpnr\max_ss_125C_4v50\checks.rpt | 628
slew | _2352_ | _6428_/A1 | _5852_ | gf180mcu_fd_sc_mcu7t5v0__nand2_1 | ZN | 8 | 3.079882 | 3.0 | -0.079882 | 576.24 | 399.84 | 571.2 | 450.8 | other-combinational | asic\runs\etapa12_rom_ram_no_delay_ss\55-openroad-stapostpnr\max_ss_125C_4v50\checks.rpt | 629
slew | _2352_ | _5852_/ZN | _5852_ | gf180mcu_fd_sc_mcu7t5v0__nand2_1 | ZN | 8 | 3.079858 | 3.0 | -0.079858 | 576.24 | 399.84 | 576.24 | 399.84 | other-combinational | asic\runs\etapa12_rom_ram_no_delay_ss\55-openroad-stapostpnr\max_ss_125C_4v50\checks.rpt | 630
slew | _2352_ | _5853_/A2 | _5852_ | gf180mcu_fd_sc_mcu7t5v0__nand2_1 | ZN | 8 | 3.079858 | 3.0 | -0.079858 | 576.24 | 399.84 | 525.28 | 395.92 | other-combinational | asic\runs\etapa12_rom_ram_no_delay_ss\55-openroad-stapostpnr\max_ss_125C_4v50\checks.rpt | 631
slew | _2352_ | _6245_/A2 | _5852_ | gf180mcu_fd_sc_mcu7t5v0__nand2_1 | ZN | 8 | 3.079858 | 3.0 | -0.079858 | 576.24 | 399.84 | 559.44 | 399.84 | other-combinational | asic\runs\etapa12_rom_ram_no_delay_ss\55-openroad-stapostpnr\max_ss_125C_4v50\checks.rpt | 632
slew | _1464_ | _4849_/ZN | _4849_ | gf180mcu_fd_sc_mcu7t5v0__aoi211_1 | ZN | 3 | 3.078716 | 3.0 | -0.078716 | 488.88 | 266.56 | 488.88 | 266.56 | instruction/ROM/fetch+data-memory+register-file | asic\runs\etapa12_rom_ram_no_delay_ss\55-openroad-stapostpnr\max_ss_125C_4v50\checks.rpt | 633
slew | _1464_ | _4861_/A2 | _4849_ | gf180mcu_fd_sc_mcu7t5v0__aoi211_1 | ZN | 3 | 3.078716 | 3.0 | -0.078716 | 488.88 | 266.56 | 490.0 | 317.52 | instruction/ROM/fetch+data-memory+register-file | asic\runs\etapa12_rom_ram_no_delay_ss\55-openroad-stapostpnr\max_ss_125C_4v50\checks.rpt | 634
slew | _1464_ | _5891_/A1 | _4849_ | gf180mcu_fd_sc_mcu7t5v0__aoi211_1 | ZN | 3 | 3.078716 | 3.0 | -0.078716 | 488.88 | 266.56 | 509.6 | 321.44 | instruction/ROM/fetch+data-memory+register-file | asic\runs\etapa12_rom_ram_no_delay_ss\55-openroad-stapostpnr\max_ss_125C_4v50\checks.rpt | 635
slew | _1464_ | _7000_/B2 | _4849_ | gf180mcu_fd_sc_mcu7t5v0__aoi211_1 | ZN | 3 | 3.078716 | 3.0 | -0.078716 | 488.88 | 266.56 | 481.6 | 258.72 | instruction/ROM/fetch+data-memory+register-file | asic\runs\etapa12_rom_ram_no_delay_ss\55-openroad-stapostpnr\max_ss_125C_4v50\checks.rpt | 636
slew | \u_pochoco_soc.genblk1.g_rom_ram_memory.u_ram.a_rdata_o[10] | _6864_/A1 | _8477_ | gf180mcu_fd_sc_mcu7t5v0__dffrnq_1 | Q | 8 | 3.075047 | 3.0 | -0.075047 | 431.76 | 525.28 | 286.72 | 462.56 | instruction/ROM/fetch | asic\runs\etapa12_rom_ram_no_delay_ss\55-openroad-stapostpnr\max_ss_125C_4v50\checks.rpt | 637
slew | \u_pochoco_soc.genblk1.g_rom_ram_memory.u_ram.a_rdata_o[10] | _7382_/A1 | _8477_ | gf180mcu_fd_sc_mcu7t5v0__dffrnq_1 | Q | 8 | 3.075047 | 3.0 | -0.075047 | 431.76 | 525.28 | 283.92 | 466.48 | instruction/ROM/fetch | asic\runs\etapa12_rom_ram_no_delay_ss\55-openroad-stapostpnr\max_ss_125C_4v50\checks.rpt | 638
slew | \u_pochoco_soc.genblk1.g_rom_ram_memory.u_ram.a_rdata_o[10] | _4237_/I | _8477_ | gf180mcu_fd_sc_mcu7t5v0__dffrnq_1 | Q | 8 | 3.075046 | 3.0 | -0.075046 | 431.76 | 525.28 | 291.2 | 474.32 | instruction/ROM/fetch | asic\runs\etapa12_rom_ram_no_delay_ss\55-openroad-stapostpnr\max_ss_125C_4v50\checks.rpt | 639
slew | \u_pochoco_soc.genblk1.g_rom_ram_memory.u_ram.a_rdata_o[10] | _7317_/A1 | _8477_ | gf180mcu_fd_sc_mcu7t5v0__dffrnq_1 | Q | 8 | 3.075046 | 3.0 | -0.075046 | 431.76 | 525.28 | 294.0 | 466.48 | instruction/ROM/fetch | asic\runs\etapa12_rom_ram_no_delay_ss\55-openroad-stapostpnr\max_ss_125C_4v50\checks.rpt | 640
slew | \u_pochoco_soc.genblk1.g_rom_ram_memory.u_ram.a_rdata_o[10] | _4439_/A1 | _8477_ | gf180mcu_fd_sc_mcu7t5v0__dffrnq_1 | Q | 8 | 3.075032 | 3.0 | -0.075032 | 431.76 | 525.28 | 470.96 | 360.64 | instruction/ROM/fetch | asic\runs\etapa12_rom_ram_no_delay_ss\55-openroad-stapostpnr\max_ss_125C_4v50\checks.rpt | 641
slew | \u_pochoco_soc.genblk1.g_rom_ram_memory.u_ram.a_rdata_o[10] | _5821_/A1 | _8477_ | gf180mcu_fd_sc_mcu7t5v0__dffrnq_1 | Q | 8 | 3.075032 | 3.0 | -0.075032 | 431.76 | 525.28 | 474.88 | 368.48 | instruction/ROM/fetch | asic\runs\etapa12_rom_ram_no_delay_ss\55-openroad-stapostpnr\max_ss_125C_4v50\checks.rpt | 642
slew | \u_pochoco_soc.genblk1.g_rom_ram_memory.u_ram.a_rdata_o[10] | _6860_/A1 | _8477_ | gf180mcu_fd_sc_mcu7t5v0__dffrnq_1 | Q | 8 | 3.075023 | 3.0 | -0.075023 | 431.76 | 525.28 | 409.92 | 462.56 | instruction/ROM/fetch | asic\runs\etapa12_rom_ram_no_delay_ss\55-openroad-stapostpnr\max_ss_125C_4v50\checks.rpt | 643
slew | \u_pochoco_soc.genblk1.g_rom_ram_memory.u_ram.a_rdata_o[10] | _6468_/B2 | _8477_ | gf180mcu_fd_sc_mcu7t5v0__dffrnq_1 | Q | 8 | 3.075006 | 3.0 | -0.075006 | 431.76 | 525.28 | 450.24 | 521.36 | instruction/ROM/fetch | asic\runs\etapa12_rom_ram_no_delay_ss\55-openroad-stapostpnr\max_ss_125C_4v50\checks.rpt | 644
slew | \u_pochoco_soc.genblk1.g_rom_ram_memory.u_ram.a_rdata_o[10] | _8477_/Q | _8477_ | gf180mcu_fd_sc_mcu7t5v0__dffrnq_1 | Q | 8 | 3.075006 | 3.0 | -0.075006 | 431.76 | 525.28 | 431.76 | 525.28 | instruction/ROM/fetch | asic\runs\etapa12_rom_ram_no_delay_ss\55-openroad-stapostpnr\max_ss_125C_4v50\checks.rpt | 645
slew | _0869_ | _6766_/A1 | _4221_ | gf180mcu_fd_sc_mcu7t5v0__clkinv_1 | ZN | 7 | 3.057533 | 3.0 | -0.057533 | 418.32 | 388.08 | 369.04 | 192.08 | instruction/ROM/fetch | asic\runs\etapa12_rom_ram_no_delay_ss\55-openroad-stapostpnr\max_ss_125C_4v50\checks.rpt | 646
slew | _0869_ | _6754_/A1 | _4221_ | gf180mcu_fd_sc_mcu7t5v0__clkinv_1 | ZN | 7 | 3.05753 | 3.0 | -0.05753 | 418.32 | 388.08 | 372.96 | 196.0 | instruction/ROM/fetch | asic\runs\etapa12_rom_ram_no_delay_ss\55-openroad-stapostpnr\max_ss_125C_4v50\checks.rpt | 647
slew | _0869_ | _7056_/A1 | _4221_ | gf180mcu_fd_sc_mcu7t5v0__clkinv_1 | ZN | 7 | 3.057513 | 3.0 | -0.057513 | 418.32 | 388.08 | 391.44 | 219.52 | instruction/ROM/fetch | asic\runs\etapa12_rom_ram_no_delay_ss\55-openroad-stapostpnr\max_ss_125C_4v50\checks.rpt | 648
slew | _2750_ | _6575_/A2 | _6283_ | gf180mcu_fd_sc_mcu7t5v0__nor2_1 | ZN | 6 | 3.057486 | 3.0 | -0.057486 | 529.2 | 423.36 | 497.28 | 490.0 | other-combinational | asic\runs\etapa12_rom_ram_no_delay_ss\55-openroad-stapostpnr\max_ss_125C_4v50\checks.rpt | 649
slew | _2750_ | _6557_/B | _6283_ | gf180mcu_fd_sc_mcu7t5v0__nor2_1 | ZN | 6 | 3.057485 | 3.0 | -0.057485 | 529.2 | 423.36 | 522.48 | 493.92 | other-combinational | asic\runs\etapa12_rom_ram_no_delay_ss\55-openroad-stapostpnr\max_ss_125C_4v50\checks.rpt | 650
slew | _2750_ | _6587_/C | _6283_ | gf180mcu_fd_sc_mcu7t5v0__nor2_1 | ZN | 6 | 3.057482 | 3.0 | -0.057482 | 529.2 | 423.36 | 528.64 | 462.56 | other-combinational | asic\runs\etapa12_rom_ram_no_delay_ss\55-openroad-stapostpnr\max_ss_125C_4v50\checks.rpt | 651
slew | _0869_ | _4406_/B | _4221_ | gf180mcu_fd_sc_mcu7t5v0__clkinv_1 | ZN | 7 | 3.057479 | 3.0 | -0.057479 | 418.32 | 388.08 | 447.44 | 305.76 | instruction/ROM/fetch | asic\runs\etapa12_rom_ram_no_delay_ss\55-openroad-stapostpnr\max_ss_125C_4v50\checks.rpt | 652
slew | _0869_ | _4409_/A1 | _4221_ | gf180mcu_fd_sc_mcu7t5v0__clkinv_1 | ZN | 7 | 3.057479 | 3.0 | -0.057479 | 418.32 | 388.08 | 448.0 | 297.92 | instruction/ROM/fetch | asic\runs\etapa12_rom_ram_no_delay_ss\55-openroad-stapostpnr\max_ss_125C_4v50\checks.rpt | 653
slew | _2750_ | _6283_/ZN | _6283_ | gf180mcu_fd_sc_mcu7t5v0__nor2_1 | ZN | 6 | 3.057472 | 3.0 | -0.057472 | 529.2 | 423.36 | 529.2 | 423.36 | other-combinational | asic\runs\etapa12_rom_ram_no_delay_ss\55-openroad-stapostpnr\max_ss_125C_4v50\checks.rpt | 654
slew | _2750_ | _6488_/A1 | _6283_ | gf180mcu_fd_sc_mcu7t5v0__nor2_1 | ZN | 6 | 3.057472 | 3.0 | -0.057472 | 529.2 | 423.36 | 518.0 | 450.8 | other-combinational | asic\runs\etapa12_rom_ram_no_delay_ss\55-openroad-stapostpnr\max_ss_125C_4v50\checks.rpt | 655
slew | _2750_ | _6496_/B | _6283_ | gf180mcu_fd_sc_mcu7t5v0__nor2_1 | ZN | 6 | 3.057472 | 3.0 | -0.057472 | 529.2 | 423.36 | 526.4 | 427.28 | other-combinational | asic\runs\etapa12_rom_ram_no_delay_ss\55-openroad-stapostpnr\max_ss_125C_4v50\checks.rpt | 656
slew | _2750_ | _6720_/A1 | _6283_ | gf180mcu_fd_sc_mcu7t5v0__nor2_1 | ZN | 6 | 3.057472 | 3.0 | -0.057472 | 529.2 | 423.36 | 520.24 | 427.28 | other-combinational | asic\runs\etapa12_rom_ram_no_delay_ss\55-openroad-stapostpnr\max_ss_125C_4v50\checks.rpt | 657
slew | _0869_ | _4542_/A1 | _4221_ | gf180mcu_fd_sc_mcu7t5v0__clkinv_1 | ZN | 7 | 3.057462 | 3.0 | -0.057462 | 418.32 | 388.08 | 409.92 | 317.52 | instruction/ROM/fetch | asic\runs\etapa12_rom_ram_no_delay_ss\55-openroad-stapostpnr\max_ss_125C_4v50\checks.rpt | 658
slew | _0869_ | _4221_/ZN | _4221_ | gf180mcu_fd_sc_mcu7t5v0__clkinv_1 | ZN | 7 | 3.057446 | 3.0 | -0.057446 | 418.32 | 388.08 | 418.32 | 388.08 | instruction/ROM/fetch | asic\runs\etapa12_rom_ram_no_delay_ss\55-openroad-stapostpnr\max_ss_125C_4v50\checks.rpt | 659
slew | _0869_ | _6503_/A1 | _4221_ | gf180mcu_fd_sc_mcu7t5v0__clkinv_1 | ZN | 7 | 3.057446 | 3.0 | -0.057446 | 418.32 | 388.08 | 451.92 | 392.0 | instruction/ROM/fetch | asic\runs\etapa12_rom_ram_no_delay_ss\55-openroad-stapostpnr\max_ss_125C_4v50\checks.rpt | 660
slew | _3554_ | fanout32/I | _7177_ | gf180mcu_fd_sc_mcu7t5v0__aoi211_2 | ZN | 2 | 3.054513 | 3.0 | -0.054513 | 344.96 | 364.56 | 160.16 | 458.64 | instruction/ROM/fetch+data-memory+register-file+peripheral | asic\runs\etapa12_rom_ram_no_delay_ss\55-openroad-stapostpnr\max_ss_125C_4v50\checks.rpt | 661
slew | _3554_ | _7177_/ZN | _7177_ | gf180mcu_fd_sc_mcu7t5v0__aoi211_2 | ZN | 2 | 3.054512 | 3.0 | -0.054512 | 344.96 | 364.56 | 344.96 | 364.56 | instruction/ROM/fetch+data-memory+register-file+peripheral | asic\runs\etapa12_rom_ram_no_delay_ss\55-openroad-stapostpnr\max_ss_125C_4v50\checks.rpt | 662
slew | _3554_ | fanout30/I | _7177_ | gf180mcu_fd_sc_mcu7t5v0__aoi211_2 | ZN | 2 | 3.054512 | 3.0 | -0.054512 | 344.96 | 364.56 | 133.84 | 395.92 | instruction/ROM/fetch+data-memory+register-file+peripheral | asic\runs\etapa12_rom_ram_no_delay_ss\55-openroad-stapostpnr\max_ss_125C_4v50\checks.rpt | 663
slew | _3400_ | _7001_/ZN | _7001_ | gf180mcu_fd_sc_mcu7t5v0__aoi21_1 | ZN | 2 | 3.050874 | 3.0 | -0.050875 | 433.44 | 203.84 | 433.44 | 203.84 | instruction/ROM/fetch+data-memory+register-file+peripheral | asic\runs\etapa12_rom_ram_no_delay_ss\55-openroad-stapostpnr\max_ss_125C_4v50\checks.rpt | 664
slew | _3400_ | fanout107/I | _7001_ | gf180mcu_fd_sc_mcu7t5v0__aoi21_1 | ZN | 2 | 3.050874 | 3.0 | -0.050875 | 433.44 | 203.84 | 206.64 | 246.96 | instruction/ROM/fetch+data-memory+register-file+peripheral | asic\runs\etapa12_rom_ram_no_delay_ss\55-openroad-stapostpnr\max_ss_125C_4v50\checks.rpt | 665
slew | _3400_ | fanout109/I | _7001_ | gf180mcu_fd_sc_mcu7t5v0__aoi21_1 | ZN | 2 | 3.050874 | 3.0 | -0.050875 | 433.44 | 203.84 | 188.16 | 199.92 | instruction/ROM/fetch+data-memory+register-file+peripheral | asic\runs\etapa12_rom_ram_no_delay_ss\55-openroad-stapostpnr\max_ss_125C_4v50\checks.rpt | 666
slew | \u_pochoco_soc.genblk1.g_rom_ram_memory.u_ram.a_rdata_o[17] | _4611_/A1 | _8484_ | gf180mcu_fd_sc_mcu7t5v0__dffrnq_1 | Q | 8 | 3.044669 | 3.0 | -0.044669 | 425.6 | 509.6 | 330.96 | 376.32 | instruction/ROM/fetch | asic\runs\etapa12_rom_ram_no_delay_ss\55-openroad-stapostpnr\max_ss_125C_4v50\checks.rpt | 667
slew | \u_pochoco_soc.genblk1.g_rom_ram_memory.u_ram.a_rdata_o[17] | _5342_/A2 | _8484_ | gf180mcu_fd_sc_mcu7t5v0__dffrnq_1 | Q | 8 | 3.044643 | 3.0 | -0.044643 | 425.6 | 509.6 | 283.92 | 435.12 | instruction/ROM/fetch | asic\runs\etapa12_rom_ram_no_delay_ss\55-openroad-stapostpnr\max_ss_125C_4v50\checks.rpt | 668
slew | \u_pochoco_soc.genblk1.g_rom_ram_memory.u_ram.a_rdata_o[17] | _5353_/A2 | _8484_ | gf180mcu_fd_sc_mcu7t5v0__dffrnq_1 | Q | 8 | 3.044641 | 3.0 | -0.044641 | 425.6 | 509.6 | 285.04 | 442.96 | instruction/ROM/fetch | asic\runs\etapa12_rom_ram_no_delay_ss\55-openroad-stapostpnr\max_ss_125C_4v50\checks.rpt | 669
slew | \u_pochoco_soc.genblk1.g_rom_ram_memory.u_ram.a_rdata_o[17] | _5347_/A2 | _8484_ | gf180mcu_fd_sc_mcu7t5v0__dffrnq_1 | Q | 8 | 3.044634 | 3.0 | -0.044634 | 425.6 | 509.6 | 285.6 | 446.88 | instruction/ROM/fetch | asic\runs\etapa12_rom_ram_no_delay_ss\55-openroad-stapostpnr\max_ss_125C_4v50\checks.rpt | 670
slew | \u_pochoco_soc.genblk1.g_rom_ram_memory.u_ram.a_rdata_o[17] | _5356_/A2 | _8484_ | gf180mcu_fd_sc_mcu7t5v0__dffrnq_1 | Q | 8 | 3.044631 | 3.0 | -0.044631 | 425.6 | 509.6 | 289.52 | 450.8 | instruction/ROM/fetch | asic\runs\etapa12_rom_ram_no_delay_ss\55-openroad-stapostpnr\max_ss_125C_4v50\checks.rpt | 671
slew | \u_pochoco_soc.genblk1.g_rom_ram_memory.u_ram.a_rdata_o[17] | _6009_/A1 | _8484_ | gf180mcu_fd_sc_mcu7t5v0__dffrnq_1 | Q | 8 | 3.044588 | 3.0 | -0.044588 | 425.6 | 509.6 | 404.32 | 442.96 | instruction/ROM/fetch | asic\runs\etapa12_rom_ram_no_delay_ss\55-openroad-stapostpnr\max_ss_125C_4v50\checks.rpt | 672
slew | \u_pochoco_soc.genblk1.g_rom_ram_memory.u_ram.a_rdata_o[17] | _6008_/A1 | _8484_ | gf180mcu_fd_sc_mcu7t5v0__dffrnq_1 | Q | 8 | 3.044582 | 3.0 | -0.044582 | 425.6 | 509.6 | 409.92 | 442.96 | instruction/ROM/fetch | asic\runs\etapa12_rom_ram_no_delay_ss\55-openroad-stapostpnr\max_ss_125C_4v50\checks.rpt | 673
slew | \u_pochoco_soc.genblk1.g_rom_ram_memory.u_ram.a_rdata_o[17] | _6580_/A1 | _8484_ | gf180mcu_fd_sc_mcu7t5v0__dffrnq_1 | Q | 8 | 3.044556 | 3.0 | -0.044556 | 425.6 | 509.6 | 439.04 | 513.52 | instruction/ROM/fetch | asic\runs\etapa12_rom_ram_no_delay_ss\55-openroad-stapostpnr\max_ss_125C_4v50\checks.rpt | 674
slew | \u_pochoco_soc.genblk1.g_rom_ram_memory.u_ram.a_rdata_o[17] | _8484_/Q | _8484_ | gf180mcu_fd_sc_mcu7t5v0__dffrnq_1 | Q | 8 | 3.044556 | 3.0 | -0.044556 | 425.6 | 509.6 | 425.6 | 509.6 | instruction/ROM/fetch | asic\runs\etapa12_rom_ram_no_delay_ss\55-openroad-stapostpnr\max_ss_125C_4v50\checks.rpt | 675
slew | \u_pochoco_soc.u_core.pc_id[17] | _4608_/A1 | _9028_ | gf180mcu_fd_sc_mcu7t5v0__dffrnq_1 | Q | 8 | 3.042139 | 3.0 | -0.042139 | 395.92 | 486.08 | 336.56 | 231.28 | instruction/ROM/fetch | asic\runs\etapa12_rom_ram_no_delay_ss\55-openroad-stapostpnr\max_ss_125C_4v50\checks.rpt | 676
slew | \u_pochoco_soc.u_core.pc_id[17] | _7083_/A2 | _9028_ | gf180mcu_fd_sc_mcu7t5v0__dffrnq_1 | Q | 8 | 3.042136 | 3.0 | -0.042136 | 395.92 | 486.08 | 360.08 | 227.36 | instruction/ROM/fetch | asic\runs\etapa12_rom_ram_no_delay_ss\55-openroad-stapostpnr\max_ss_125C_4v50\checks.rpt | 677
slew | \u_pochoco_soc.u_core.pc_id[17] | _7084_/A1 | _9028_ | gf180mcu_fd_sc_mcu7t5v0__dffrnq_1 | Q | 8 | 3.042136 | 3.0 | -0.042136 | 395.92 | 486.08 | 365.68 | 227.36 | instruction/ROM/fetch | asic\runs\etapa12_rom_ram_no_delay_ss\55-openroad-stapostpnr\max_ss_125C_4v50\checks.rpt | 678
slew | \u_pochoco_soc.u_core.pc_id[17] | _7076_/A1 | _9028_ | gf180mcu_fd_sc_mcu7t5v0__dffrnq_1 | Q | 8 | 3.042135 | 3.0 | -0.042135 | 395.92 | 486.08 | 370.16 | 227.36 | instruction/ROM/fetch | asic\runs\etapa12_rom_ram_no_delay_ss\55-openroad-stapostpnr\max_ss_125C_4v50\checks.rpt | 679
slew | \u_pochoco_soc.u_core.pc_id[17] | _7077_/A1 | _9028_ | gf180mcu_fd_sc_mcu7t5v0__dffrnq_1 | Q | 8 | 3.042135 | 3.0 | -0.042135 | 395.92 | 486.08 | 374.64 | 227.36 | instruction/ROM/fetch | asic\runs\etapa12_rom_ram_no_delay_ss\55-openroad-stapostpnr\max_ss_125C_4v50\checks.rpt | 680
slew | \u_pochoco_soc.u_core.pc_id[17] | _6010_/A1 | _9028_ | gf180mcu_fd_sc_mcu7t5v0__dffrnq_1 | Q | 8 | 3.042057 | 3.0 | -0.042057 | 395.92 | 486.08 | 405.44 | 446.88 | instruction/ROM/fetch | asic\runs\etapa12_rom_ram_no_delay_ss\55-openroad-stapostpnr\max_ss_125C_4v50\checks.rpt | 681
slew | \u_pochoco_soc.u_core.pc_id[17] | _6009_/C | _9028_ | gf180mcu_fd_sc_mcu7t5v0__dffrnq_1 | Q | 8 | 3.042057 | 3.0 | -0.042057 | 395.92 | 486.08 | 404.32 | 442.96 | instruction/ROM/fetch | asic\runs\etapa12_rom_ram_no_delay_ss\55-openroad-stapostpnr\max_ss_125C_4v50\checks.rpt | 682
slew | \u_pochoco_soc.u_core.pc_id[17] | _8131_/I0 | _9028_ | gf180mcu_fd_sc_mcu7t5v0__dffrnq_1 | Q | 8 | 3.042046 | 3.0 | -0.042046 | 395.92 | 486.08 | 399.84 | 490.0 | instruction/ROM/fetch | asic\runs\etapa12_rom_ram_no_delay_ss\55-openroad-stapostpnr\max_ss_125C_4v50\checks.rpt | 683
slew | \u_pochoco_soc.u_core.pc_id[17] | _9028_/Q | _9028_ | gf180mcu_fd_sc_mcu7t5v0__dffrnq_1 | Q | 8 | 3.042046 | 3.0 | -0.042046 | 395.92 | 486.08 | 395.92 | 486.08 | instruction/ROM/fetch | asic\runs\etapa12_rom_ram_no_delay_ss\55-openroad-stapostpnr\max_ss_125C_4v50\checks.rpt | 684
slew | _1570_ | fanout873/I | _4988_ | gf180mcu_fd_sc_mcu7t5v0__nor2_2 | ZN | 4 | 3.040383 | 3.0 | -0.040383 | 263.2 | 364.56 | 263.76 | 145.04 | instruction/ROM/fetch | asic\runs\etapa12_rom_ram_no_delay_ss\55-openroad-stapostpnr\max_ss_125C_4v50\checks.rpt | 685
slew | _1570_ | fanout876/I | _4988_ | gf180mcu_fd_sc_mcu7t5v0__nor2_2 | ZN | 4 | 3.040366 | 3.0 | -0.040367 | 263.2 | 364.56 | 245.28 | 274.4 | instruction/ROM/fetch | asic\runs\etapa12_rom_ram_no_delay_ss\55-openroad-stapostpnr\max_ss_125C_4v50\checks.rpt | 686
slew | _1570_ | fanout881/I | _4988_ | gf180mcu_fd_sc_mcu7t5v0__nor2_2 | ZN | 4 | 3.040366 | 3.0 | -0.040366 | 263.2 | 364.56 | 234.08 | 497.84 | instruction/ROM/fetch | asic\runs\etapa12_rom_ram_no_delay_ss\55-openroad-stapostpnr\max_ss_125C_4v50\checks.rpt | 687
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
