eaponce1/Proyecto3_Arquitectura_de_Computadores_Grupo_1/reports/entrega/stage21_external_compare_results.csv

case | status | cycles_checked | rtl_result | gate_result | mismatches | notes
reset_idle_button_smoke | PASS | 208 | observable outputs matched | observable outputs matched | 0 | 8-cycle external button pulse; same reset and SPI inputs
round_correct | NOT_COVERED |  |  |  |  | Requires 30000000-cycle ASIC warm-up and external debounce
wrong_button | NOT_COVERED |  |  |  |  | Requires 30000000-cycle ASIC warm-up and external debounce
ten_rounds | NOT_COVERED |  |  |  |  | Requires full real-time game execution
