eaponce1/Proyecto3_Arquitectura_de_Computadores_Grupo_1/docs/informe_proyecto3/figuras/pochoco_soc.pdf

## ALU

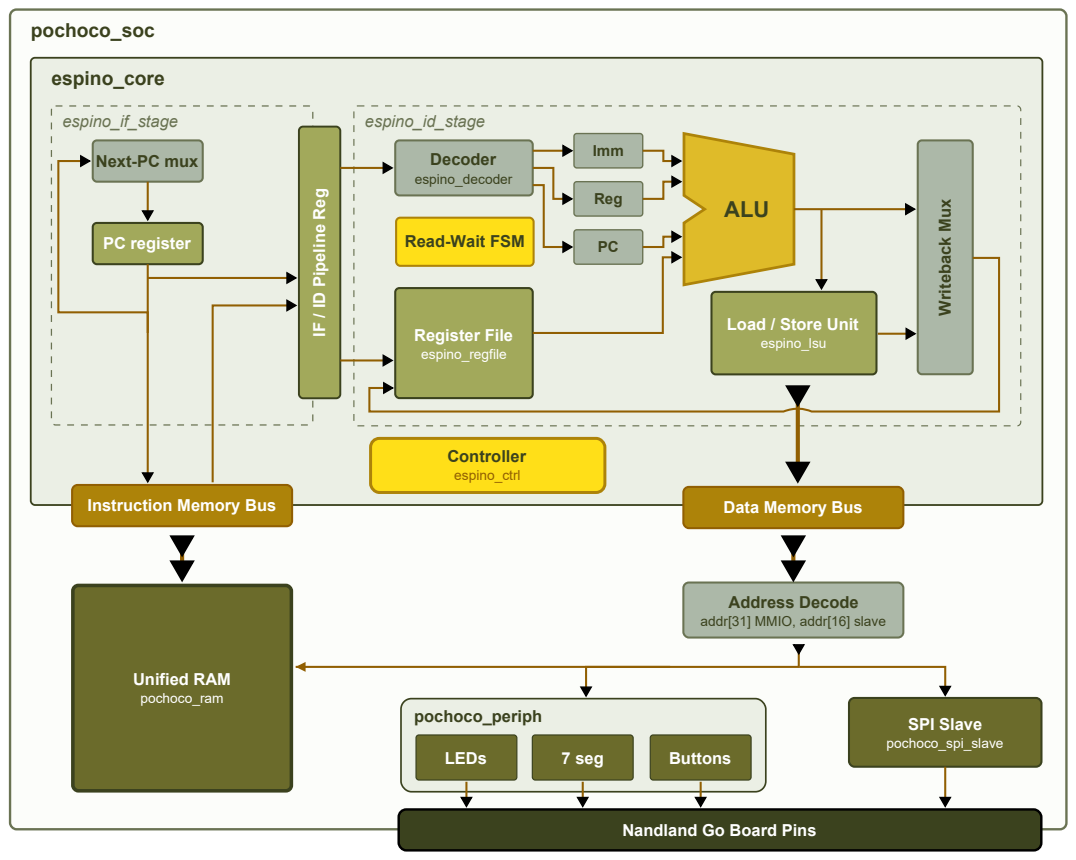
[picture p6: page 1]
pochoco_soc; espino_core; espino_if_stage; PC register; espino_id_stage; Decoder espino_decoder; Register File espino_regfile; Imm; Reg; Writeback Mux; Controller espino_ctrl; Instruction Memory Bus; Data Memory Bus; Unified RAM pochoco_ram; pochoco_periph; LEDs; 7 seg; Buttons; SPI Slave pochoco_spi_slave

Next-PC mux

IF / ID Pipeline Reg

Read-Wait FSM

Load / Store Unit
espino_lsu

Address Decode
addr[31] MMIO, addr[16] slave

Nandland Go Board Pins
