eaponce1/Proyecto3_Arquitectura_de_Computadores_Grupo_1/(commit log)

2026-10-31 Consolidate Proyecto 3 ASIC delivery
    [baseline_residual_pins.csv, classified.csv, comparison.csv, corners.csv, electrical_partitioned.csv, electrical_util40_debounce.csv, etapa6_baseline_top10.csv, etapa6_trazabilidad.csv]
2026-10-31 Actualiza documentación y organiza PDF final de entrega
2026-10-31 Mejora tabla de signoff y clarifica trazabilidad técnica
2026-10-31 Actualiza guía de compilación y estado de cierre ASIC
2026-10-31 Corrige validación de PDF para GitHub Actions
2026-11-01 Documenta barrido temporal consolidado de memoria unificada
2026-11-01 Añade datos CSV del barrido temporal de memoria unificada
    [unified_ff_frequency_sweep.csv]
2026-11-01 Corrige columnas de hold del CSV de Etapa 25
    [unified_ff_frequency_sweep.csv]
2026-11-01 Integra resultados verificados del barrido Etapa 25 en el informe
2026-11-01 Actualiza README con resultados del barrido de memoria unificada
2026-11-01 Actualiza auditoría de entrega con resultados Etapa 25
2026-11-01 Añade trazabilidad física de register file, contador y frontera ALU
2026-11-01 Actualiza estado de trazabilidad física y deja explícita verificación de procedencia
2026-11-01 Agrega resumen de coordenadas de trazabilidad física
    [layout_trace_coordinates.csv]
2026-11-01 Corrige identificador de corner para compilar informe
2026-11-01 Mejora saltos de línea de rutas en informe LaTeX
2026-11-01 Agrega regresión RTL al pipeline de entrega
2026-11-01 Amplía disparadores de CI a RTL y pruebas
2026-11-01 Ajusta tablas y saltos de línea del informe
2026-11-01 Corrige alineación de tabla de timing LaTeX
2026-11-01 Mejora legibilidad y precisión de trazabilidad Etapa 21
2026-11-01 Corrige envolvente de frontera ALU desde DEF
    [layout_trace_coordinates.csv]
2026-11-01 Documenta verificación parcial de DEF y netlist
2026-11-01 Añade manifiesto de hashes y trazabilidad de layout
2026-11-01 Reduce desbordes menores y separa rutas de evidencia
2026-11-01 Evita desbordes en tabla de equivalencia histórica
2026-11-01 Hace publicación de artefactos tolerante a pushes concurrentes
2026-11-01 Registra resultados finales de compilación y pruebas
